flasch97/Mech-2220-Project-Gravity-Car/Gravity Car/FEA/PerformanceLog.txt

Number of Contacts: 0
Number of contact data: 0
