flasch97/Mech-2220-Project-Gravity-Car/Gravity Car/Drawing PDF files/Parts 1-50.pdf

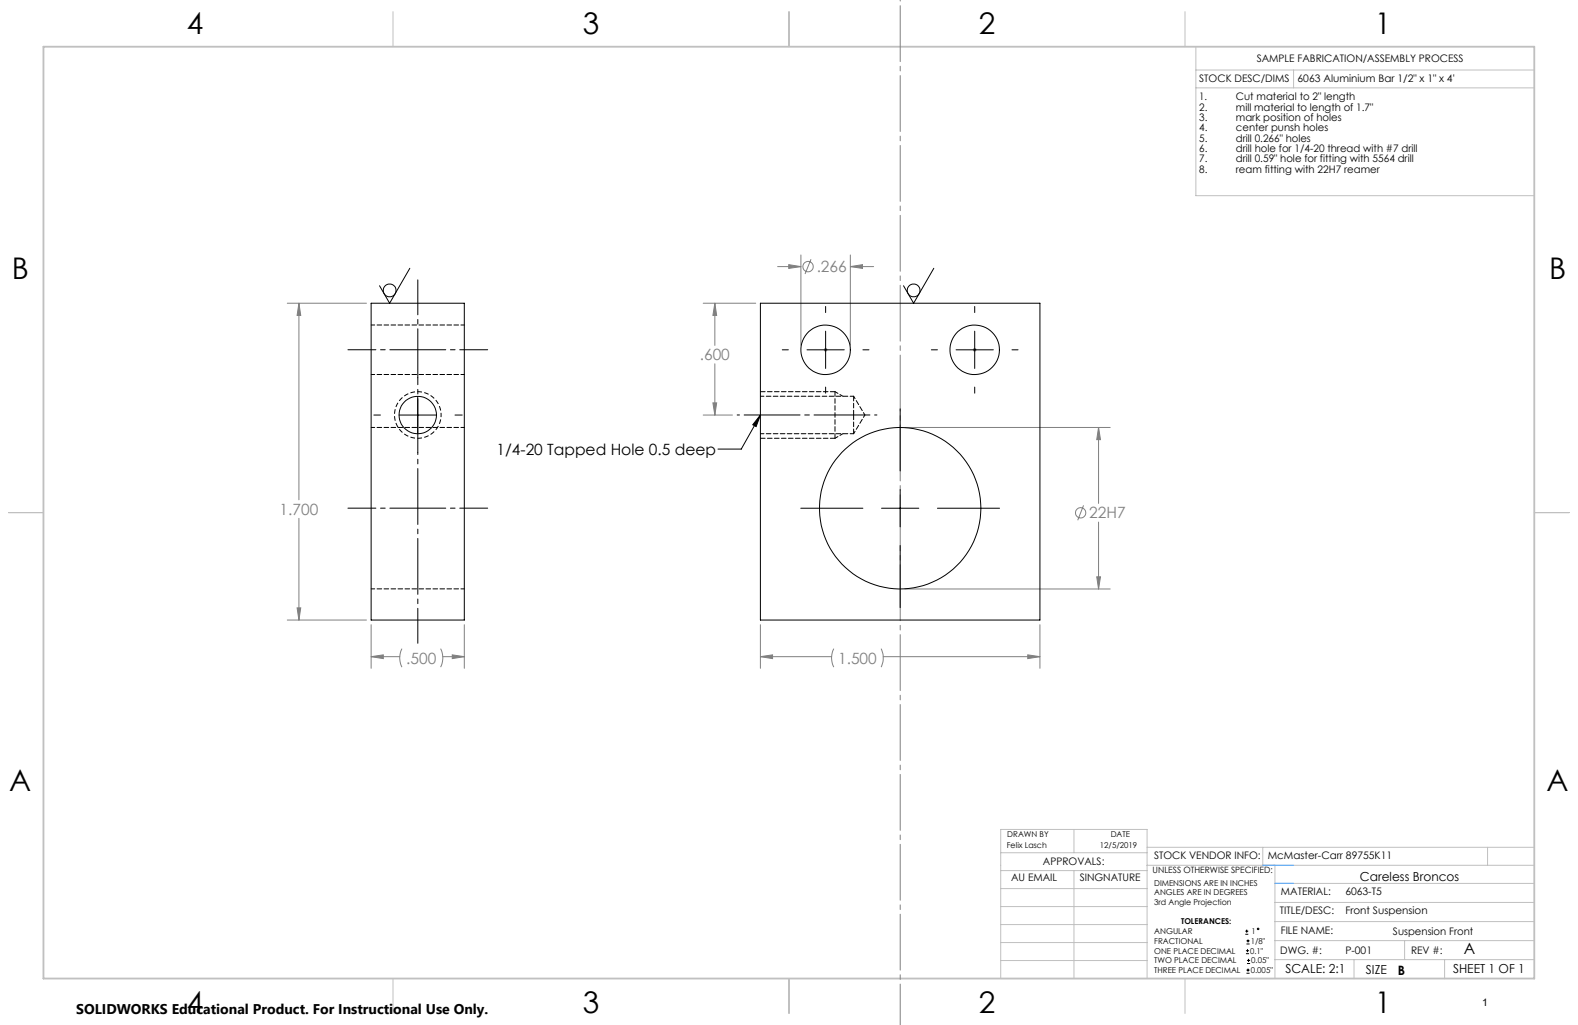
[picture p1: page 1]
Front Suspension; Felix Lasch; FILE NAME:; DRAWN BY; DATE; Suspension Front; AU EMAIL; SINGNATURE

SAMPLE FABRICATION/ASSEMBLY PROCESS

STOCK DESC/DIMS | 6063 Aluminium Bar 1/2" x 1" x 4'

1. Cut material to 2" length
2. mill material to length of 1.7"
3. mark position of holes
4. center punsh holes
5. drill 0.266" holes
6. drill hole for 1/4-20 thread with #7 drill
7. drill 0.59" hole for fitting with 5564 drill
8. ream fitting with 22H7 reamer

1/4-20 Tapped Hole 0.5 deep

STOCK VENDOR INFO: | McMaster-Carr 89755K11
UNLESS OTHERWISE SPECIFIED: ANGLES ARE IN DEGREES 3rd Angle Projection TOLERANCES: ANGULAR 1 FRACTIONAL 1/8" ONE PLACE DECIMAL 0.1" TWO PLACE DECIMAL 0.05" THREE PLACE DECIMAL 0.005" | | Careless Broncos

DIMENSIONS ARE IN INCHES

DWG. #: P-001 | REV #: A
SCALE: 2:1 | SIZE B | SHEET 1 OF 1

SOLIDWORKS Educational Product. For Instructional Use Only.

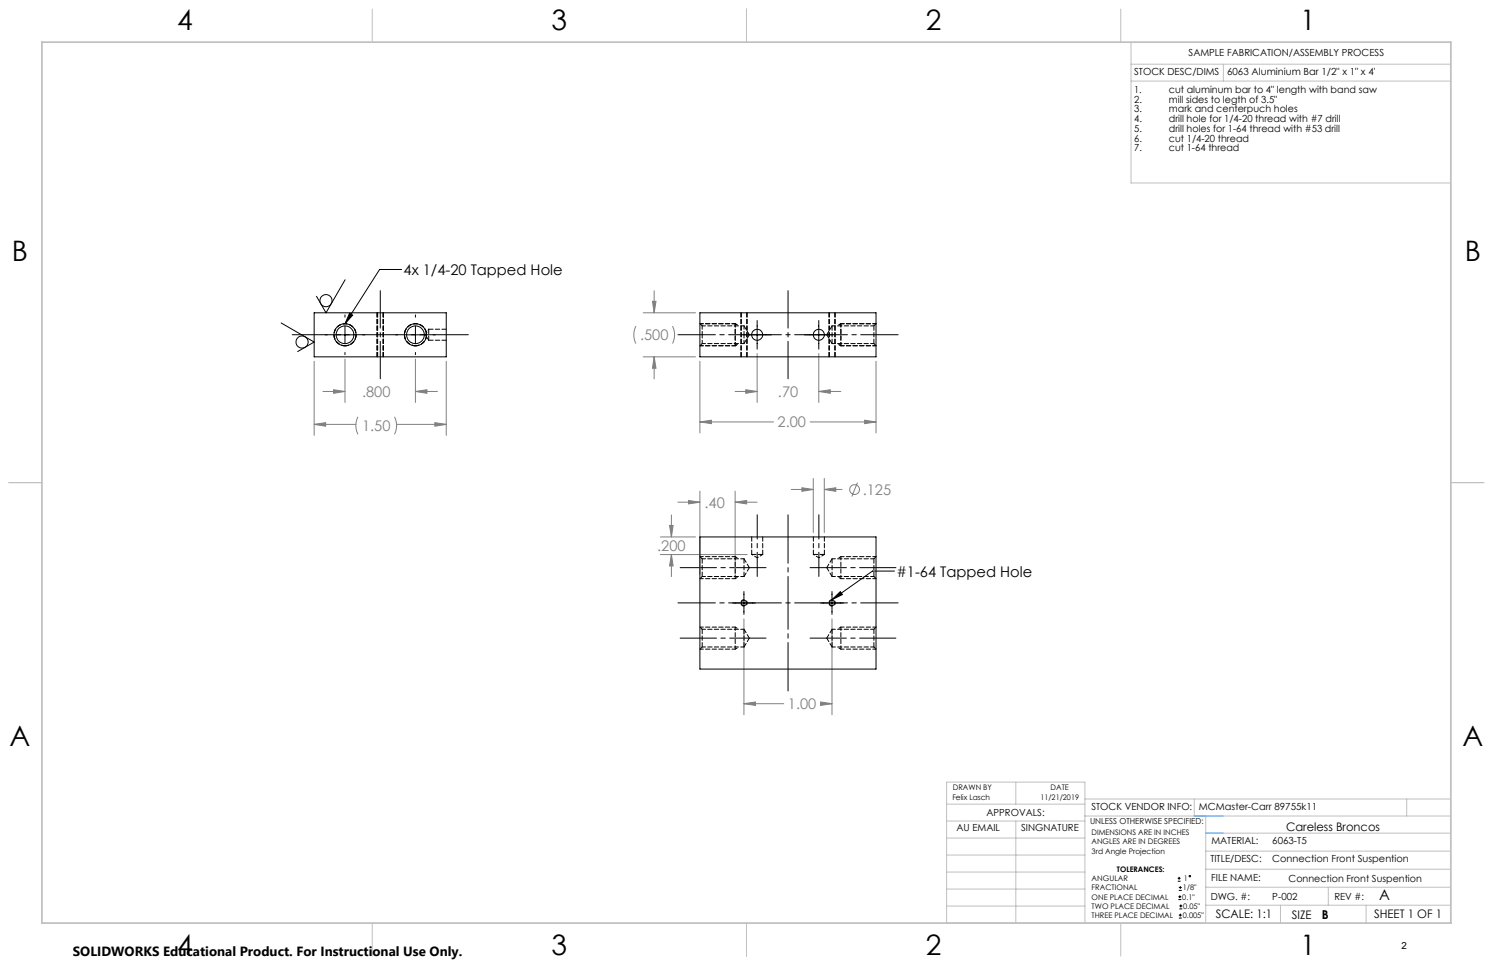
[picture p2: page 2]
4x 1/4-20 Tapped Hole; #1-64 Tapped Hole; 6063 Aluminium Bar 1/2" x 1" x 4'; Felix Lasch; FILE NAME:; DRAWN BY; DATE; AU EMAIL; SINGNATURE

1. cut aluminum bar to 4" length with band saw
2. mill sides to legth of 3.5"
3. mark and centerpuch holes
4. drill hole for 1/4-20 thread with #7 drill
5. drill holes for 1-64 thread with #53 drill
6. cut 1/4-20 thread
7. cut 1-64 thread

STOCK VENDOR INFO: | MCMaster-Carr 89755k11
UNLESS OTHERWISE SPECIFIED: ANGLES ARE IN DEGREES 3rd Angle Projection TOLERANCES: ANGULAR 1 | | Careless Broncos

DIMENSIONS ARE IN INCHES

Connection Front Suspention

REV #: A

SCALE: 1:1 | | SHEET 1 OF 1

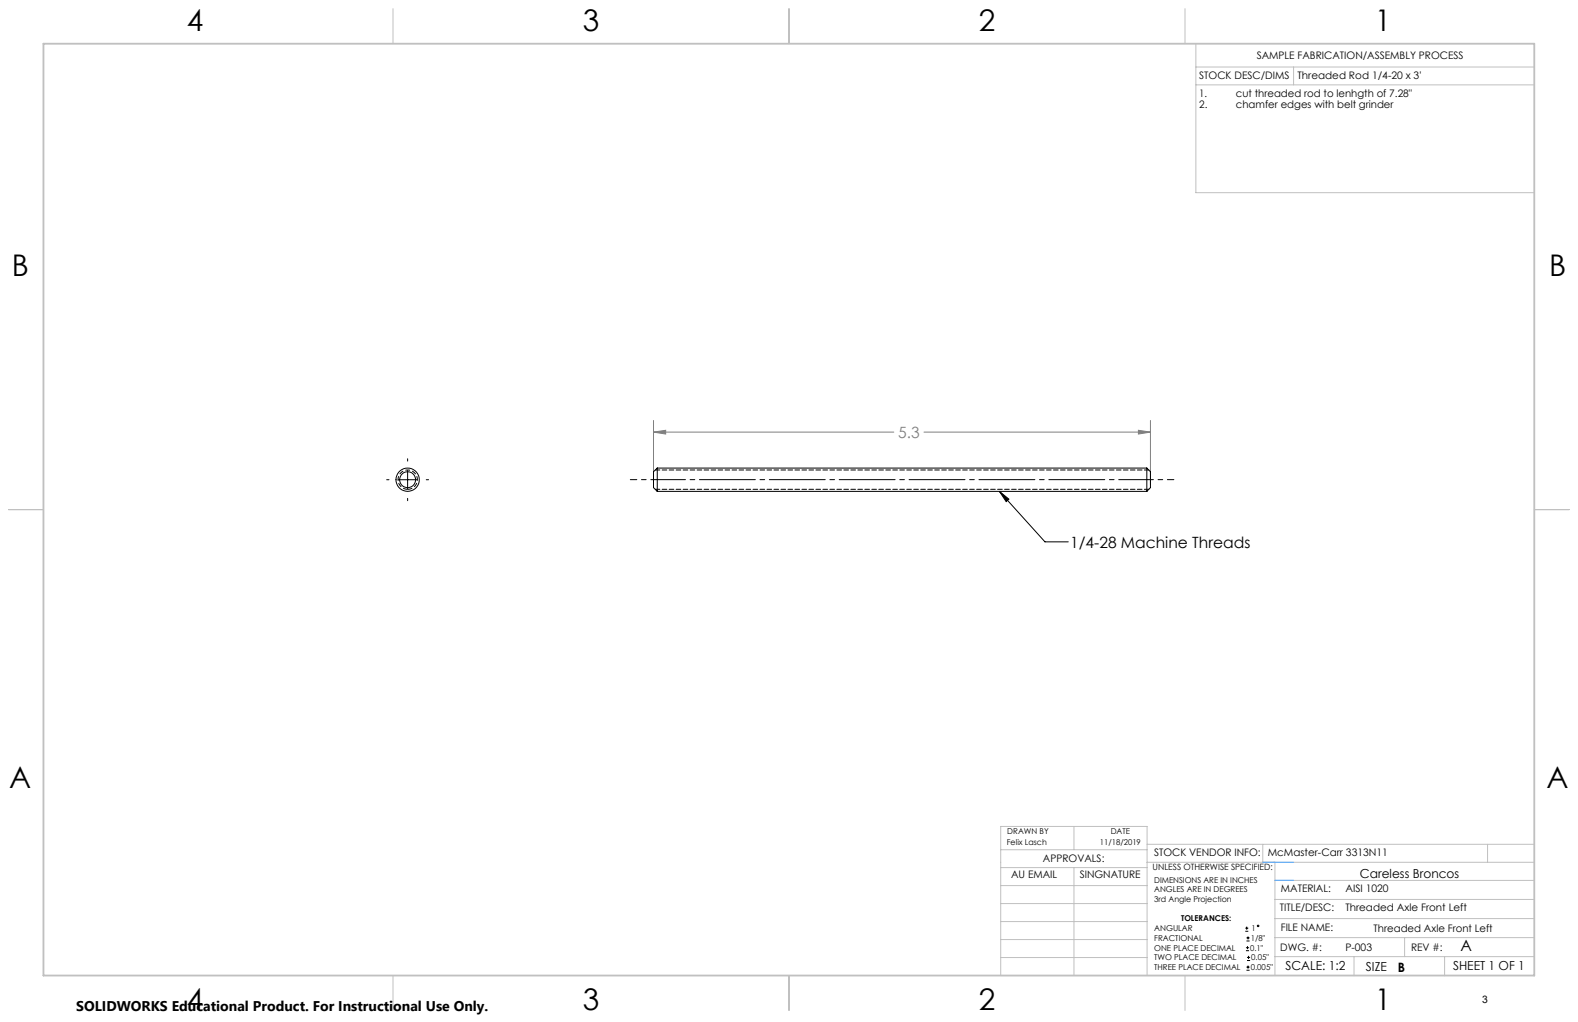
[picture p3: page 3]
1/4-28 Machine Threads; Threaded Rod 1/4-20 x 3'; Felix Lasch; FILE NAME:; DRAWN BY; DATE; AU EMAIL; SINGNATURE

1. cut threaded rod to lenhgth of 7.28"
2. chamfer edges with belt grinder

STOCK VENDOR INFO: | McMaster-Carr 3313N11
UNLESS OTHERWISE SPECIFIED: ANGLES ARE IN DEGREES 3rd Angle Projection TOLERANCES: ANGULAR 1 | | Careless Broncos

DIMENSIONS ARE IN INCHES

AISI 1020
Threaded Axle Front Left

REV #: A

SCALE: 1:2 | | SHEET 1 OF 1

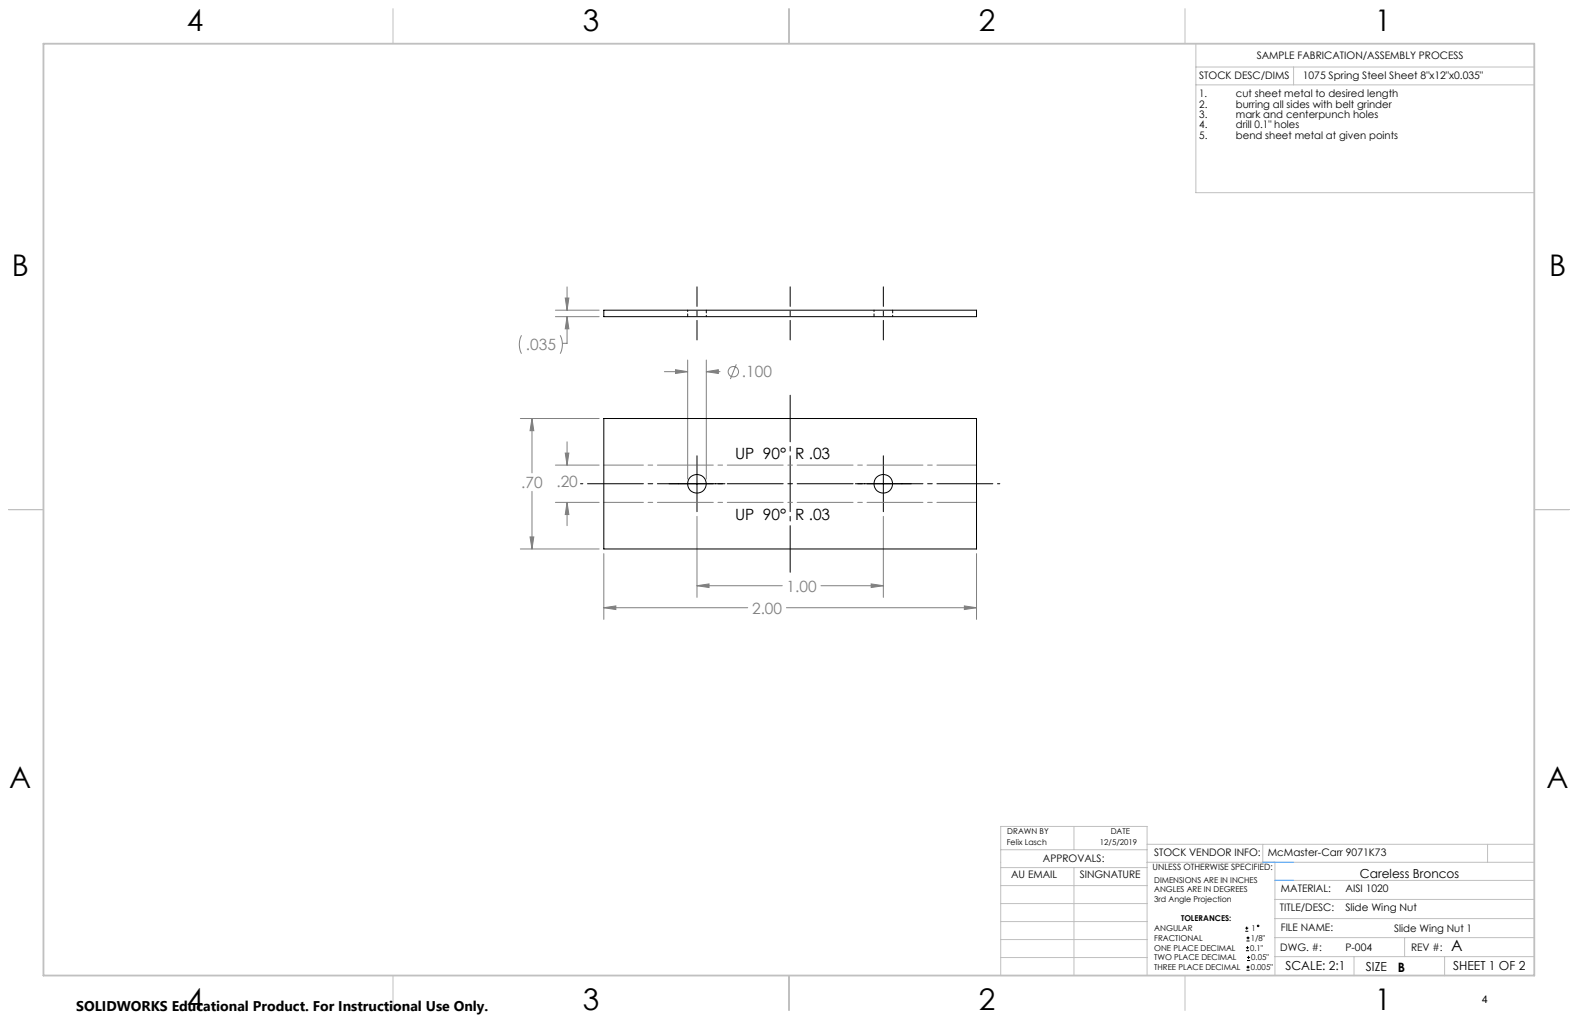
[picture p4: page 4]
Felix Lasch; FILE NAME:; DRAWN BY; DATE; AU EMAIL; SINGNATURE

1075 Spring Steel Sheet 8"x12"x0.035"

1. cut sheet metal to desired length
2. burring all sides with belt grinder
3. mark and centerpunch holes
4. drill 0.1" holes
5. bend sheet metal at given points

STOCK VENDOR INFO: | McMaster-Carr 9071K73
UNLESS OTHERWISE SPECIFIED: ANGLES ARE IN DEGREES 3rd Angle Projection TOLERANCES: ANGULAR 1 | | Careless Broncos

DIMENSIONS ARE IN INCHES

AISI 1020
Slide Wing Nut

Slide Wing Nut 1

REV #: A

SCALE: 2:1 | | SHEET 1 OF 2

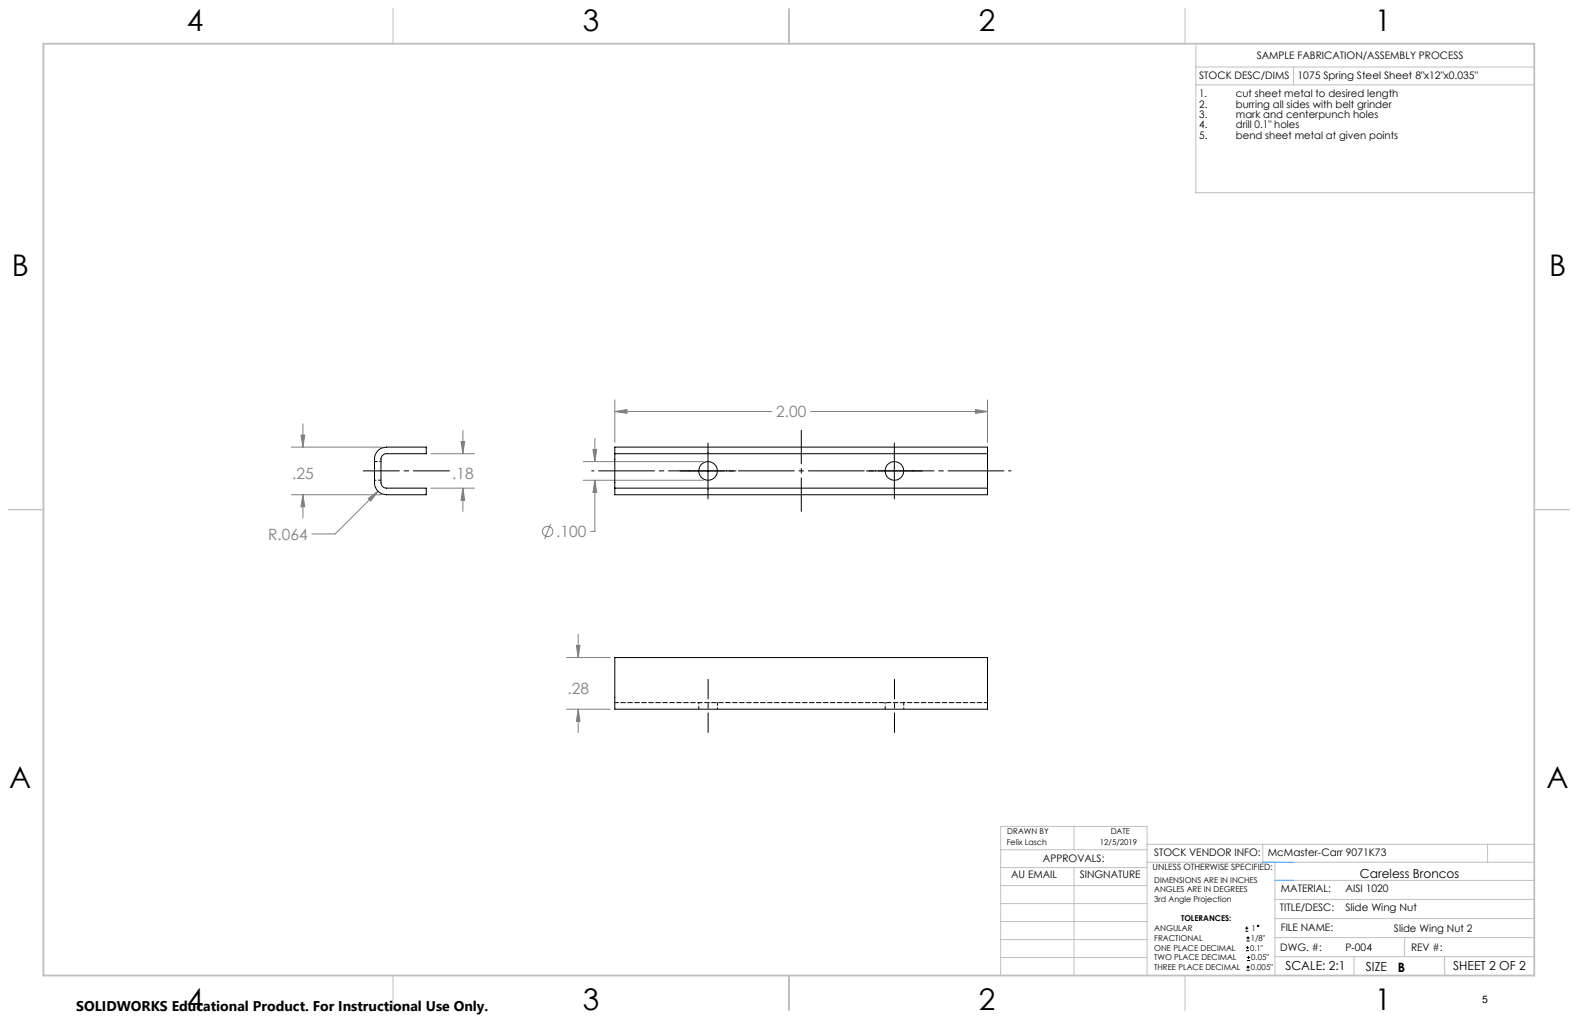
[picture p5: page 5]
Felix Lasch; FILE NAME:; DRAWN BY; DATE; AU EMAIL; SINGNATURE

1075 Spring Steel Sheet 8"x12"x0.035"

1. cut sheet metal to desired length
2. burring all sides with belt grinder
3. mark and centerpunch holes
4. drill 0.1" holes
5. bend sheet metal at given points

STOCK VENDOR INFO: | McMaster-Carr 9071K73
UNLESS OTHERWISE SPECIFIED: ANGLES ARE IN DEGREES 3rd Angle Projection TOLERANCES: ANGULAR 1 | | Careless Broncos

DIMENSIONS ARE IN INCHES

AISI 1020
Slide Wing Nut

Slide Wing Nut 2

REV #:

SCALE: 2:1 | | SHEET 2 OF 2

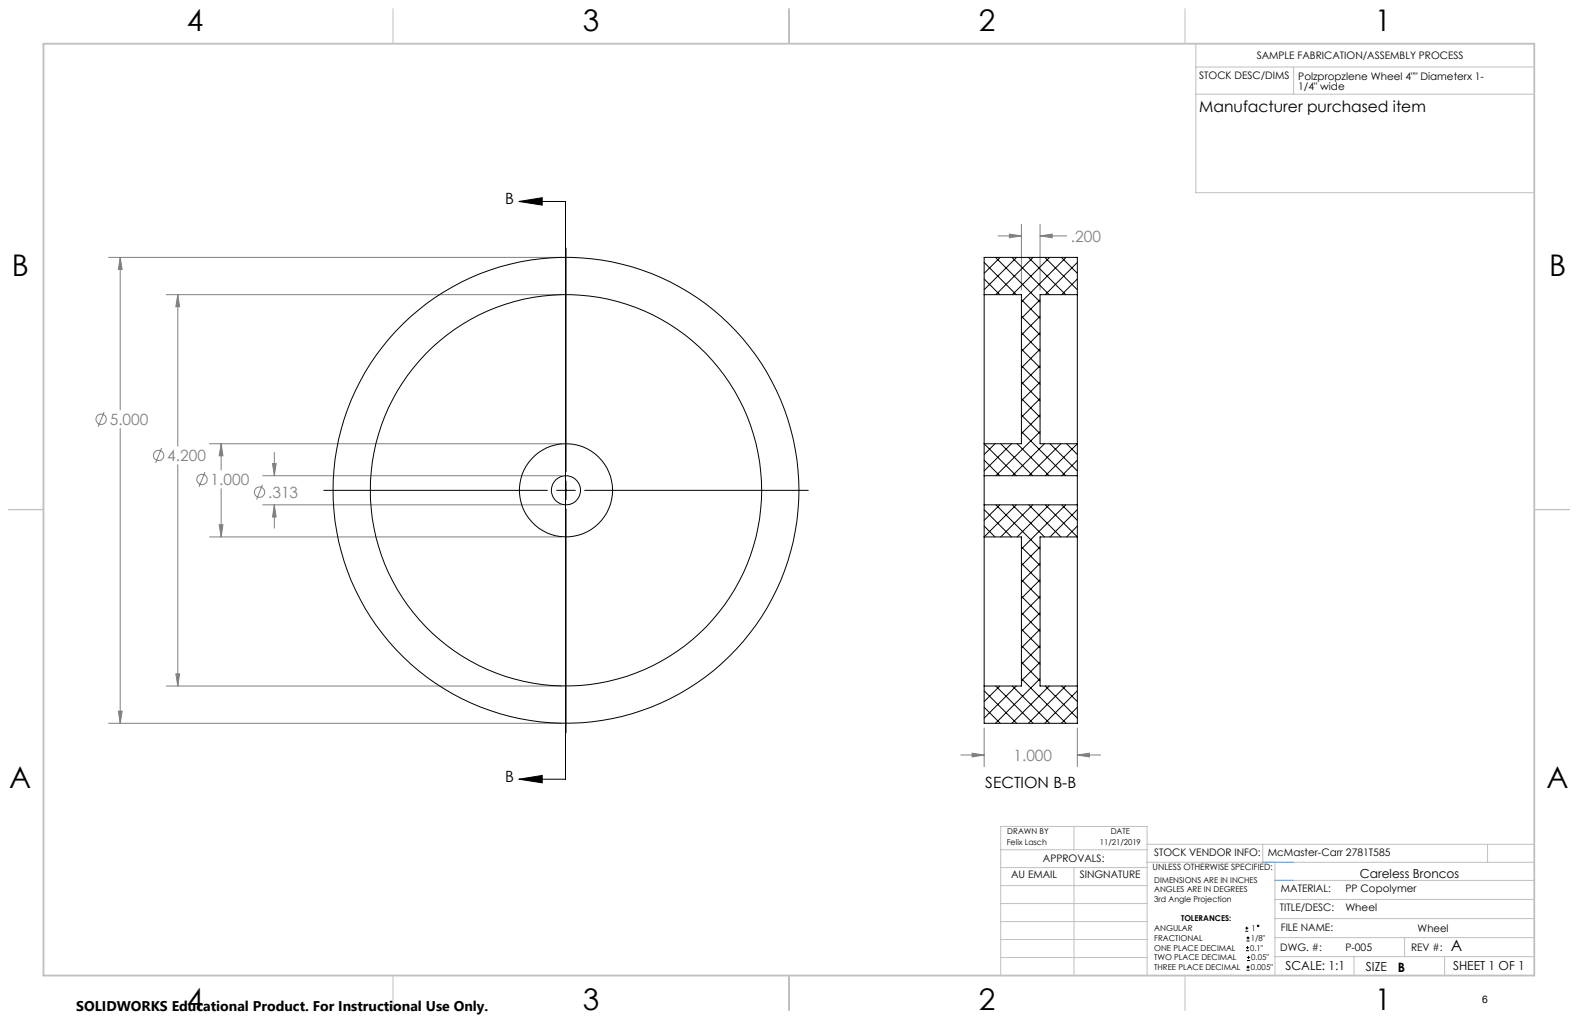
[picture p6: page 6]
SECTION B-B; PP Copolymer; Felix Lasch; FILE NAME:; DRAWN BY; DATE; AU EMAIL; SINGNATURE

Polzpropzlene Wheel 4"" Diameterx 1-
1/4" wide

Manufacturer purchased item

STOCK VENDOR INFO: | McMaster-Carr 2781T585
UNLESS OTHERWISE SPECIFIED: ANGLES ARE IN DEGREES 3rd Angle Projection TOLERANCES: ANGULAR 1 | | Careless Broncos

DIMENSIONS ARE IN INCHES

REV #: A

SCALE: 1:1 | | SHEET 1 OF 1

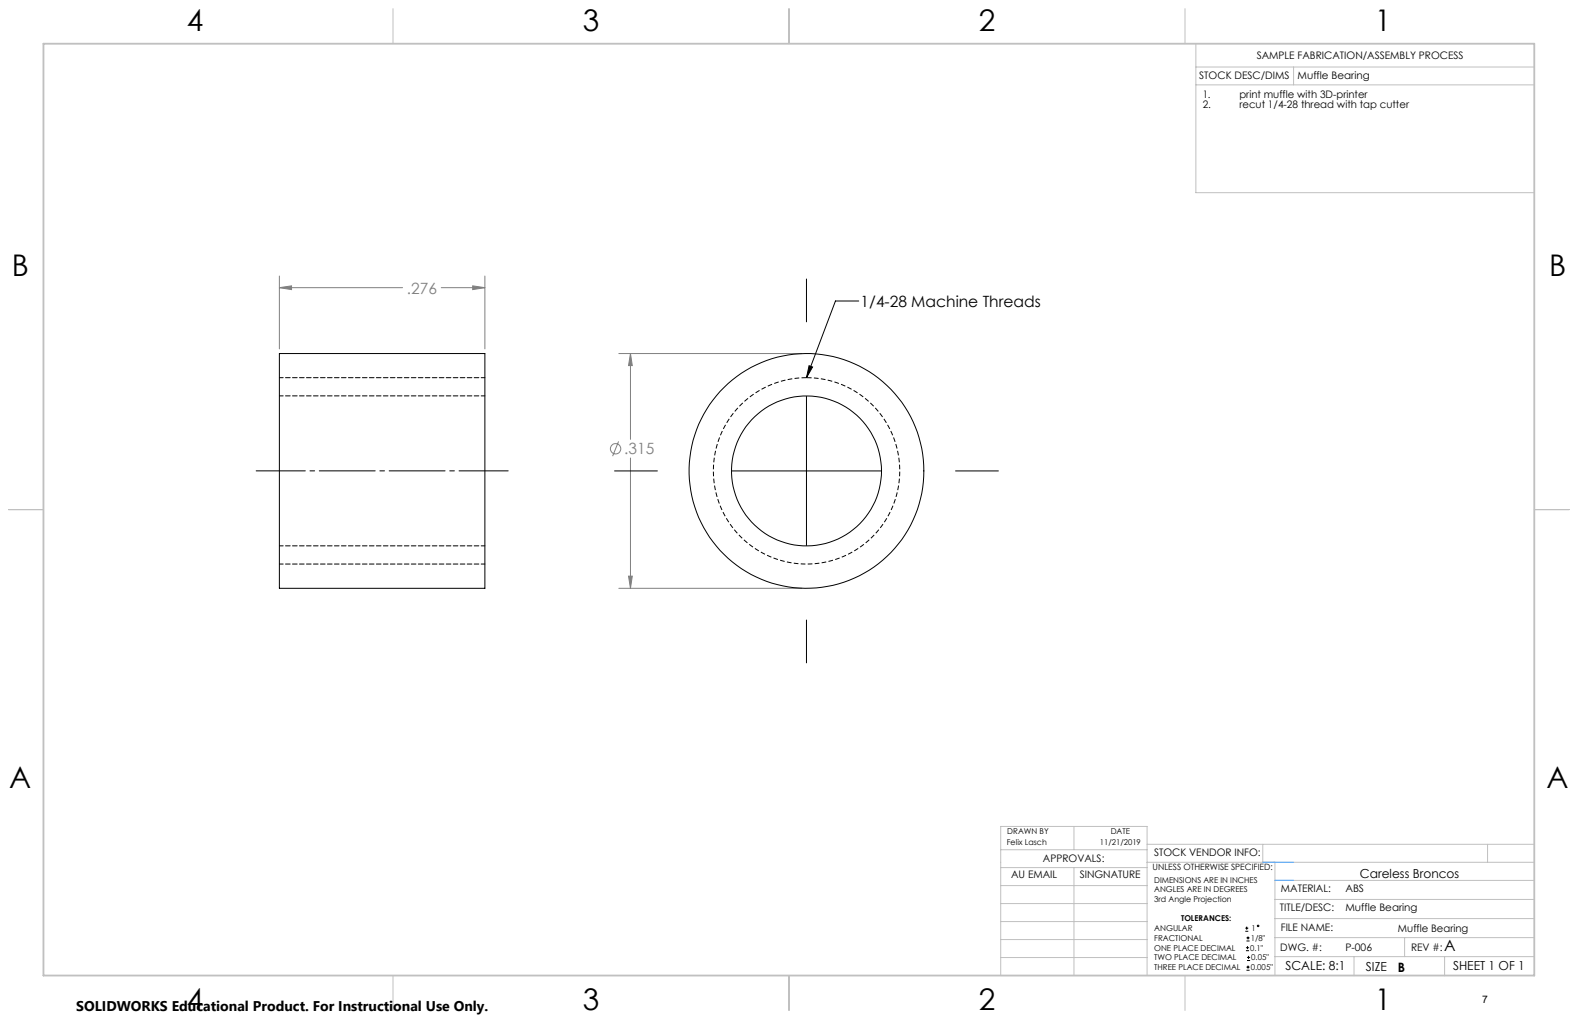
[picture p7: page 7]
1/4-28 Machine Threads; Muffle Bearing; Felix Lasch; FILE NAME:; DRAWN BY; DATE; AU EMAIL; SINGNATURE

1. print muffle with 3D-printer
2. recut 1/4-28 thread with tap cutter

STOCK VENDOR INFO:
UNLESS OTHERWISE SPECIFIED: ANGLES ARE IN DEGREES 3rd Angle Projection TOLERANCES: ANGULAR 1 | Careless Broncos

DIMENSIONS ARE IN INCHES

REV #:A

SCALE: 8:1 | | SHEET 1 OF 1

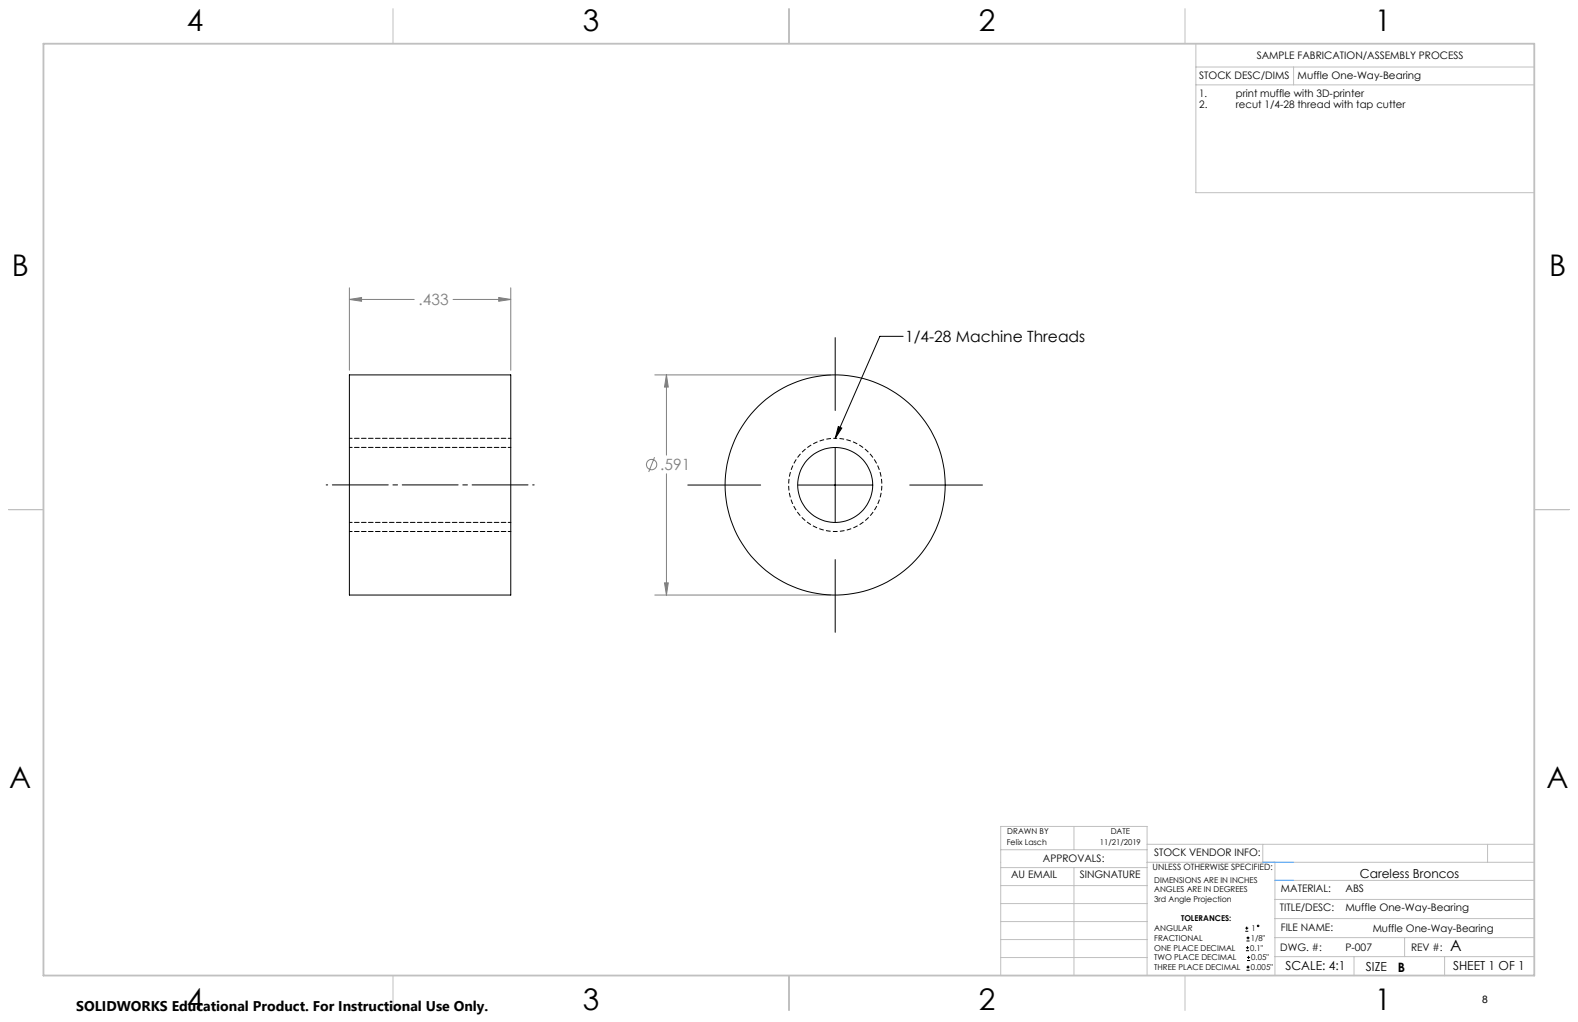
[picture p8: page 8]
1/4-28 Machine Threads; Felix Lasch; FILE NAME:; DRAWN BY; DATE; AU EMAIL; SINGNATURE

Muffle One-Way-Bearing

1. print muffle with 3D-printer
2. recut 1/4-28 thread with tap cutter

STOCK VENDOR INFO:
UNLESS OTHERWISE SPECIFIED: ANGLES ARE IN DEGREES 3rd Angle Projection TOLERANCES: ANGULAR 1 | Careless Broncos

DIMENSIONS ARE IN INCHES

ABS

REV #: A

SCALE: 4:1 | | SHEET 1 OF 1

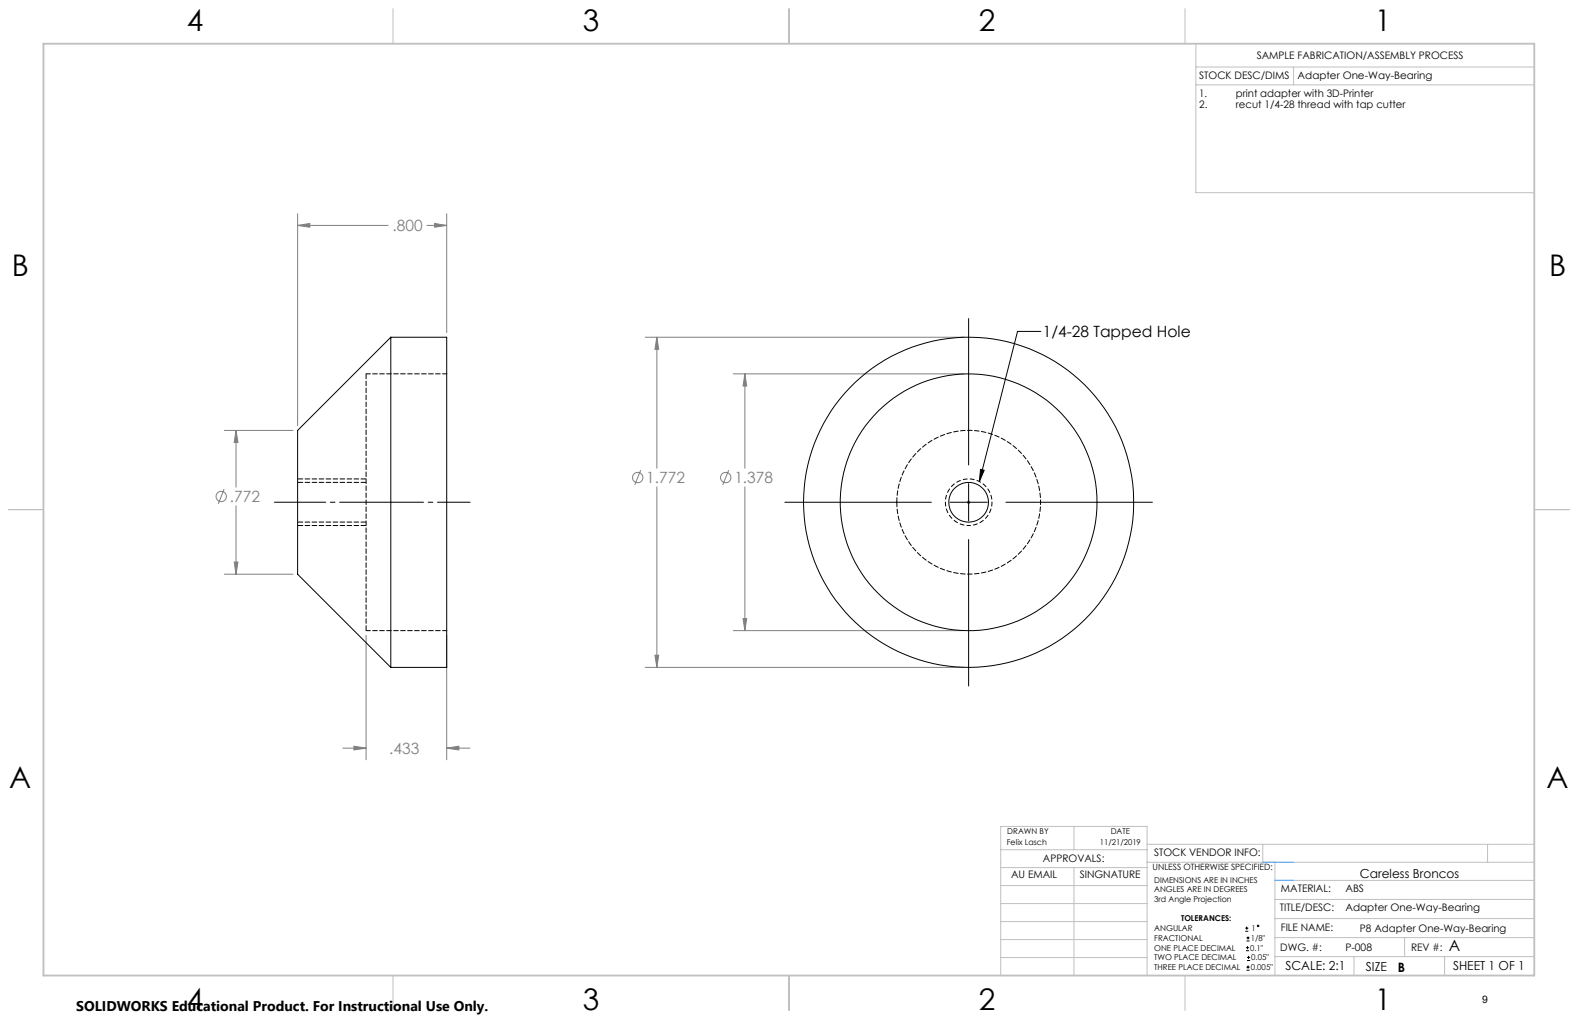
[picture p9: page 9]
1/4-28 Tapped Hole; Felix Lasch; FILE NAME:; DRAWN BY; DATE; AU EMAIL; SINGNATURE

Adapter One-Way-Bearing

1. print adapter with 3D-Printer
2. recut 1/4-28 thread with tap cutter

STOCK VENDOR INFO:
UNLESS OTHERWISE SPECIFIED: ANGLES ARE IN DEGREES 3rd Angle Projection TOLERANCES: ANGULAR 1 | Careless Broncos

DIMENSIONS ARE IN INCHES

ABS
P8 Adapter One-Way-Bearing

REV #: A

SCALE: 2:1 | | SHEET 1 OF 1

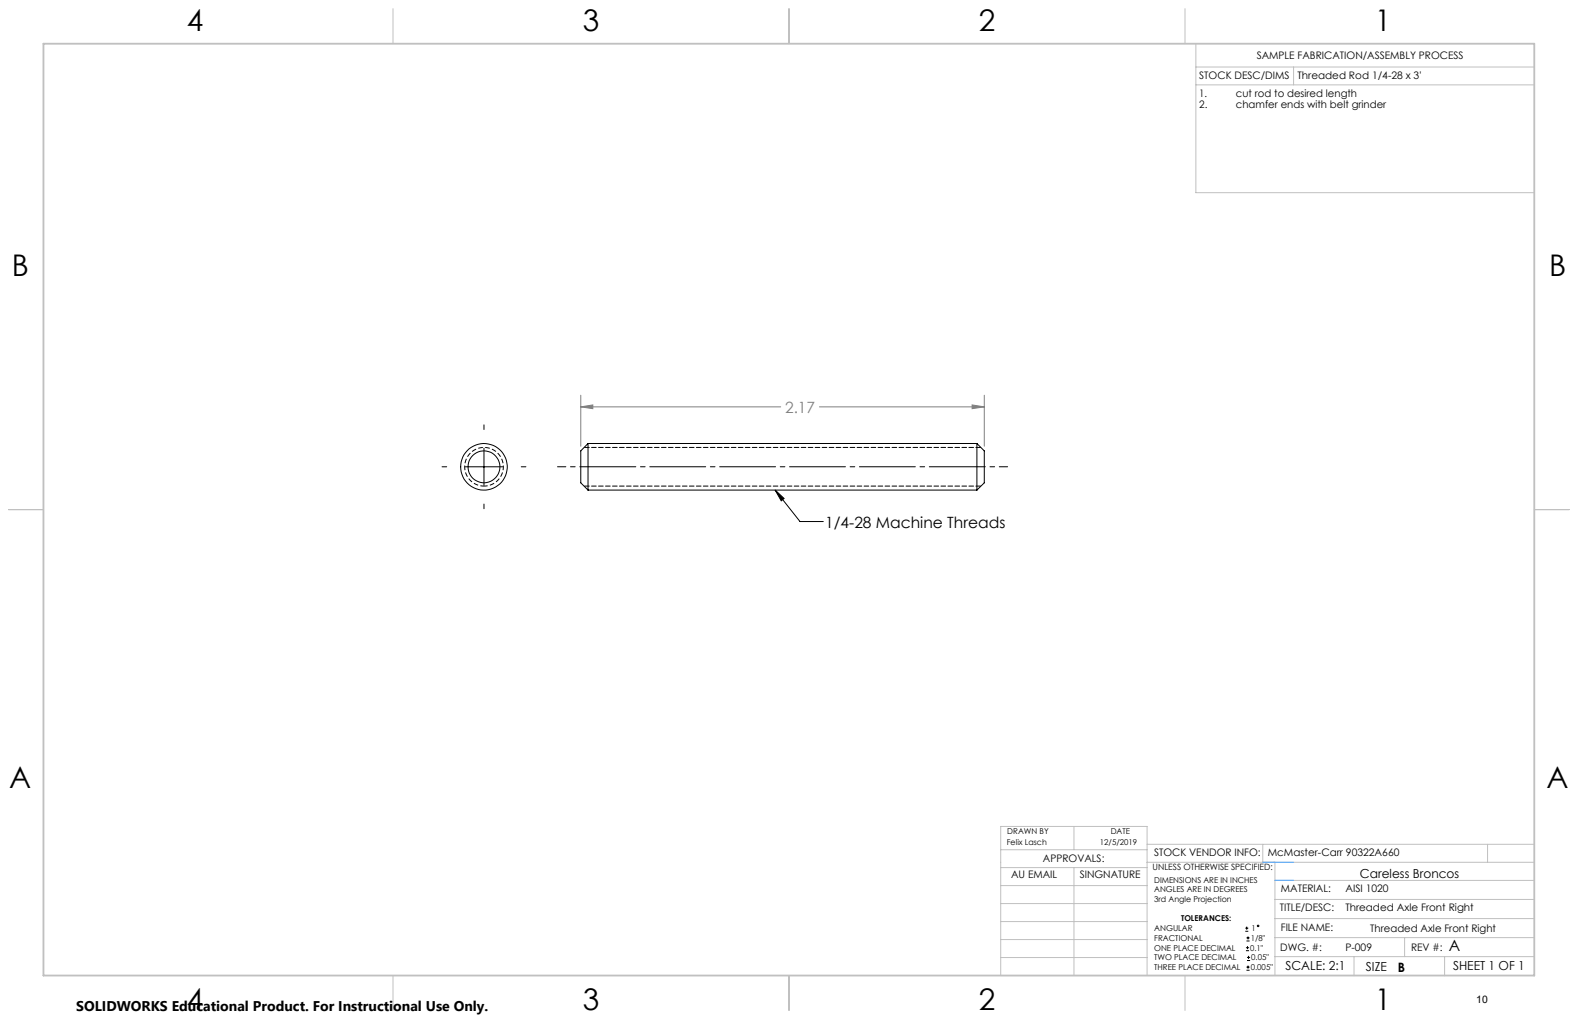
[picture p10: page 10]
1/4-28 Machine Threads; Threaded Rod 1/4-28 x 3'; Felix Lasch; FILE NAME:; DRAWN BY; DATE; AU EMAIL; SINGNATURE

1. cut rod to desired length
2. chamfer ends with belt grinder

STOCK VENDOR INFO: | McMaster-Carr 90322A660
UNLESS OTHERWISE SPECIFIED: ANGLES ARE IN DEGREES 3rd Angle Projection TOLERANCES: ANGULAR 1 | | Careless Broncos

DIMENSIONS ARE IN INCHES

AISI 1020
Threaded Axle Front Right

REV #: A

SCALE: 2:1 | | SHEET 1 OF 1

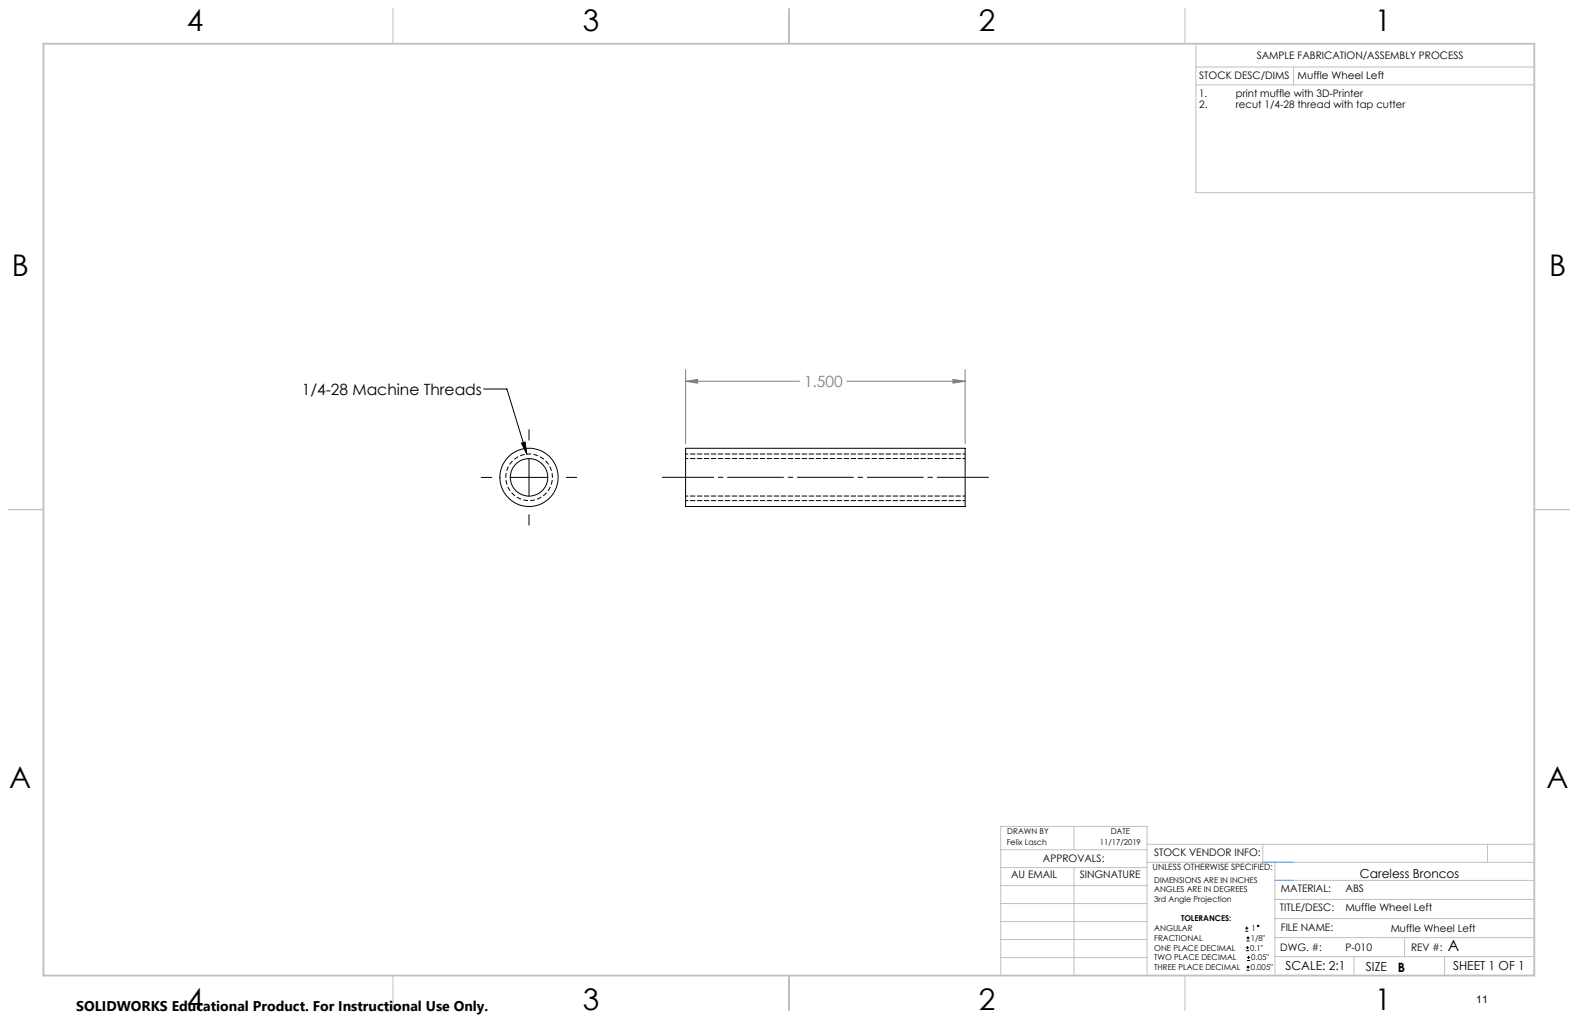
[picture p11: page 11]
1.500 1/4-28 Machine Threads; Felix Lasch; FILE NAME:; DRAWN BY; DATE; AU EMAIL; SINGNATURE

Muffle Wheel Left

1. print muffle with 3D-Printer
2. recut 1/4-28 thread with tap cutter

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

DIMENSIONS ARE IN INCHES

ABS

REV #: A

SCALE: 2:1 | | SHEET 1 OF 1

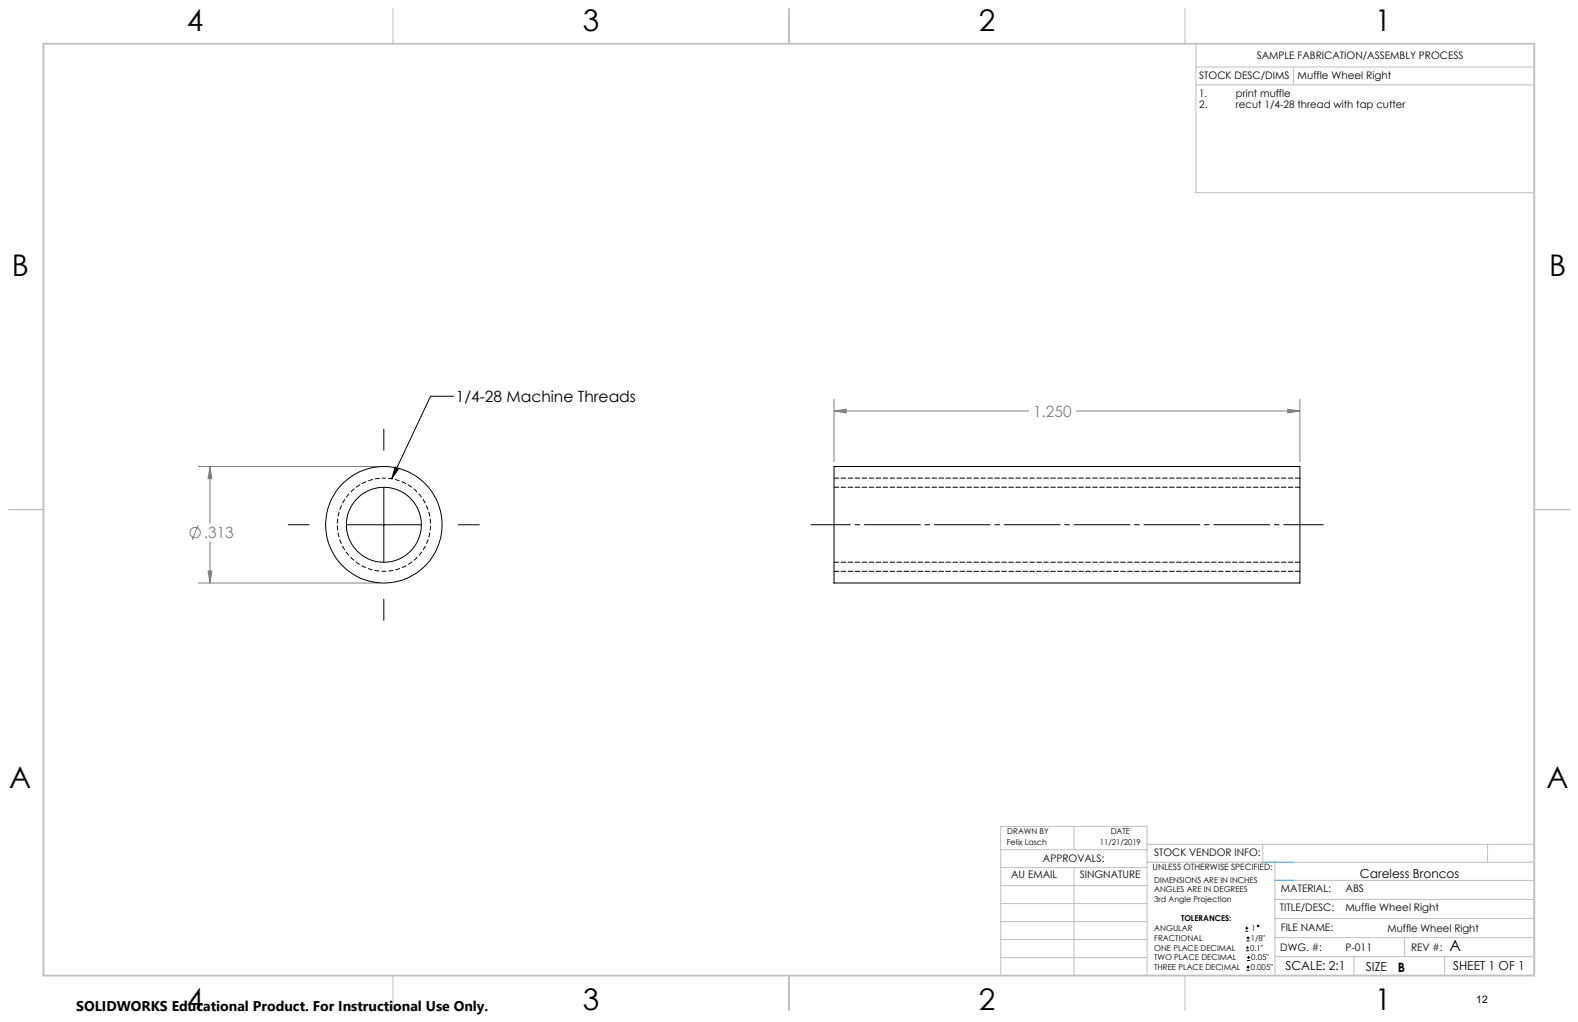
[picture p12: page 12]
1/4-28 Machine Threads; Felix Lasch; FILE NAME:; DRAWN BY; DATE; AU EMAIL; SINGNATURE

Muffle Wheel Right

1. print muffle
2. recut 1/4-28 thread with tap cutter

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

DIMENSIONS ARE IN INCHES

ABS

REV #: A

SCALE: 2:1 | | SHEET 1 OF 1

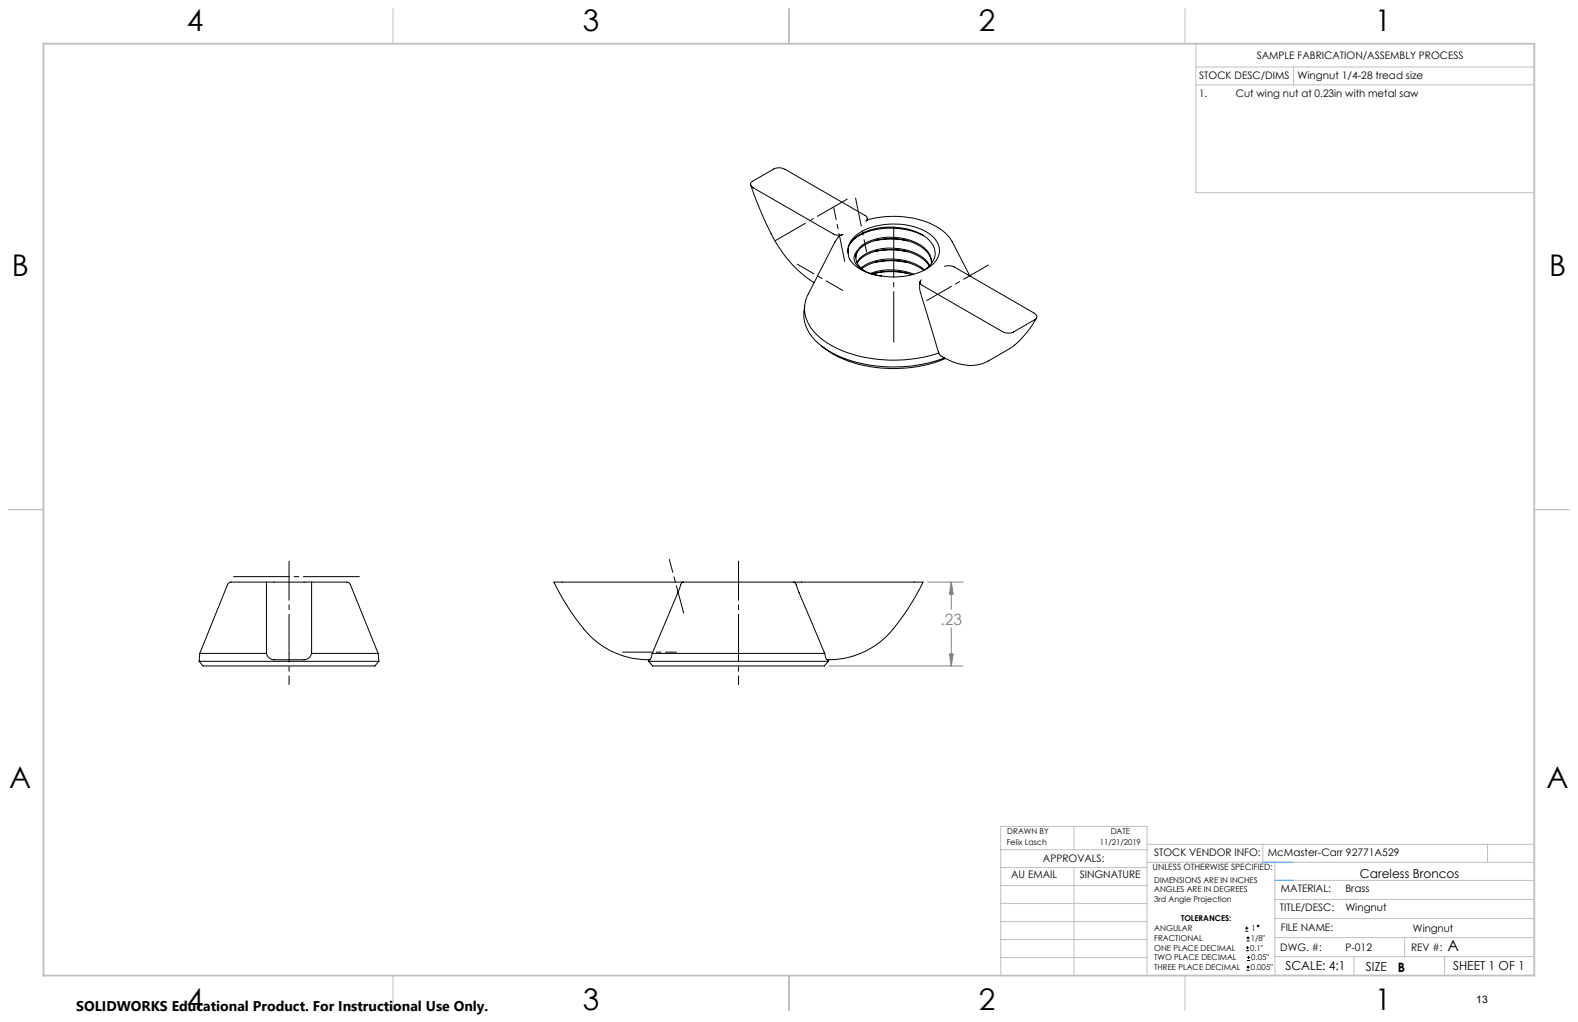
[picture p13: page 13]
Felix Lasch; FILE NAME:; DRAWN BY; DATE; AU EMAIL; SINGNATURE

Wingnut 1/4-28 tread size

1. Cut wing nut at 0.23in with metal saw

STOCK VENDOR INFO: | McMaster-Carr 92771A529
UNLESS OTHERWISE SPECIFIED: ANGLES ARE IN DEGREES 3rd Angle Projection TOLERANCES: ANGULAR 1 | | Careless Broncos

DIMENSIONS ARE IN INCHES

REV #: A

SCALE: 4:1 | | SHEET 1 OF 1

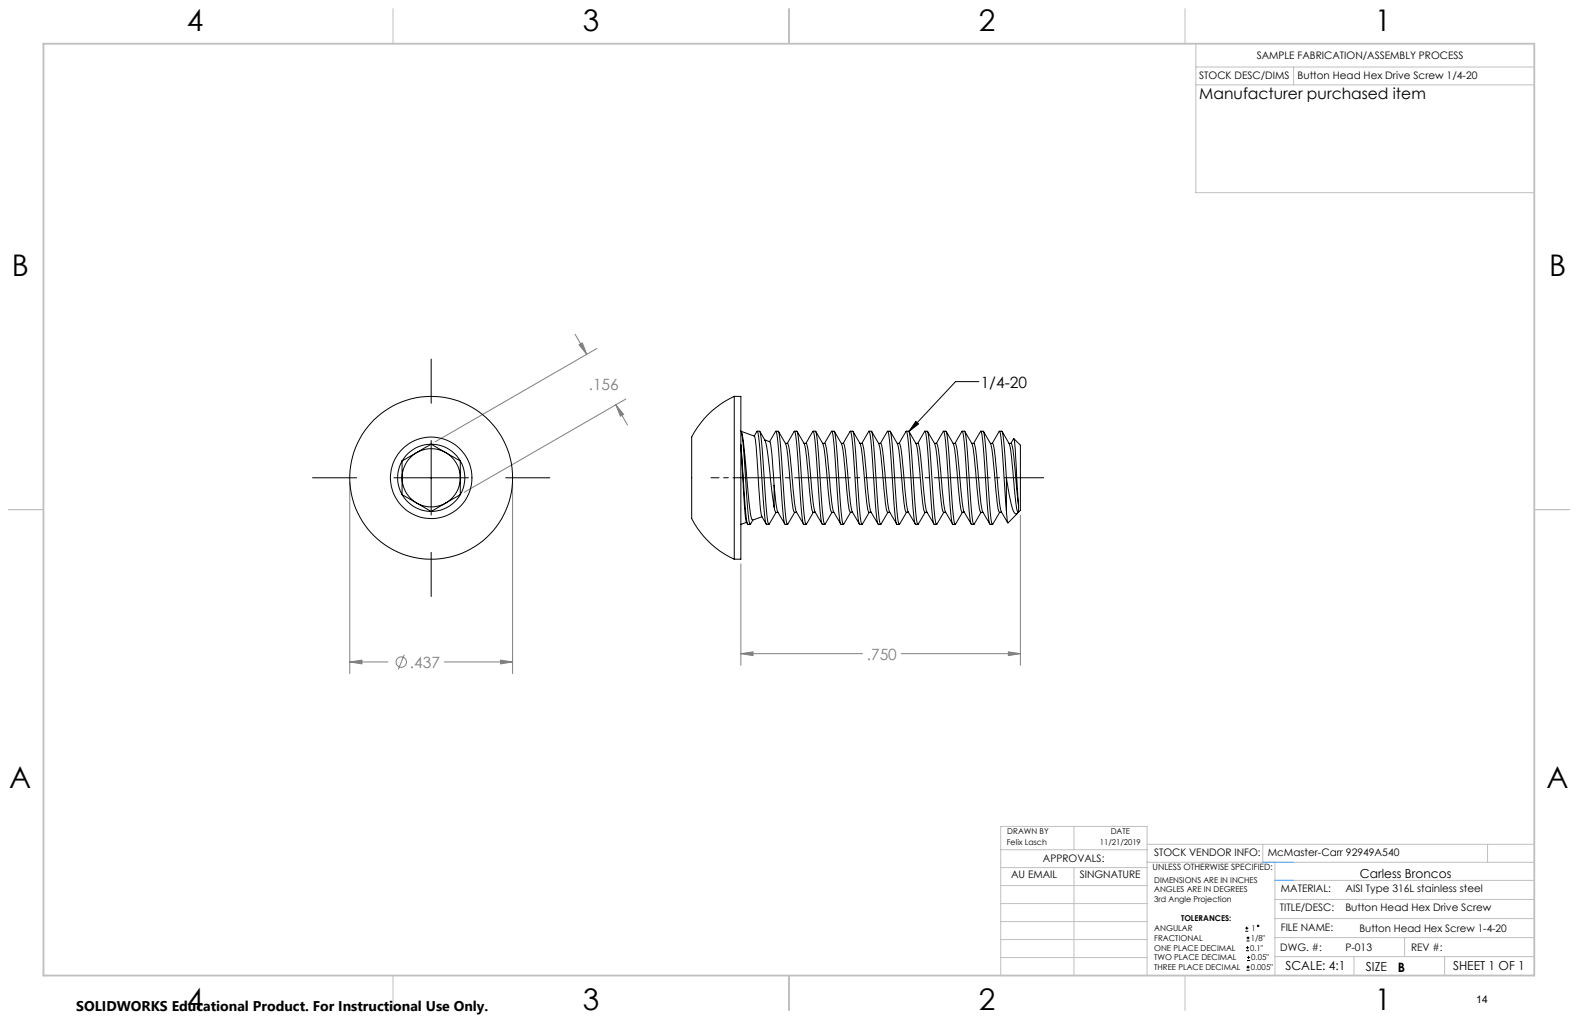
[picture p14: page 14]
Felix Lasch; FILE NAME:; DRAWN BY; DATE; SCALE: 4:1; SHEET 1 OF 1; AU EMAIL; SINGNATURE

Button Head Hex Drive Screw 1/4-20

Manufacturer purchased item

STOCK VENDOR INFO: | McMaster-Carr 92949A540
UNLESS OTHERWISE SPECIFIED: ANGLES ARE IN DEGREES 3rd Angle Projection TOLERANCES: ANGULAR 1 | | Carless Broncos

DIMENSIONS ARE IN INCHES

AISI Type 316L stainless steel
Button Head Hex Drive Screw
Button Head Hex Screw 1-4-20

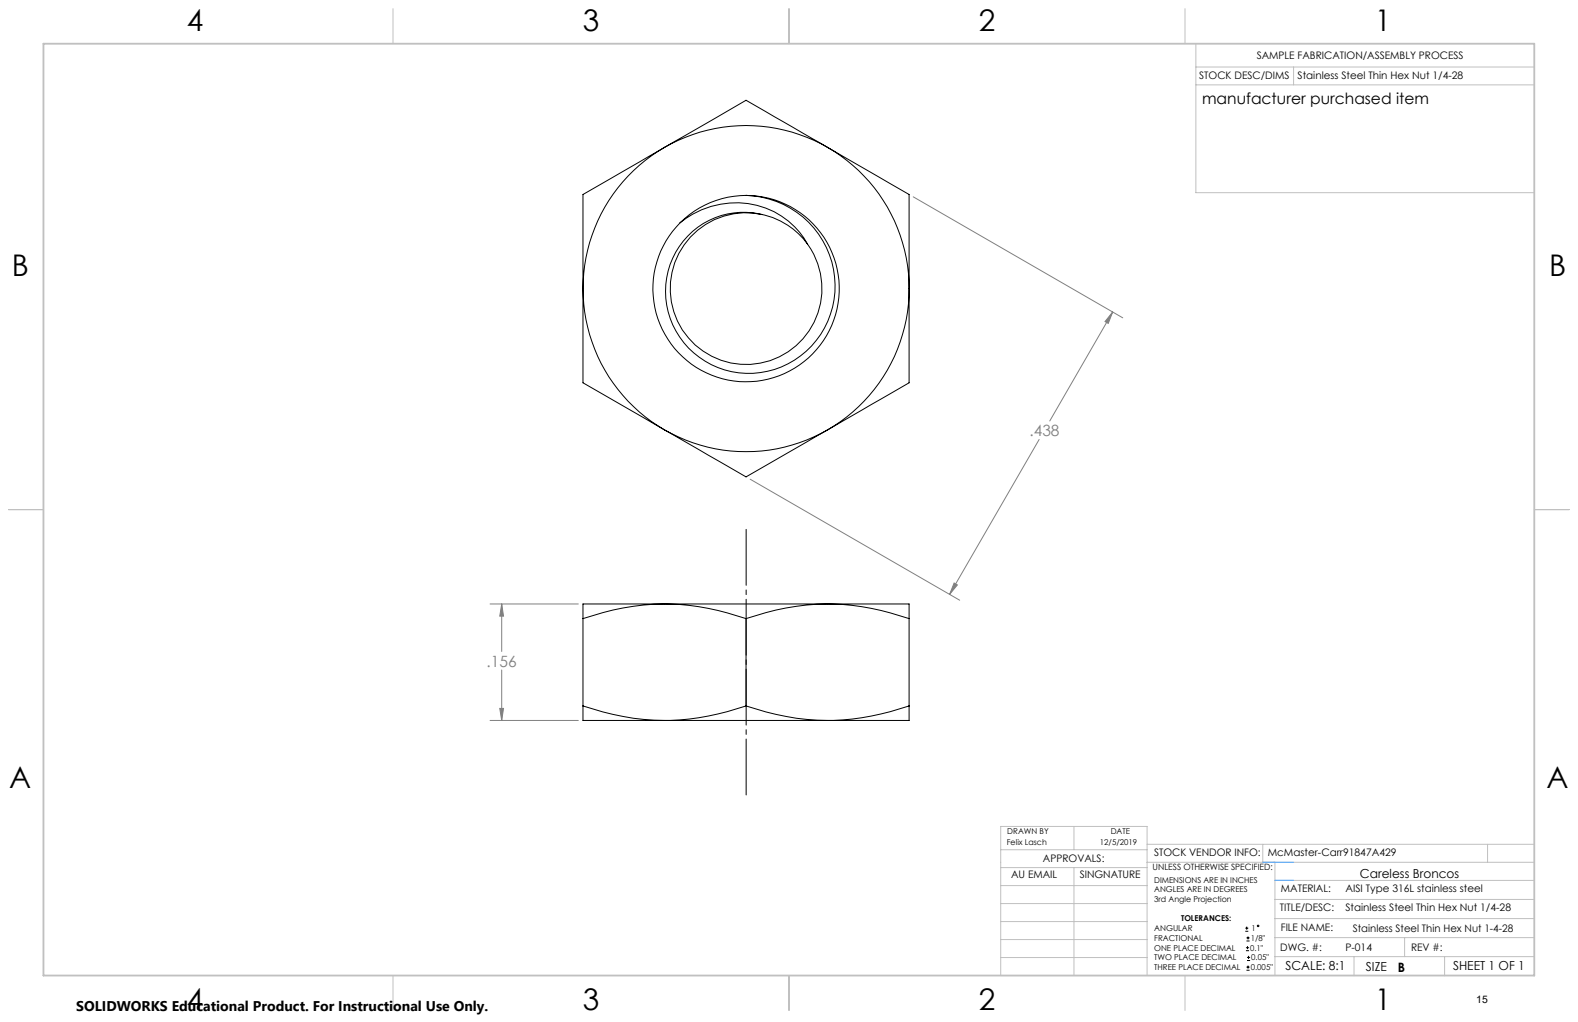
[picture p15: page 15]
Felix Lasch; FILE NAME:; DRAWN BY; DATE; SCALE: 8:1; SHEET 1 OF 1; AU EMAIL; SINGNATURE

Stainless Steel Thin Hex Nut 1/4-28

manufacturer purchased item

STOCK VENDOR INFO: | McMaster-Carr91847A429
UNLESS OTHERWISE SPECIFIED: ANGLES ARE IN DEGREES 3rd Angle Projection TOLERANCES: ANGULAR 1 | | Careless Broncos

DIMENSIONS ARE IN INCHES

AISI Type 316L stainless steel
Stainless Steel Thin Hex Nut 1-4-28

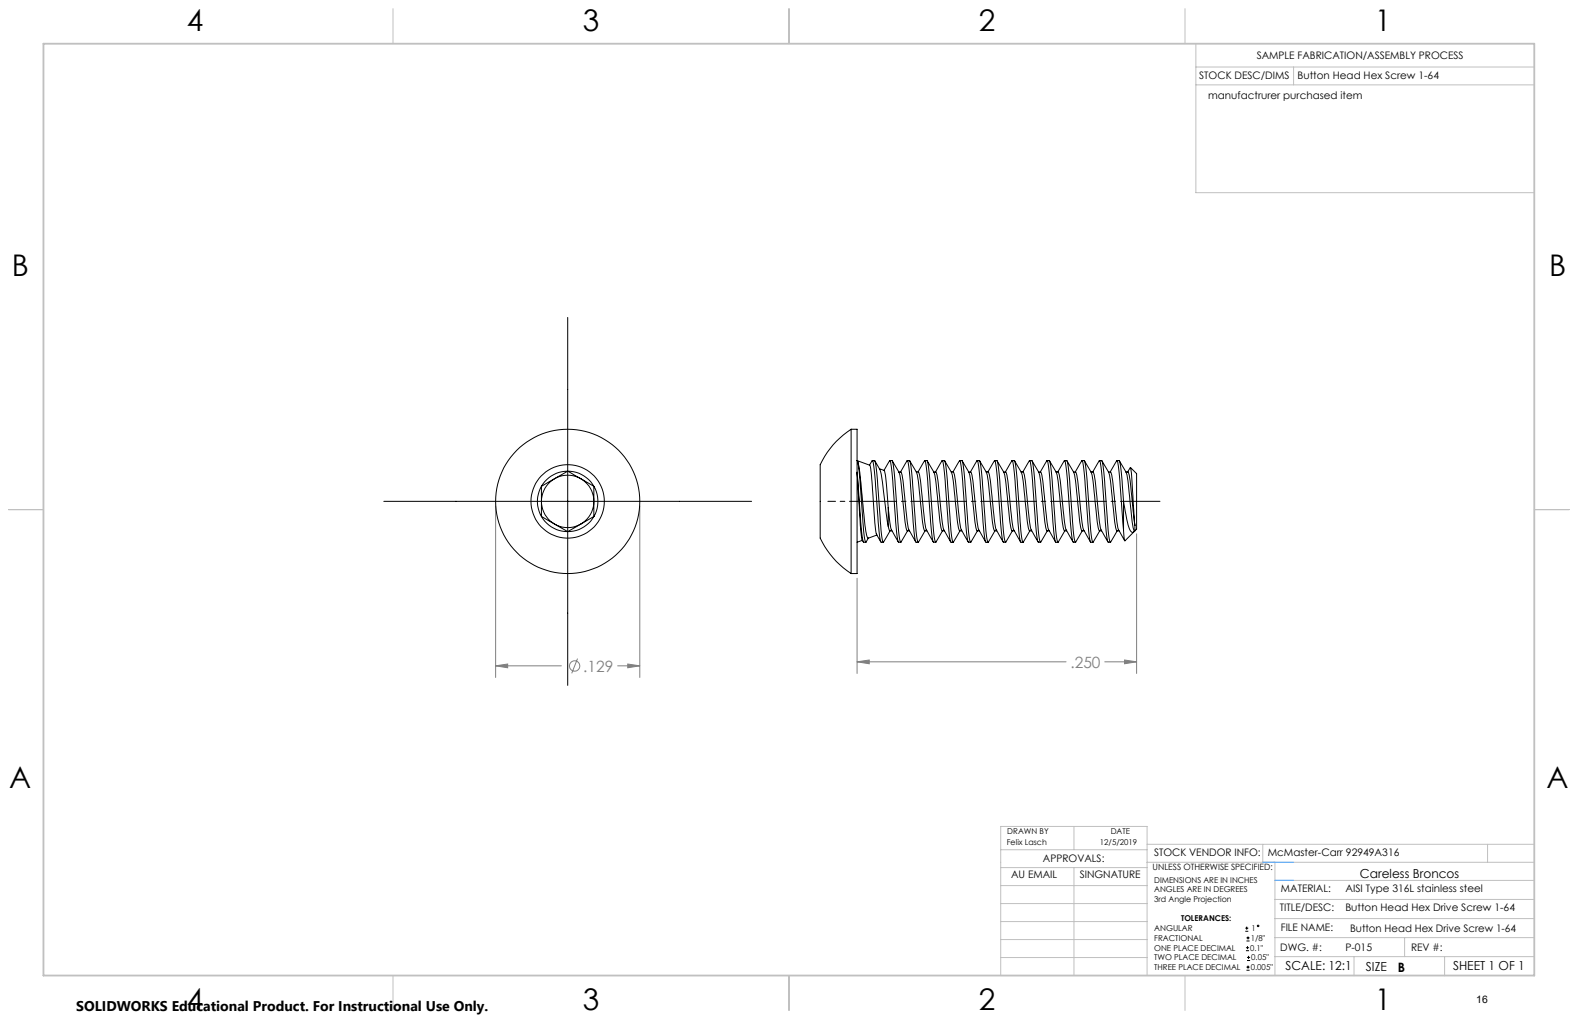
[picture p16: page 16]
Felix Lasch; FILE NAME:; DRAWN BY; DATE; SCALE: 12:1; SHEET 1 OF 1; AU EMAIL; SINGNATURE

Button Head Hex Screw 1-64

manufactrurer purchased item

STOCK VENDOR INFO: | McMaster-Carr 92949A316
UNLESS OTHERWISE SPECIFIED: ANGLES ARE IN DEGREES 3rd Angle Projection TOLERANCES: ANGULAR 1 | | Careless Broncos

DIMENSIONS ARE IN INCHES

AISI Type 316L stainless steel
Button Head Hex Drive Screw 1-64

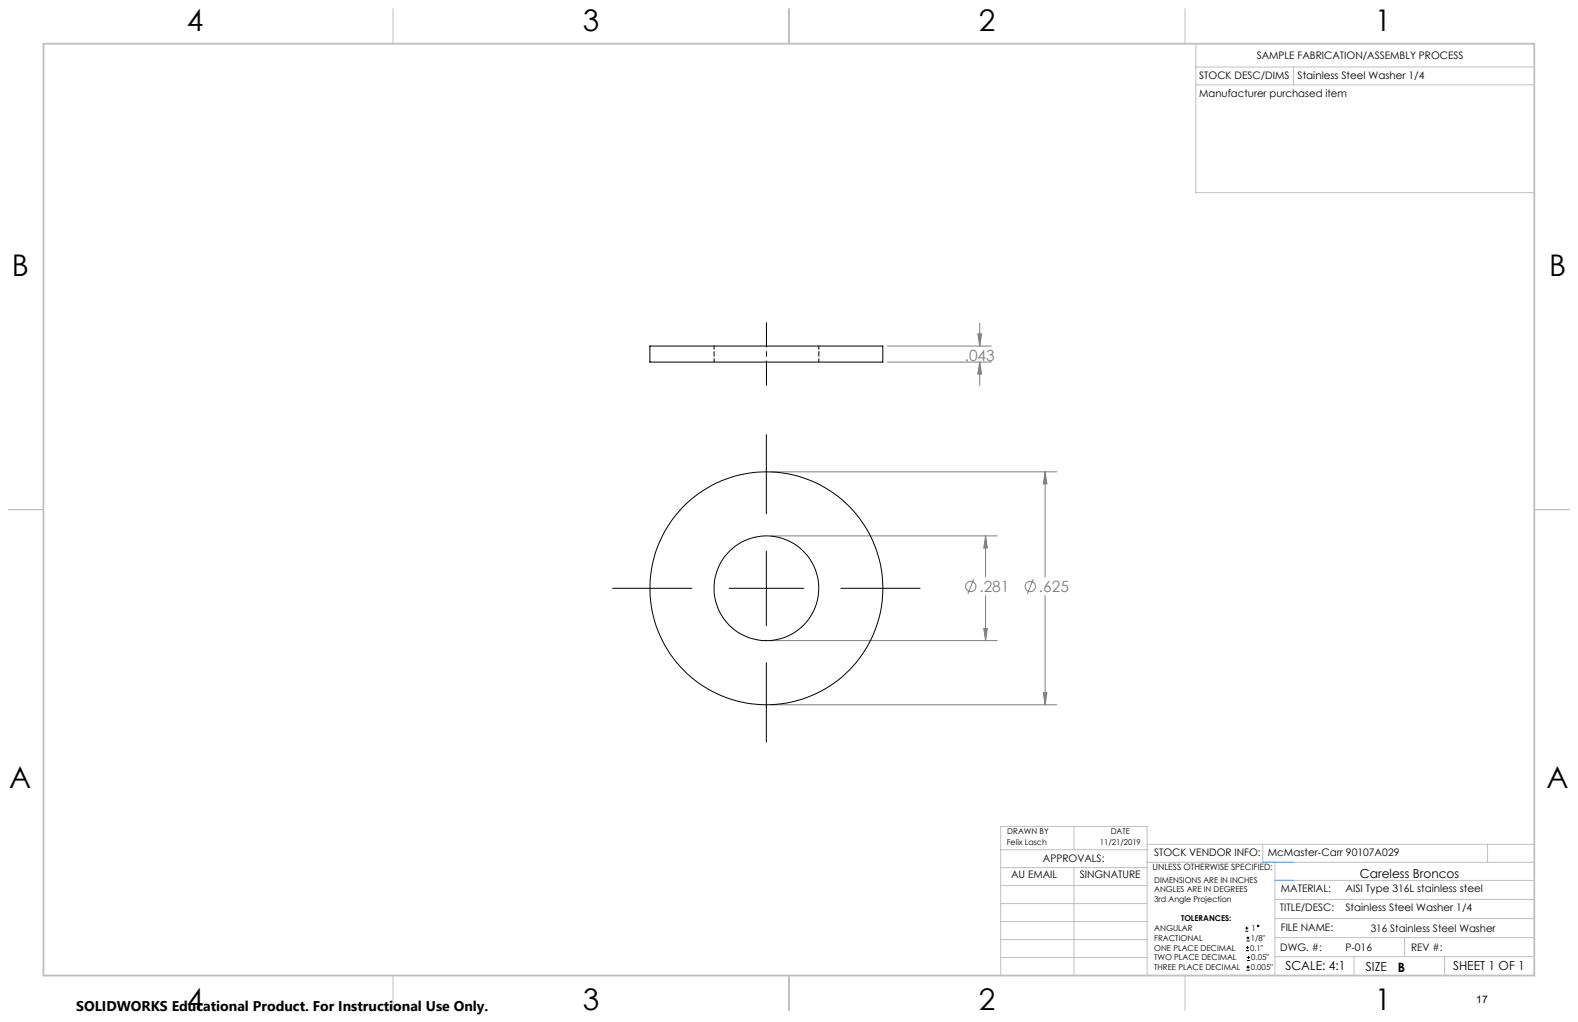
[picture p17: page 17]
Felix Lasch; FILE NAME:; DRAWN BY; DATE; SCALE: 4:1; SHEET 1 OF 1; AU EMAIL; SINGNATURE

Stainless Steel Washer 1/4

Manufacturer purchased item

STOCK VENDOR INFO: | McMaster-Carr 90107A029
UNLESS OTHERWISE SPECIFIED: ANGLES ARE IN DEGREES 3rd Angle Projection TOLERANCES: ANGULAR 1 | | Careless Broncos

DIMENSIONS ARE IN INCHES

AISI Type 316L stainless steel
316 Stainless Steel Washer

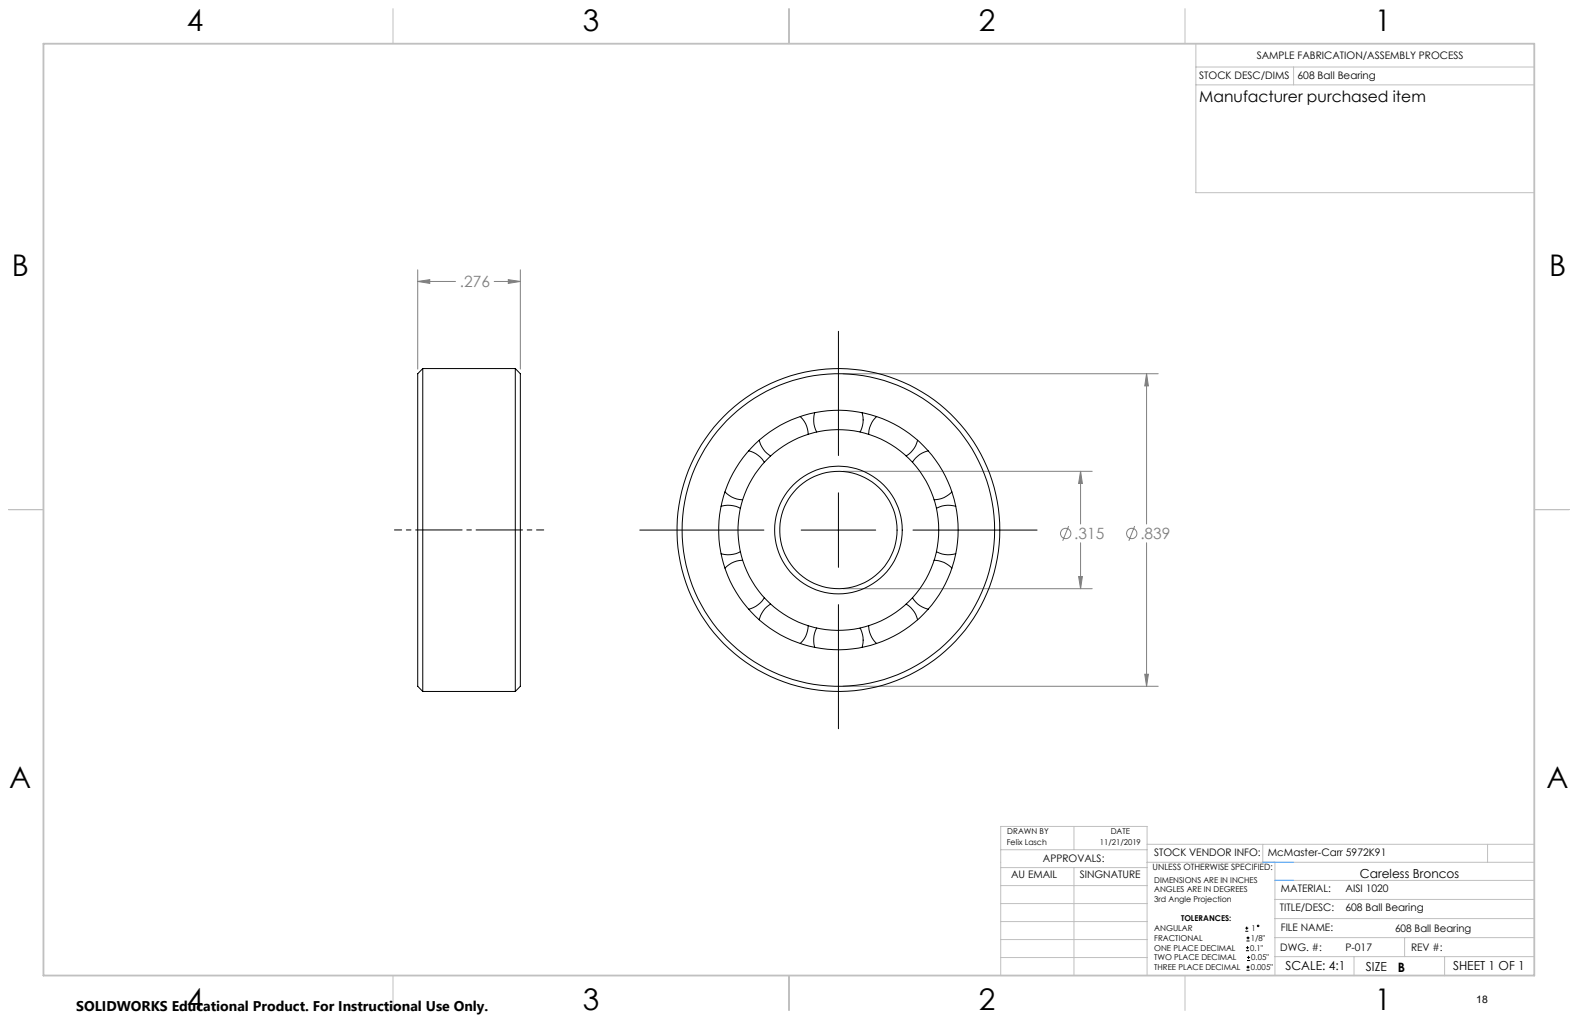
[picture p18: page 18]
608 Ball Bearing; AISI 1020; Felix Lasch; FILE NAME:; DRAWN BY; DATE; SCALE: 4:1; SHEET 1 OF 1; AU EMAIL; SINGNATURE

Manufacturer purchased item

STOCK VENDOR INFO: | McMaster-Carr 5972K91
UNLESS OTHERWISE SPECIFIED: ANGLES ARE IN DEGREES 3rd Angle Projection TOLERANCES: ANGULAR 1 | | Careless Broncos

DIMENSIONS ARE IN INCHES

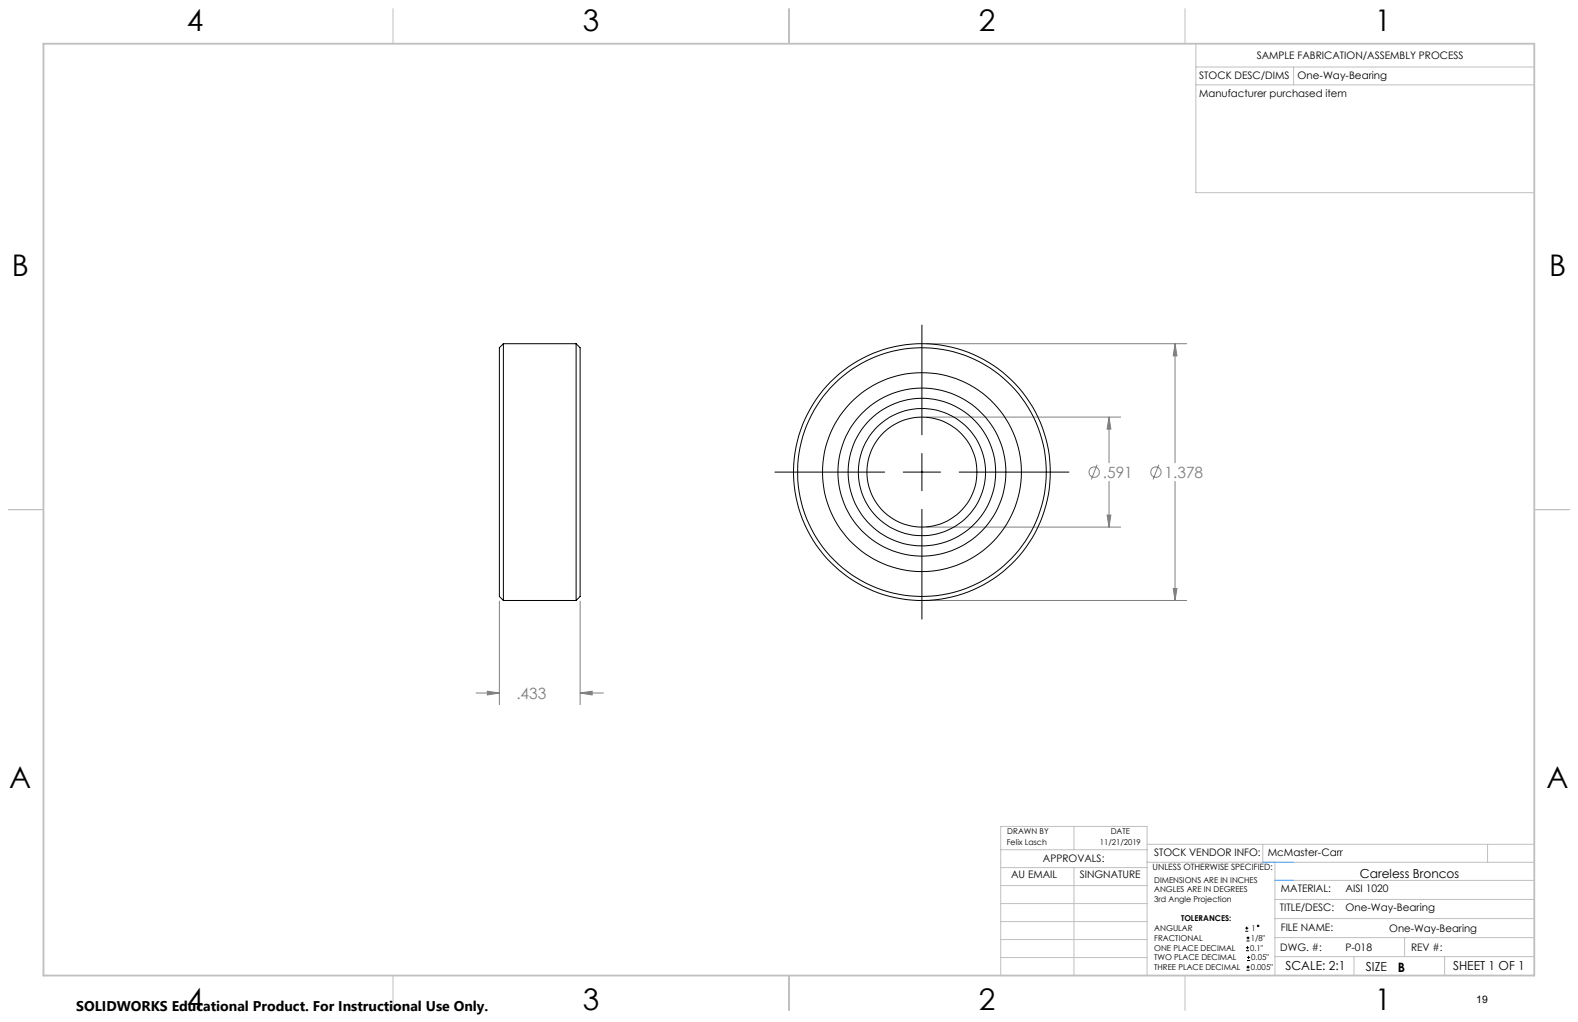
[picture p19: page 19]
Felix Lasch; FILE NAME:; DRAWN BY; DATE; SCALE: 2:1; SHEET 1 OF 1; AU EMAIL; SINGNATURE

One-Way-Bearing

Manufacturer purchased item

STOCK VENDOR INFO: | McMaster-Carr
UNLESS OTHERWISE SPECIFIED: ANGLES ARE IN DEGREES 3rd Angle Projection TOLERANCES: ANGULAR 1 | | Careless Broncos

DIMENSIONS ARE IN INCHES

AISI 1020

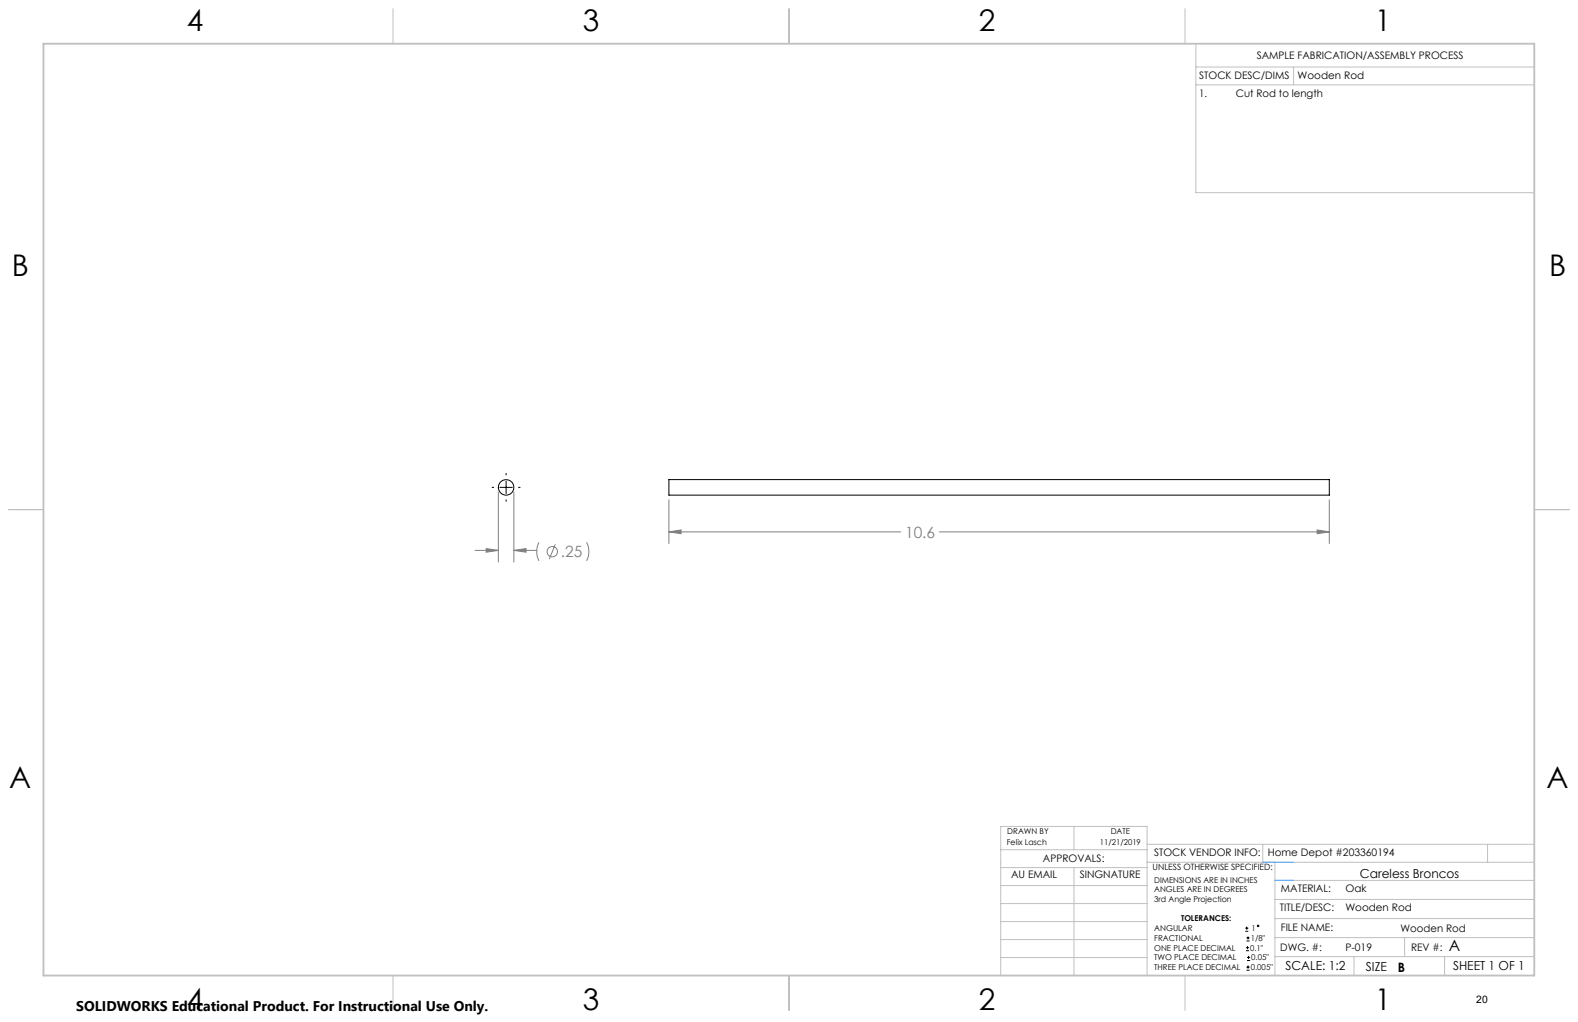
[picture p20: page 20]
Wooden Rod; Felix Lasch; FILE NAME:; DRAWN BY; DATE; AU EMAIL; SINGNATURE

1. Cut Rod to length

STOCK VENDOR INFO: | Home Depot #203360194
UNLESS OTHERWISE SPECIFIED: ANGLES ARE IN DEGREES 3rd Angle Projection TOLERANCES: ANGULAR 1 | | Careless Broncos

DIMENSIONS ARE IN INCHES

REV #: A

SCALE: 1:2 | | SHEET 1 OF 1

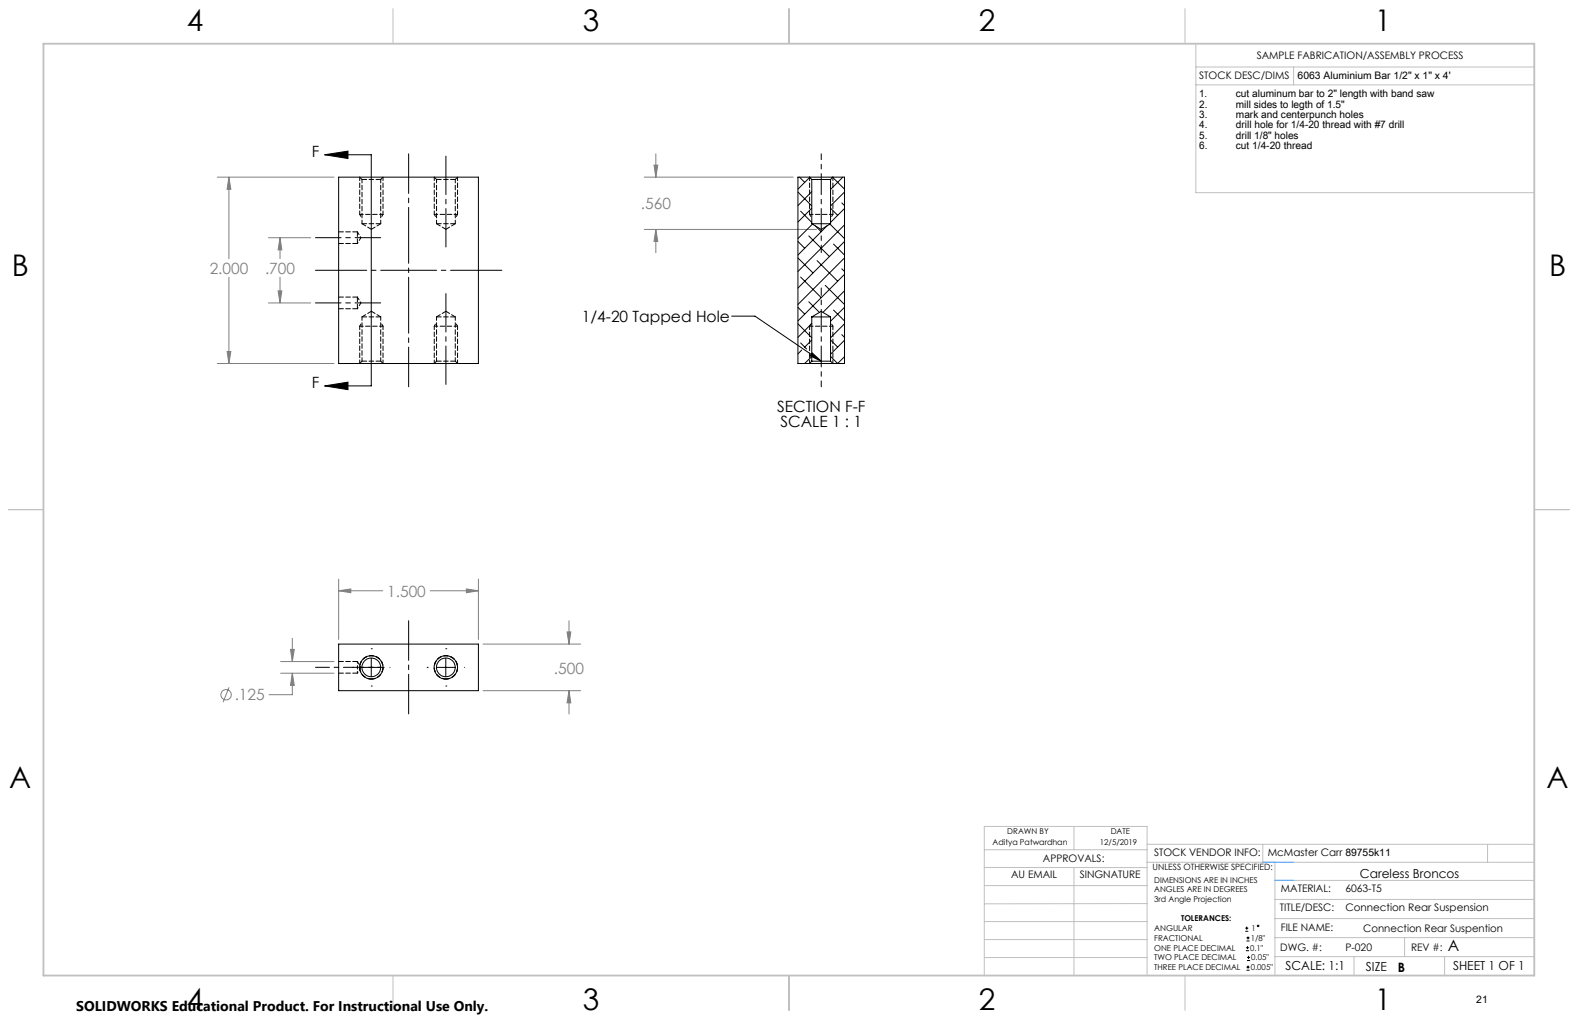
[picture p21: page 21]
1/4-20 Tapped Hole; SECTION F-F SCALE 1 : 1; 6063 Aluminium Bar 1/2" x 1" x 4'; Aditya Patwardhan; FILE NAME:; DRAWN BY; DATE; AU EMAIL; SINGNATURE

1. cut aluminum bar to 2" length with band saw
2. mill sides to legth of 1.5"
3. mark and centerpunch holes
4. drill hole for 1/4-20 thread with #7 drill
5. drill 1/8" holes
6. cut 1/4-20 thread

STOCK VENDOR INFO: | McMaster Carr 89755k11
UNLESS OTHERWISE SPECIFIED: ANGLES ARE IN DEGREES 3rd Angle Projection TOLERANCES: ANGULAR 1 | | Careless Broncos

DIMENSIONS ARE IN INCHES

Connection Rear Suspension
Connection Rear Suspention

REV #: A

SCALE: 1:1 | | SHEET 1 OF 1

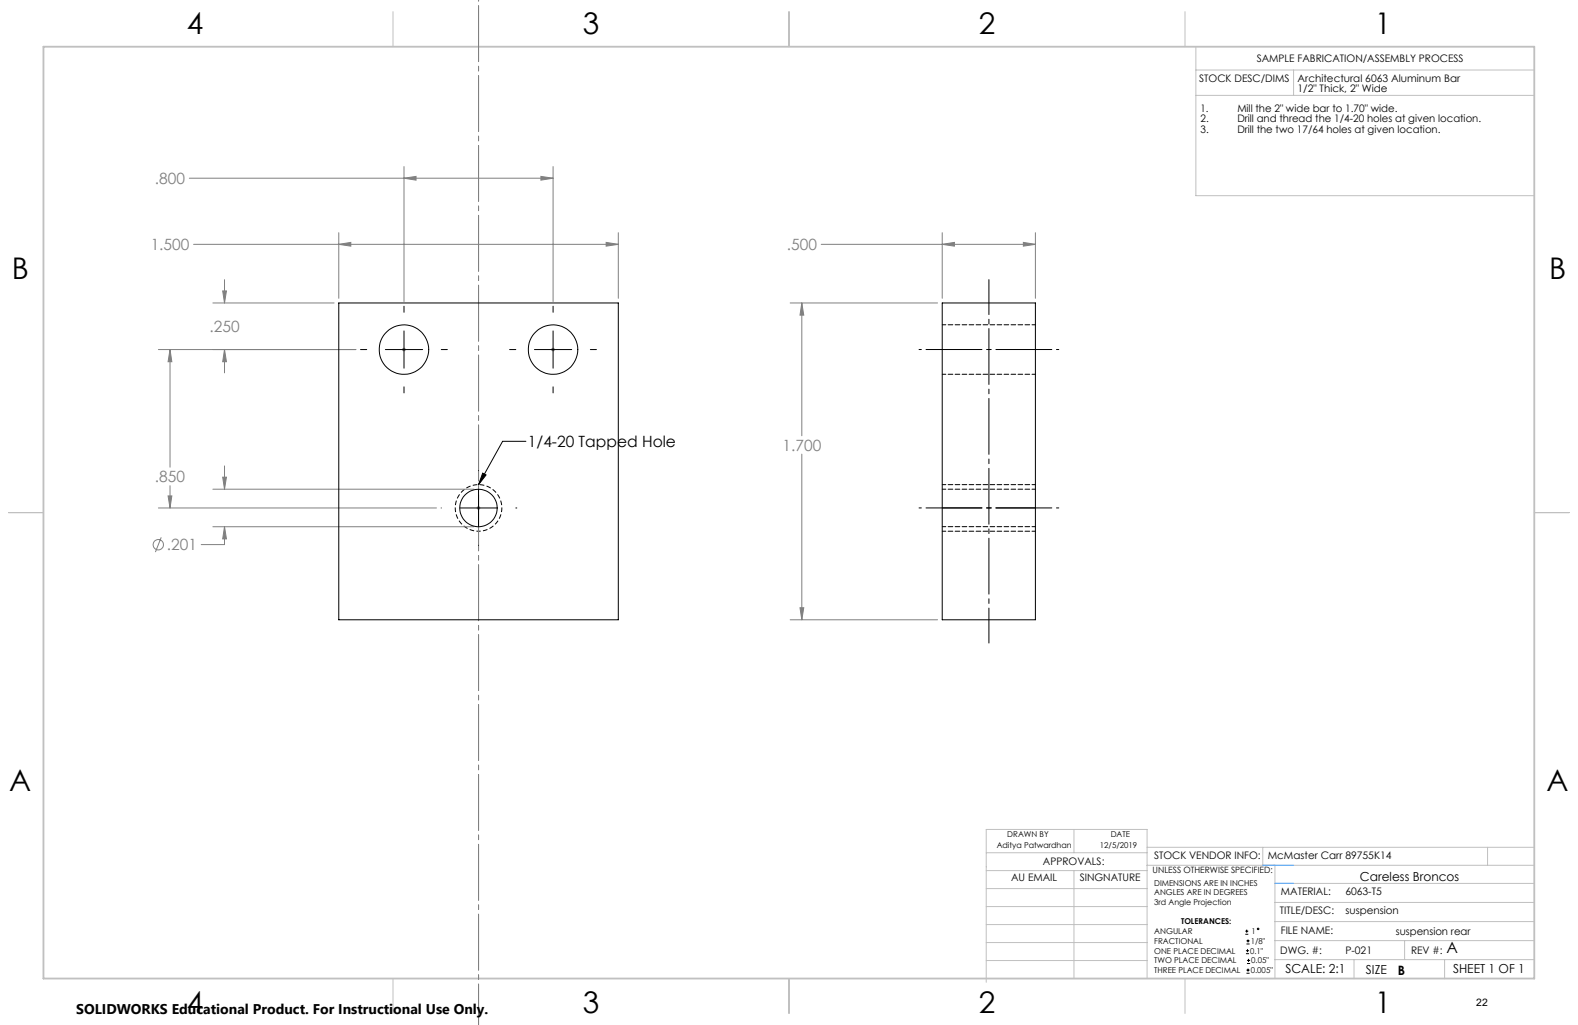
[picture p22: page 22]
1/4-20 Tapped Hole; Aditya Patwardhan; FILE NAME:; DRAWN BY; DATE; suspension rear; AU EMAIL; SINGNATURE

Architectural 6063 Aluminum Bar
1/2" Thick, 2" Wide

1. Mill the 2" wide bar to 1.70" wide.
2. Drill and thread the 1/4-20 holes at given location.
3. Drill the two 17/64 holes at given location.

STOCK VENDOR INFO: | McMaster Carr 89755K14
UNLESS OTHERWISE SPECIFIED: ANGLES ARE IN DEGREES 3rd Angle Projection TOLERANCES: ANGULAR 1 | | Careless Broncos

DIMENSIONS ARE IN INCHES

SCALE: 2:1 | | SHEET 1 OF 1

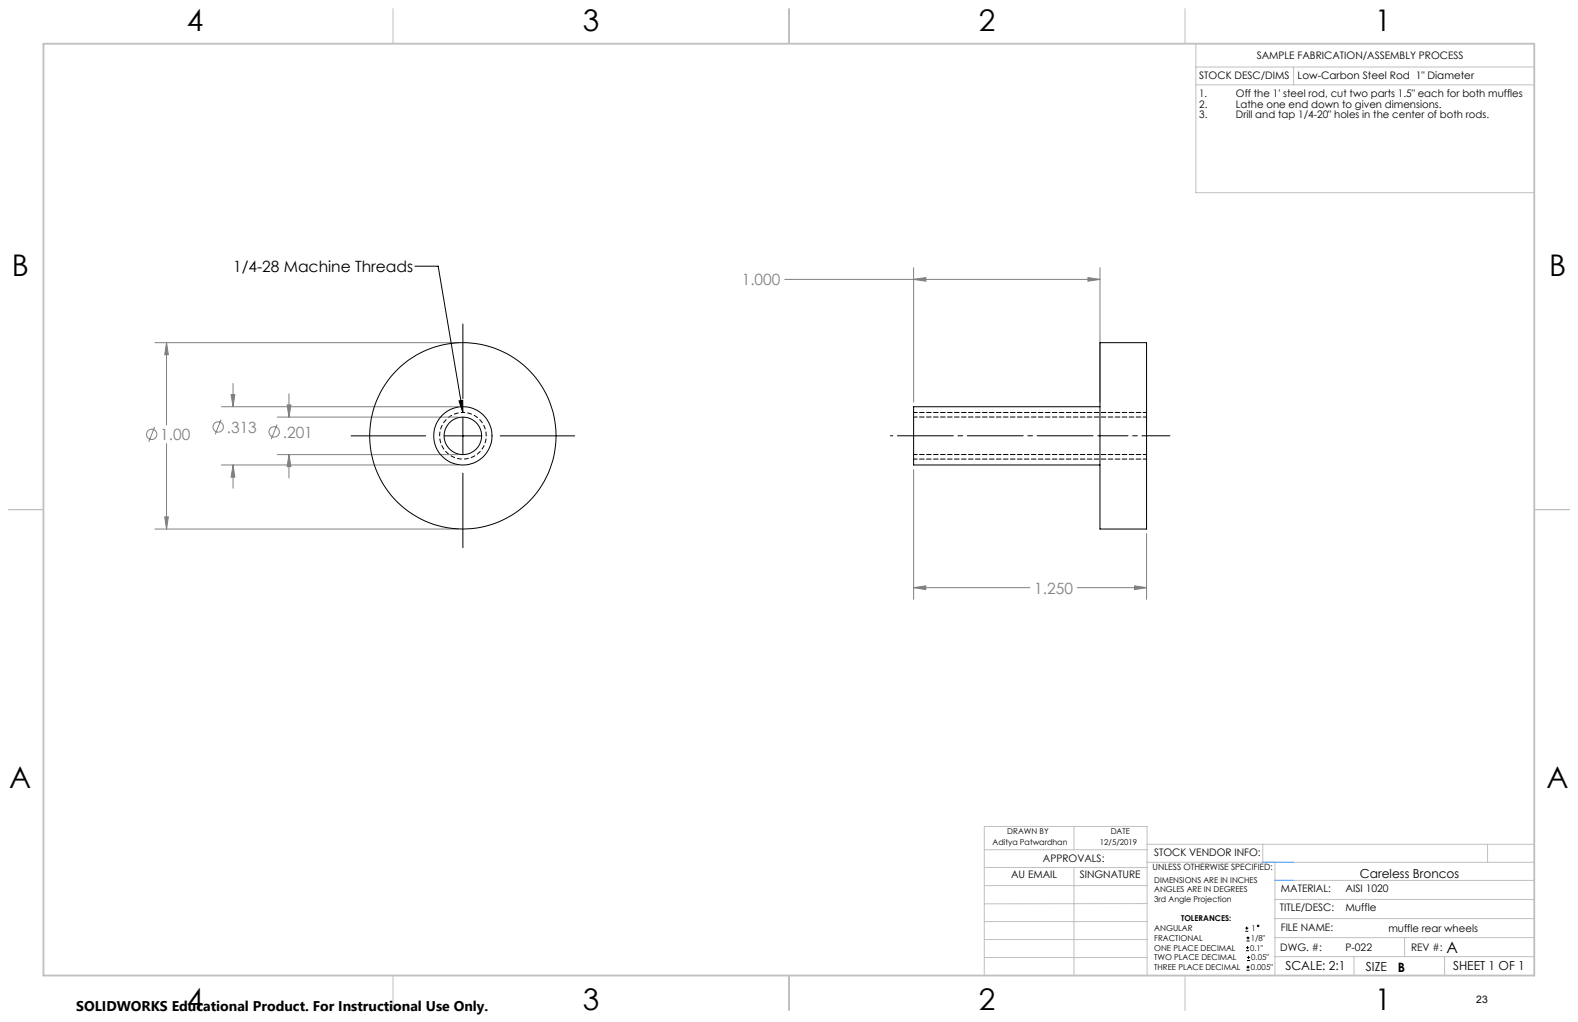
[picture p23: page 23]
1/4-28 Machine Threads; AISI 1020; Aditya Patwardhan; FILE NAME:; DRAWN BY; DATE; AU EMAIL; SINGNATURE

Low-Carbon Steel Rod 1" Diameter

1. Off the 1' steel rod, cut two parts 1.5" each for both muffles
2. Lathe one end down to given dimensions.
3. Drill and tap 1/4-20" holes in the center of both rods.

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

DIMENSIONS ARE IN INCHES

muffle rear wheels

SCALE: 2:1 | | SHEET 1 OF 1

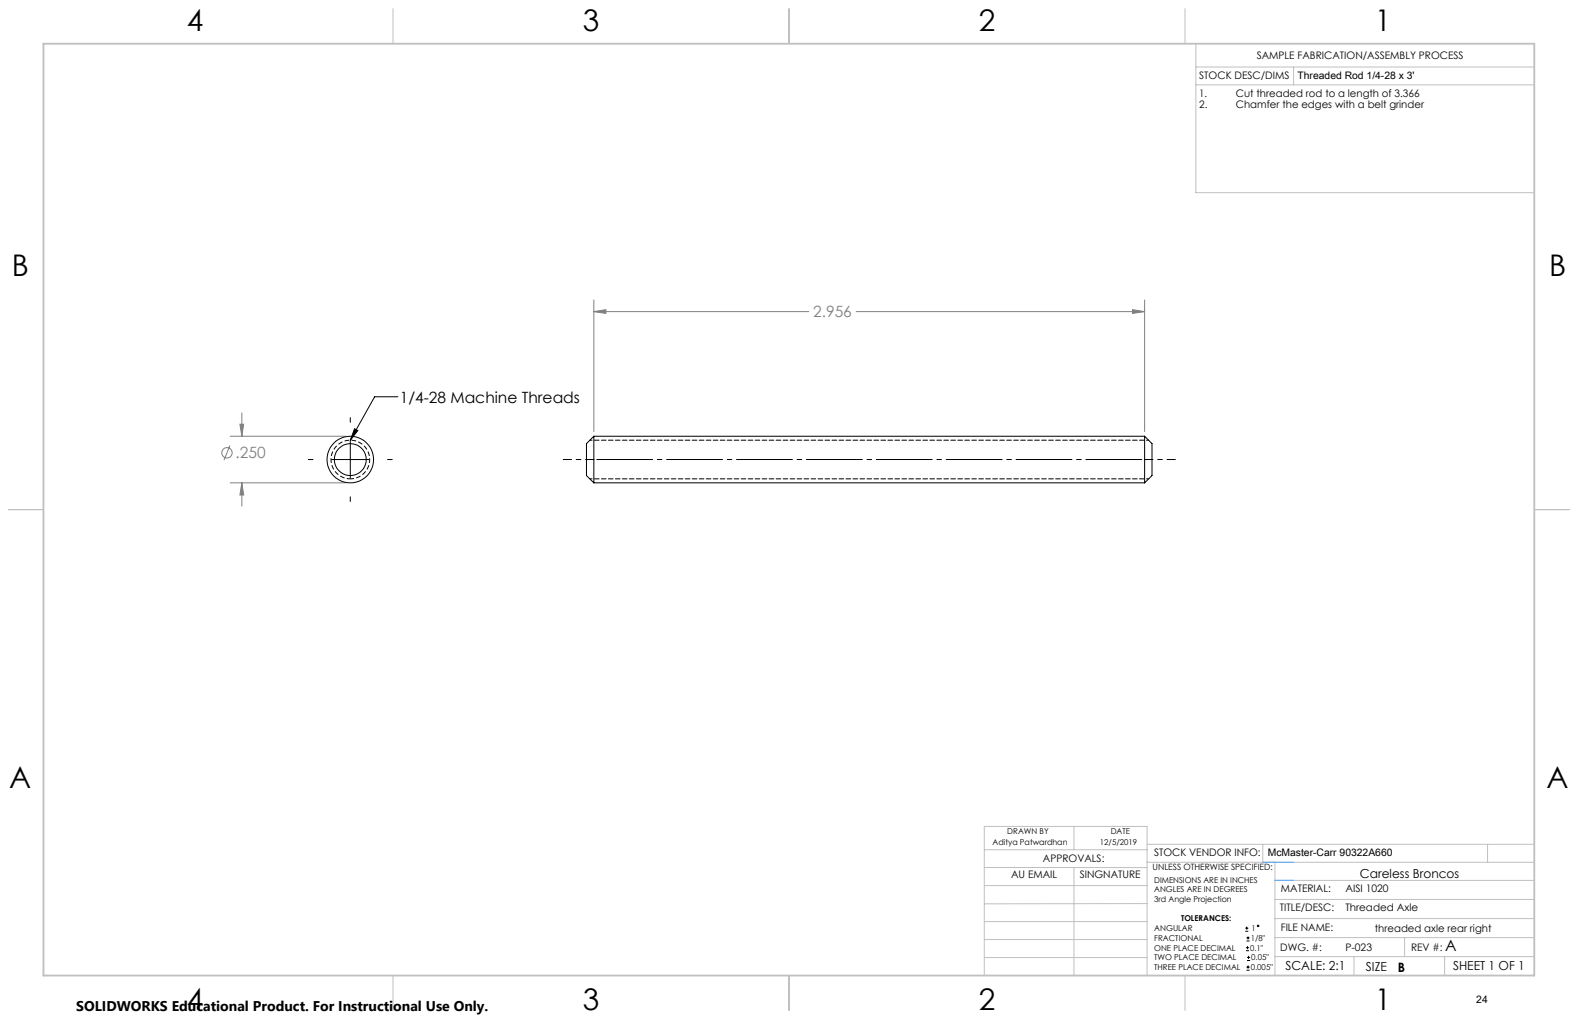
[picture p24: page 24]
1/4-28 Machine Threads; Threaded Rod 1/4-28 x 3'; Aditya Patwardhan; FILE NAME:; DRAWN BY; DATE; AU EMAIL; SINGNATURE

1. Cut threaded rod to a length of 3.366
2. Chamfer the edges with a belt grinder

STOCK VENDOR INFO: | McMaster-Carr 90322A660
UNLESS OTHERWISE SPECIFIED: ANGLES ARE IN DEGREES 3rd Angle Projection TOLERANCES: ANGULAR 1 | | Careless Broncos

DIMENSIONS ARE IN INCHES

AISI 1020
Threaded Axle
threaded axle rear right

REV #: A

SCALE: 2:1 | | SHEET 1 OF 1

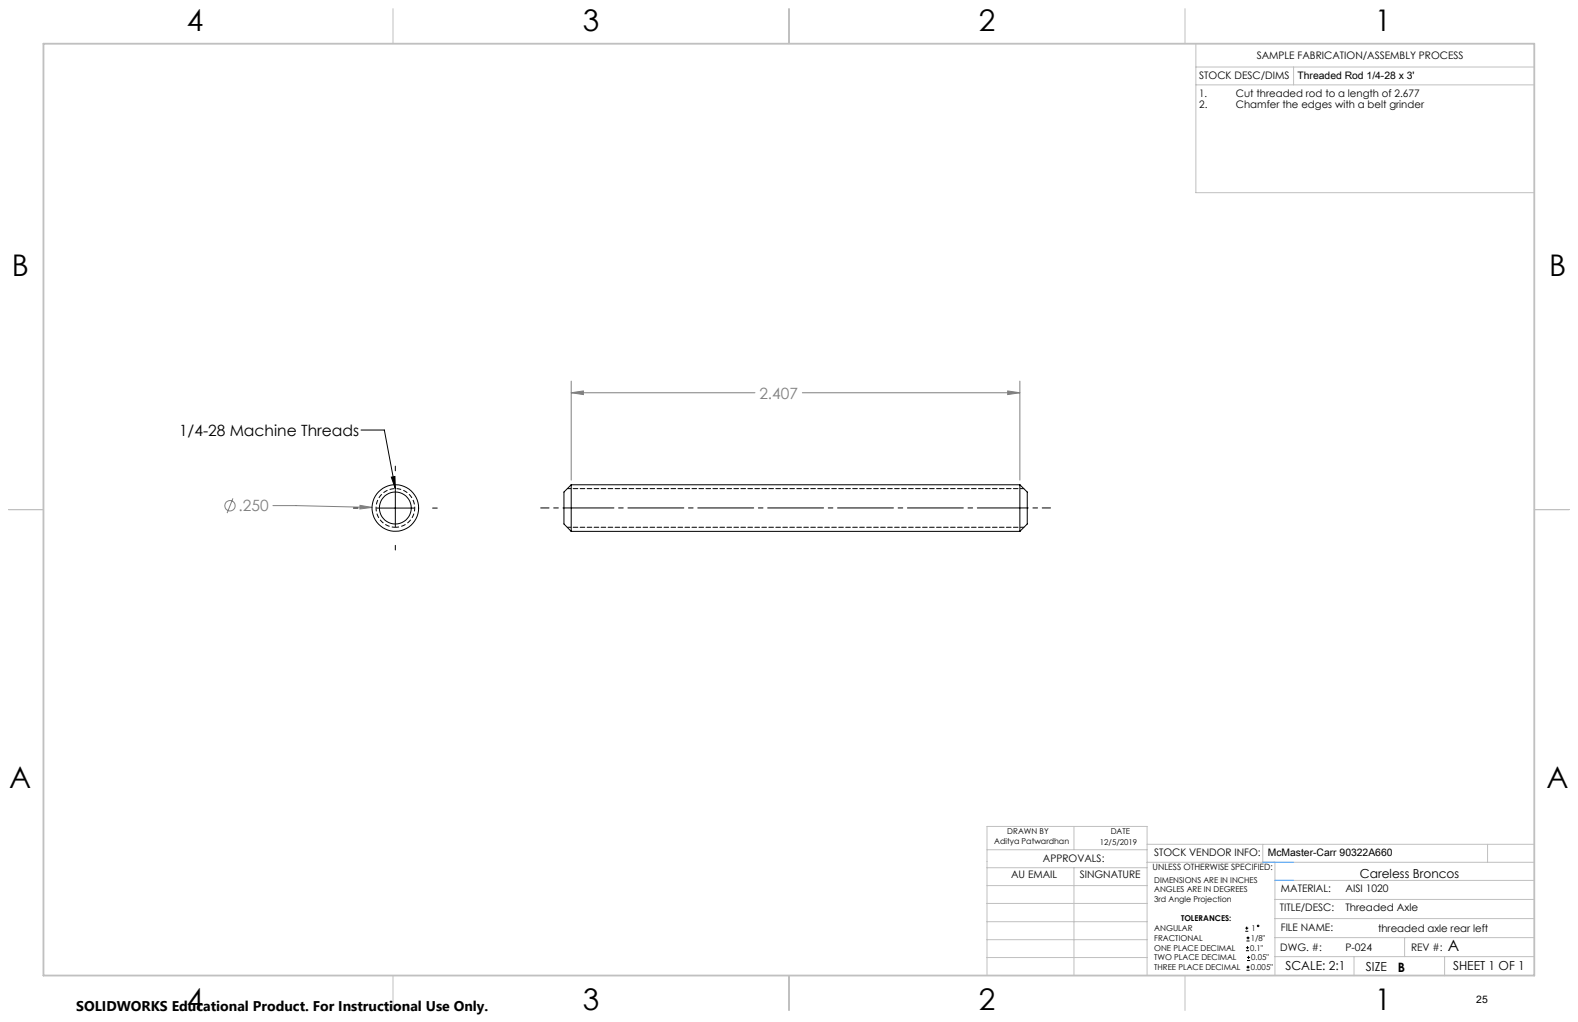
[picture p25: page 25]
1/4-28 Machine Threads; Threaded Rod 1/4-28 x 3'; FILE NAME:; DRAWN BY; DATE; AU EMAIL; SINGNATURE; Aditya Patwardhan

1. Cut threaded rod to a length of 2.677
2. Chamfer the edges with a belt grinder

STOCK VENDOR INFO: | McMaster-Carr 90322A660
UNLESS OTHERWISE SPECIFIED: ANGLES ARE IN DEGREES 3rd Angle Projection TOLERANCES: ANGULAR 1 | | Careless Broncos

DIMENSIONS ARE IN INCHES

AISI 1020
Threaded Axle
threaded axle rear left

SCALE: 2:1 | | SHEET 1 OF 1

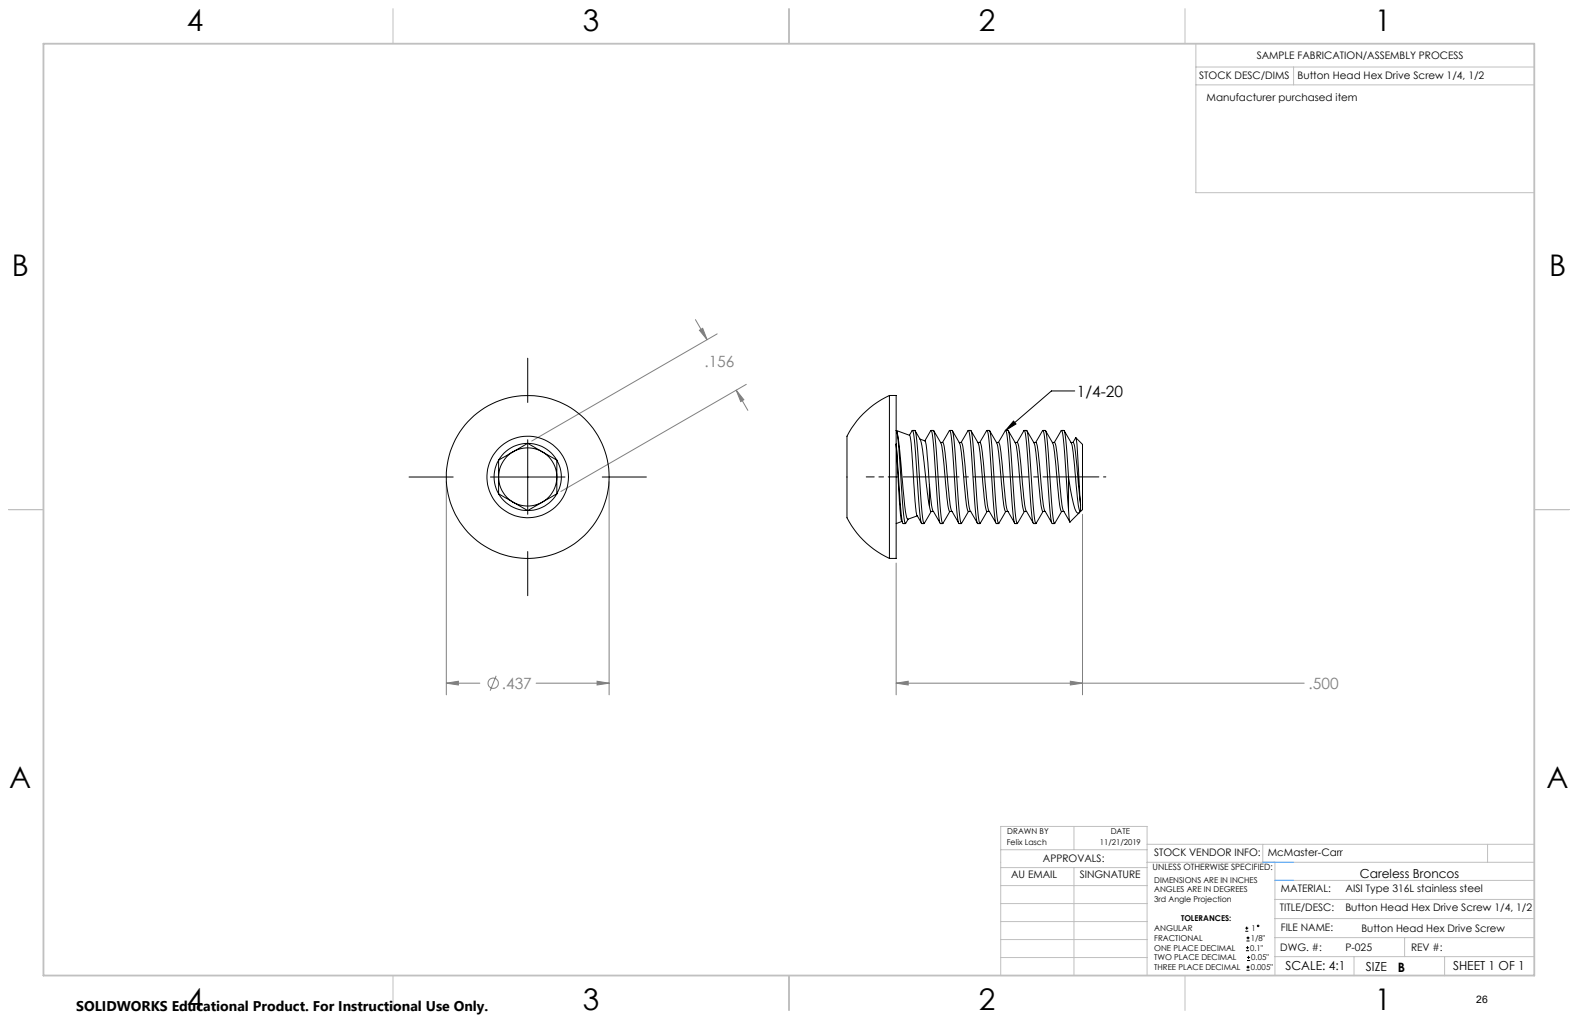
[picture p26: page 26]
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

Button Head Hex Drive Screw 1/4, 1/2

Manufacturer purchased item

STOCK VENDOR INFO: | McMaster-Carr
UNLESS OTHERWISE SPECIFIED: ANGLES ARE IN DEGREES 3rd Angle Projection TOLERANCES: ANGULAR 1 | | Careless Broncos

DIMENSIONS ARE IN INCHES

AISI Type 316L stainless steel
Button Head Hex Drive Screw

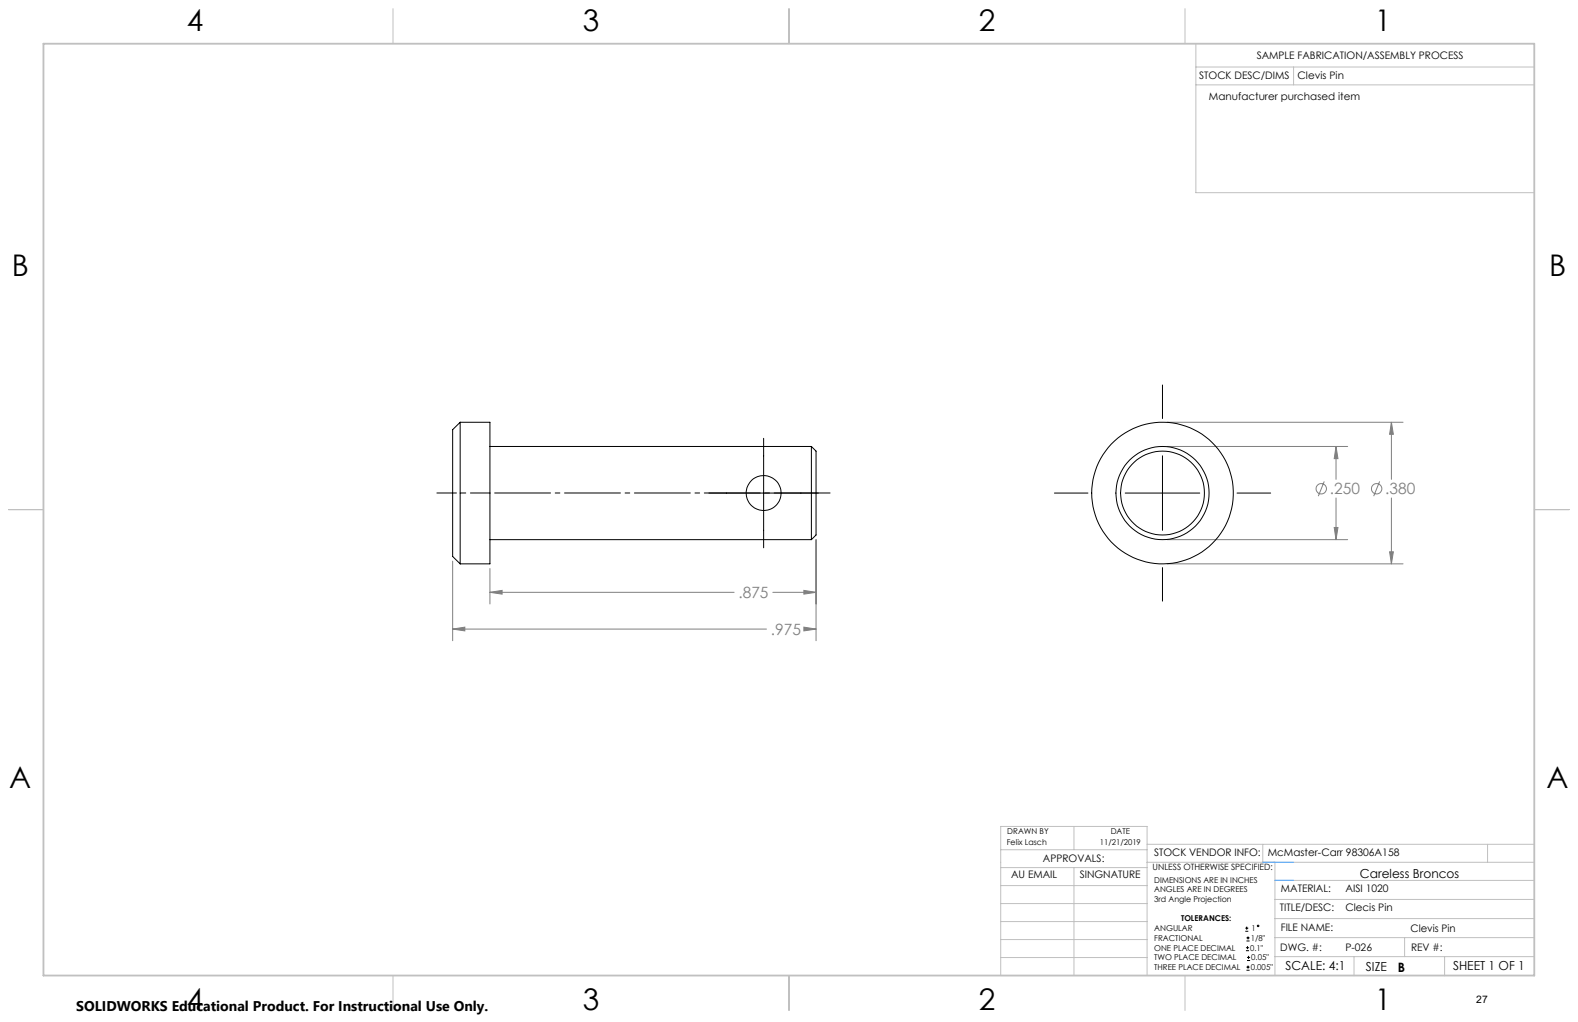
[picture p27: page 27]
Clevis Pin; Clecis Pin; AISI 1020; Felix Lasch; FILE NAME:; DRAWN BY; DATE; SCALE: 4:1; SHEET 1 OF 1; AU EMAIL; SINGNATURE

Manufacturer purchased item

STOCK VENDOR INFO: | McMaster-Carr 98306A158
UNLESS OTHERWISE SPECIFIED: ANGLES ARE IN DEGREES 3rd Angle Projection TOLERANCES: ANGULAR 1 | | Careless Broncos

DIMENSIONS ARE IN INCHES

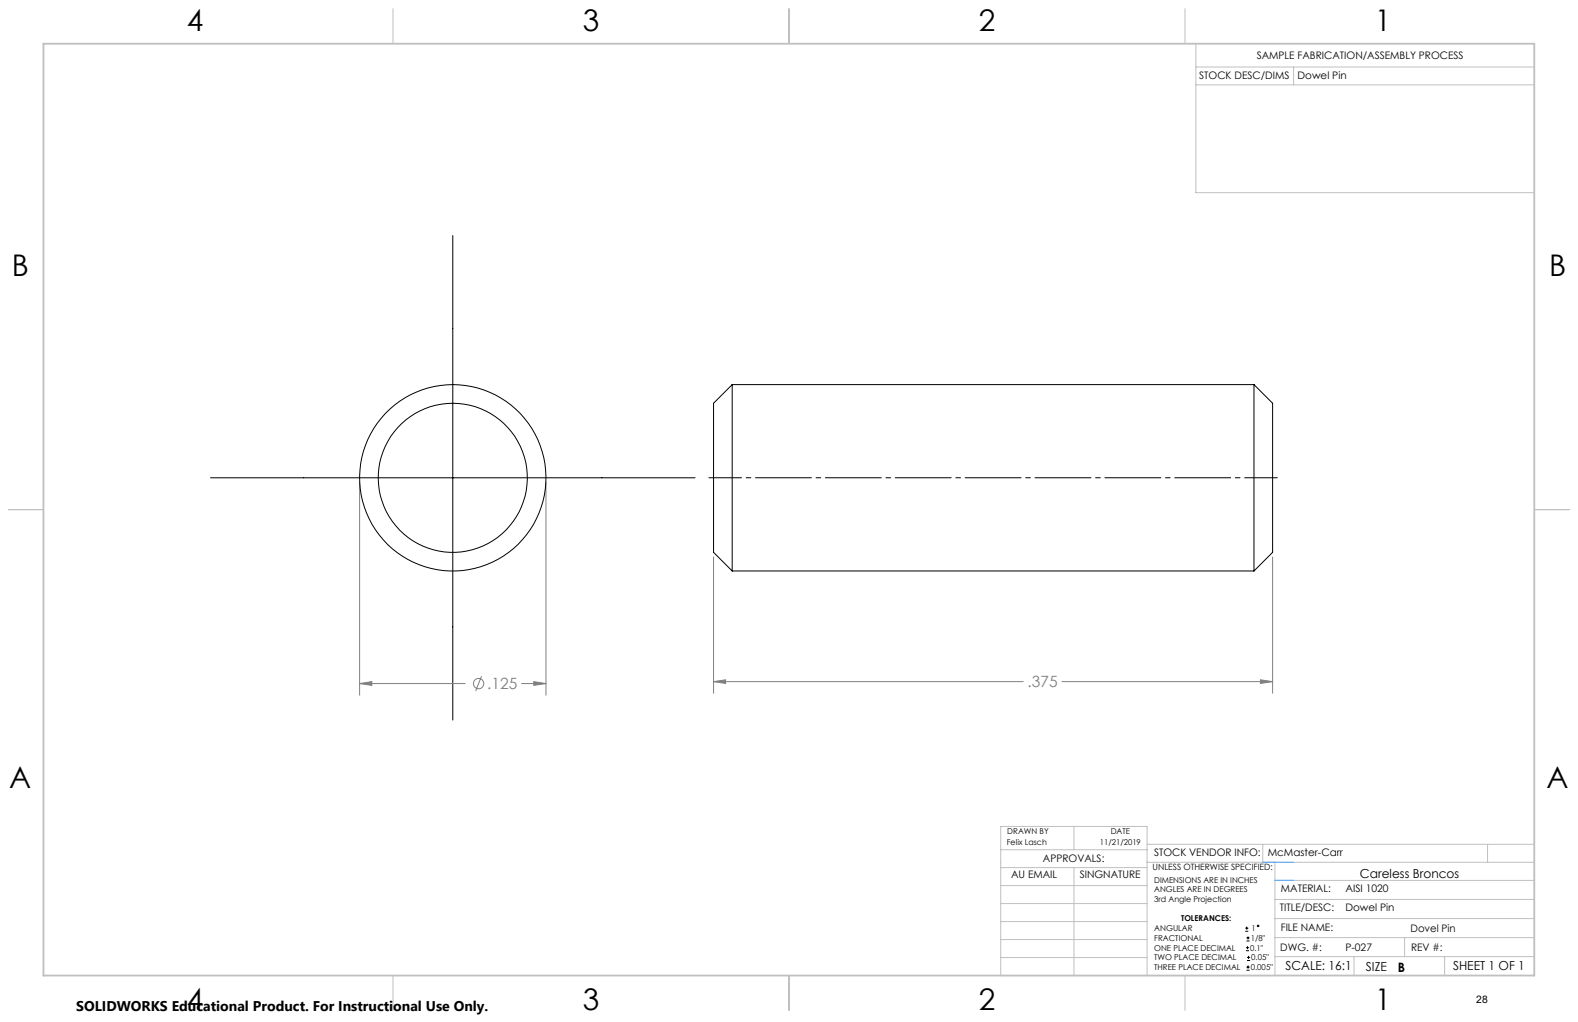
[picture p28: page 28]
Dowel Pin; AISI 1020; Felix Lasch; FILE NAME:; DRAWN BY; DATE; SCALE: 16:1; SHEET 1 OF 1; Dovel Pin; AU EMAIL; SINGNATURE

STOCK VENDOR INFO: | McMaster-Carr
UNLESS OTHERWISE SPECIFIED: ANGLES ARE IN DEGREES 3rd Angle Projection TOLERANCES: ANGULAR 1 | | Careless Broncos

DIMENSIONS ARE IN INCHES

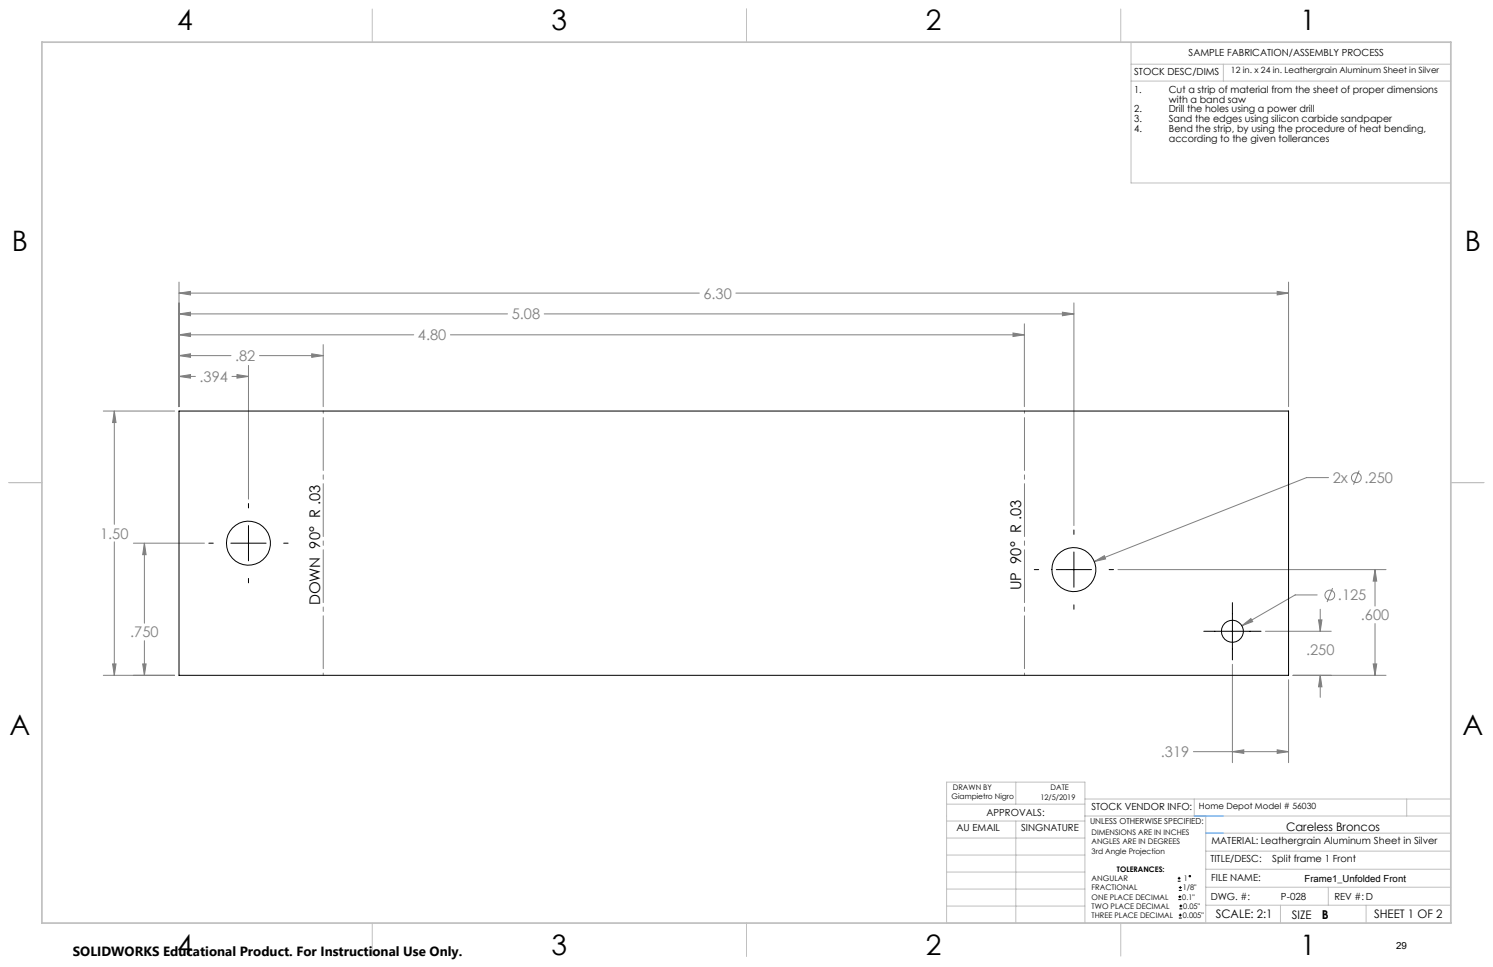
[picture p29: page 29]
DOWN 90° R .03; Giampietro Nigro; FILE NAME:; DRAWN BY; DATE; AU EMAIL; SINGNATURE

12 in. x 24 in. Leathergrain Aluminum Sheet in Silver

1. Cut a strip of material from the sheet of proper dimensions
with a band saw
2. Drill the holes using a power drill
3. Sand the edges using silicon carbide sandpaper
4. Bend the strip, by using the procedure of heat bending,
according to the given tollerances

STOCK VENDOR INFO: | Home Depot Model # 56030
UNLESS OTHERWISE SPECIFIED: ANGLES ARE IN DEGREES 3rd Angle Projection TOLERANCES: ANGULAR 1 | | Careless Broncos

DIMENSIONS ARE IN INCHES

Leathergrain Aluminum Sheet in Silver
Split frame 1 Front
Frame1_Unfolded Front

SCALE: 2:1 | | SHEET 1 OF 2

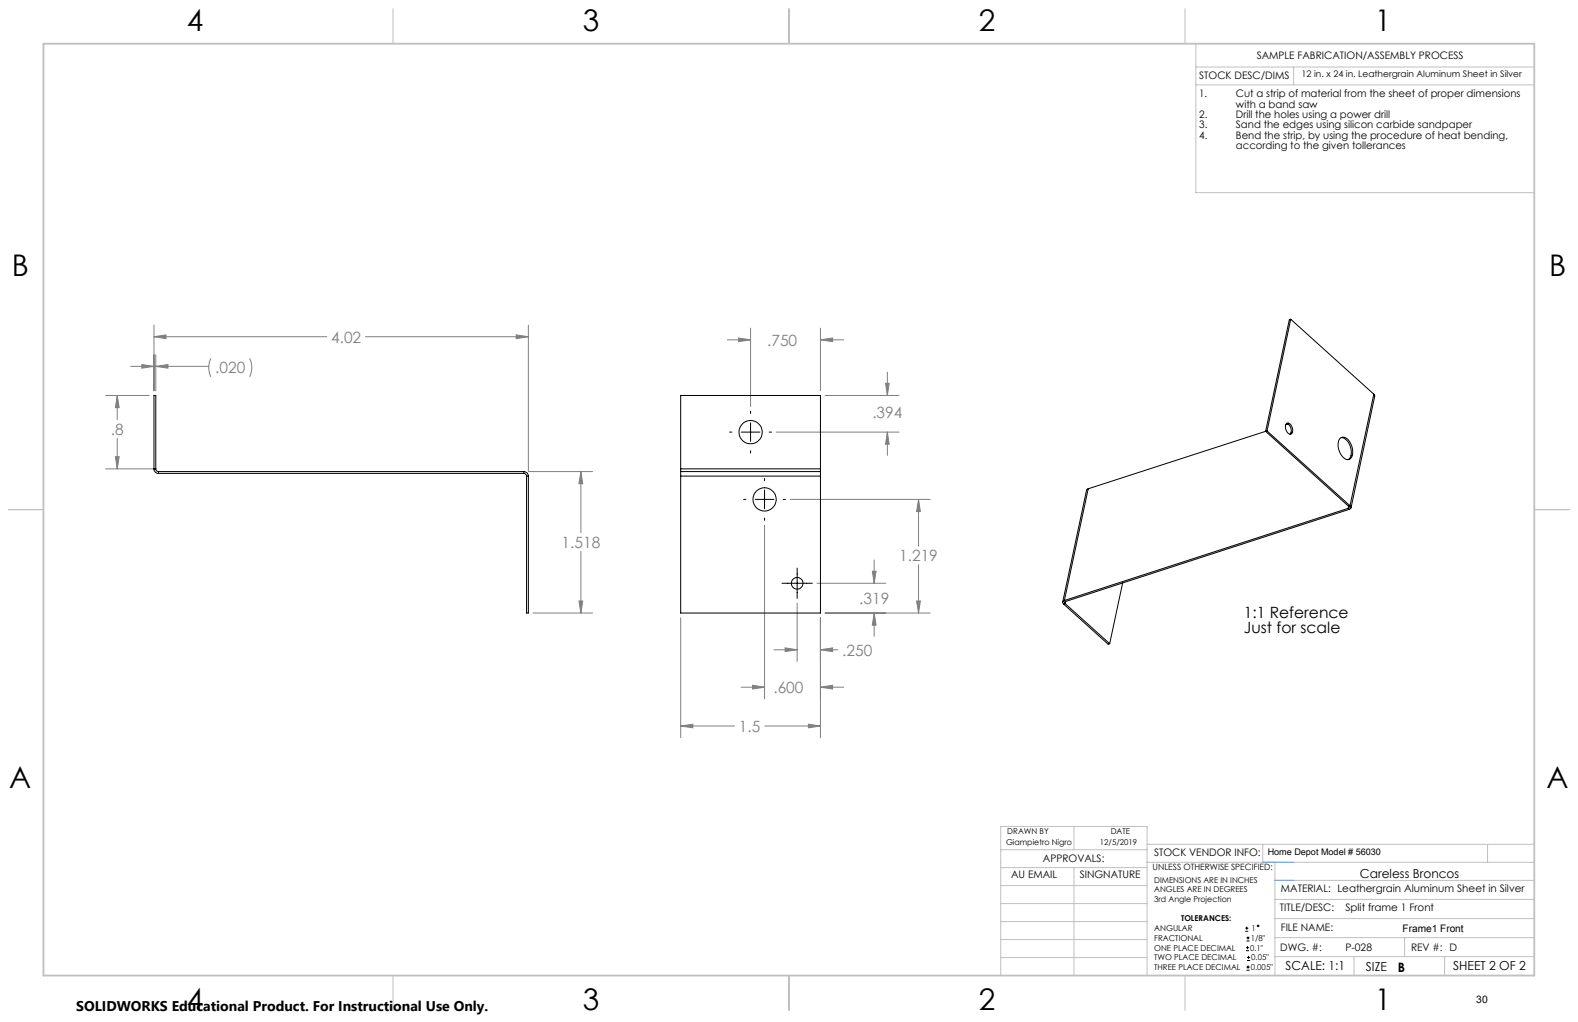
[picture p30: page 30]
Giampietro Nigro; FILE NAME:; DRAWN BY; DATE; Frame1 Front; AU EMAIL; SINGNATURE

12 in. x 24 in. Leathergrain Aluminum Sheet in Silver

1. Cut a strip of material from the sheet of proper dimensions
with a band saw
2. Drill the holes using a power drill
3. Sand the edges using silicon carbide sandpaper
4. Bend the strip, by using the procedure of heat bending,
according to the given tollerances

1:1 Reference
Just for scale

STOCK VENDOR INFO: | Home Depot Model # 56030
UNLESS OTHERWISE SPECIFIED: ANGLES ARE IN DEGREES 3rd Angle Projection TOLERANCES: ANGULAR 1 | | Careless Broncos

DIMENSIONS ARE IN INCHES

Leathergrain Aluminum Sheet in Silver
Split frame 1 Front

SCALE: 1:1 | | SHEET 2 OF 2

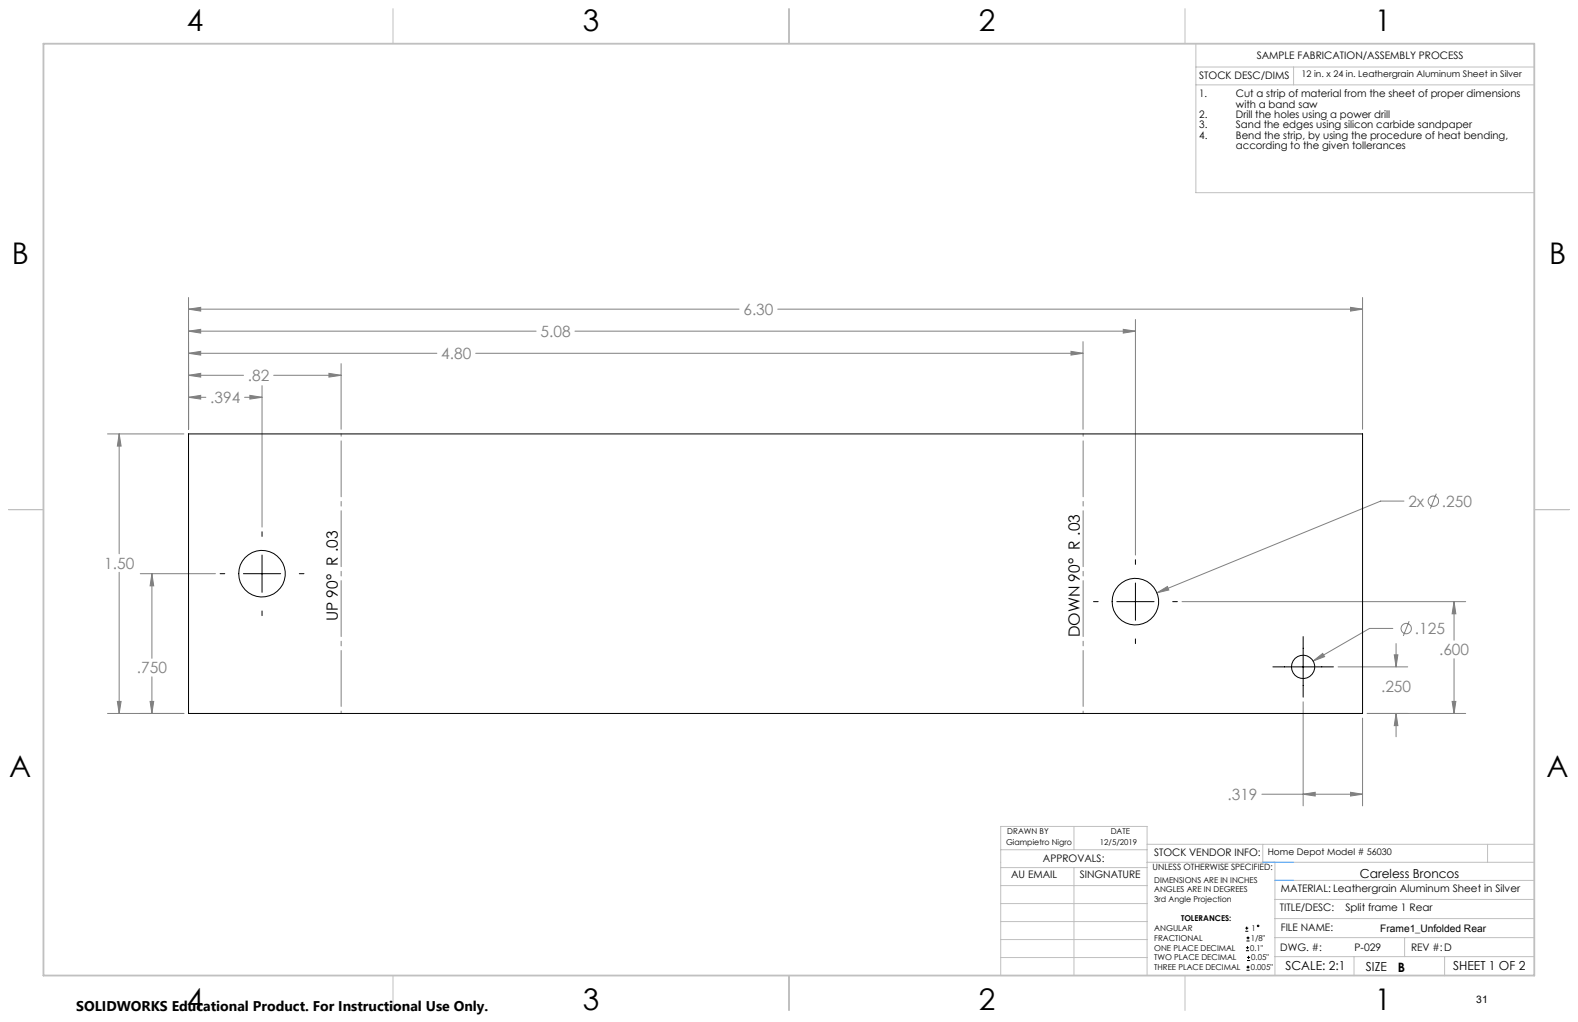
[picture p31: page 31]
DOWN 90° R .03; Giampietro Nigro; FILE NAME:; DRAWN BY; DATE; AU EMAIL; SINGNATURE

12 in. x 24 in. Leathergrain Aluminum Sheet in Silver

1. Cut a strip of material from the sheet of proper dimensions
with a band saw
2. Drill the holes using a power drill
3. Sand the edges using silicon carbide sandpaper
4. Bend the strip, by using the procedure of heat bending,
according to the given tollerances

STOCK VENDOR INFO: | Home Depot Model # 56030
UNLESS OTHERWISE SPECIFIED: ANGLES ARE IN DEGREES 3rd Angle Projection TOLERANCES: ANGULAR 1 | | Careless Broncos

DIMENSIONS ARE IN INCHES

Leathergrain Aluminum Sheet in Silver
Split frame 1 Rear
Frame1_Unfolded Rear

SCALE: 2:1 | | SHEET 1 OF 2

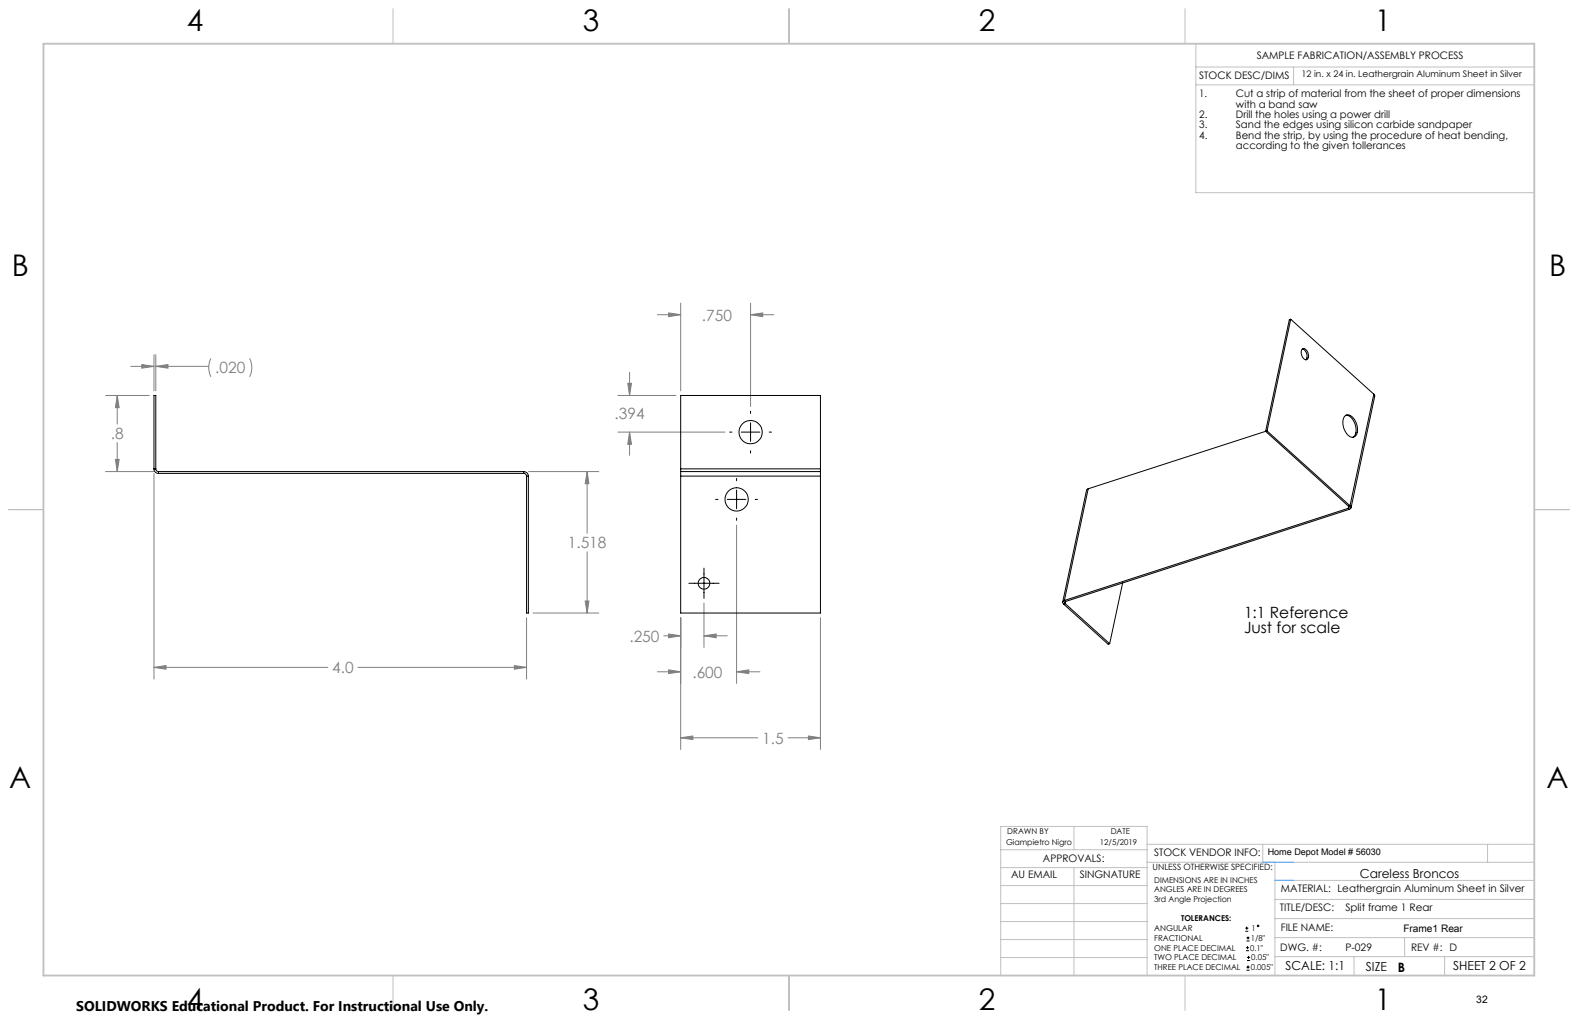
[picture p32: page 32]
Giampietro Nigro; FILE NAME:; DRAWN BY; DATE; Frame1 Rear; AU EMAIL; SINGNATURE

12 in. x 24 in. Leathergrain Aluminum Sheet in Silver

1. Cut a strip of material from the sheet of proper dimensions
with a band saw
2. Drill the holes using a power drill
3. Sand the edges using silicon carbide sandpaper
4. Bend the strip, by using the procedure of heat bending,
according to the given tollerances

1:1 Reference
Just for scale

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

DIMENSIONS ARE IN INCHES

Leathergrain Aluminum Sheet in Silver
Split frame 1 Rear

SCALE: 1:1 | | SHEET 2 OF 2

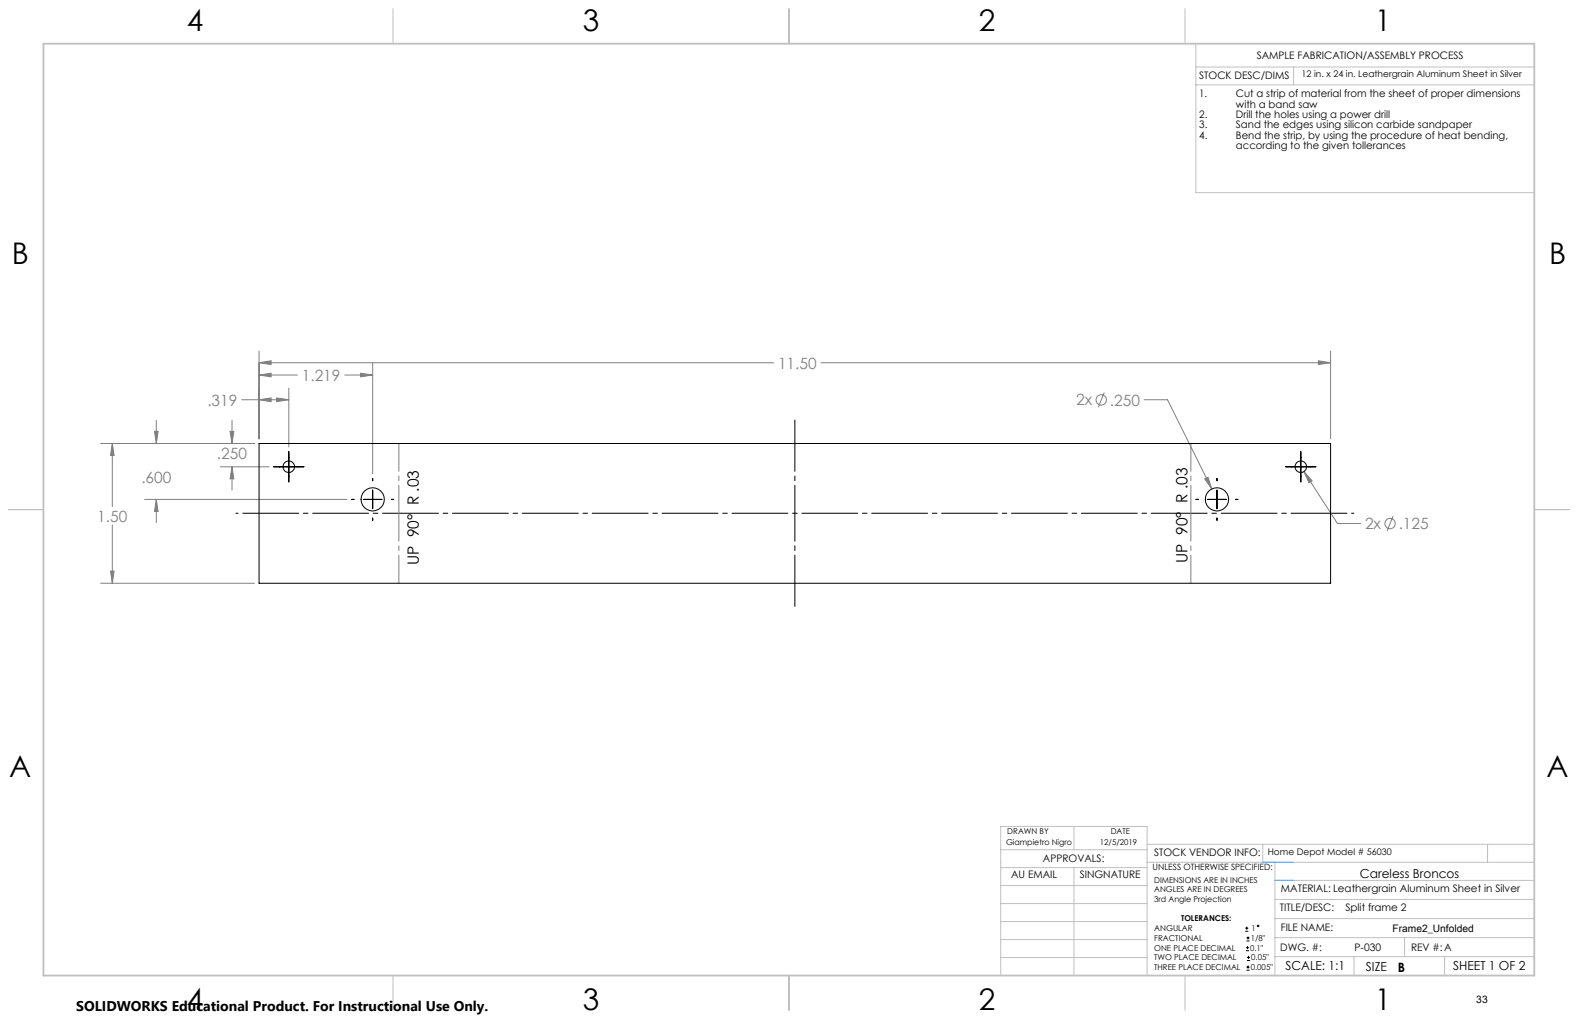
[picture p33: page 33]
Giampietro Nigro; FILE NAME:; DRAWN BY; DATE; AU EMAIL; SINGNATURE

12 in. x 24 in. Leathergrain Aluminum Sheet in Silver

1. Cut a strip of material from the sheet of proper dimensions
with a band saw
2. Drill the holes using a power drill
3. Sand the edges using silicon carbide sandpaper
4. Bend the strip, by using the procedure of heat bending,
according to the given tollerances

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

DIMENSIONS ARE IN INCHES

Leathergrain Aluminum Sheet in Silver
Split frame 2

SCALE: 1:1 | | SHEET 1 OF 2

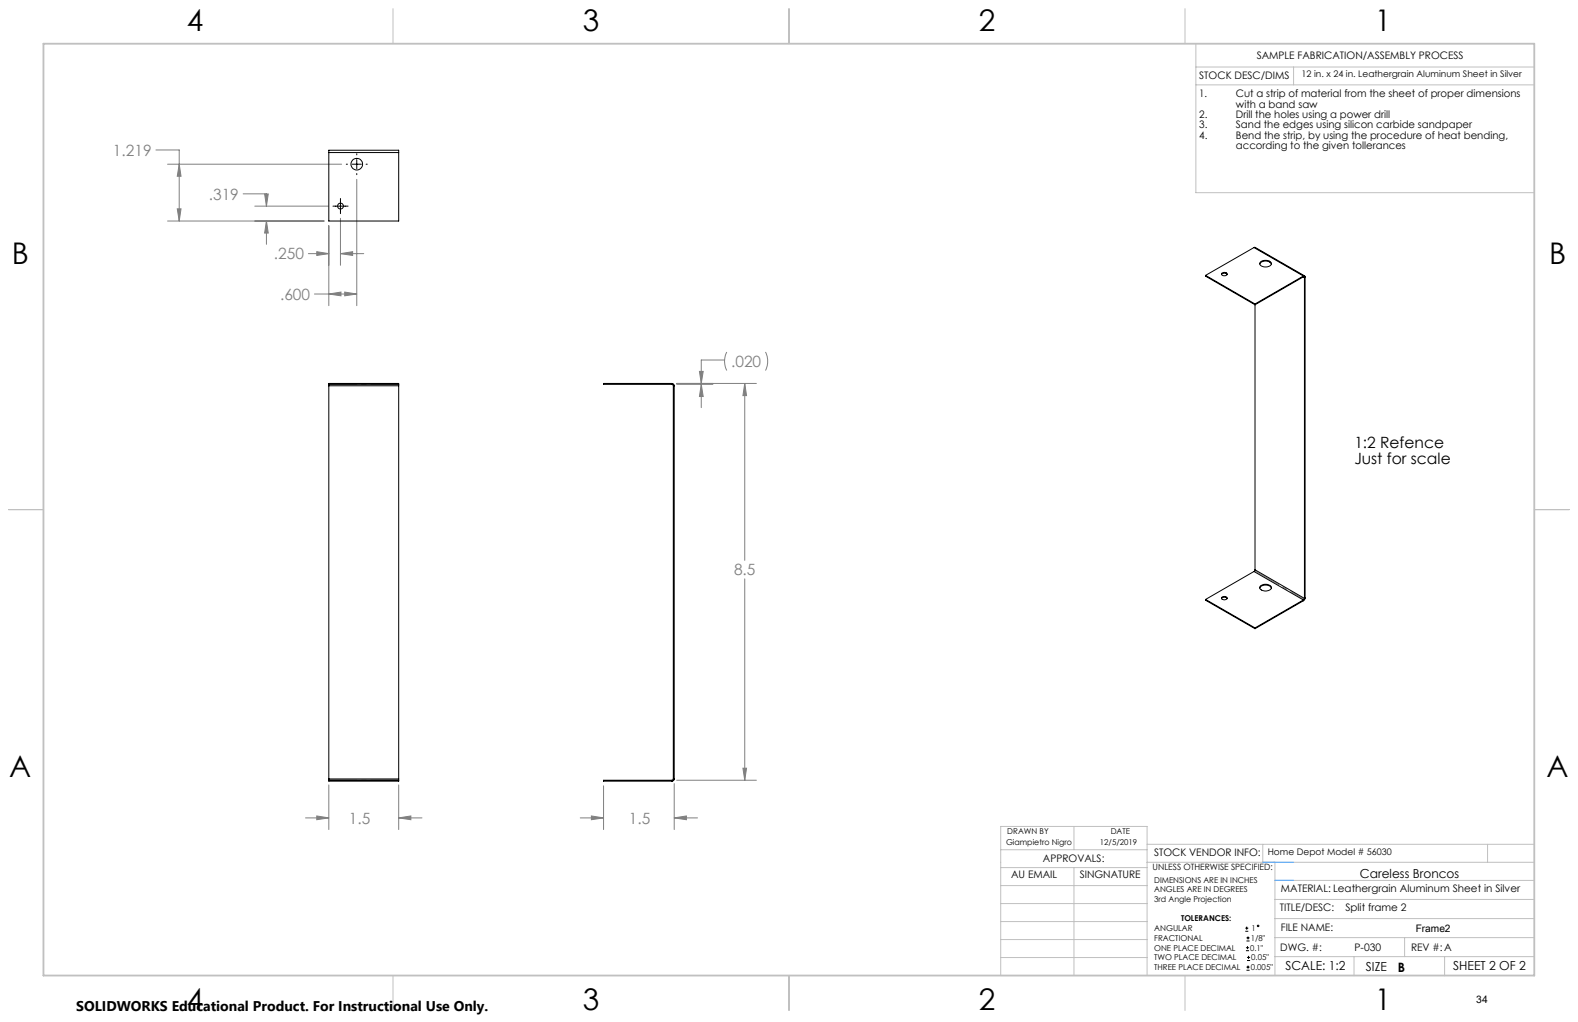
[picture p34: page 34]
Giampietro Nigro; FILE NAME:; DRAWN BY; DATE; AU EMAIL; SINGNATURE

12 in. x 24 in. Leathergrain Aluminum Sheet in Silver

1. Cut a strip of material from the sheet of proper dimensions
with a band saw
2. Drill the holes using a power drill
3. Sand the edges using silicon carbide sandpaper
4. Bend the strip, by using the procedure of heat bending,
according to the given tollerances

1:2 Refence
Just for scale

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

DIMENSIONS ARE IN INCHES

Leathergrain Aluminum Sheet in Silver
Split frame 2

SCALE: 1:2 | | SHEET 2 OF 2

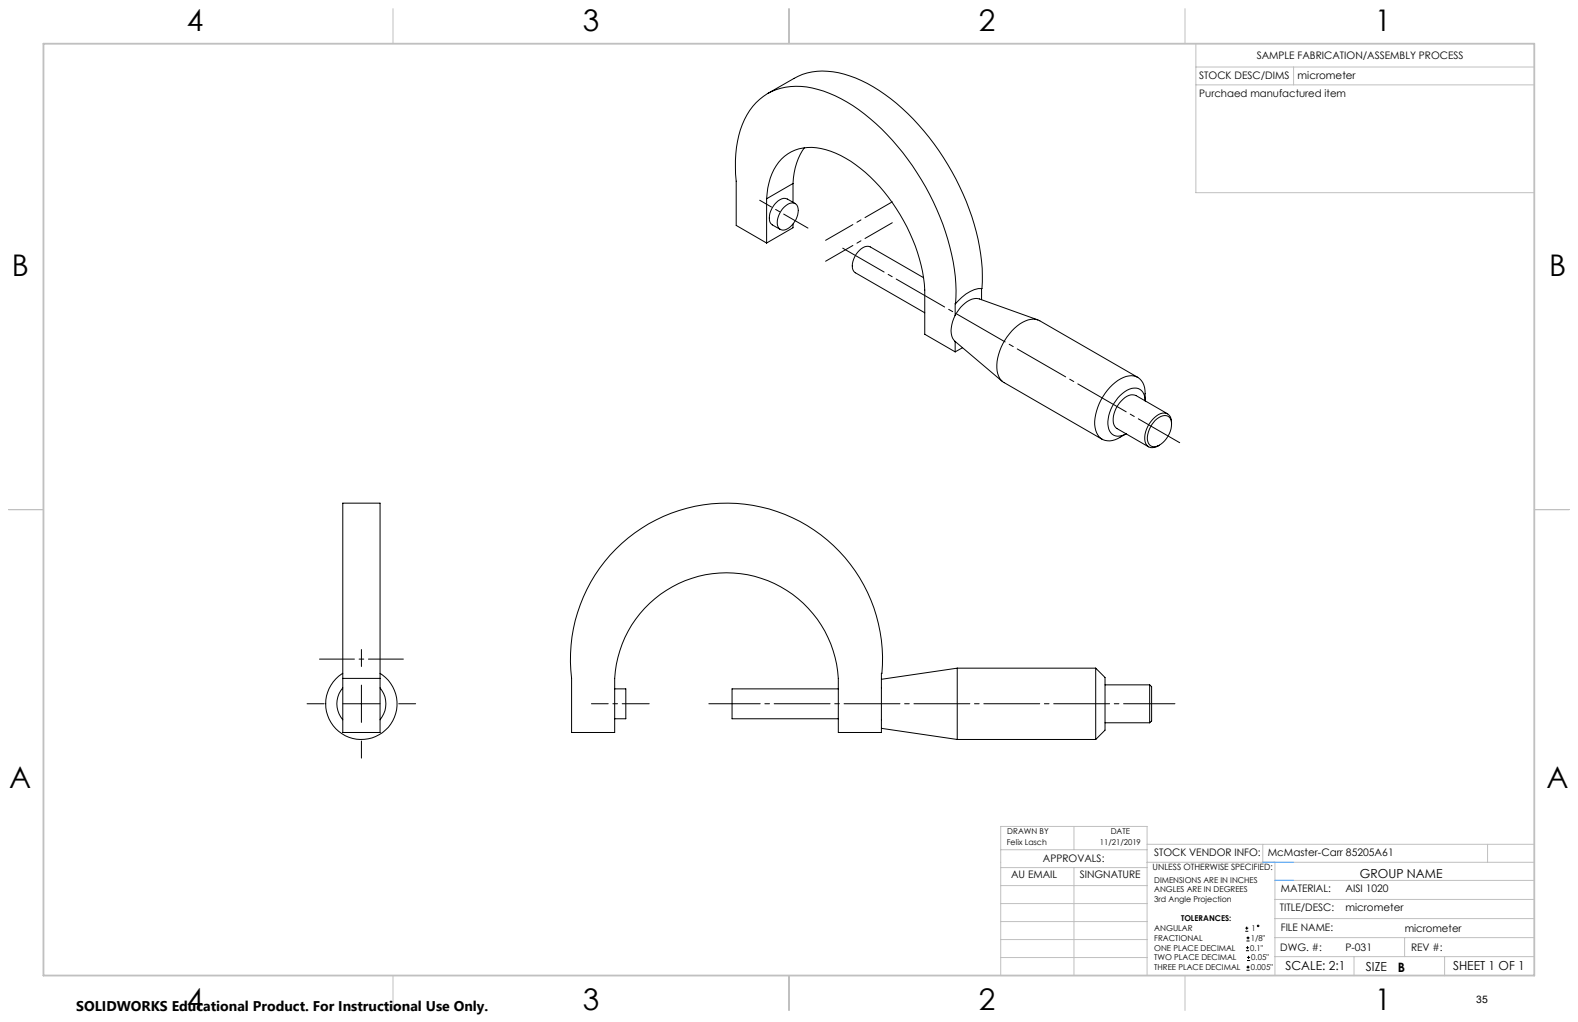
[picture p35: page 35]
AISI 1020; Felix Lasch; FILE NAME:; DRAWN BY; DATE; SCALE: 2:1; SHEET 1 OF 1; AU EMAIL; SINGNATURE

Purchaed manufactured item

STOCK VENDOR INFO: | McMaster-Carr 85205A61
UNLESS OTHERWISE SPECIFIED: ANGLES ARE IN DEGREES 3rd Angle Projection TOLERANCES: ANGULAR 1 | | GROUP NAME

DIMENSIONS ARE IN INCHES

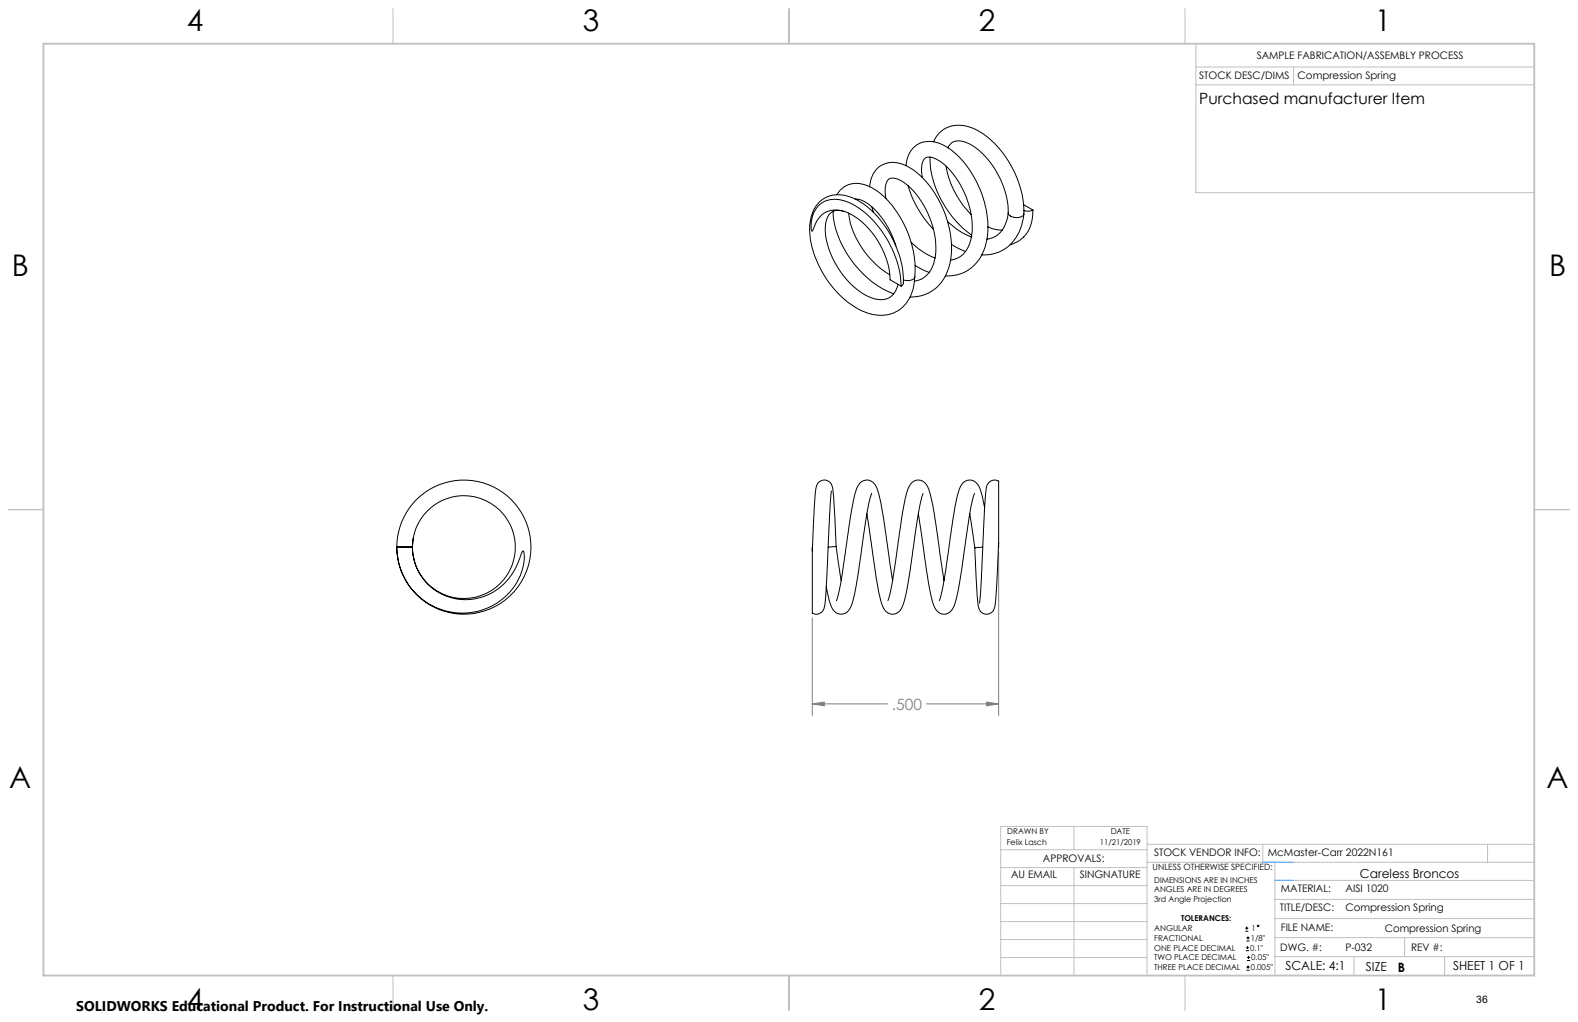
[picture p36: page 36]
Compression Spring; AISI 1020; Felix Lasch; FILE NAME:; DRAWN BY; DATE; SCALE: 4:1; SHEET 1 OF 1; AU EMAIL; SINGNATURE

Purchased manufacturer Item

STOCK VENDOR INFO: | McMaster-Carr 2022N161
UNLESS OTHERWISE SPECIFIED: ANGLES ARE IN DEGREES 3rd Angle Projection TOLERANCES: ANGULAR 1 | | Careless Broncos

DIMENSIONS ARE IN INCHES

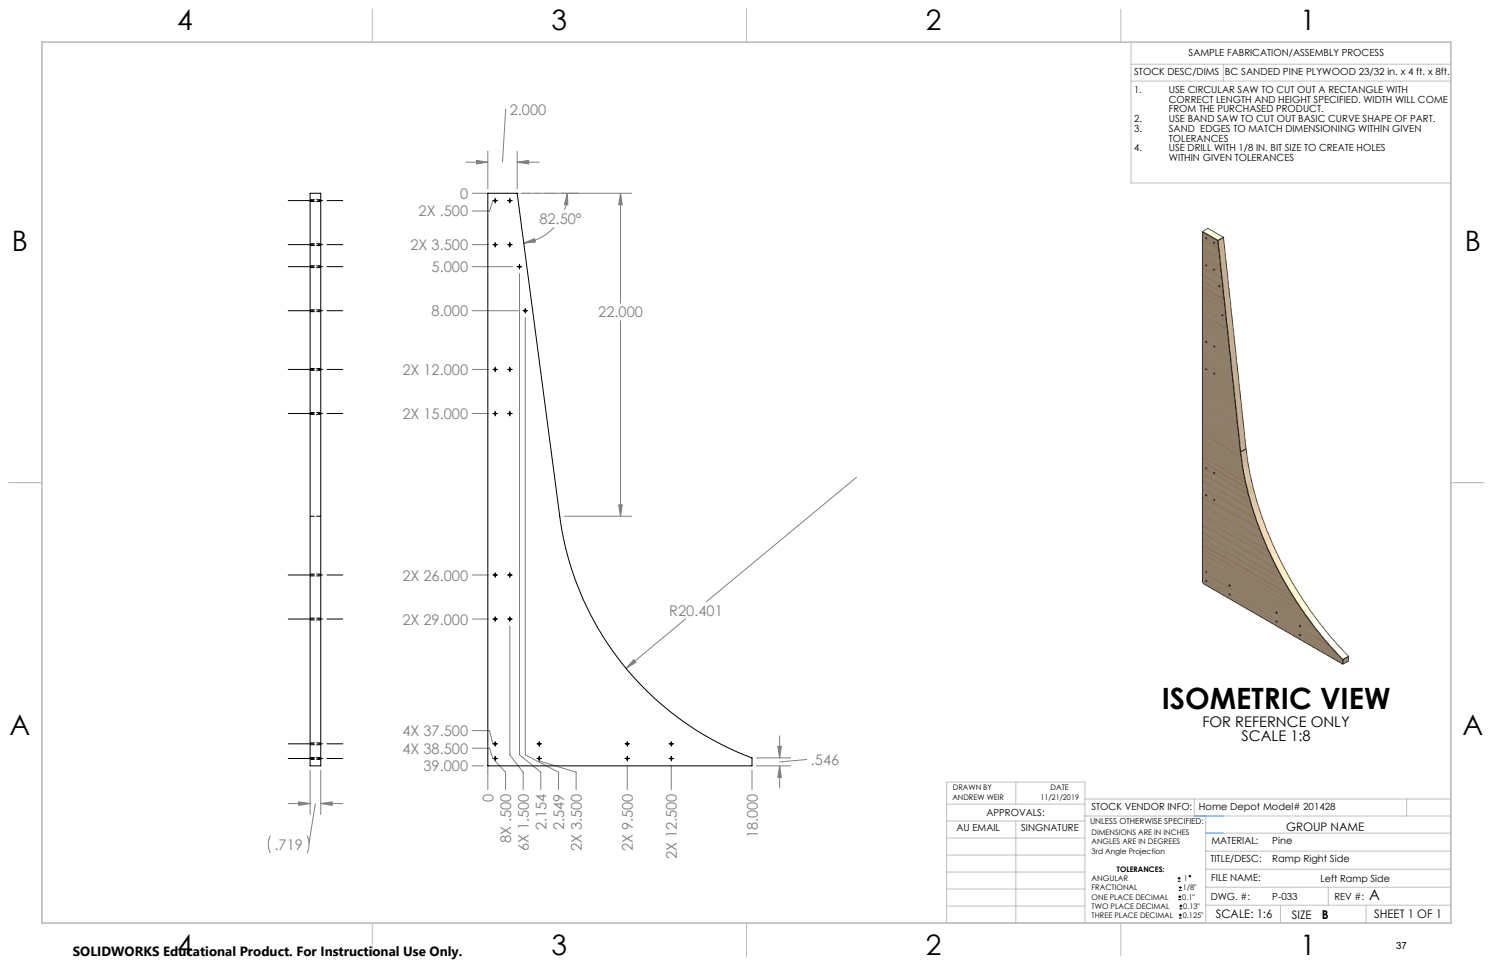
[picture p37: page 37]
ANDREW WEIR; FILE NAME:; DRAWN BY; DATE; AU EMAIL; SINGNATURE

BC SANDED PINE PLYWOOD 23/32 in. x 4 ft. x 8ft.

1. USE CIRCULAR SAW TO CUT OUT A RECTANGLE WITH
CORRECT LENGTH AND HEIGHT SPECIFIED. WIDTH WILL COME
FROM THE PURCHASED PRODUCT.
2. USE BAND SAW TO CUT OUT BASIC CURVE SHAPE OF PART.
3. SAND EDGES TO MATCH DIMENSIONING WITHIN GIVEN
TOLERANCES
4. USE DRILL WITH 1/8 IN. BIT SIZE TO CREATE HOLES
WITHIN GIVEN TOLERANCES

ISOMETRIC VIEW
FOR REFERNCE ONLY
SCALE 1:8

STOCK VENDOR INFO: | Home Depot Model# 201428
UNLESS OTHERWISE SPECIFIED: ANGLES ARE IN DEGREES 3rd Angle Projection TOLERANCES: ANGULAR 1 | | GROUP NAME

DIMENSIONS ARE IN INCHES

Pine
Ramp Right Side

Left Ramp Side

REV #: A

SCALE: 1:6 | | SHEET 1 OF 1

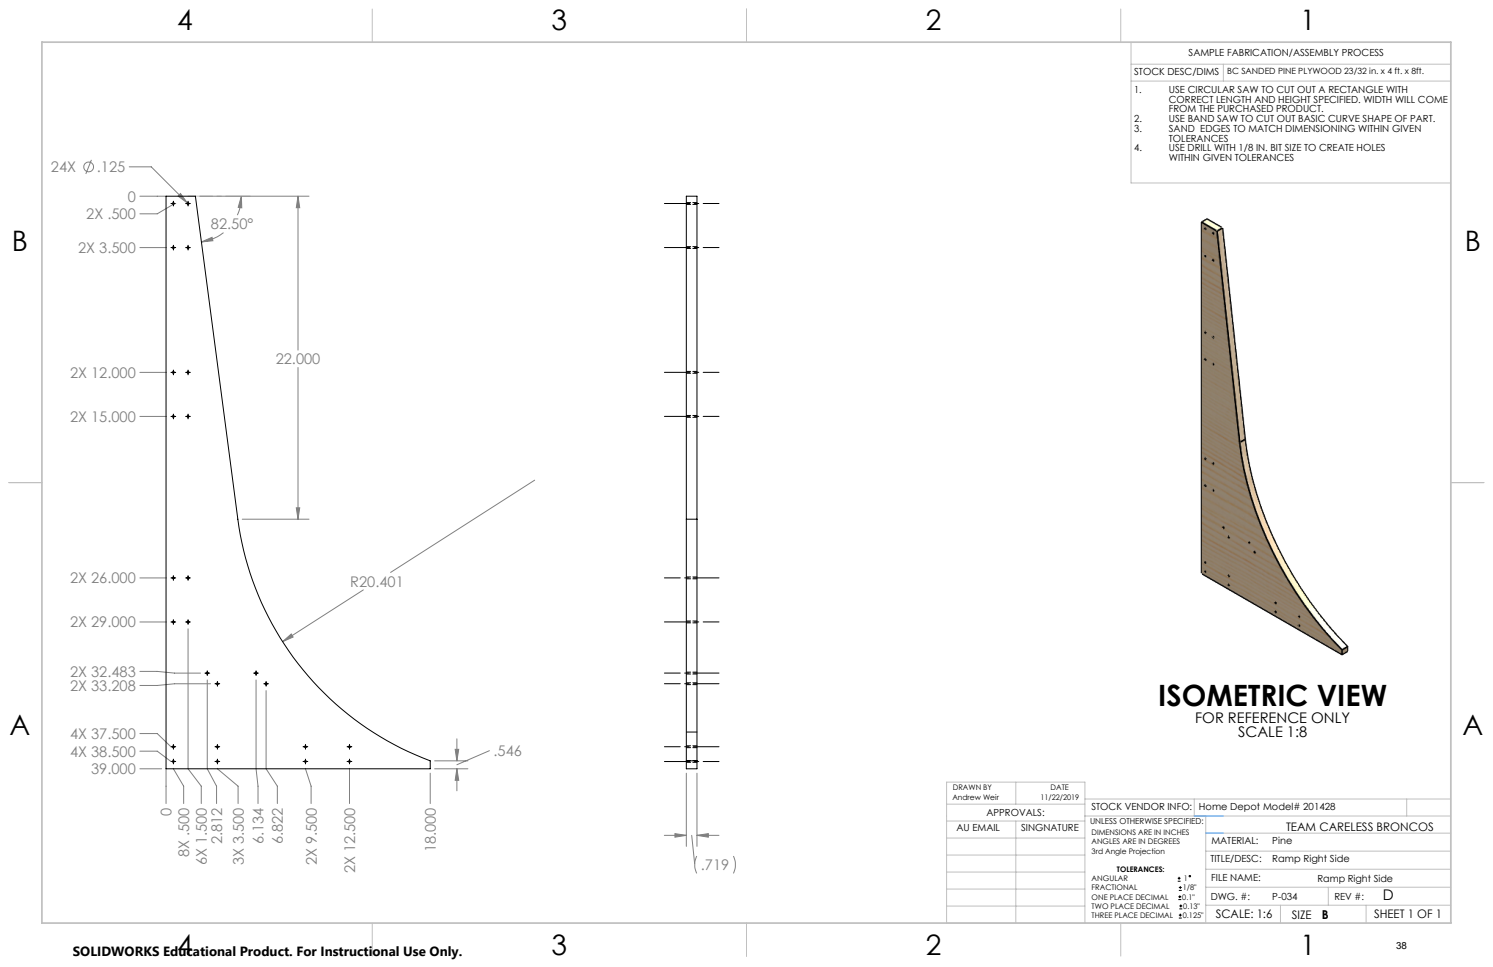
[picture p38: page 38]
Andrew Weir; FILE NAME:; DRAWN BY; DATE; AU EMAIL; SINGNATURE

BC SANDED PINE PLYWOOD 23/32 in. x 4 ft. x 8ft.

1. USE CIRCULAR SAW TO CUT OUT A RECTANGLE WITH
CORRECT LENGTH AND HEIGHT SPECIFIED. WIDTH WILL COME
FROM THE PURCHASED PRODUCT.
2. USE BAND SAW TO CUT OUT BASIC CURVE SHAPE OF PART.
3. SAND EDGES TO MATCH DIMENSIONING WITHIN GIVEN
TOLERANCES
4. USE DRILL WITH 1/8 IN. BIT SIZE TO CREATE HOLES
WITHIN GIVEN TOLERANCES

ISOMETRIC VIEW
FOR REFERENCE ONLY
SCALE 1:8

STOCK VENDOR INFO: | Home Depot Model# 201428
UNLESS OTHERWISE SPECIFIED: ANGLES ARE IN DEGREES 3rd Angle Projection TOLERANCES: ANGULAR 1 | | TEAM CARELESS BRONCOS

DIMENSIONS ARE IN INCHES

Pine
Ramp Right Side

SCALE: 1:6 | | SHEET 1 OF 1

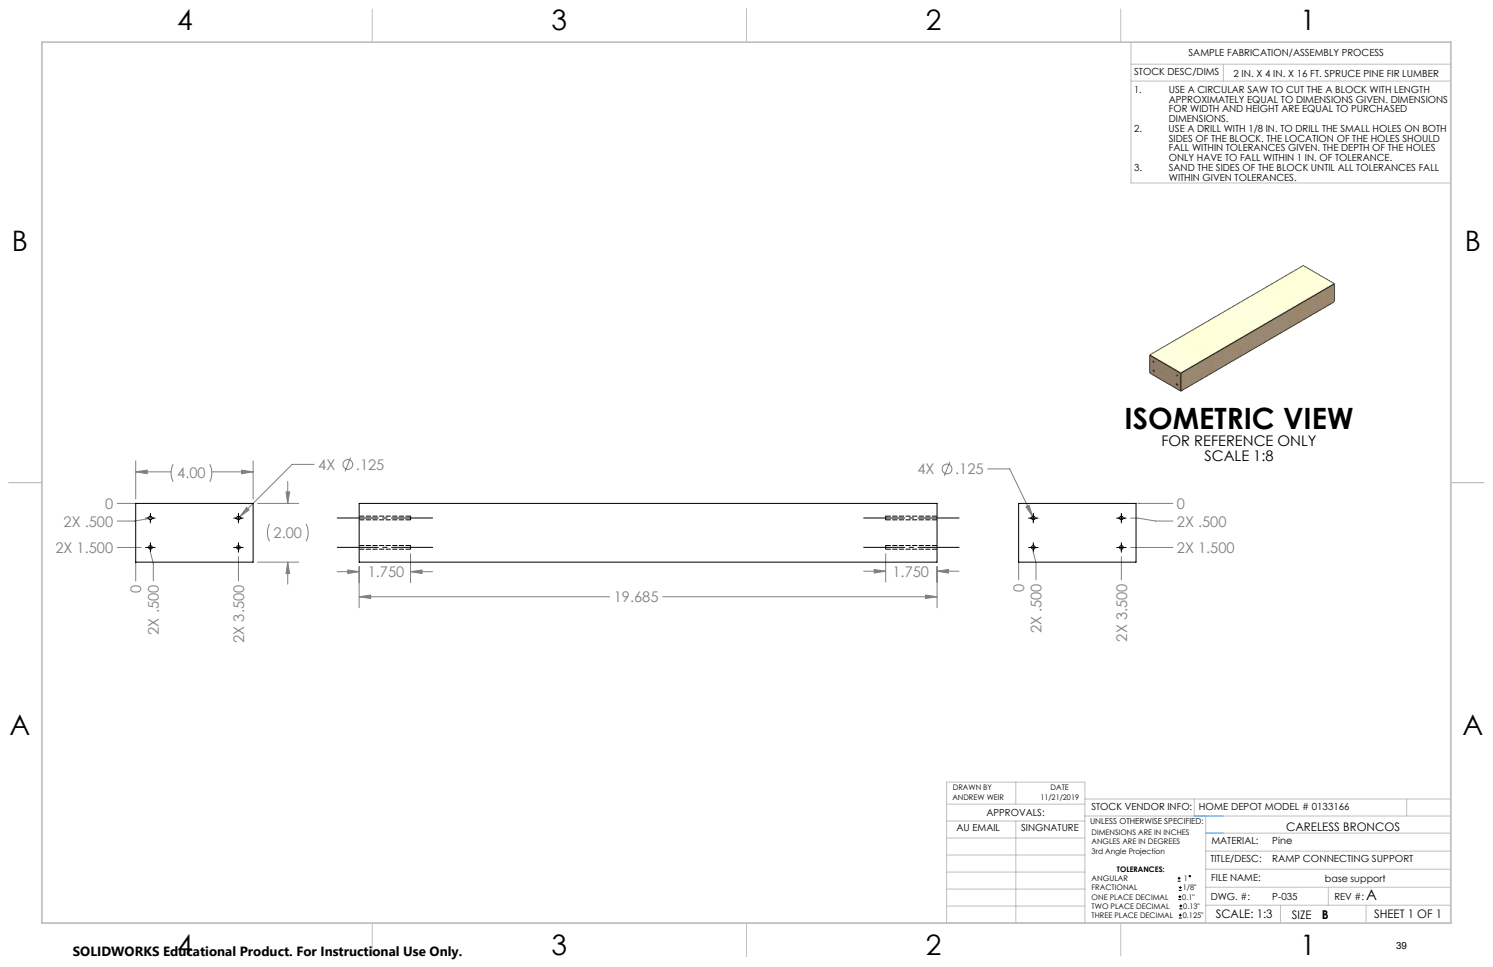
[picture p39: page 39]
ANDREW WEIR; FILE NAME:; DRAWN BY; DATE; base support; AU EMAIL; SINGNATURE

2 IN. X 4 IN. X 16 FT. SPRUCE PINE FIR LUMBER

1. USE A CIRCULAR SAW TO CUT THE A BLOCK WITH LENGTH
APPROXIMATELY EQUAL TO DIMENSIONS GIVEN. DIMENSIONS
FOR WIDTH AND HEIGHT ARE EQUAL TO PURCHASED
DIMENSIONS.
2. USE A DRILL WITH 1/8 IN. TO DRILL THE SMALL HOLES ON BOTH
SIDES OF THE BLOCK. THE LOCATION OF THE HOLES SHOULD
FALL WITHIN TOLERANCES GIVEN. THE DEPTH OF THE HOLES
ONLY HAVE TO FALL WITHIN 1 IN. OF TOLERANCE.
3. SAND THE SIDES OF THE BLOCK UNTIL ALL TOLERANCES FALL
WITHIN GIVEN TOLERANCES.

ISOMETRIC VIEW
FOR REFERENCE ONLY
SCALE 1:8

STOCK VENDOR INFO: | HOME DEPOT MODEL # 0133166
UNLESS OTHERWISE SPECIFIED: ANGLES ARE IN DEGREES 3rd Angle Projection TOLERANCES: ANGULAR 1 | | CARELESS BRONCOS

DIMENSIONS ARE IN INCHES

Pine
RAMP CONNECTING SUPPORT

SCALE: 1:3 | | SHEET 1 OF 1

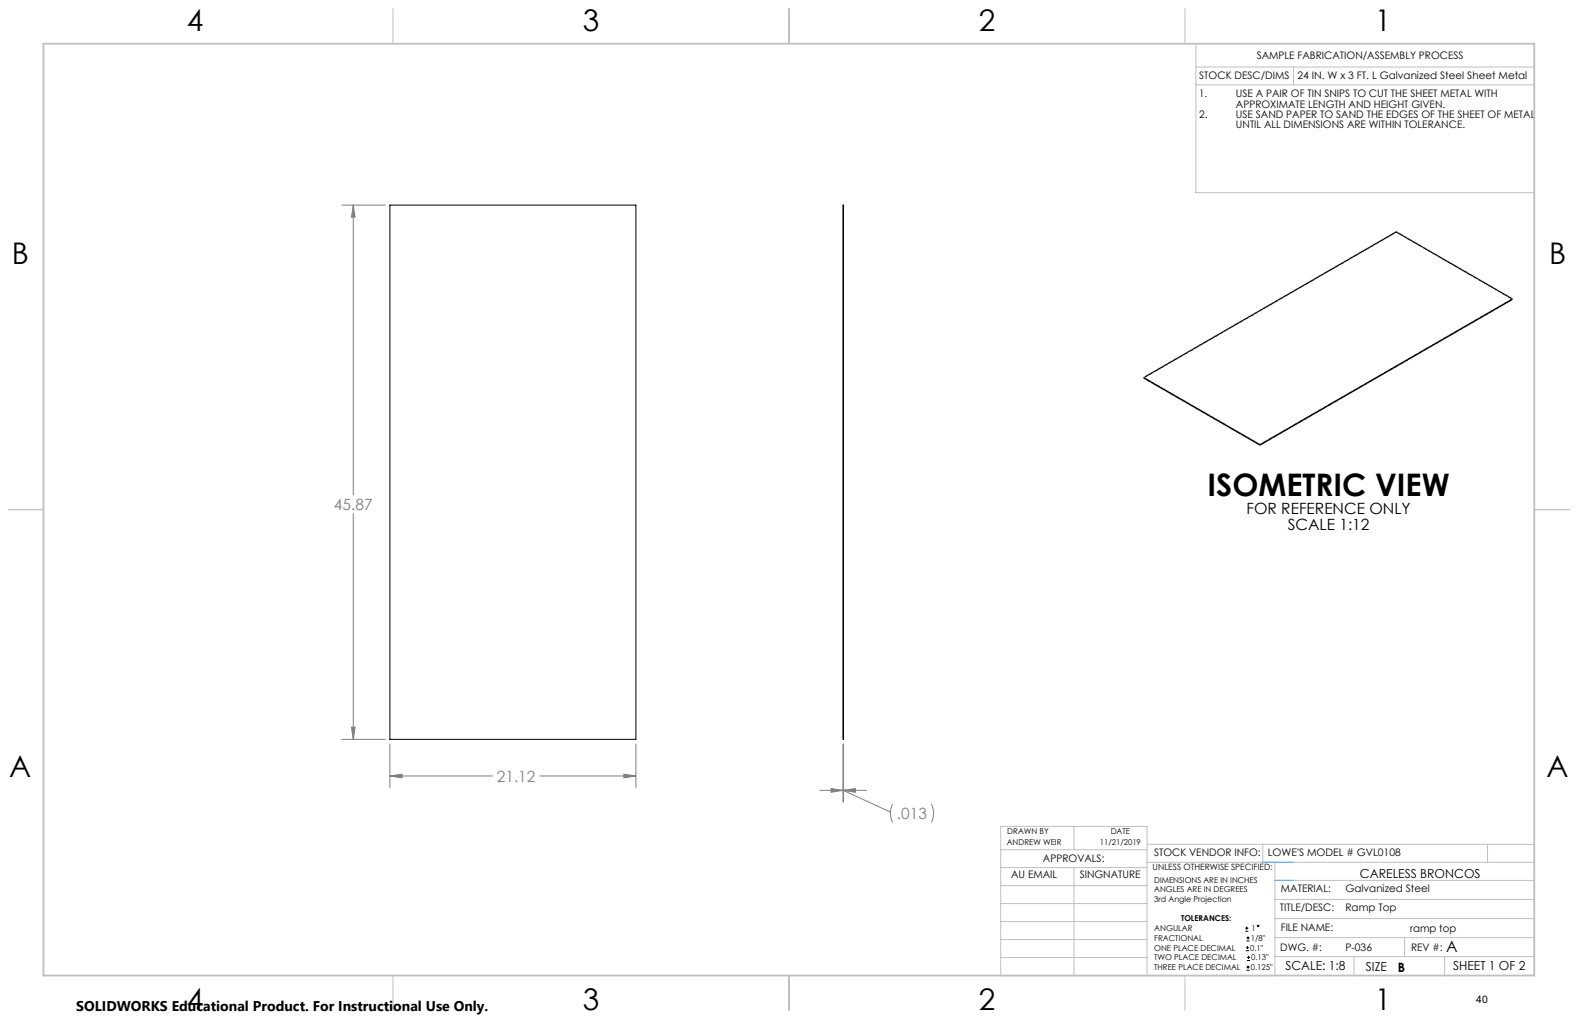
[picture p40: page 40]
Ramp Top; Galvanized Steel; ANDREW WEIR; FILE NAME:; DRAWN BY; DATE; ramp top; AU EMAIL; SINGNATURE

24 IN. W x 3 FT. L Galvanized Steel Sheet Metal

1. USE A PAIR OF TIN SNIPS TO CUT THE SHEET METAL WITH
APPROXIMATE LENGTH AND HEIGHT GIVEN.
2. USE SAND PAPER TO SAND THE EDGES OF THE SHEET OF METAL
UNTIL ALL DIMENSIONS ARE WITHIN TOLERANCE.

ISOMETRIC VIEW
FOR REFERENCE ONLY
SCALE 1:12

STOCK VENDOR INFO: | LOWE'S MODEL # GVL0108
UNLESS OTHERWISE SPECIFIED: ANGLES ARE IN DEGREES 3rd Angle Projection TOLERANCES: ANGULAR 1 | | CARELESS BRONCOS

DIMENSIONS ARE IN INCHES

SCALE: 1:8 | | SHEET 1 OF 2

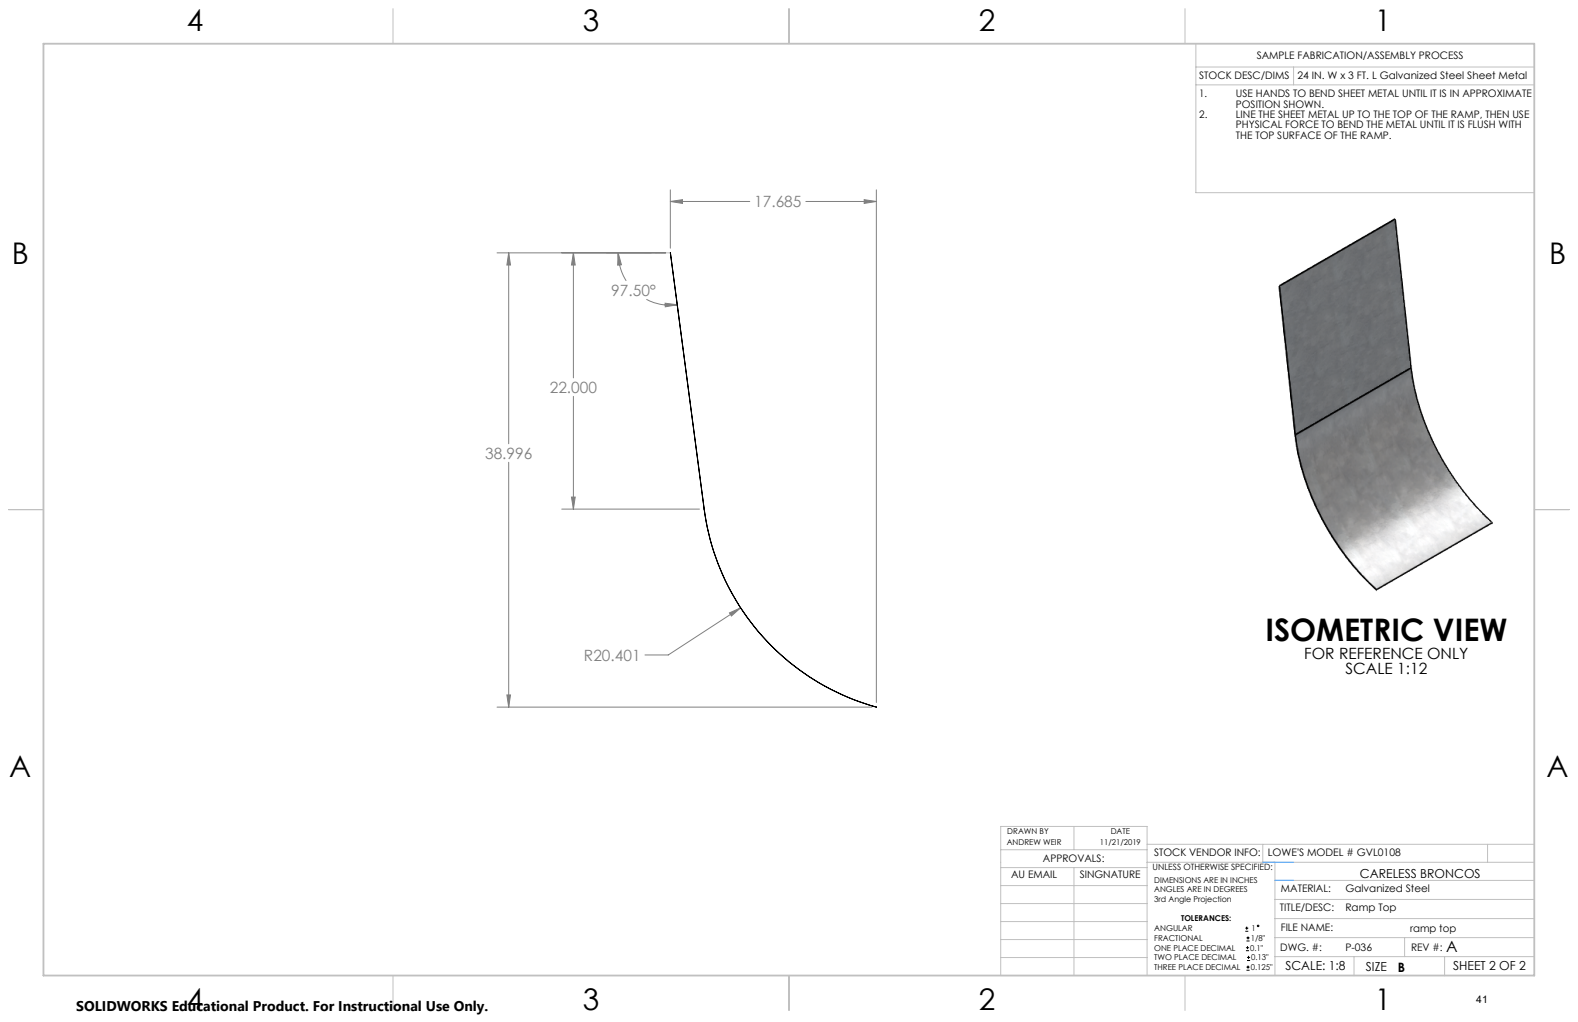
[picture p41: page 41]
Ramp Top; Galvanized Steel; ANDREW WEIR; FILE NAME:; DRAWN BY; DATE; ramp top; AU EMAIL; SINGNATURE

24 IN. W x 3 FT. L Galvanized Steel Sheet Metal

1. USE HANDS TO BEND SHEET METAL UNTIL IT IS IN APPROXIMATE
POSITION SHOWN.
2. LINE THE SHEET METAL UP TO THE TOP OF THE RAMP, THEN USE
PHYSICAL FORCE TO BEND THE METAL UNTIL IT IS FLUSH WITH
THE TOP SURFACE OF THE RAMP.

ISOMETRIC VIEW
FOR REFERENCE ONLY
SCALE 1:12

STOCK VENDOR INFO: | LOWE'S MODEL # GVL0108
UNLESS OTHERWISE SPECIFIED: ANGLES ARE IN DEGREES 3rd Angle Projection TOLERANCES: ANGULAR 1 | | CARELESS BRONCOS

DIMENSIONS ARE IN INCHES

SCALE: 1:8 | | SHEET 2 OF 2

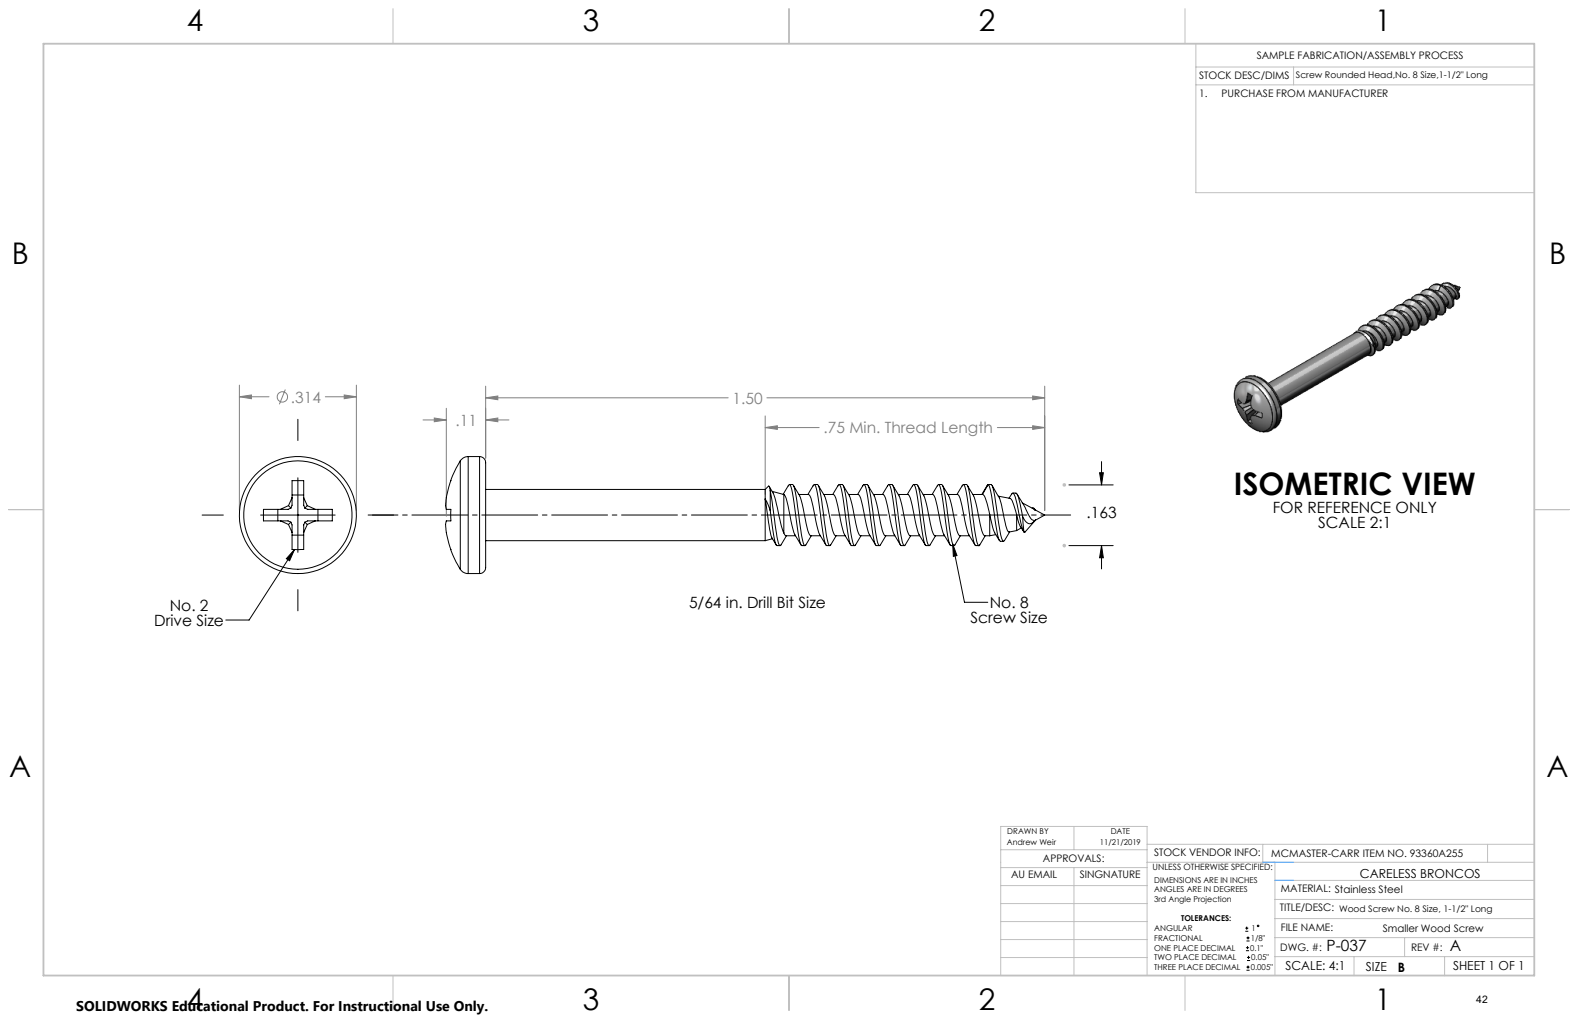
[picture p42: page 42]
No. 8 Screw Size; No. 2 Drive Size; Andrew Weir; FILE NAME:; DRAWN BY; DATE; AU EMAIL; SINGNATURE

Screw Rounded Head,No. 8 Size,1-1/2" Long

1. PURCHASE FROM MANUFACTURER

.75 Min. Thread Length

ISOMETRIC VIEW
FOR REFERENCE ONLY
SCALE 2:1

5/64 in. Drill Bit Size

STOCK VENDOR INFO: | MCMASTER-CARR ITEM NO. 93360A255
UNLESS OTHERWISE SPECIFIED: ANGLES ARE IN DEGREES 3rd Angle Projection TOLERANCES: ANGULAR 1 | | CARELESS BRONCOS

DIMENSIONS ARE IN INCHES

Stainless Steel
Wood Screw No. 8 Size, 1-1/2" Long

Smaller Wood Screw

P-037 | REV #: A
SCALE: 4:1 | | SHEET 1 OF 1

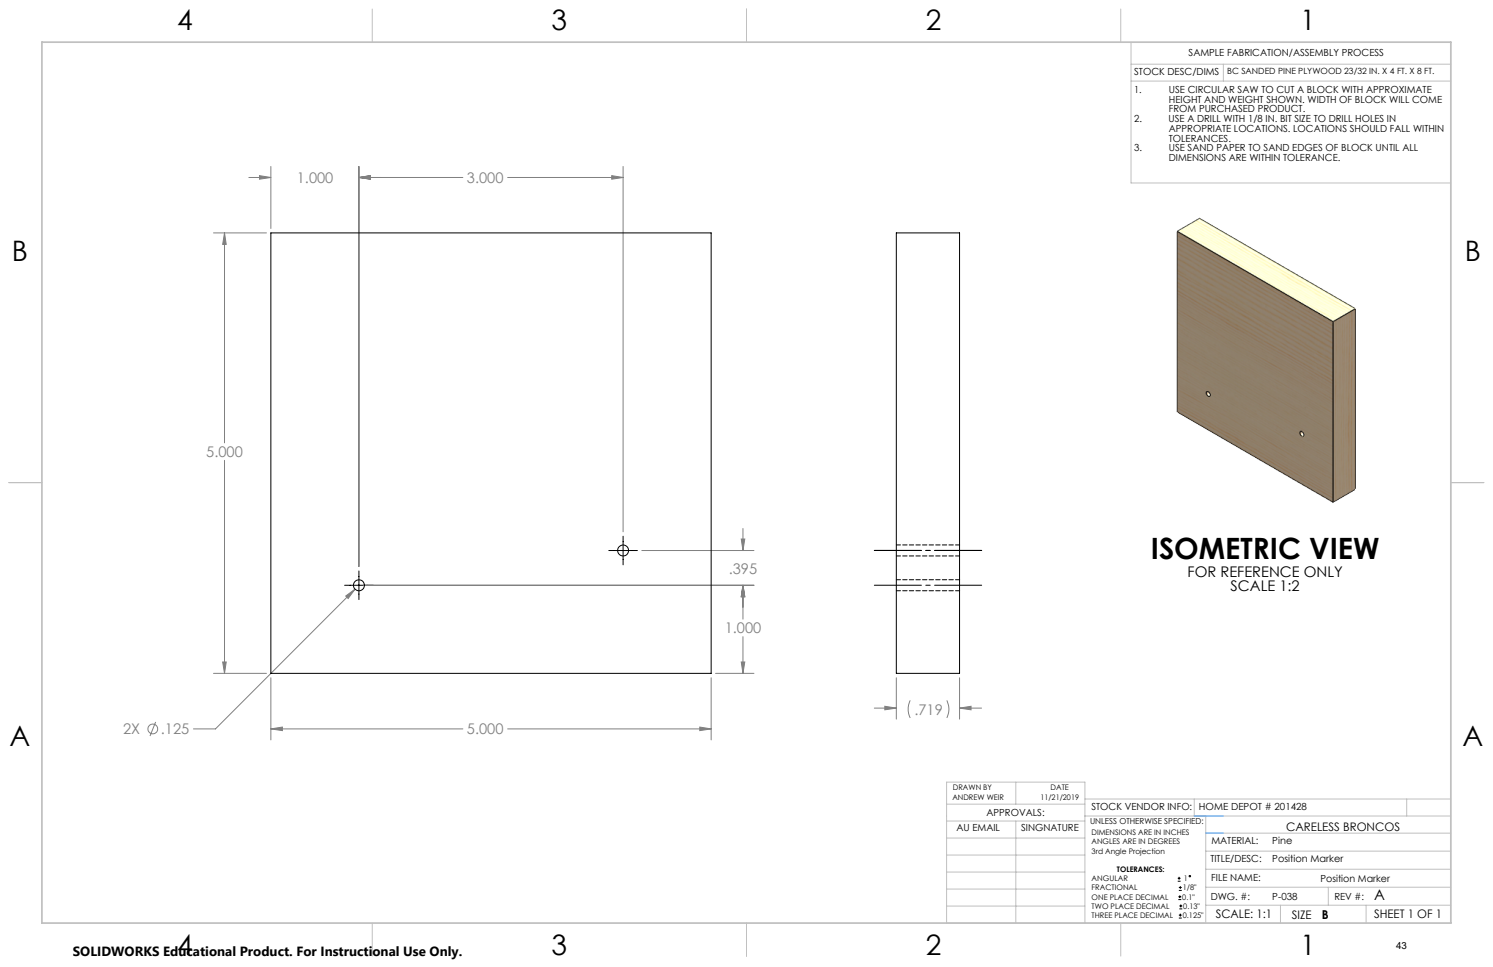
[picture p43: page 43]
Position Marker; ANDREW WEIR; FILE NAME:; DRAWN BY; DATE; AU EMAIL; SINGNATURE

BC SANDED PINE PLYWOOD 23/32 IN. X 4 FT. X 8 FT.

1. USE CIRCULAR SAW TO CUT A BLOCK WITH APPROXIMATE
HEIGHT AND WEIGHT SHOWN. WIDTH OF BLOCK WILL COME
FROM PURCHASED PRODUCT.
2. USE A DRILL WITH 1/8 IN. BIT SIZE TO DRILL HOLES IN
APPROPRIATE LOCATIONS. LOCATIONS SHOULD FALL WITHIN
TOLERANCES.
3. USE SAND PAPER TO SAND EDGES OF BLOCK UNTIL ALL
DIMENSIONS ARE WITHIN TOLERANCE.

ISOMETRIC VIEW
FOR REFERENCE ONLY
SCALE 1:2

STOCK VENDOR INFO: | HOME DEPOT # 201428
UNLESS OTHERWISE SPECIFIED: ANGLES ARE IN DEGREES 3rd Angle Projection TOLERANCES: ANGULAR 1 | | CARELESS BRONCOS

DIMENSIONS ARE IN INCHES

REV #: A

SCALE: 1:1 | | SHEET 1 OF 1

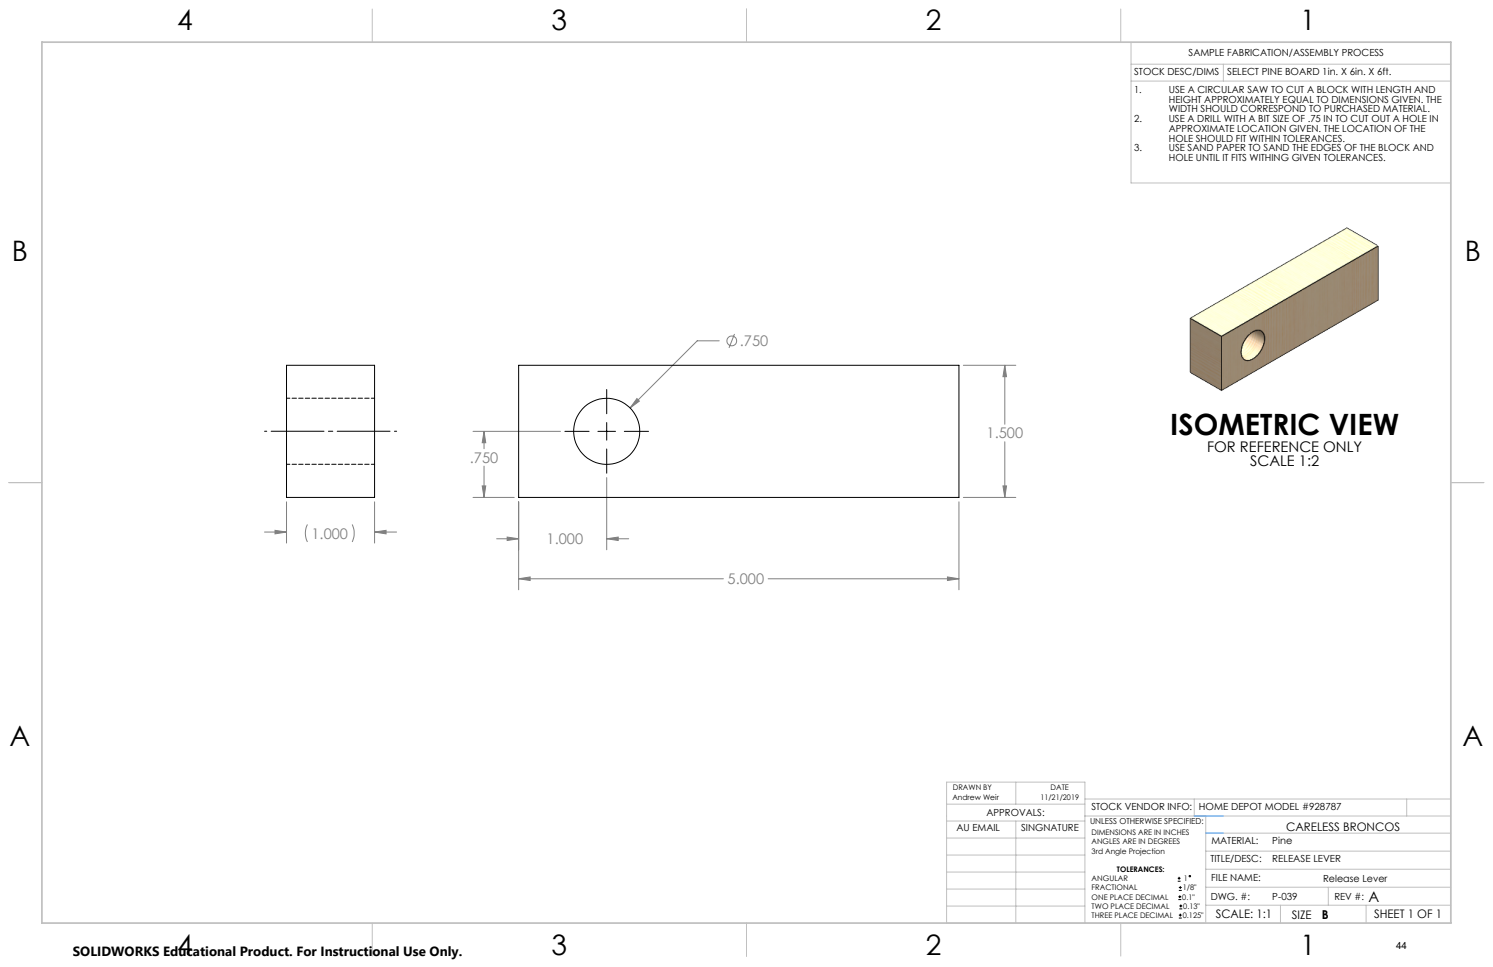
[picture p44: page 44]
RELEASE LEVER; Andrew Weir; FILE NAME:; DRAWN BY; DATE; Release Lever; AU EMAIL; SINGNATURE

SELECT PINE BOARD 1in. X 6in. X 6ft.

1. USE A CIRCULAR SAW TO CUT A BLOCK WITH LENGTH AND
HEIGHT APPROXIMATELY EQUAL TO DIMENSIONS GIVEN. THE
WIDTH SHOULD CORRESPOND TO PURCHASED MATERIAL.
2. USE A DRILL WITH A BIT SIZE OF .75 IN TO CUT OUT A HOLE IN
APPROXIMATE LOCATION GIVEN. THE LOCATION OF THE
HOLE SHOULD FIT WITHIN TOLERANCES.
3. USE SAND PAPER TO SAND THE EDGES OF THE BLOCK AND
HOLE UNTIL IT FITS WITHING GIVEN TOLERANCES.

ISOMETRIC VIEW
FOR REFERENCE ONLY
SCALE 1:2

STOCK VENDOR INFO: | HOME DEPOT MODEL #928787
UNLESS OTHERWISE SPECIFIED: ANGLES ARE IN DEGREES 3rd Angle Projection TOLERANCES: ANGULAR 1 | | CARELESS BRONCOS

DIMENSIONS ARE IN INCHES

SCALE: 1:1 | | SHEET 1 OF 1

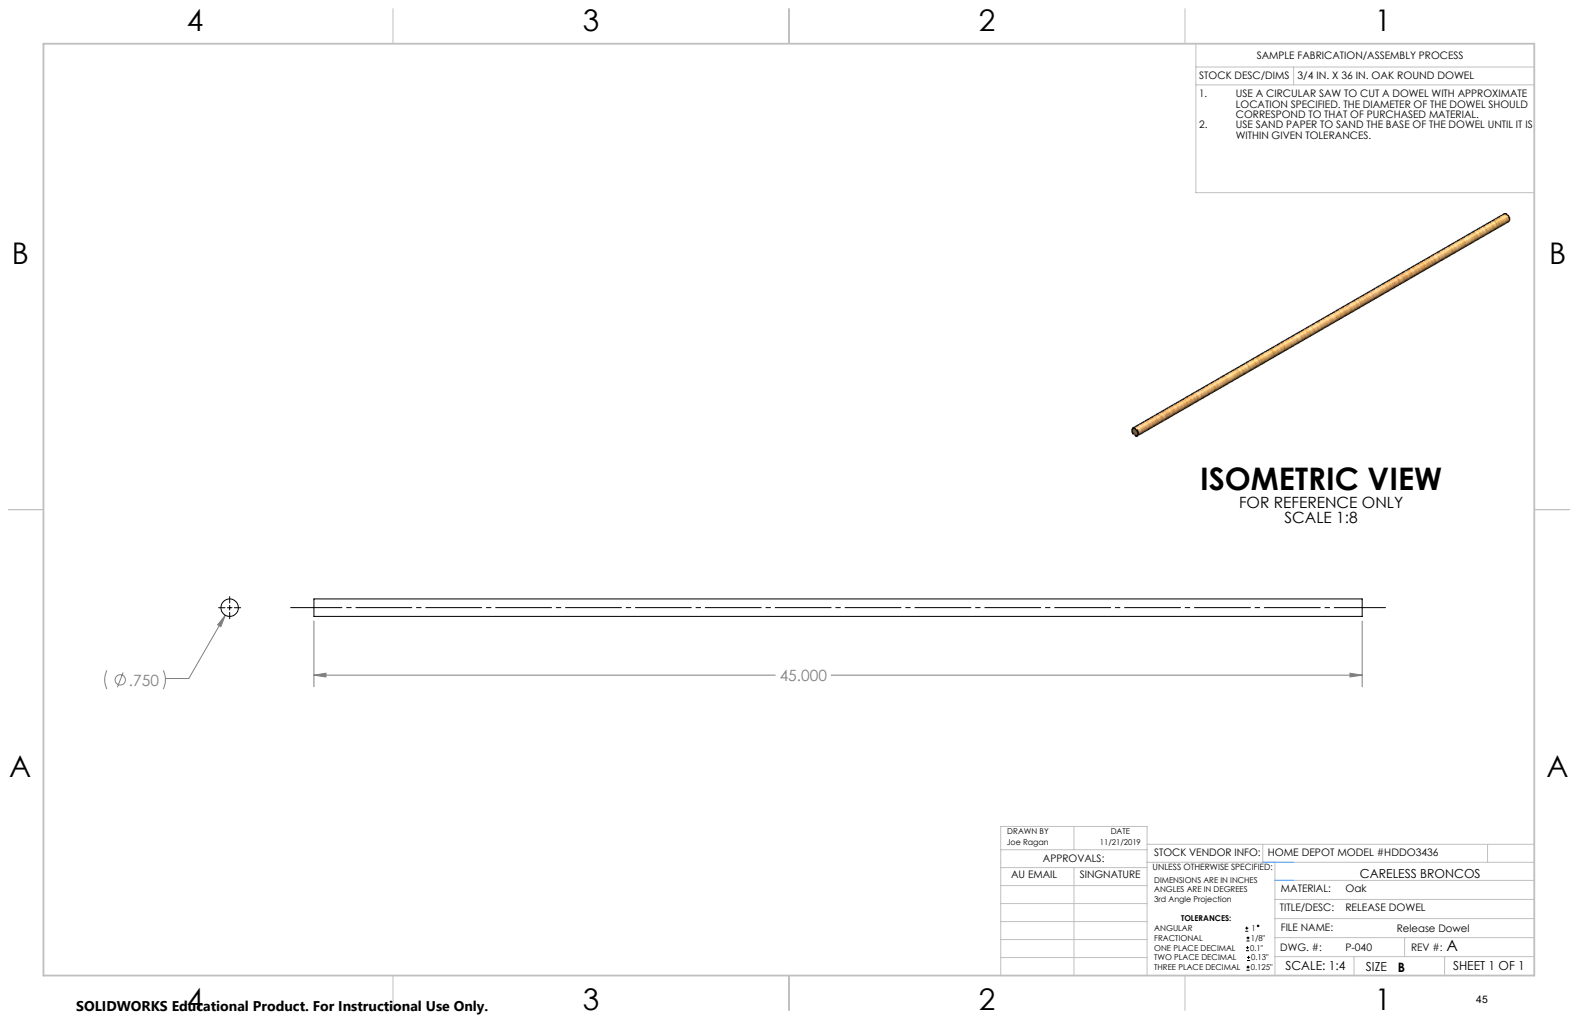
[picture p45: page 45]
RELEASE DOWEL; Joe Ragan; FILE NAME:; DRAWN BY; DATE; Release Dowel; AU EMAIL; SINGNATURE

3/4 IN. X 36 IN. OAK ROUND DOWEL

1. USE A CIRCULAR SAW TO CUT A DOWEL WITH APPROXIMATE
LOCATION SPECIFIED. THE DIAMETER OF THE DOWEL SHOULD
CORRESPOND TO THAT OF PURCHASED MATERIAL.
2. USE SAND PAPER TO SAND THE BASE OF THE DOWEL UNTIL IT IS
WITHIN GIVEN TOLERANCES.

ISOMETRIC VIEW
FOR REFERENCE ONLY
SCALE 1:8

STOCK VENDOR INFO: | HOME DEPOT MODEL #HDDO3436
UNLESS OTHERWISE SPECIFIED: ANGLES ARE IN DEGREES 3rd Angle Projection TOLERANCES: ANGULAR 1 | | CARELESS BRONCOS

DIMENSIONS ARE IN INCHES

SCALE: 1:4 | | SHEET 1 OF 1

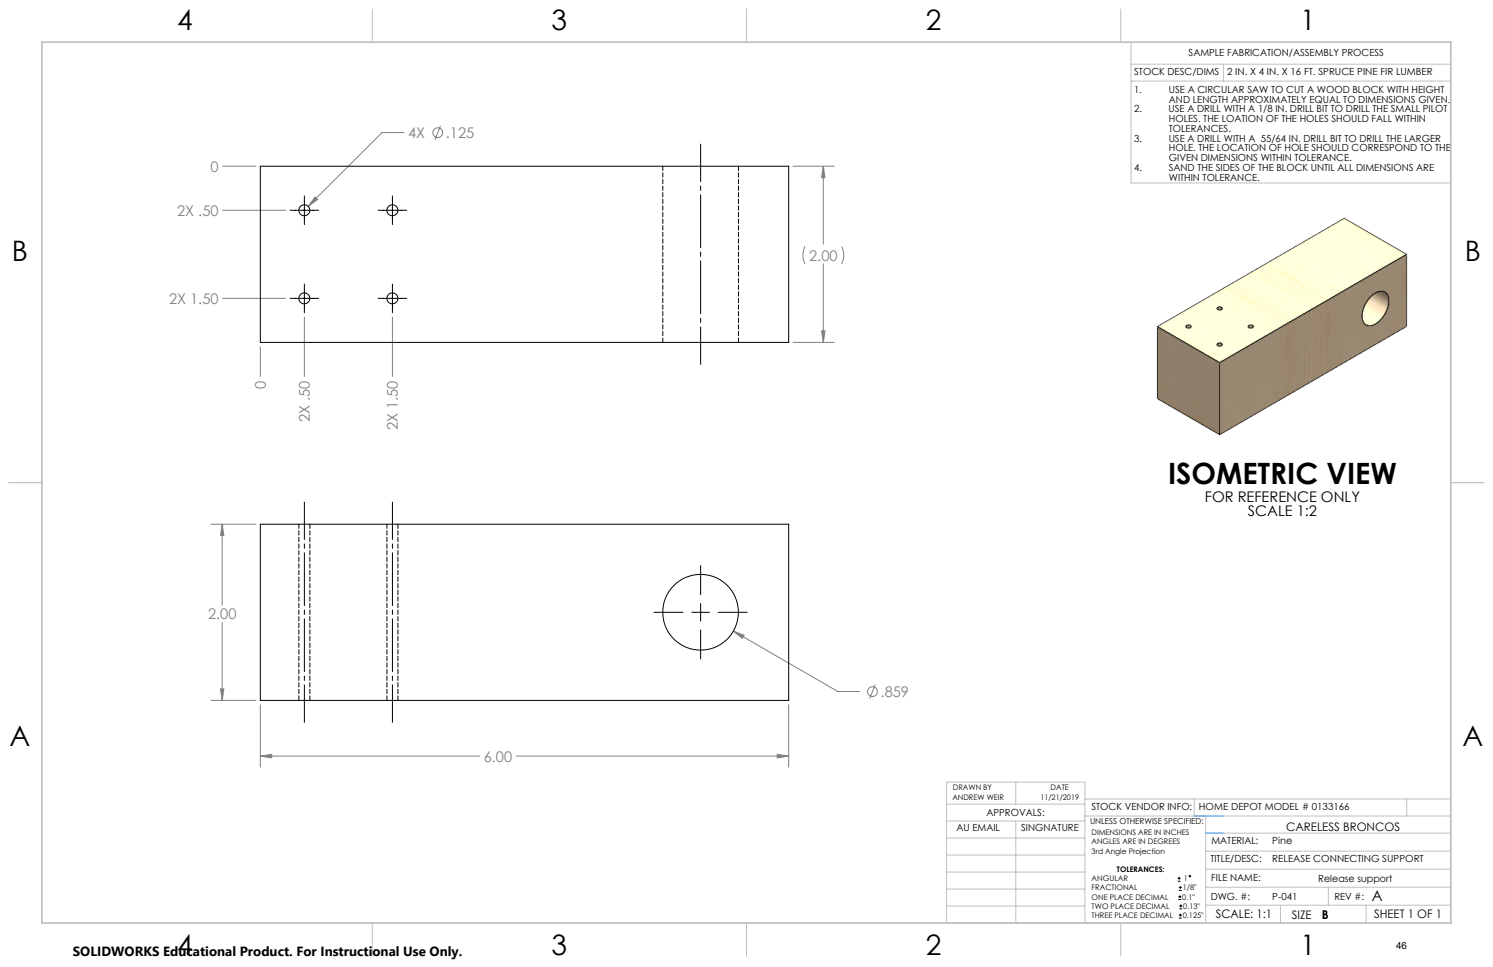
[picture p46: page 46]
ANDREW WEIR; FILE NAME:; DRAWN BY; DATE; Release support; AU EMAIL; SINGNATURE

2 IN. X 4 IN. X 16 FT. SPRUCE PINE FIR LUMBER

1. USE A CIRCULAR SAW TO CUT A WOOD BLOCK WITH HEIGHT
AND LENGTH APPROXIMATELY EQUAL TO DIMENSIONS GIVEN.
2. USE A DRILL WITH A 1/8 IN. DRILL BIT TO DRILL THE SMALL PILOT
HOLES. THE LOATION OF THE HOLES SHOULD FALL WITHIN
TOLERANCES.
3. USE A DRILL WITH A 55/64 IN. DRILL BIT TO DRILL THE LARGER
HOLE. THE LOCATION OF HOLE SHOULD CORRESPOND TO THE
GIVEN DIMENSIONS WITHIN TOLERANCE.
4. SAND THE SIDES OF THE BLOCK UNTIL ALL DIMENSIONS ARE
WITHIN TOLERANCE.

ISOMETRIC VIEW
FOR REFERENCE ONLY
SCALE 1:2

STOCK VENDOR INFO: | HOME DEPOT MODEL # 0133166
UNLESS OTHERWISE SPECIFIED: ANGLES ARE IN DEGREES 3rd Angle Projection TOLERANCES: ANGULAR 1 | | CARELESS BRONCOS

DIMENSIONS ARE IN INCHES

Pine
RELEASE CONNECTING SUPPORT

SCALE: 1:1 | | SHEET 1 OF 1

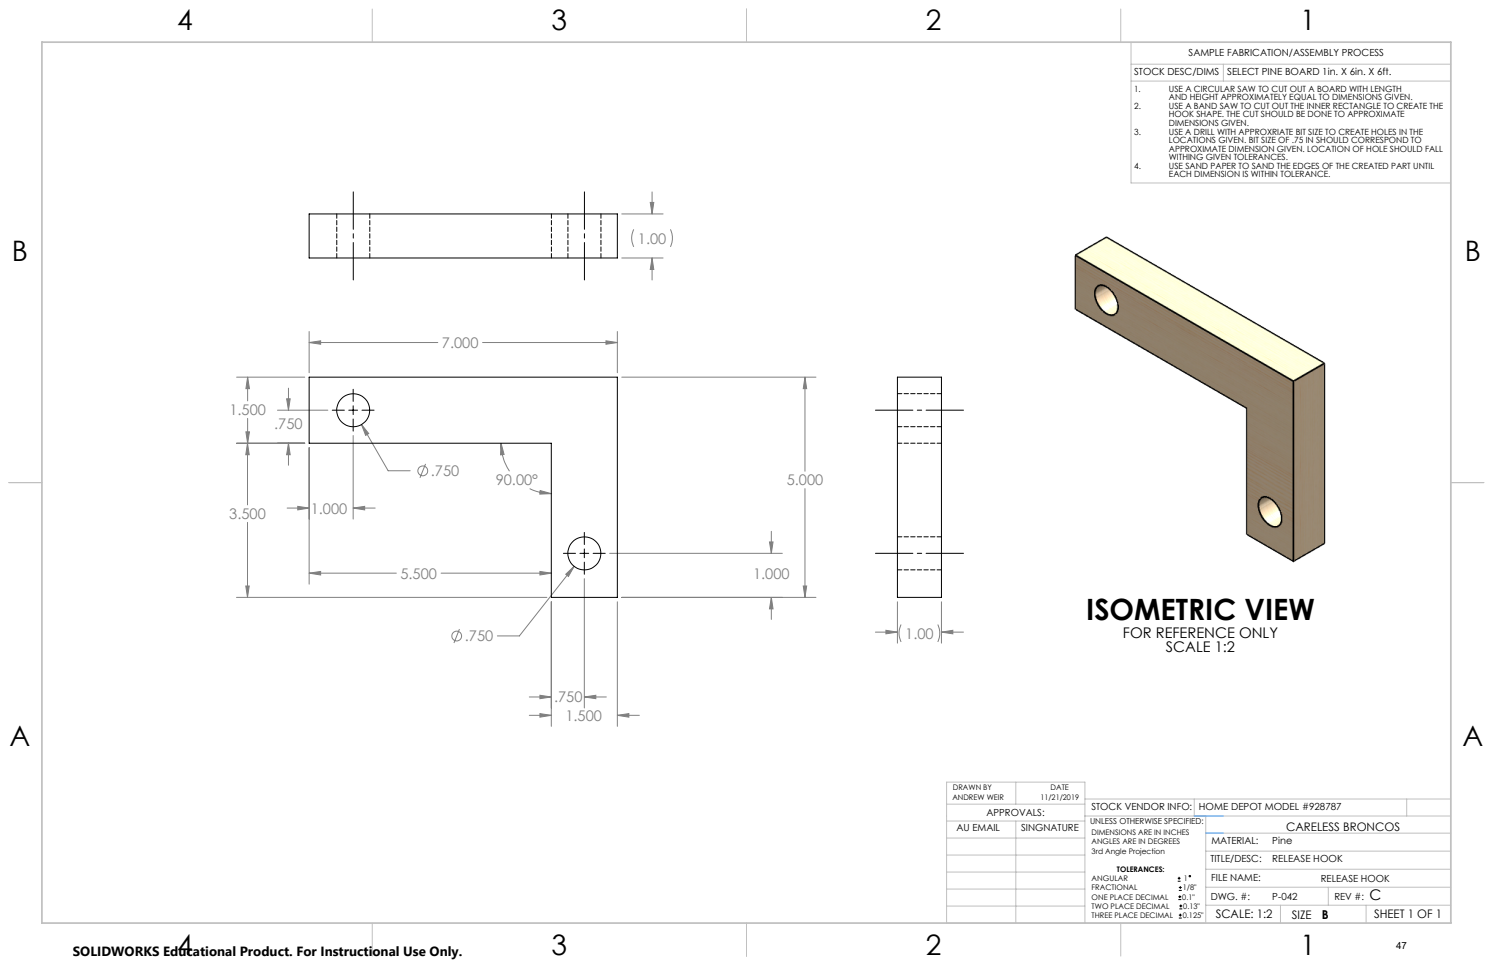
[picture p47: page 47]
RELEASE HOOK; ANDREW WEIR; FILE NAME:; DRAWN BY; DATE; AU EMAIL; SINGNATURE

SELECT PINE BOARD 1in. X 6in. X 6ft.

1. USE A CIRCULAR SAW TO CUT OUT A BOARD WITH LENGTH
AND HEIGHT APPROXIMATELY EQUAL TO DIMENSIONS GIVEN.
2. USE A BAND SAW TO CUT OUT THE INNER RECTANGLE TO CREATE THE
HOOK SHAPE. THE CUT SHOULD BE DONE TO APPROXIMATE
DIMENSIONS GIVEN.
3. USE A DRILL WITH APPROXRIATE BIT SIZE TO CREATE HOLES IN THE
LOCATIONS GIVEN. BIT SIZE OF .75 IN SHOULD CORRESPOND TO
APPROXIMATE DIMENSION GIVEN. LOCATION OF HOLE SHOULD FALL
WITHING GIVEN TOLERANCES.
4. USE SAND PAPER TO SAND THE EDGES OF THE CREATED PART UNTIL
EACH DIMENSION IS WITHIN TOLERANCE.

ISOMETRIC VIEW
FOR REFERENCE ONLY
SCALE 1:2

STOCK VENDOR INFO: | HOME DEPOT MODEL #928787
UNLESS OTHERWISE SPECIFIED: ANGLES ARE IN DEGREES 3rd Angle Projection TOLERANCES: ANGULAR 1 | | CARELESS BRONCOS

DIMENSIONS ARE IN INCHES

SCALE: 1:2 | | SHEET 1 OF 1

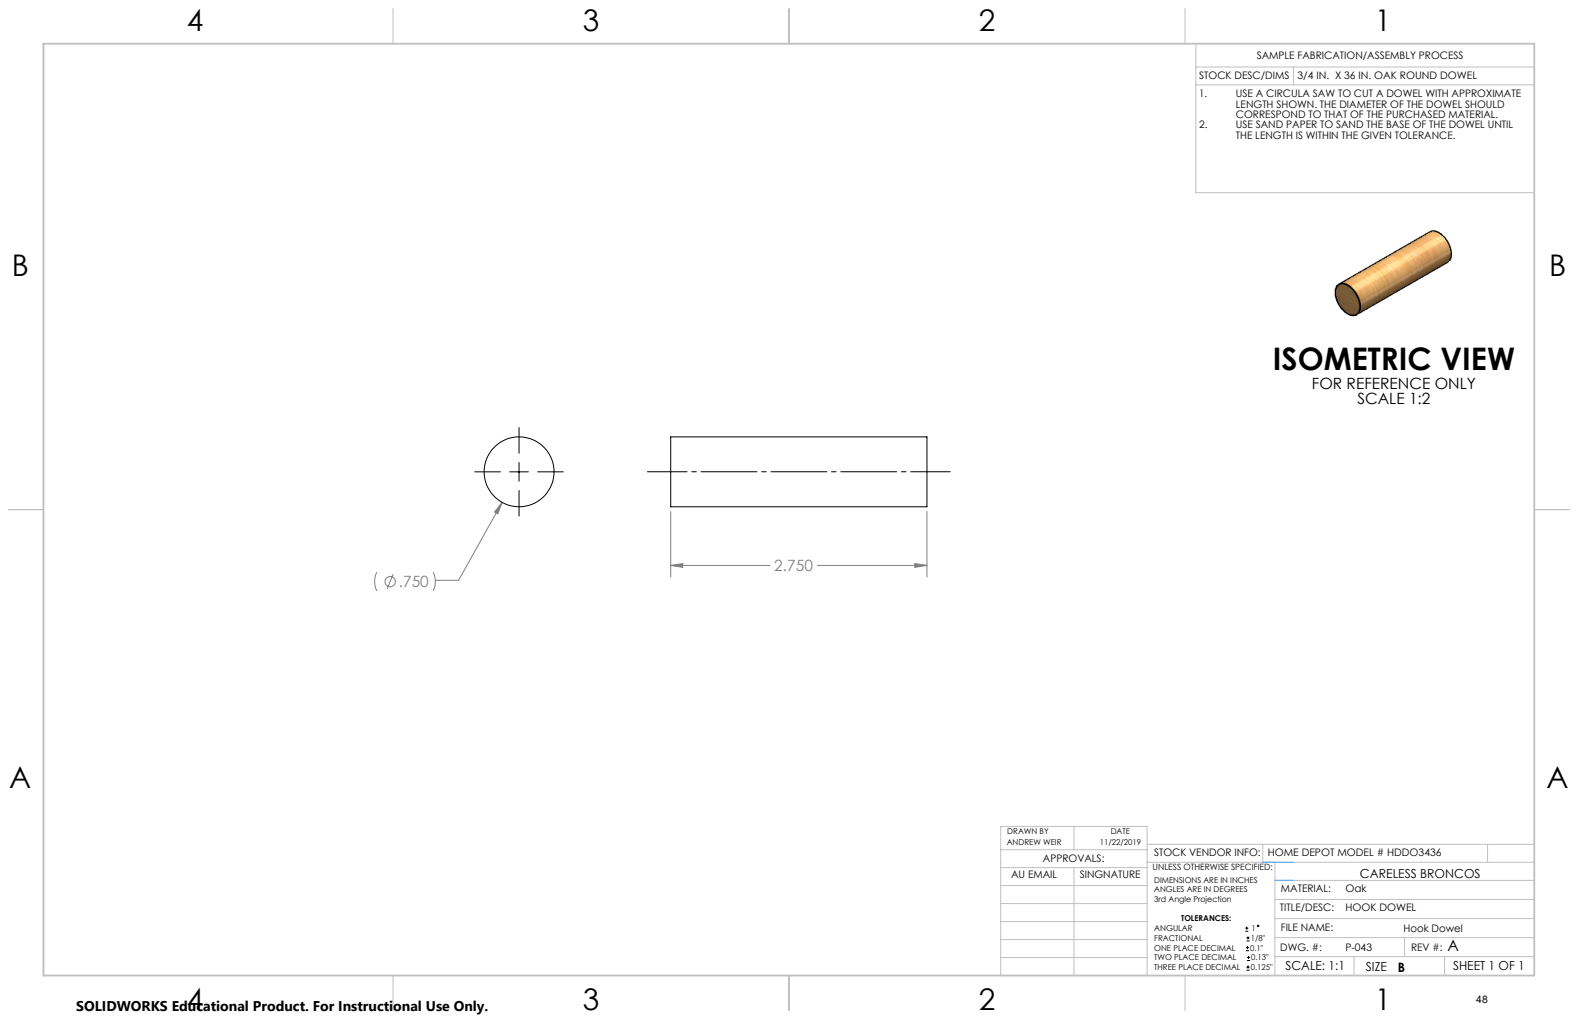
[picture p48: page 48]
HOOK DOWEL; ANDREW WEIR; FILE NAME:; DRAWN BY; DATE; Hook Dowel; AU EMAIL; SINGNATURE

3/4 IN. X 36 IN. OAK ROUND DOWEL

1. USE A CIRCULA SAW TO CUT A DOWEL WITH APPROXIMATE
LENGTH SHOWN. THE DIAMETER OF THE DOWEL SHOULD
CORRESPOND TO THAT OF THE PURCHASED MATERIAL.
2. USE SAND PAPER TO SAND THE BASE OF THE DOWEL UNTIL
THE LENGTH IS WITHIN THE GIVEN TOLERANCE.

ISOMETRIC VIEW
FOR REFERENCE ONLY
SCALE 1:2

STOCK VENDOR INFO: | HOME DEPOT MODEL # HDDO3436
UNLESS OTHERWISE SPECIFIED: ANGLES ARE IN DEGREES 3rd Angle Projection TOLERANCES: ANGULAR 1 | | CARELESS BRONCOS

DIMENSIONS ARE IN INCHES

SCALE: 1:1 | | SHEET 1 OF 1

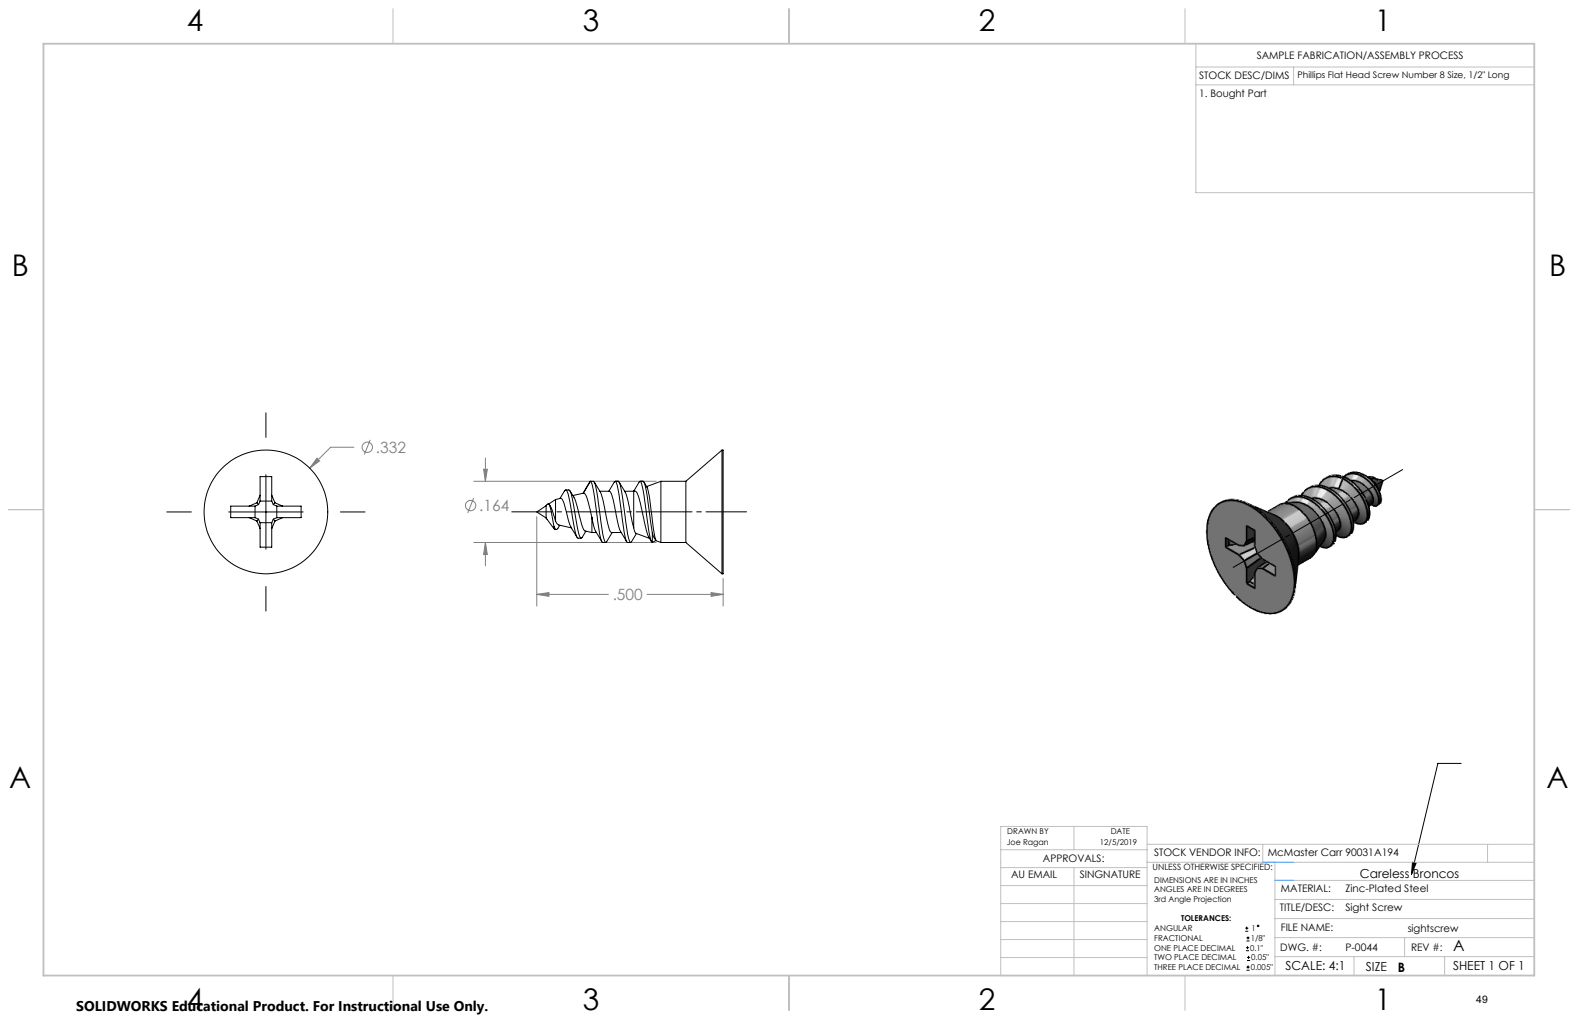
[picture p49: page 49]
Joe Ragan; FILE NAME:; DRAWN BY; DATE; AU EMAIL; SINGNATURE; 1. Bought Part

Phillips Flat Head Screw Number 8 Size, 1/2" Long

STOCK VENDOR INFO: | McMaster Carr 90031A194
UNLESS OTHERWISE SPECIFIED: ANGLES ARE IN DEGREES 3rd Angle Projection TOLERANCES: ANGULAR 1 | | Careless Broncos

DIMENSIONS ARE IN INCHES

Zinc-Plated Steel
Sight Screw

REV #: A

SCALE: 4:1 | | SHEET 1 OF 1

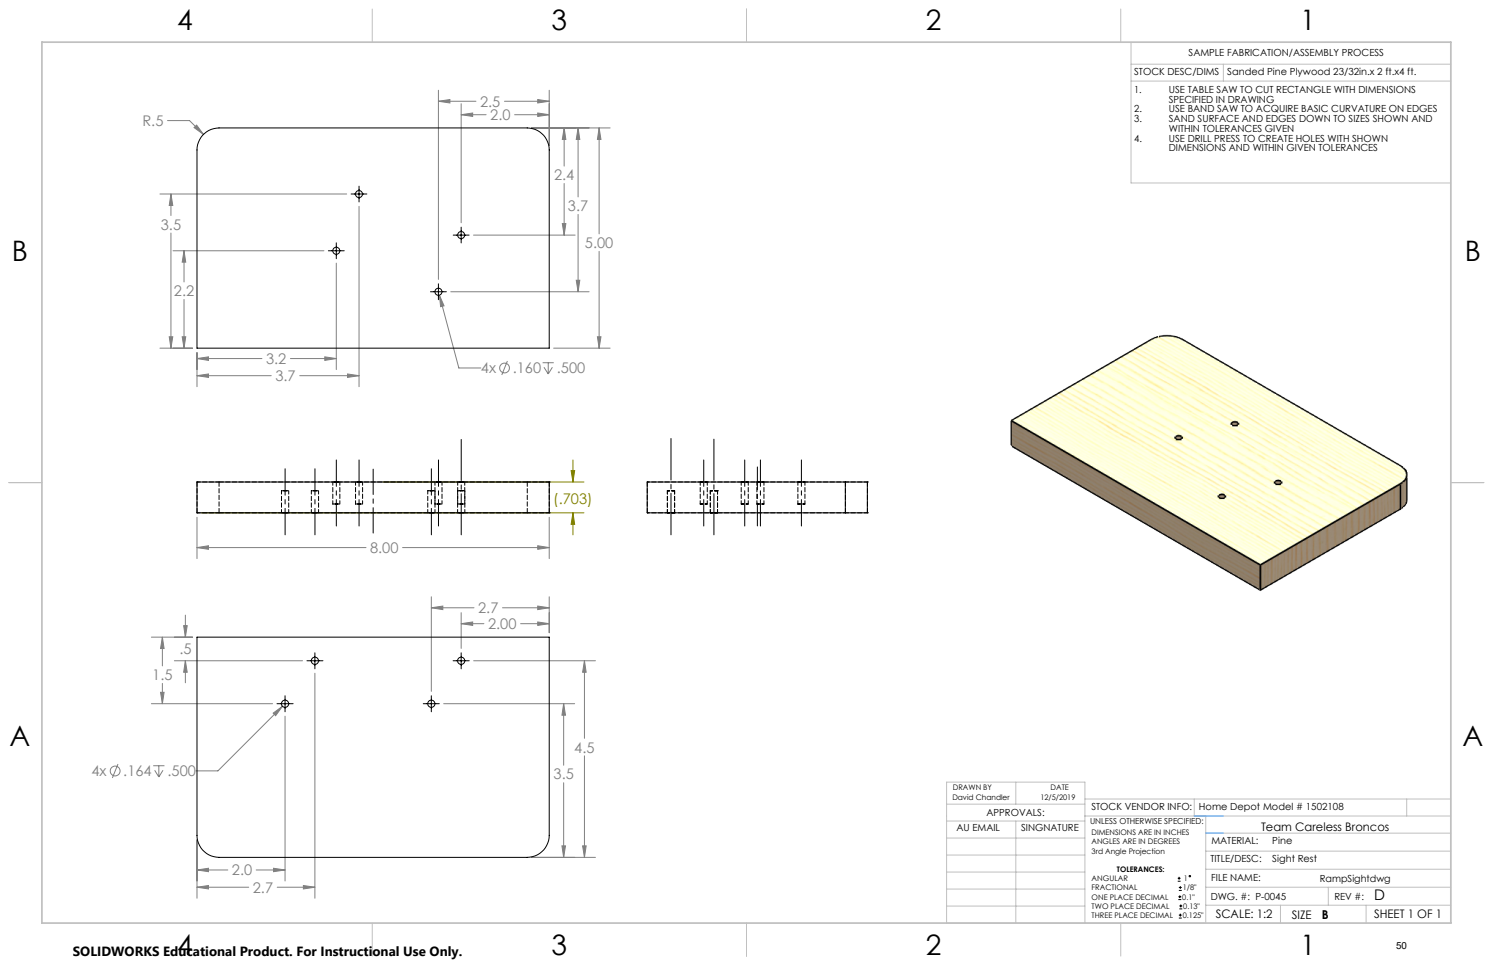
[picture p50: page 50]
Sight Rest; David Chandler; FILE NAME:; DRAWN BY; DATE; AU EMAIL; SINGNATURE

Sanded Pine Plywood 23/32in.x 2 ft.x4 ft.

1. USE TABLE SAW TO CUT RECTANGLE WITH DIMENSIONS
SPECIFIED IN DRAWING
2. USE BAND SAW TO ACQUIRE BASIC CURVATURE ON EDGES
3. SAND SURFACE AND EDGES DOWN TO SIZES SHOWN AND
WITHIN TOLERANCES GIVEN
4. USE DRILL PRESS TO CREATE HOLES WITH SHOWN
DIMENSIONS AND WITHIN GIVEN TOLERANCES

STOCK VENDOR INFO: | Home Depot Model # 1502108
UNLESS OTHERWISE SPECIFIED: ANGLES ARE IN DEGREES 3rd Angle Projection TOLERANCES: ANGULAR 1 | | Team Careless Broncos

DIMENSIONS ARE IN INCHES

REV #: D

SCALE: 1:2 | | SHEET 1 OF 1

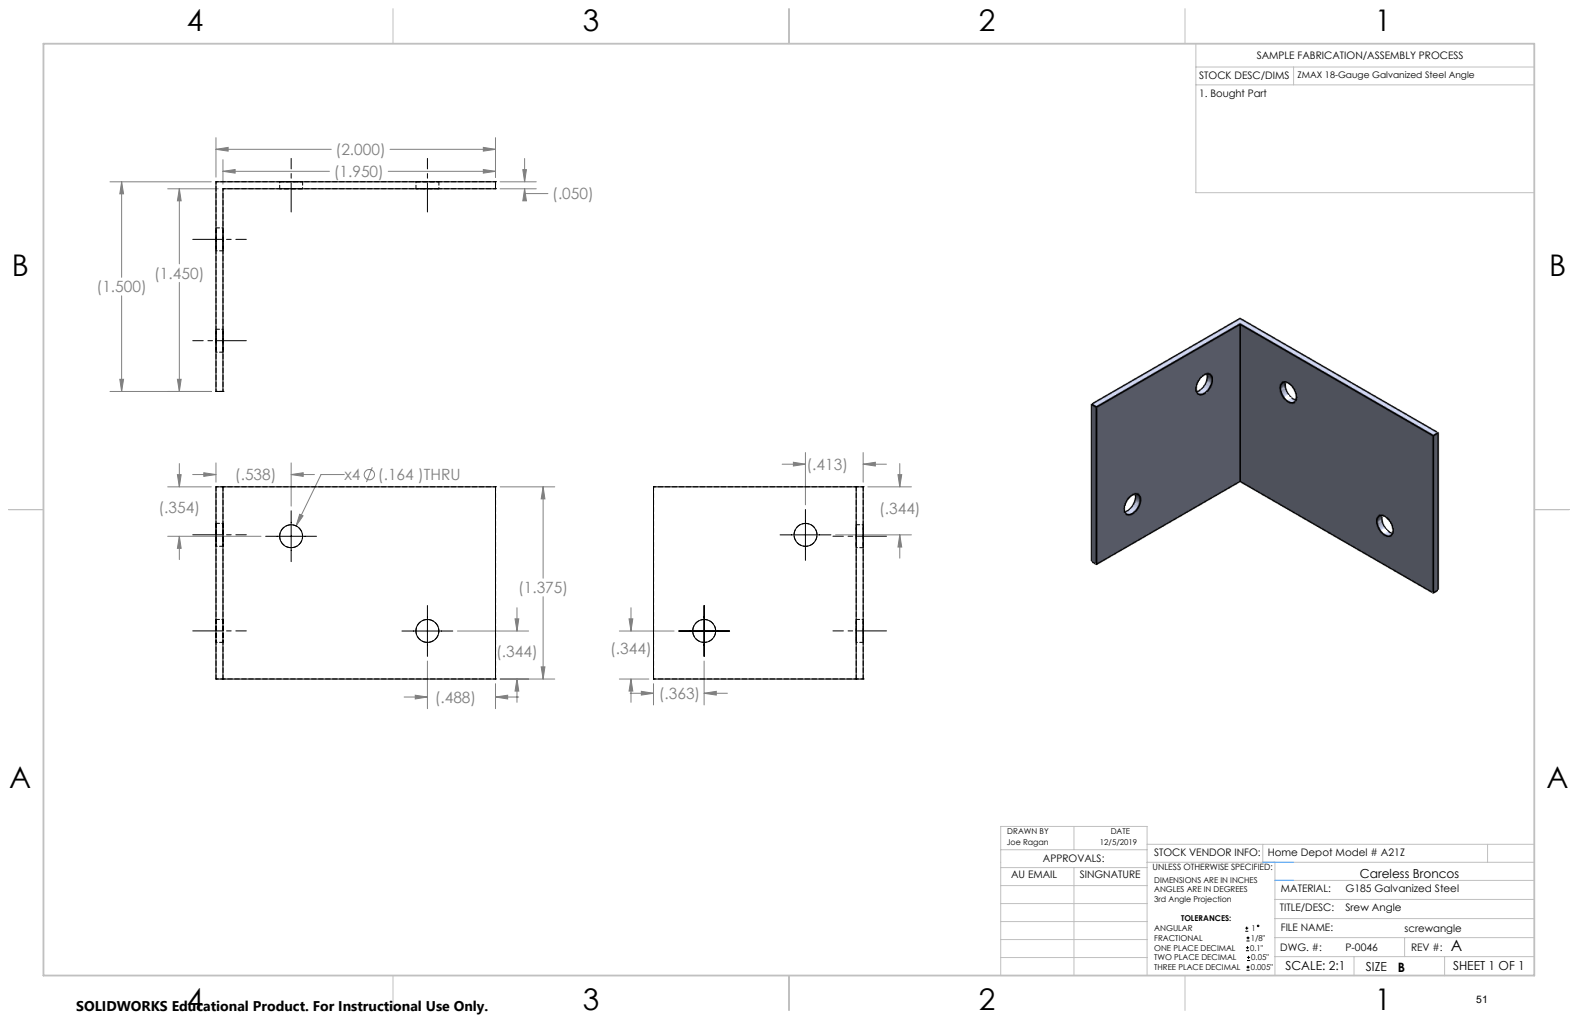
[picture p51: page 51]
x4 (.164 )THRU; Srew Angle; G185 Galvanized Steel; Joe Ragan; FILE NAME:; DRAWN BY; DATE; AU EMAIL; SINGNATURE; 1. Bought Part

ZMAX 18-Gauge Galvanized Steel Angle

STOCK VENDOR INFO: | Home Depot Model # A21Z
UNLESS OTHERWISE SPECIFIED: ANGLES ARE IN DEGREES 3rd Angle Projection TOLERANCES: ANGULAR 1 | | Careless Broncos

DIMENSIONS ARE IN INCHES

REV #: A

SCALE: 2:1 | | SHEET 1 OF 1

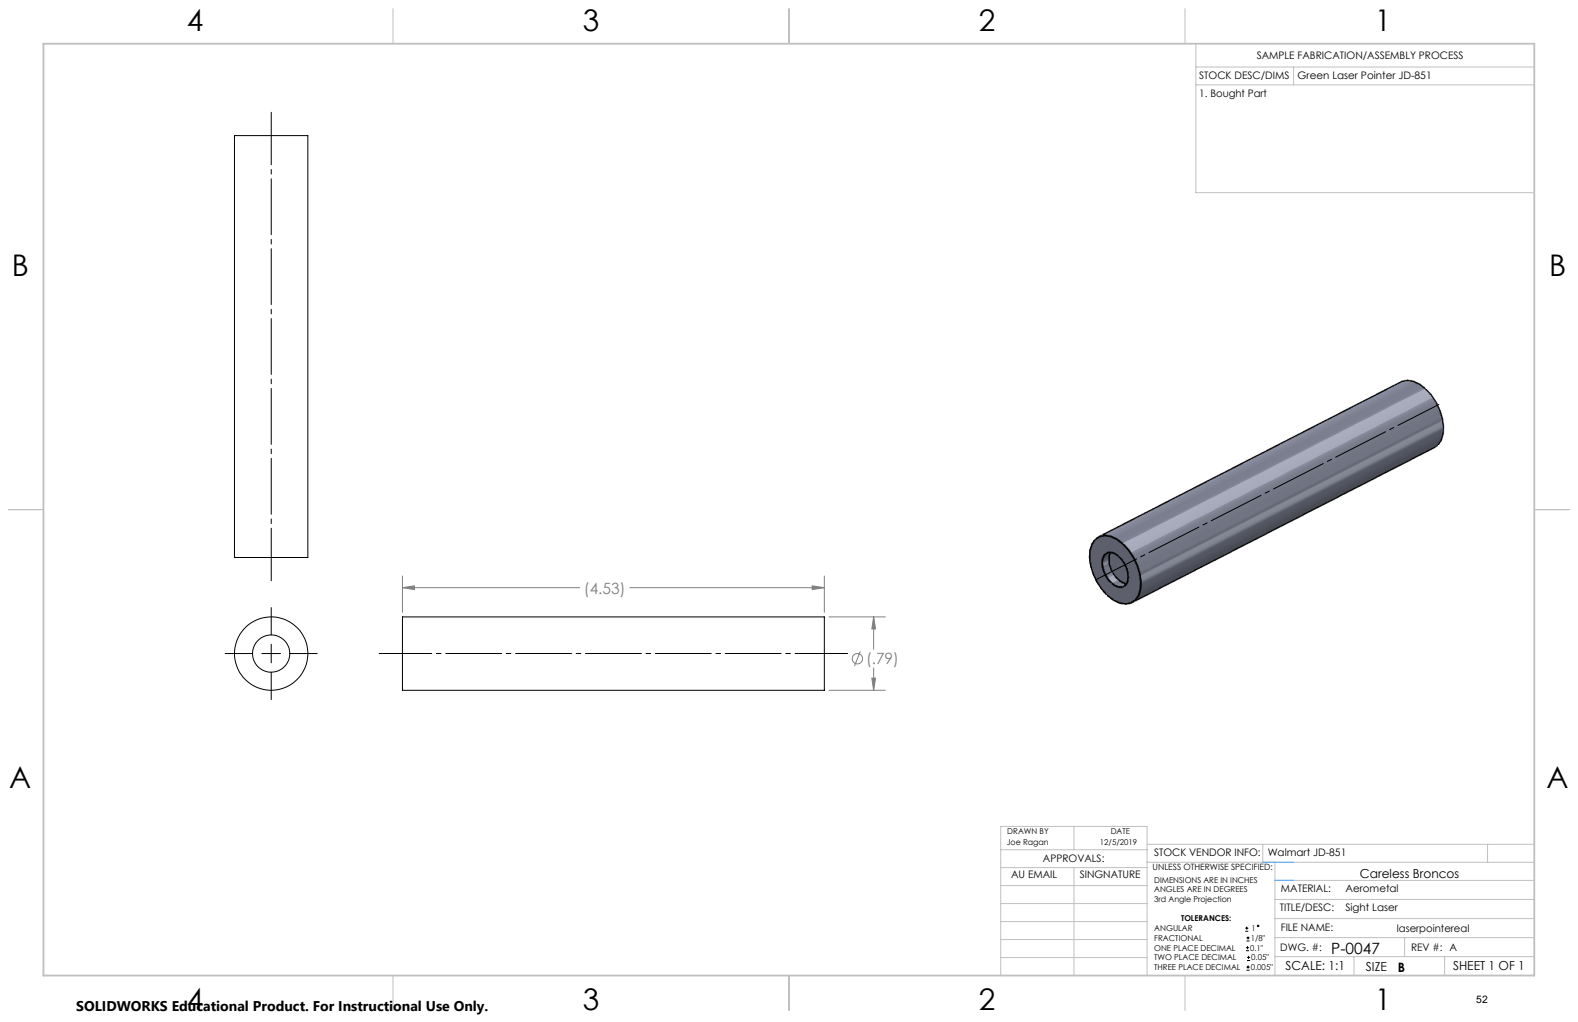
[picture p52: page 52]
Sight Laser; Joe Ragan; FILE NAME:; DRAWN BY; DATE; AU EMAIL; SINGNATURE; 1. Bought Part

Green Laser Pointer JD-851

STOCK VENDOR INFO: | Walmart JD-851
UNLESS OTHERWISE SPECIFIED: ANGLES ARE IN DEGREES 3rd Angle Projection TOLERANCES: ANGULAR 1 | | Careless Broncos

DIMENSIONS ARE IN INCHES

P-0047 | REV #: A
SCALE: 1:1 | | SHEET 1 OF 1

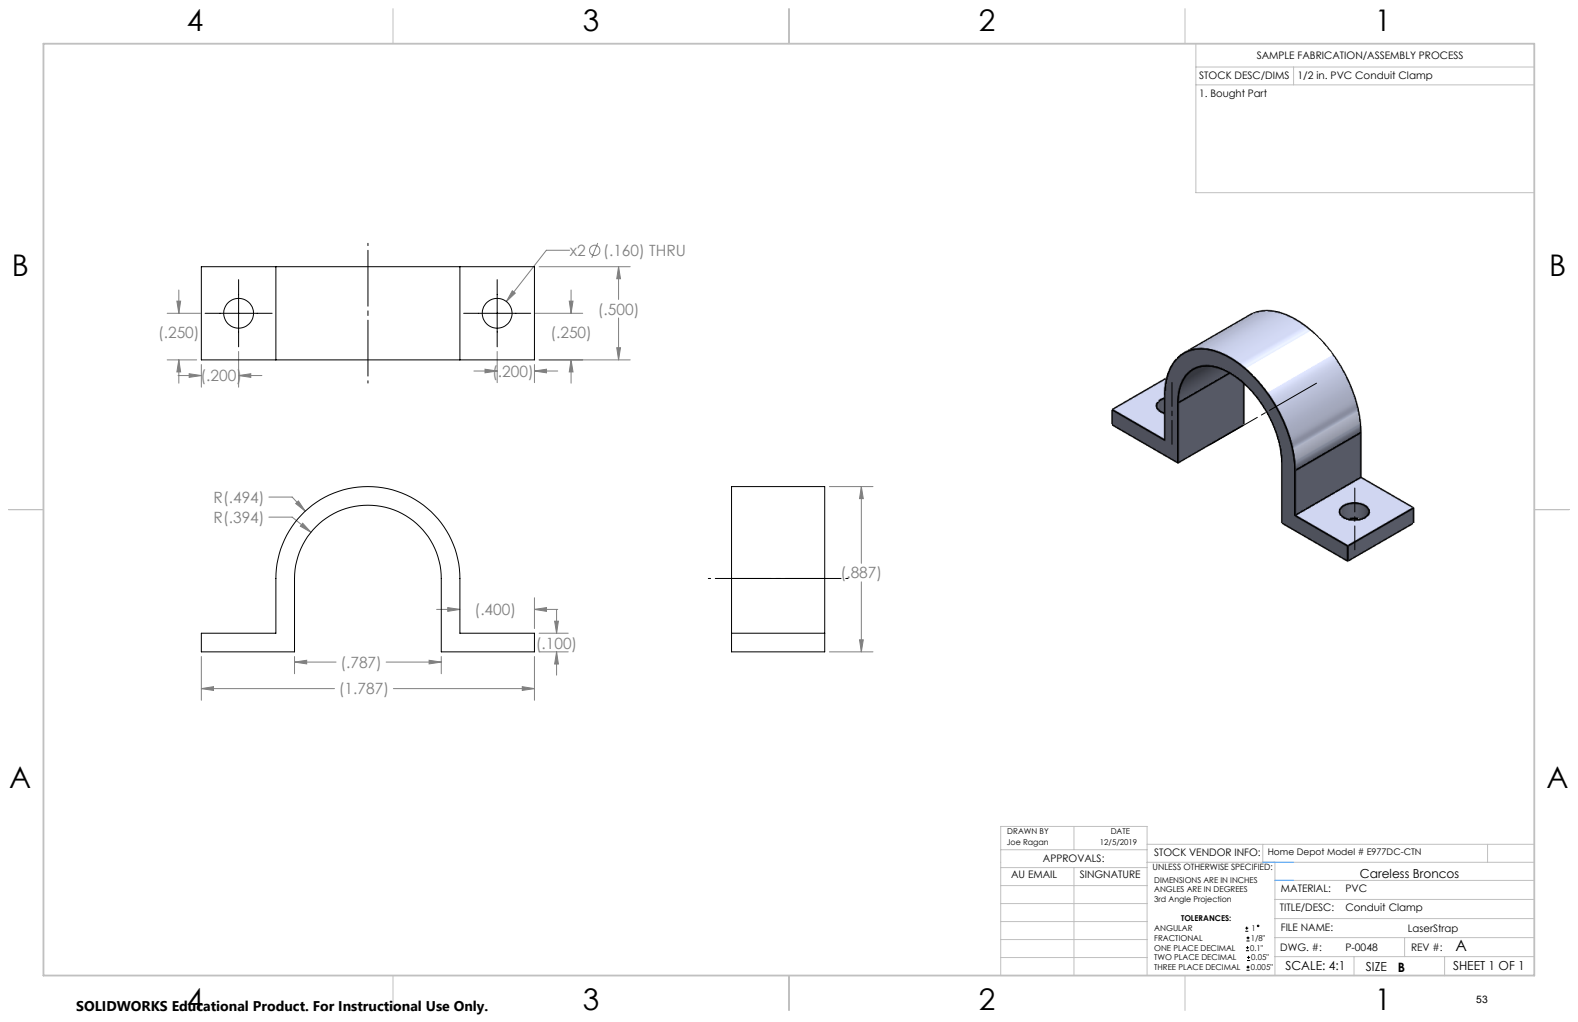
[picture p53: page 53]
x2 (.160) THRU; Conduit Clamp; Joe Ragan; FILE NAME:; DRAWN BY; DATE; AU EMAIL; SINGNATURE; 1. Bought Part

1/2 in. PVC Conduit Clamp

STOCK VENDOR INFO: | Home Depot Model # E977DC-CTN
UNLESS OTHERWISE SPECIFIED: ANGLES ARE IN DEGREES 3rd Angle Projection TOLERANCES: ANGULAR 1 | | Careless Broncos

DIMENSIONS ARE IN INCHES

REV #: A

SCALE: 4:1 | | SHEET 1 OF 1

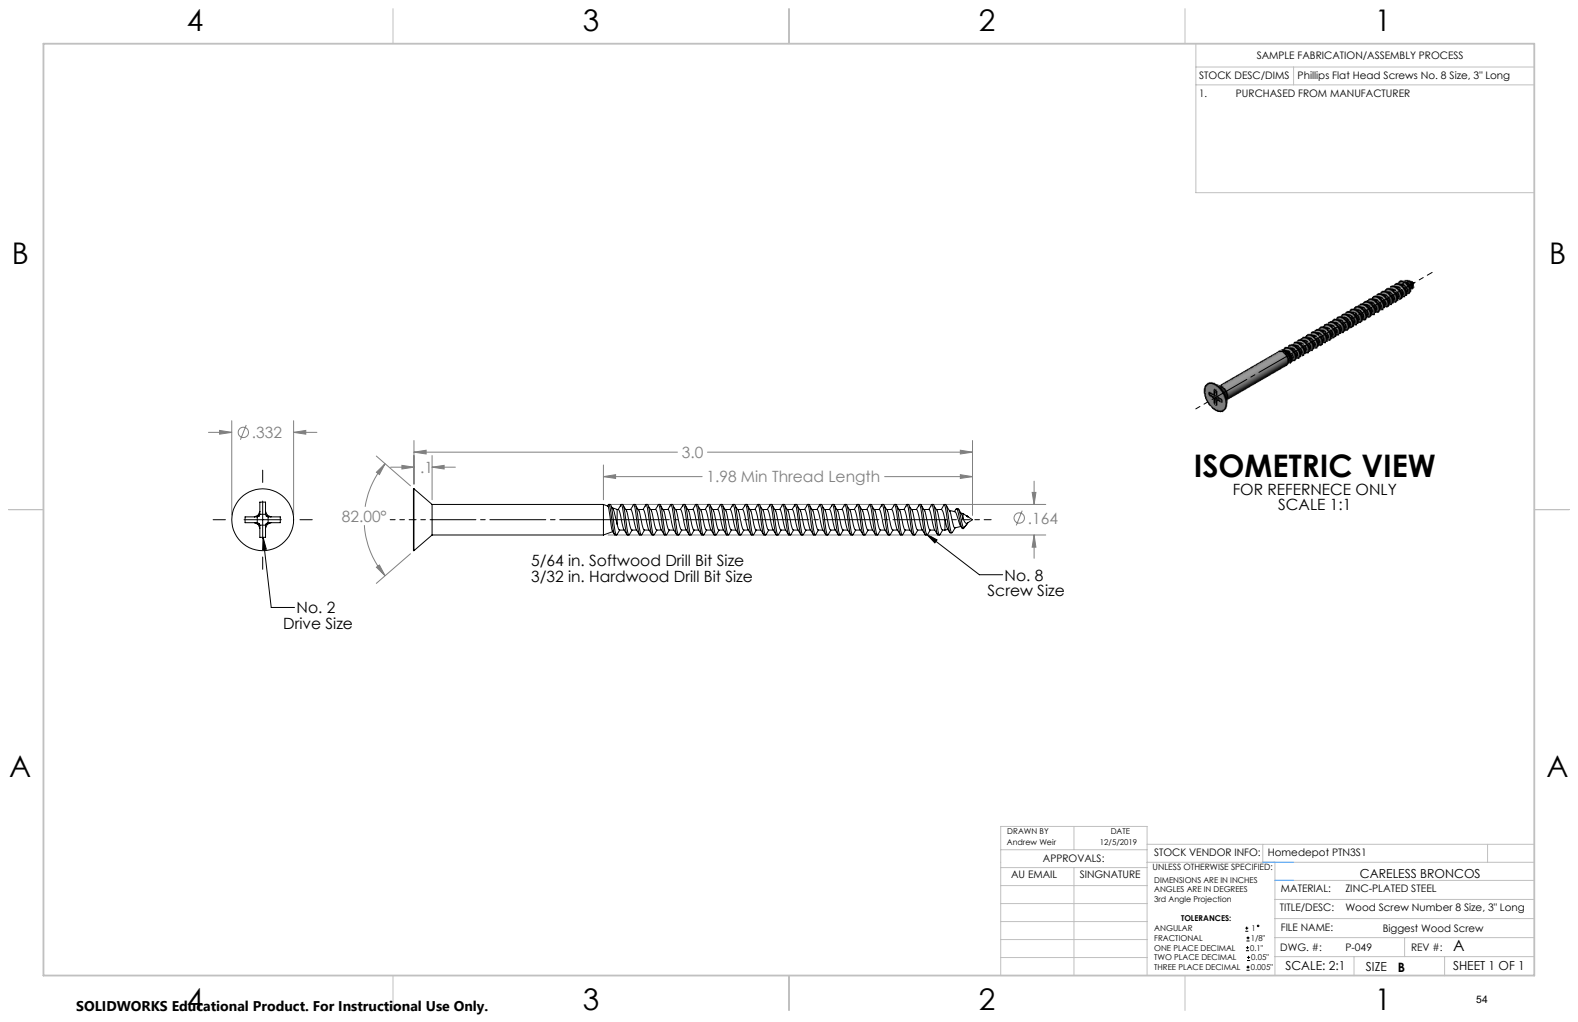
[picture p54: page 54]
1.98 Min Thread Length; No. 8 Screw Size; No. 2 Drive Size; Andrew Weir; FILE NAME:; DRAWN BY; DATE; AU EMAIL; SINGNATURE

Phillips Flat Head Screws No. 8 Size, 3" Long

1. PURCHASED FROM MANUFACTURER

ISOMETRIC VIEW
FOR REFERNECE ONLY
SCALE 1:1

5/64 in. Softwood Drill Bit Size
3/32 in. Hardwood Drill Bit Size

STOCK VENDOR INFO: | Homedepot PTN3S1
UNLESS OTHERWISE SPECIFIED: ANGLES ARE IN DEGREES 3rd Angle Projection TOLERANCES: ANGULAR 1 | | CARELESS BRONCOS

DIMENSIONS ARE IN INCHES

ZINC-PLATED STEEL
Wood Screw Number 8 Size, 3" Long
Biggest Wood Screw

SCALE: 2:1 | | SHEET 1 OF 1

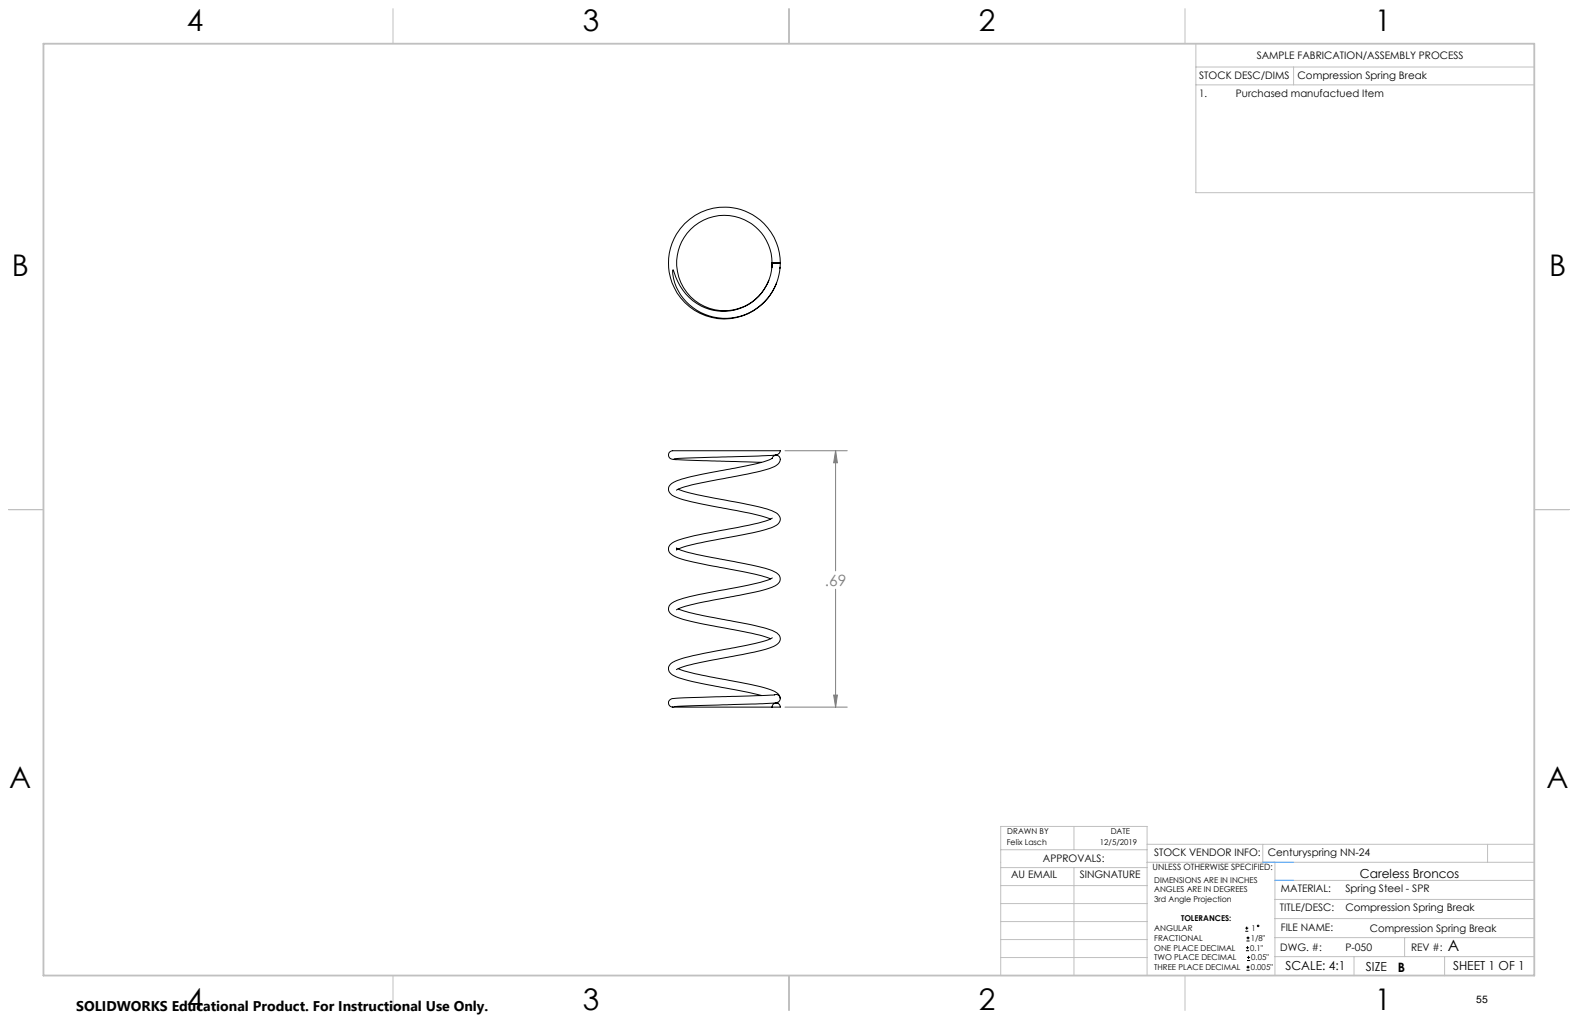
[picture p55: page 55]
Felix Lasch; FILE NAME:; DRAWN BY; DATE; AU EMAIL; SINGNATURE

Compression Spring Break

1. Purchased manufactued Item

STOCK VENDOR INFO: | Centuryspring NN-24
UNLESS OTHERWISE SPECIFIED: ANGLES ARE IN DEGREES 3rd Angle Projection TOLERANCES: ANGULAR 1 | | Careless Broncos

DIMENSIONS ARE IN INCHES

Spring Steel - SPR

REV #: A

SCALE: 4:1 | | SHEET 1 OF 1
