flasch97/Mech-2220-Project-Gravity-Car/Purchase Order.xlsx

List Number | Description | Serial Number | Quantity | Unit Cost | Cost | Vendor
1 | 1/2"x1" Aluminum Flat bar, 6061 Plate, 12" length | 89755K11 (https://www.mcmaster.com/89755K11) | 1 | $8.90 | $8.90 | McMaster Carr($24.39), bought on ebay
2 | Low-Carbon Steel Rod, 1" Diameter | 8920K231 | 1 | $12.81 | $12.81 | McMaster Carr
3 | High-Strength Steel Threaded Rod, 1/4"-28 Thread Size, 1" Long | 90322A660 | 4 | $3.76 | $15.04 | McMaster Carr
4 | Easy-to-Form 1075 Spring Steel Sheet, 8" x 12" x 0.0350" | 9071K73 | 1 | $18.50 | $18.50 | McMaster Carr
5 | Polypropylene Wheel with Roller Bearing, 4" Diameter x 1-1/2" Wide, for 1/2" Axle | 2781T585 (https://www.mcmaster.com/2781T585) | 4 | $9.03 | $36.12 | McMaster Carr
6 | Brass Wing Nut, 1/4"-28 Thread Size | 92771A529 | 1 | $6.06 | $6.06 | McMaster Carr
7 | 18-8 Stainless Steel Button Head Hex Drive Screw, 1/4"-20 Thread Size, 3/4" Long | 92949A540 |  | $7.39 | $0.00 | McMaster Carr
8 | 18-8 Stainless Steel Thin Hex Nut, 1/4"-28 Thread Size 100 pack | 91847A429 | 1 | $4.84 | $4.84 | McMaster Carr
9 | 18-8 Stainless Steel Button Head Hex Drive Screw, 1-64 Thread Size, 1/4" Long 100 pack | 92949A316 | 1 | $7.34 | $7.34 | McMaster Carr
10 | 316 Stainless Steel Washer for 1/4" Screw Size, 0.281" ID, 0.625" OD, 100 pack | 90107A029 | 1 | $8.25 | $8.25 | McMaster Carr
11 | Ball Bearing, Open, Trade Number 608, for 8 mm Shaft Diameter | 5972K91 | 1 | $4.70 | $4.70 | McMaster Carr
12 | 1/4 in. x 48 in. Hardwood Round Dowel | 203360194 | 1 | $0.86 | $0.86 | Home Depot
13 | Low-Carbon Steel Rod, 1" Diameter, 1' Length | 8920K231 | 1 | $12.81 | $12.81 | McMaster Carr
14 | 1004-1045 Carbon Steel Clevis Pin, 1/4" Diameter, 11/16" Usable Length, 25 pack | 98306A158 | 1 | $5.82 | $5.82 | McMaster Carr
15 | 12 in. x 24 in. Leathergrain Aluminum Sheet in Silver | 56030 | 1 | $11.53 | $11.53 | HomeDepot
16 | New 0-1mm 0.001" Metric Outside Micrometer Carbide Tipped USA |  | 1 | $12.99 | $12.99 | Ebay | Ebay (https://www.ebay.com/itm/New-0-1mm-0-001-Metric-Outside-Micrometer-Carbide-Tipped-USA/264536838465)
17 | Mil. Spec. Compression Springs, 0.5" Long, 0.36" OD, 0.276" ID, MS 24585-1257 | 2022N161 | 1 | $17.32 | $17.32 | McMaster Carr
18 | 15/32 in. x 4 ft. x 8 ft. 3-Ply RTD Sheathing | 132411 | 1 | $16.55 | $16.55 | Home Depot
19 | 2 in. X 4 in. X 16 ft. Spruce-Pine-Fir Lumber | 133166 | 1 | $9.08 | $9.08 | Home Depot
20 | 24 in. W X 3 ft. L Galvanized Steel Sheet Metal | GVL0108 | 1 | $11.48 | $11.48 | Lowe's
21 | Screw Rounded Head, No 8, Size 1-1/2'' Long | 93360A255 | 1 | $9.90 | $9.90 | McMaster Carr
22 | Gorilla Glue 9oz Heavy Duty Construction Adhesive | 8010003 | 1 | $7.97 | $7.97 | Home Depot
23 | Grip-Rite #8 x 3 in. Philips Bugle-Head Coarse Thread Sharp Point Polymer Coated Exterior Screw (1 lb. - Pack) (https://www.homedepot.com/p/Grip-Rite-8-x-3-in-Philips-Bugle-Head-Coarse-Thread-Sharp-Point-Polymer-Coated-Exterior-Screw-1-lb-Pack-PTN3S1/100115639) | PTN351 | 1 | $3.98 | $3.98 | McMaster Carr
24 | Select Pine Board 1 in. X 6 in. X 6 ft. | 928787 | 1 | $12.00 | $12.00 | Home Depot
25 | 3/4 in. X 36 in. Oak Round Dowel | HDDO3436 | 1 | $4.98 | $4.98 | Home Depot
26 | Gorilla 4 fl. oz Wood Glue | 62020 | 1 | $2.97 | $2.97 | Home Depot
27 | Phillips Flat Head Screws for Wood, Zinc-Plated Steel, Number 8 Size, 1/2" Long, 100 pack | 90031A194 | 1 | $4.82 | $4.82 | McMaster Carr
28 | Simpson Strong-Tie ZMAX 18-Gauge Galvanized Steel Angle | A21Z | 2 | $0.65 | $1.30 | Home Depot
29 | 1/2 Pipe, PVC, Pipe or Conduit Strap, 2 mounting holes | 54090345 | 2 | 0.37 | $0.74 | MSC | https://www.mscdirect.com/product/details/54090345
30 | JD-851 5mW High Power 532nm Green Light Adjustable Starry Sky Star Cap Pointer Pen Flashlight | jd-851 | 1 | $6.72 | $6.72 | Walmart | https://www.walmart.com/ip/JD-851-5mW-High-Power-532nm-Green-Light-Adjustable-Starry-Sky-Star-Cap-Pointer-Pen-Flashlight/780331241
31 | Compression Springs | NN-24 | 1 | $5.73 | $5.73 | Century spring | https://www.centuryspring.com/catalog/?page=product&cid=compression-regular&id=NN-24CS&cdskeys=NN-24
 |  |  |  | Total = | $282.11
