flasch97/Mech-2220-Project-Gravity-Car/Gravity Car/Ramp/Ramp.SLDASM

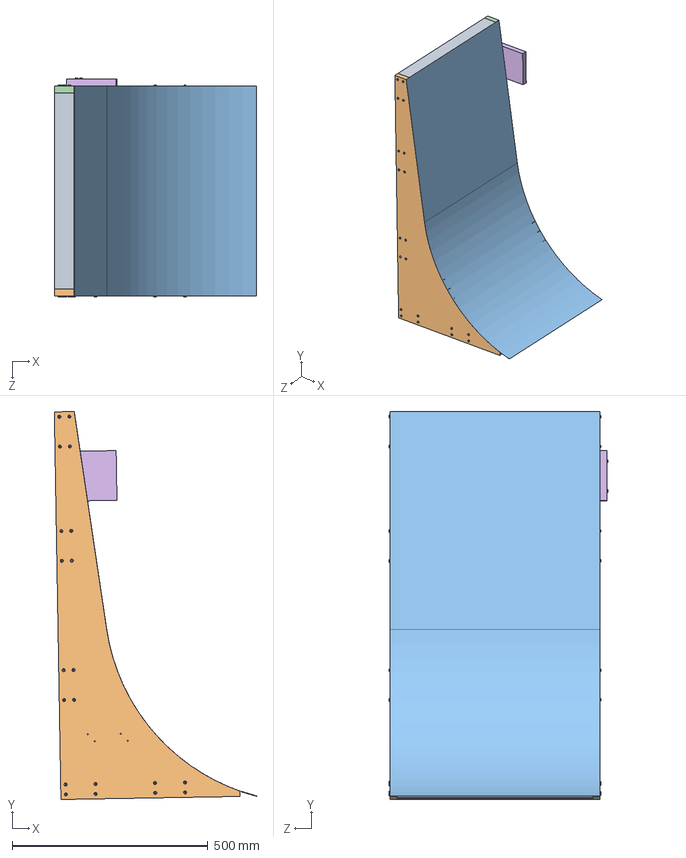
[picture p56: CAD file, 2019-12-06]
Gravity Car/Ramp/Ramp.SLDASM
517.1 x 991.4 x 560.2 mm
base support x 5
Ramp Right Side
ramp top
Left Ramp Side
Smaller Wood Screw x 42
Position Marker
