flasch97/Mech-2220-Project-Gravity-Car/Gravity Car/Rear Axle/rear axle assembly.SLDASM

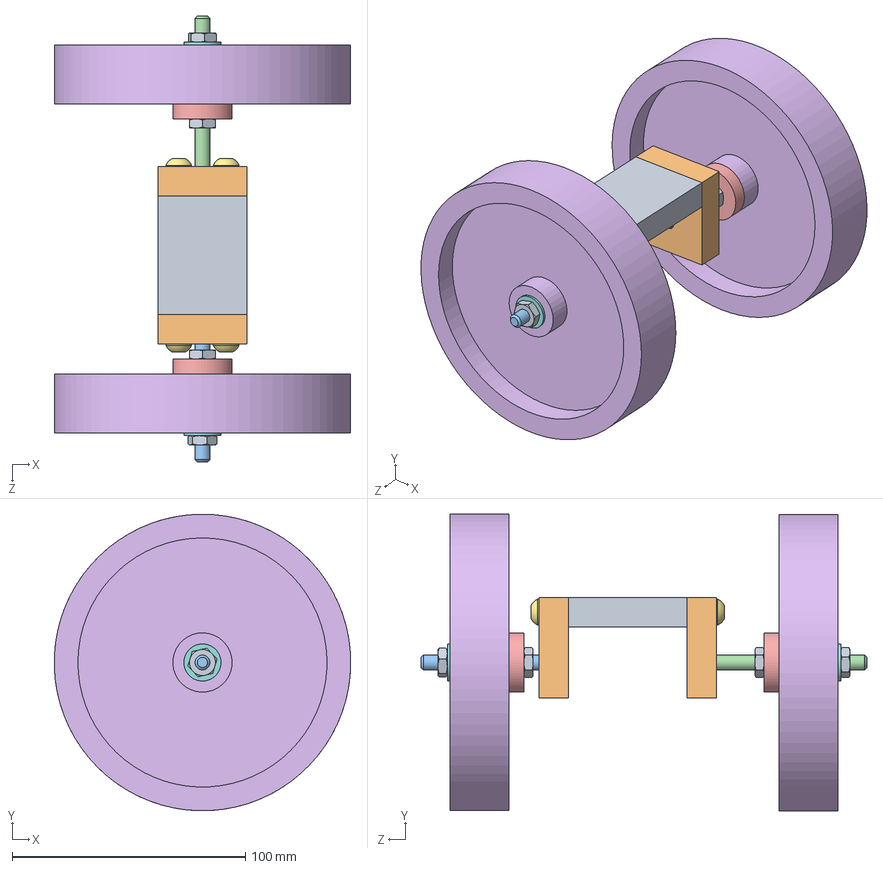
[picture p57: CAD file, 2019-12-06]
Gravity Car/Rear Axle/rear axle assembly.SLDASM
127.0 x 127.0 x 191.0 mm
Connection Rear Suspention
suspension rear x 2
threaded axle rear left
threaded axle rear right
muffle rear wheels x 2
Wheel x 2
Button Head Hex Drive Screw 1-4-28 x 4
316 Stainless Steel Washer x 2
Stainless Steel Thin Hex Nut 1-4-28 x 4
