flasch97/Mech-2220-Project-Gravity-Car/Gravity Car/Motion Analysis/motion analysis.SLDASM

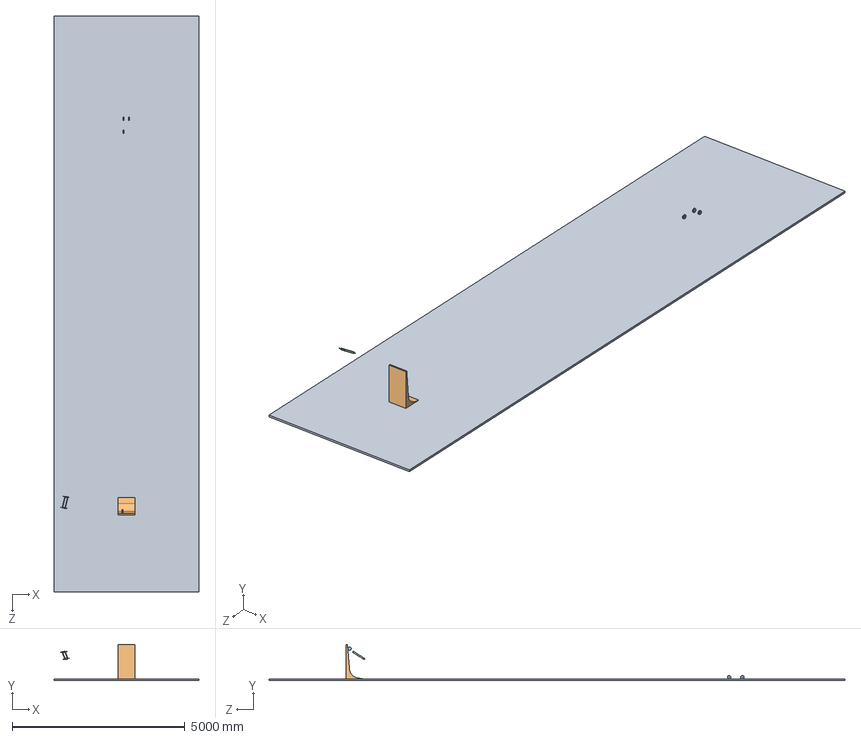
[picture p58: CAD file, 2019-12-06]
Gravity Car/Motion Analysis/motion analysis.SLDASM
4194.1 x 1050.0 x 16654.9 mm
floor arc
Ramp
Front Wheel x 4
frame
