flasch97/Mech-2220-Project-Gravity-Car/Gravity Car/Ramp System/Ramp System.SLDASM

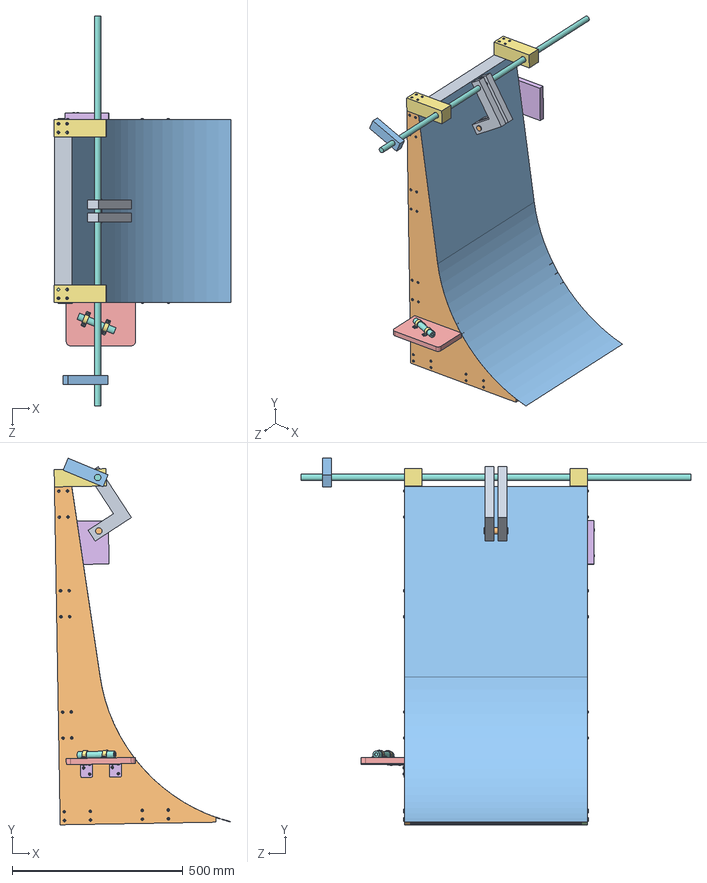
[picture p59: CAD file, 2019-12-06]
Gravity Car/Ramp System/Ramp System.SLDASM
518.0 x 1074.7 x 1143.0 mm
base support x 5
Ramp Right Side
ramp top
Left Ramp Side
Smaller Wood Screw x 46
Position Marker
Release support x 2
Release Dowel
RELEASE HOOK x 2
Hook Dowel
Release Lever
Biggest Wood Screw x 8
RampSight
screwangle x 2
LaserStrap x 2
laserpointereal
sightscrew x 8
