flasch97/Mech-2220-Project-Gravity-Car/Gravity Car/RampSight/Assemsight.SLDASM

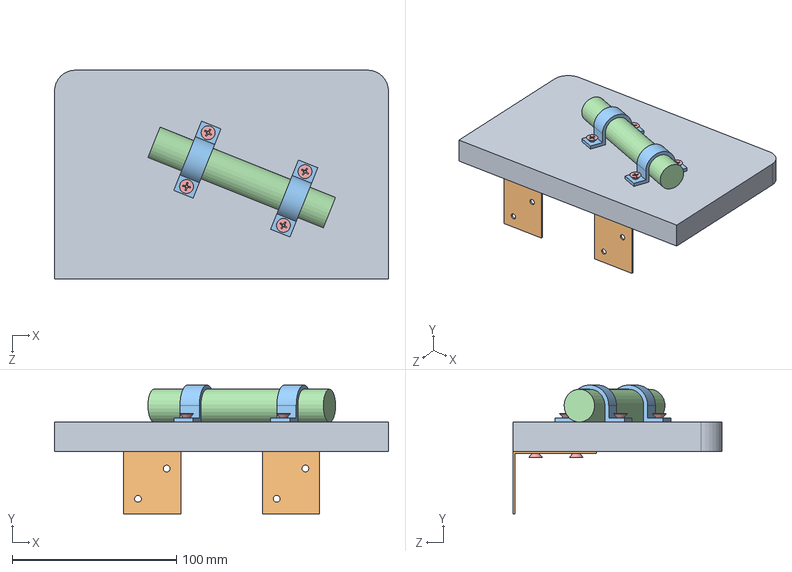
[picture p60: CAD file, 2019-12-06]
Gravity Car/RampSight/Assemsight.SLDASM
203.2 x 78.4 x 127.0 mm
RampSight
screwangle x 2
LaserStrap x 2
laserpointereal
sightscrew x 8
