flasch97/Mech-2220-Project-Gravity-Car/Gravity Car/Release Mechanism/Release Mechanism.SLDASM

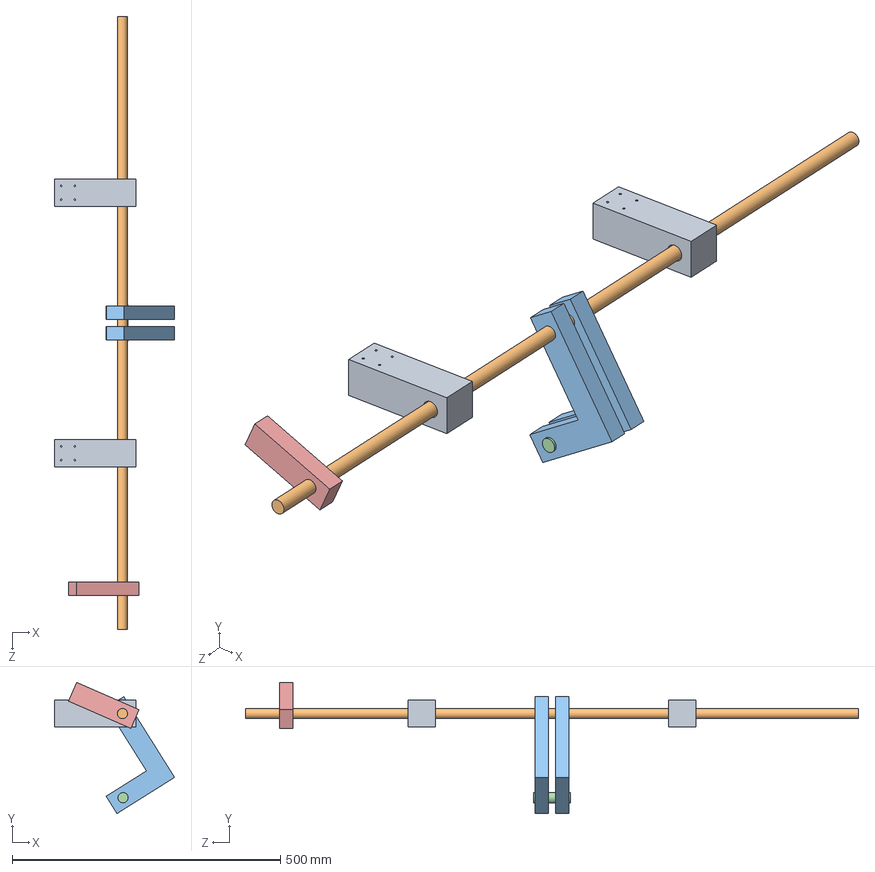
[picture p61: CAD file, 2019-12-06]
Gravity Car/Release Mechanism/Release Mechanism.SLDASM
224.2 x 244.6 x 1143.0 mm
Release support x 2
Release Dowel
RELEASE HOOK x 2
Hook Dowel
Release Lever
