flasch97/Mech-2220-Project-Gravity-Car/Gravity Car/Front Axle/Front Axle Assembly.SLDASM

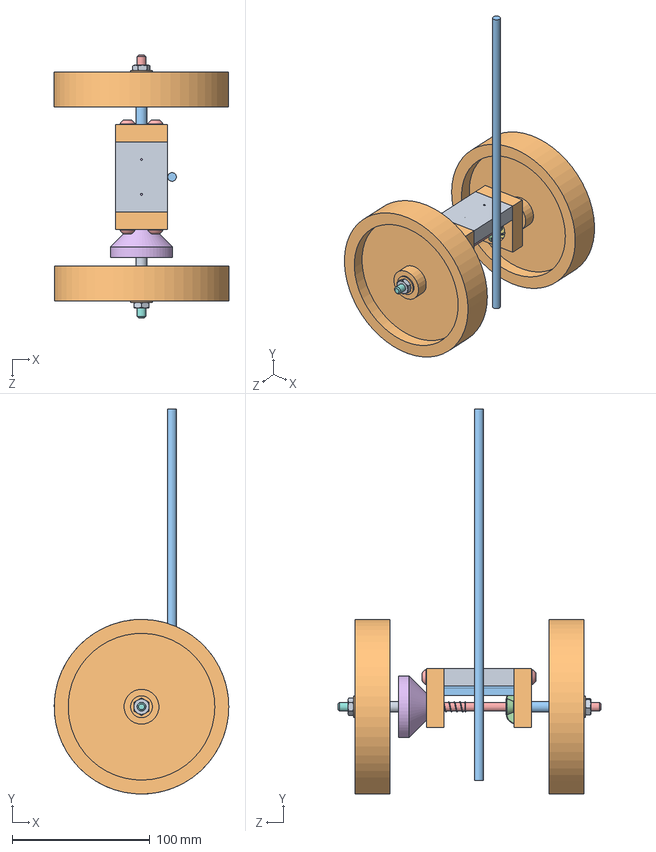
[picture p62: CAD file, 2019-12-06]
Gravity Car/Front Axle/Front Axle Assembly.SLDASM
127.0 x 280.0 x 191.0 mm
Connection Front Suspention
suspension front x 2
Slide Wing Nut
muffle bearing x 2
Threaded Axle Front Left
Adapter One-Way-Bearing
Muffle One-Way-Bearing
Threaded Axle Front Right
muffle wheel right
Wheel x 2
muffle wheel left
Wingnut
Button Head Hex Drive Screw 1-4-28 x 4
Button Head Hex Drive Screw 1-64 x 2
608 Ball Bearing x 2
One-Way-Bearing
Stainless Steel Thin Hex Nut 1-4-28 x 3
316 Stainless Steel Washer x 2
Wooden Rod
Compression Spring Break
