flasch97/Mech-2220-Project-Gravity-Car/Gravity Car/FEA/FEA.SLDPRT

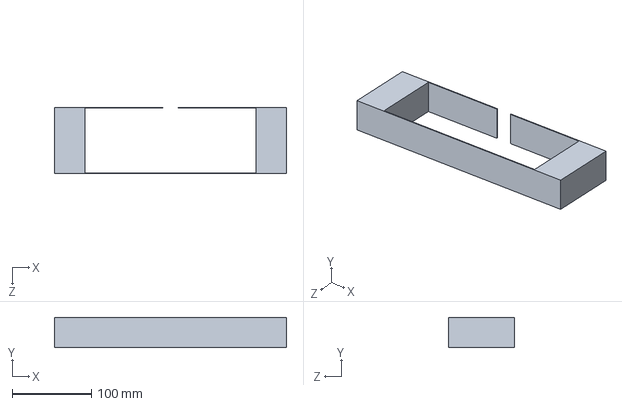
[picture p63: CAD file, 2019-12-06]
Gravity Car/FEA/FEA.SLDPRT
292.1 x 38.1 x 83.3 mm
