flasch97/Mech-2220-Project-Gravity-Car/Gravity Car/Front Axle/Hardware Parts/BALL BEARING.SLDPRT

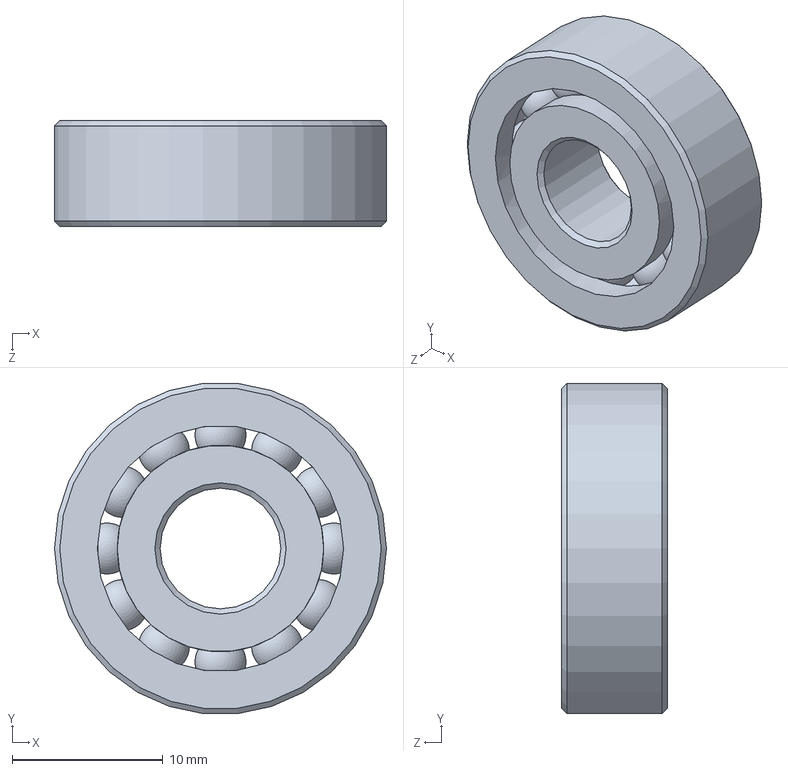
[picture p64: CAD file, 2019-12-06]
Gravity Car/Front Axle/Hardware Parts/BALL BEARING.SLDPRT
22.0 x 21.9 x 7.00 mm
