flasch97/Mech-2220-Project-Gravity-Car/Gravity Car/Front Axle/Wooden Rod.SLDPRT

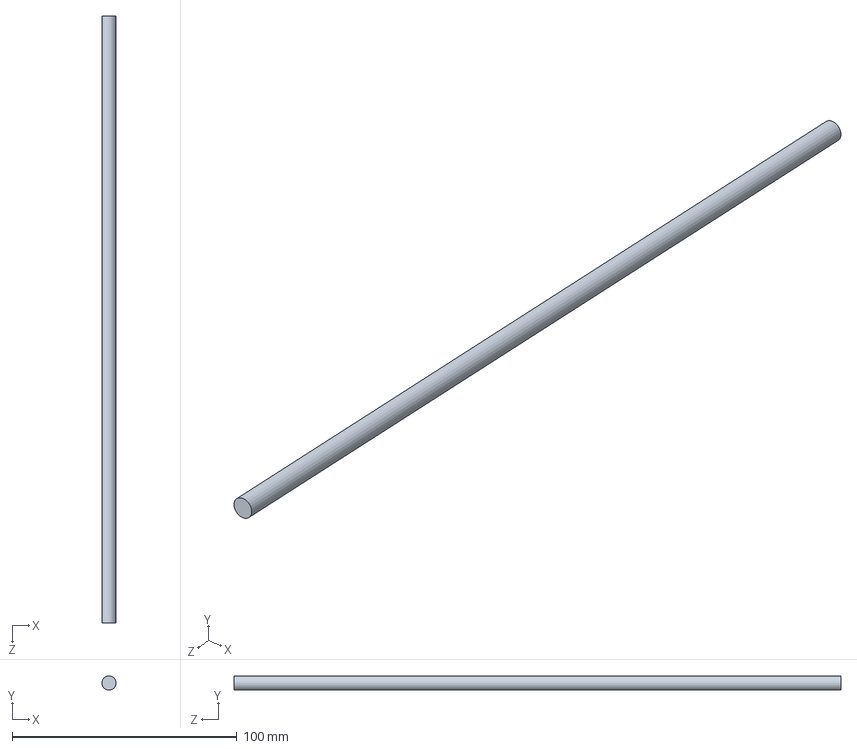
[picture p65: CAD file, 2019-12-06]
Gravity Car/Front Axle/Wooden Rod.SLDPRT
6.35 x 6.35 x 270.0 mm
