flasch97/Mech-2220-Project-Gravity-Car/Gravity Car/Motion Analysis/Ramp.SLDPRT

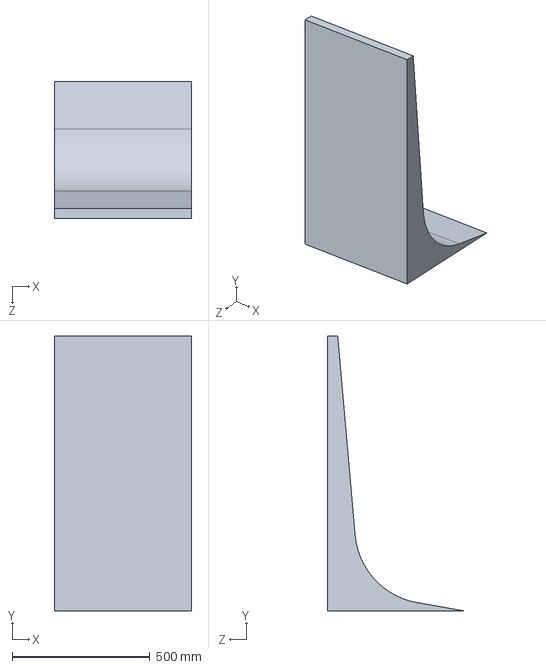
[picture p66: CAD file, 2019-12-06]
Gravity Car/Motion Analysis/Ramp.SLDPRT
500.0 x 1000.0 x 500.0 mm
