flasch97/Mech-2220-Project-Gravity-Car/Gravity Car/Release Mechanism/Release support.SLDPRT

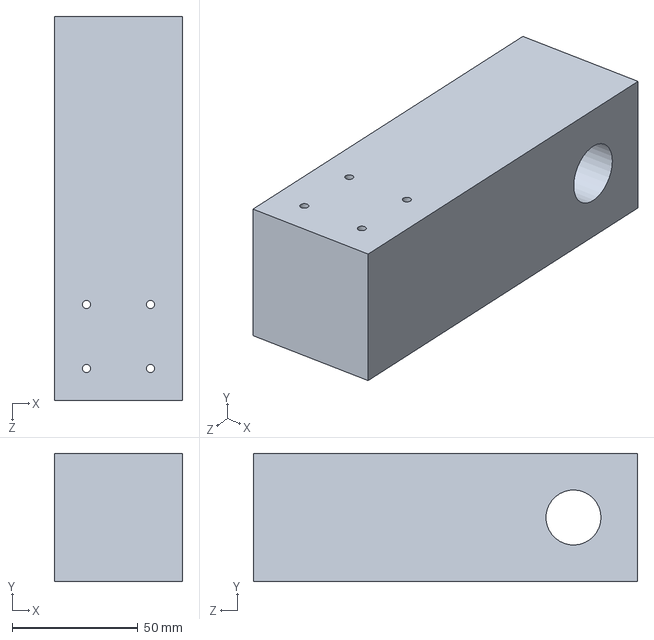
[picture p67: CAD file, 2019-12-06]
Gravity Car/Release Mechanism/Release support.SLDPRT
50.8 x 50.8 x 152.4 mm
