flasch97/Mech-2220-Project-Gravity-Car/Gravity Car/Front Axle/Hardware Parts/WAY LOCKING BALL BEARING CLUTCH.SLDPRT

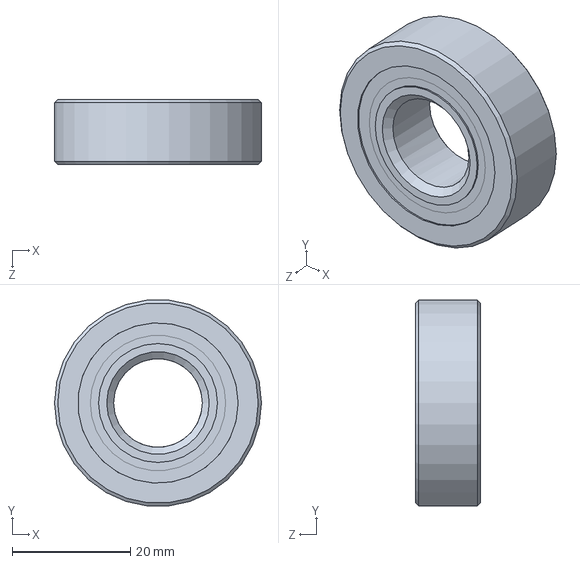
[picture p68: CAD file, 2019-12-06]
Gravity Car/Front Axle/Hardware Parts/WAY LOCKING BALL BEARING CLUTCH.SLDPRT
35.0 x 34.8 x 11.0 mm
