flasch97/Mech-2220-Project-Gravity-Car/Gravity Car/Front Axle/muffle bearing.SLDPRT

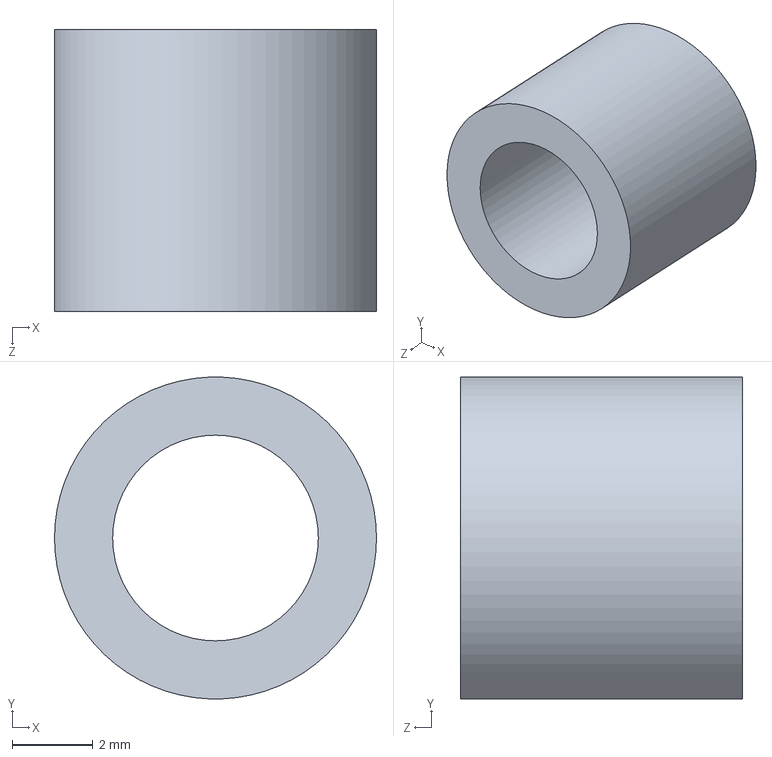
[picture p69: CAD file, 2019-12-06]
Gravity Car/Front Axle/muffle bearing.SLDPRT
8.00 x 7.99 x 7.00 mm
