flasch97/Mech-2220-Project-Gravity-Car/Gravity Car/Ramp/Left Ramp Side.SLDPRT

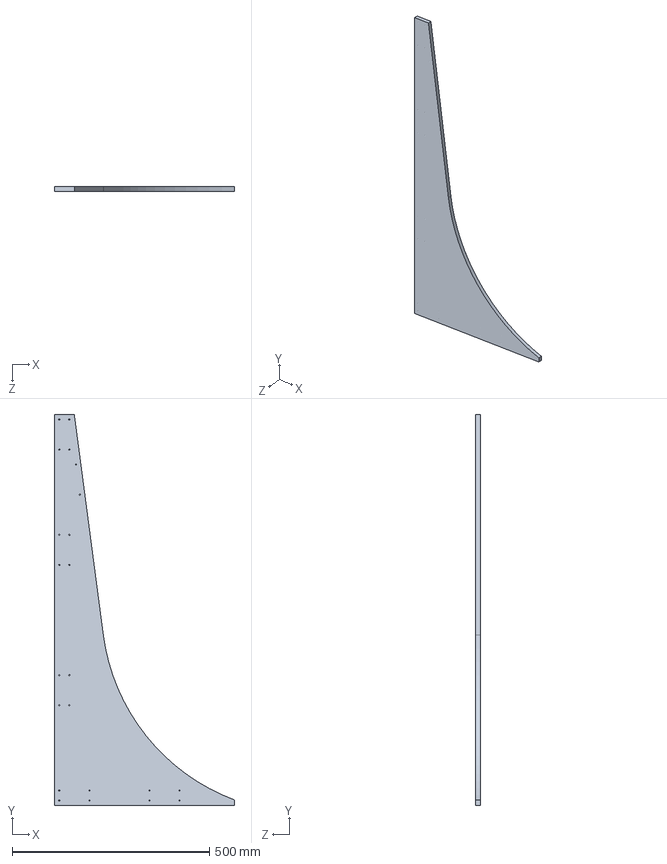
[picture p70: CAD file, 2019-12-06]
Gravity Car/Ramp/Left Ramp Side.SLDPRT
457.2 x 990.6 x 11.9 mm
