flasch97/Mech-2220-Project-Gravity-Car/Gravity Car/Rear Axle/threaded axle rear left.SLDPRT

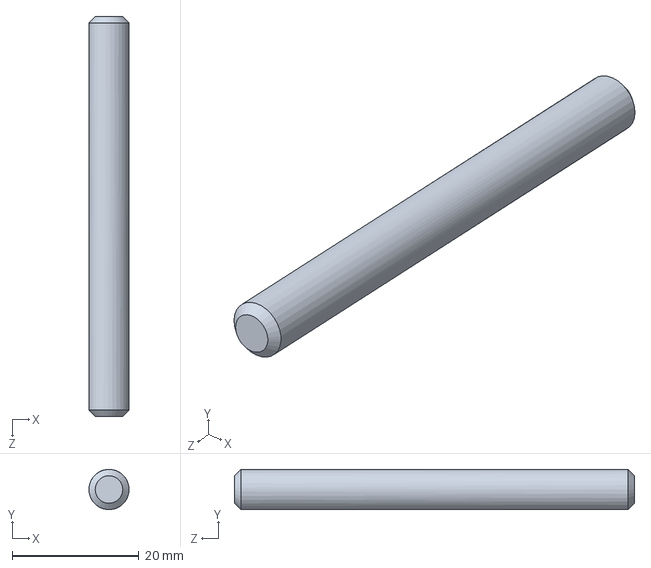
[picture p71: CAD file, 2019-12-06]
Gravity Car/Rear Axle/threaded axle rear left.SLDPRT
6.35 x 6.34 x 63.1 mm
