flasch97/Mech-2220-Project-Gravity-Car/Gravity Car/Release Mechanism/RELEASE HOOK.SLDPRT

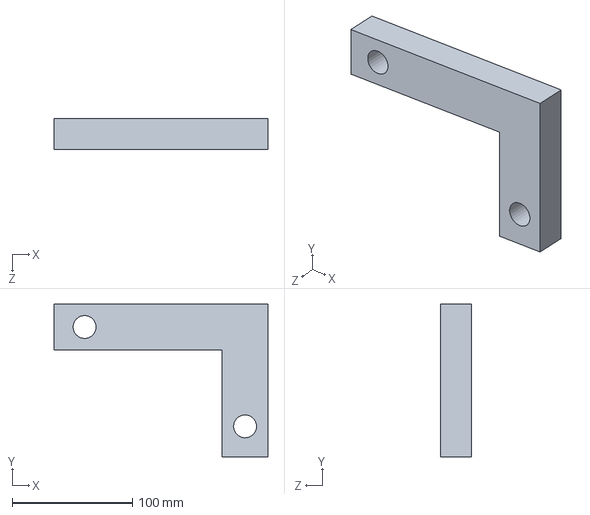
[picture p72: CAD file, 2019-12-06]
Gravity Car/Release Mechanism/RELEASE HOOK.SLDPRT
177.8 x 127.0 x 25.4 mm
