flasch97/Mech-2220-Project-Gravity-Car/Gravity Car/Split frame/Compression Spring.SLDPRT

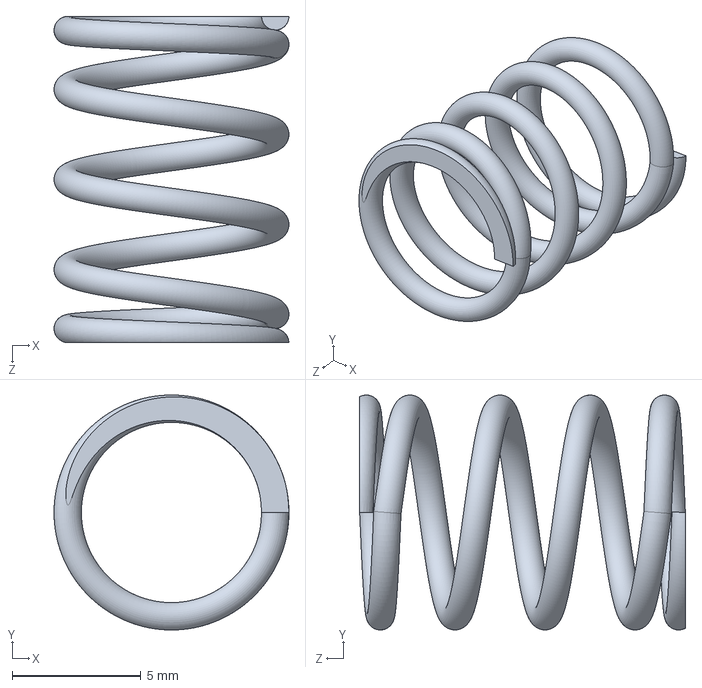
[picture p73: CAD file, 2019-12-06]
Gravity Car/Split frame/Compression Spring.SLDPRT
9.14 x 9.14 x 12.7 mm
