flasch97/Mech-2220-Project-Gravity-Car/Gravity Car/Motion Analysis/Front Wheel.SLDPRT

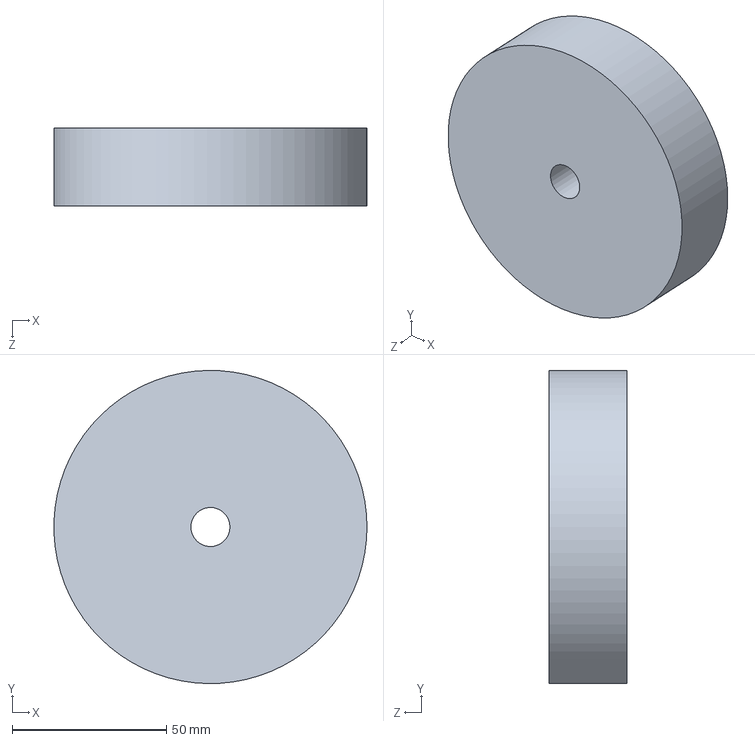
[picture p74: CAD file, 2019-12-06]
Gravity Car/Motion Analysis/Front Wheel.SLDPRT
101.6 x 101.6 x 25.4 mm
