flasch97/Mech-2220-Project-Gravity-Car/Gravity Car/Ramp/base support.SLDPRT

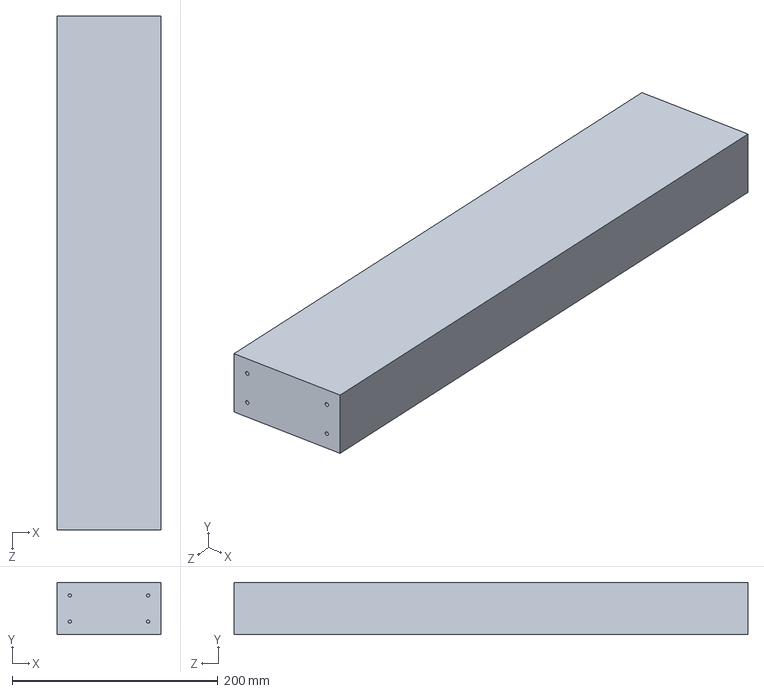
[picture p75: CAD file, 2019-12-06]
Gravity Car/Ramp/base support.SLDPRT
101.6 x 50.8 x 500.0 mm
