flasch97/Mech-2220-Project-Gravity-Car/Gravity Car/RampSight/laserpointereal.SLDPRT

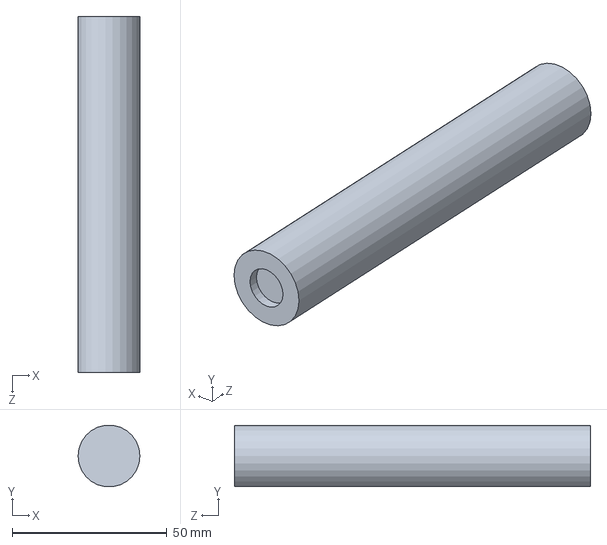
[picture p76: CAD file, 2019-12-06]
Gravity Car/RampSight/laserpointereal.SLDPRT
20.0 x 19.9 x 115.0 mm
