flasch97/Mech-2220-Project-Gravity-Car/Gravity Car/Rear Axle/Wheel.SLDPRT

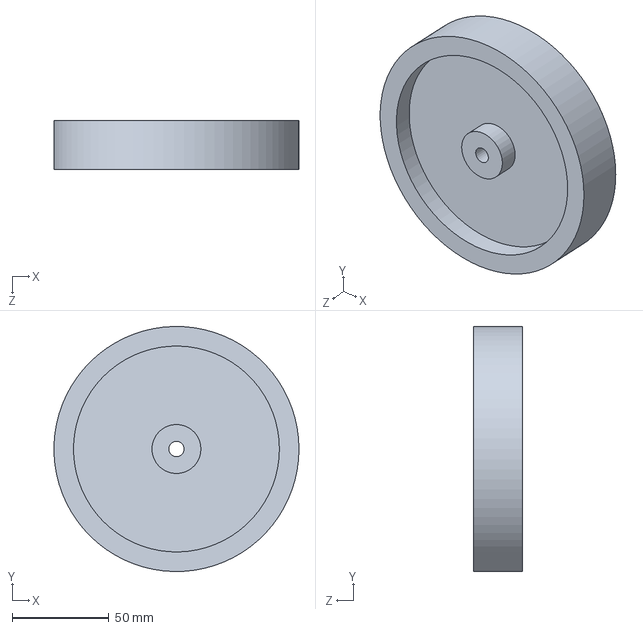
[picture p77: CAD file, 2019-12-06]
Gravity Car/Rear Axle/Wheel.SLDPRT
126.9 x 127.0 x 25.4 mm
