flasch97/Mech-2220-Project-Gravity-Car/Gravity Car/Release Mechanism/Hook Dowel.SLDPRT

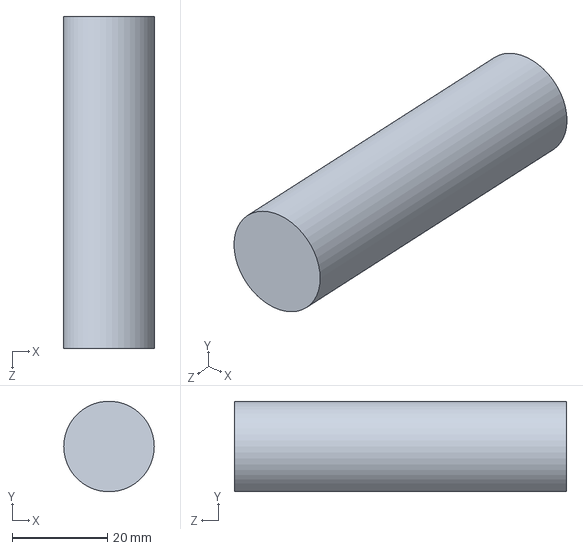
[picture p78: CAD file, 2019-12-06]
Gravity Car/Release Mechanism/Hook Dowel.SLDPRT
19.1 x 19.0 x 69.8 mm
