flasch97/Mech-2220-Project-Gravity-Car/Gravity Car/Split frame/micrometer.SLDPRT

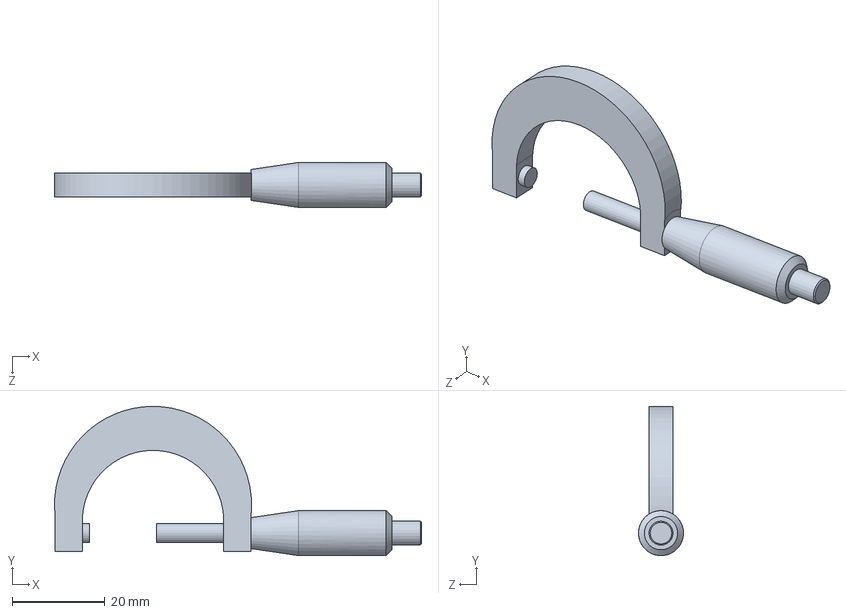
[picture p79: CAD file, 2019-12-06]
Gravity Car/Split frame/micrometer.SLDPRT
79.2 x 32.2 x 9.73 mm
