flasch97/Mech-2220-Project-Gravity-Car/Gravity Car/Front Axle/Threaded Axle Front Right.SLDPRT

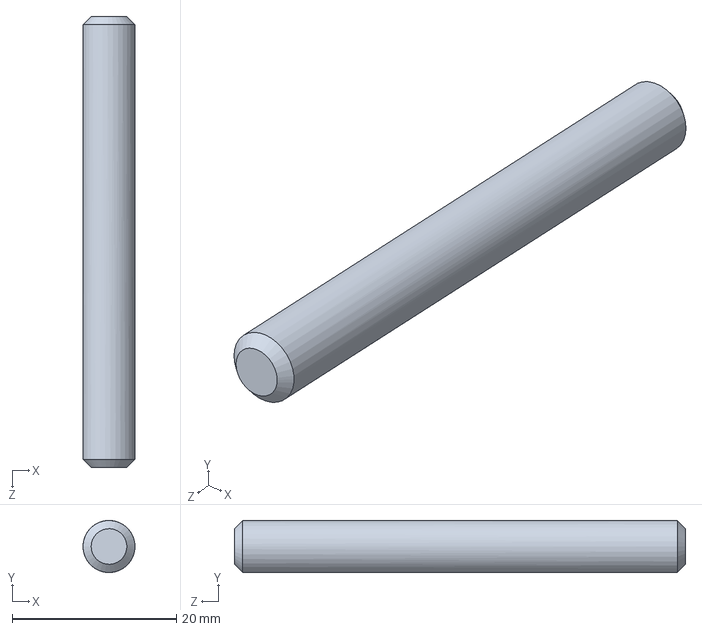
[picture p80: CAD file, 2019-12-06]
Gravity Car/Front Axle/Threaded Axle Front Right.SLDPRT
6.35 x 6.34 x 55.0 mm
