flasch97/Mech-2220-Project-Gravity-Car/Gravity Car/Ramp/Ramp Right Side.SLDPRT

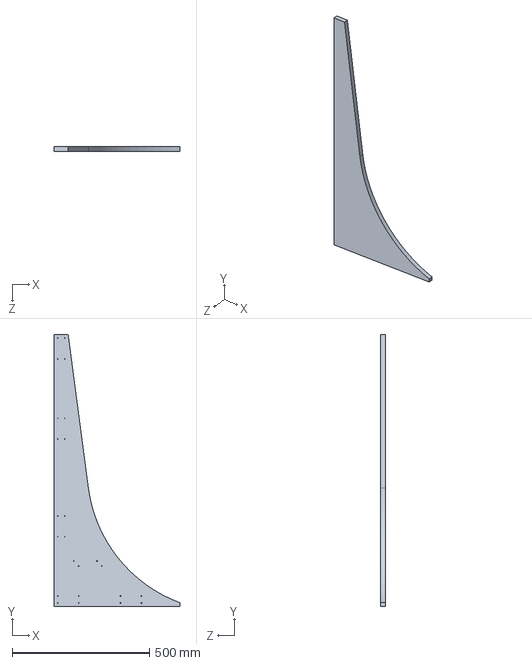
[picture p81: CAD file, 2019-12-06]
Gravity Car/Ramp/Ramp Right Side.SLDPRT
457.2 x 990.6 x 18.3 mm
