flasch97/Mech-2220-Project-Gravity-Car/Gravity Car/Rear Axle/Connection Rear Suspention.SLDPRT

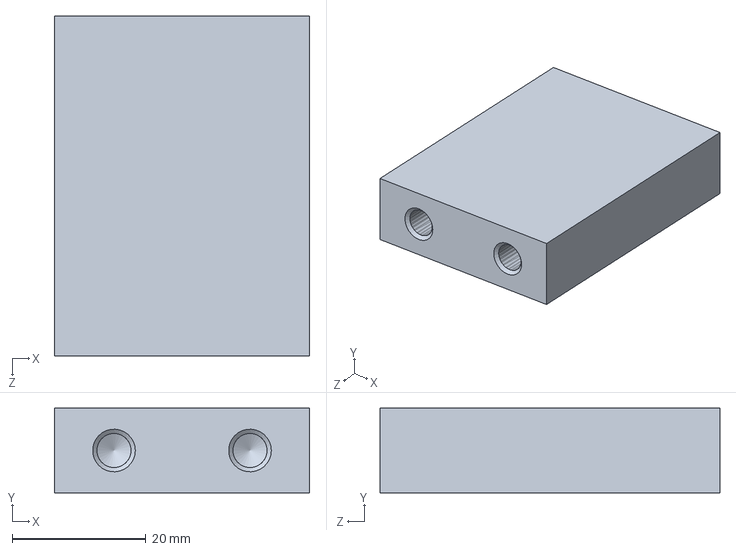
[picture p82: CAD file, 2019-12-06]
Gravity Car/Rear Axle/Connection Rear Suspention.SLDPRT
38.1 x 12.7 x 50.8 mm
