flasch97/Mech-2220-Project-Gravity-Car/Gravity Car/Release Mechanism/Release Dowel.SLDPRT

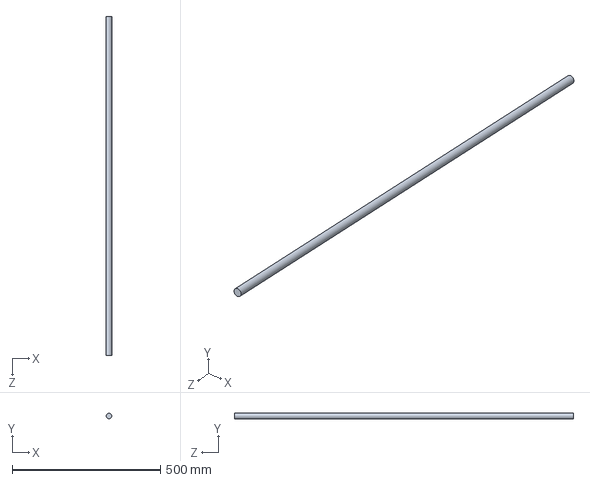
[picture p83: CAD file, 2019-12-06]
Gravity Car/Release Mechanism/Release Dowel.SLDPRT
19.1 x 19.1 x 1143.0 mm
