flasch97/Mech-2220-Project-Gravity-Car/Gravity Car/Split frame/Clevis Pin.SLDPRT

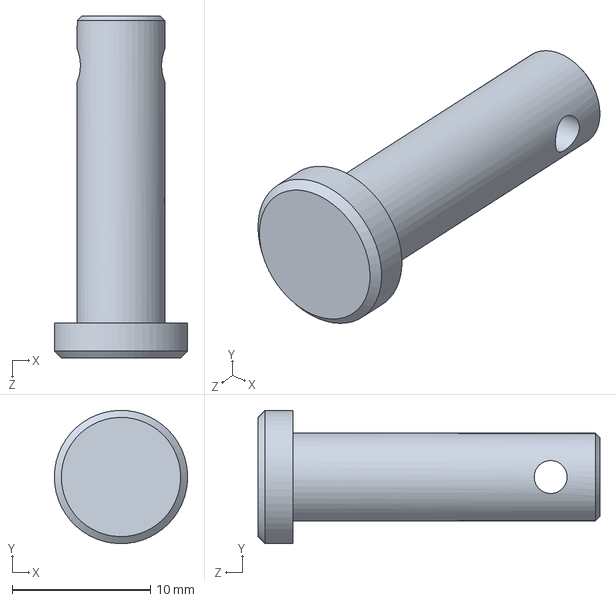
[picture p84: CAD file, 2019-12-06]
Gravity Car/Split frame/Clevis Pin.SLDPRT
9.65 x 9.65 x 24.8 mm
