flasch97/Mech-2220-Project-Gravity-Car/Gravity Car/Front Axle/suspension front.SLDPRT

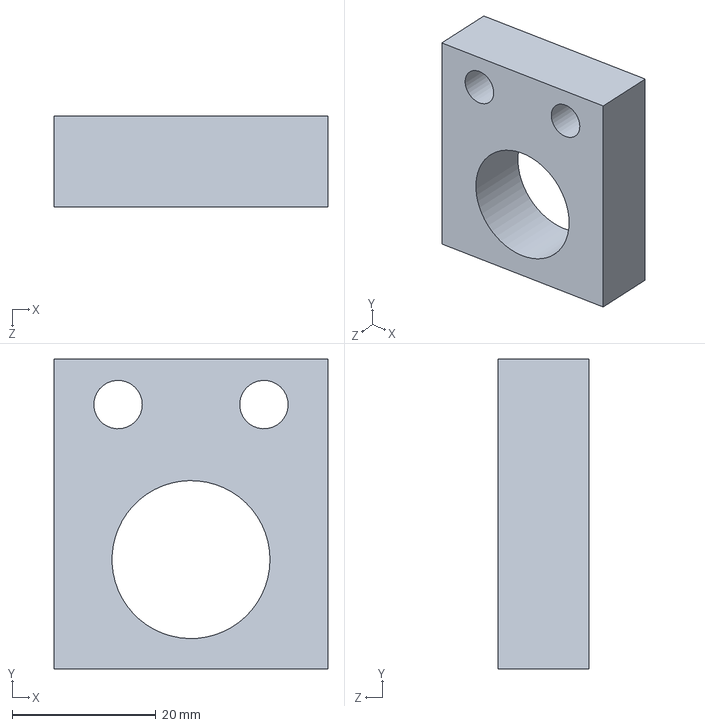
[picture p85: CAD file, 2019-12-06]
Gravity Car/Front Axle/suspension front.SLDPRT
38.1 x 43.2 x 12.7 mm
