flasch97/Mech-2220-Project-Gravity-Car/Gravity Car/Motion Analysis/frame.SLDPRT

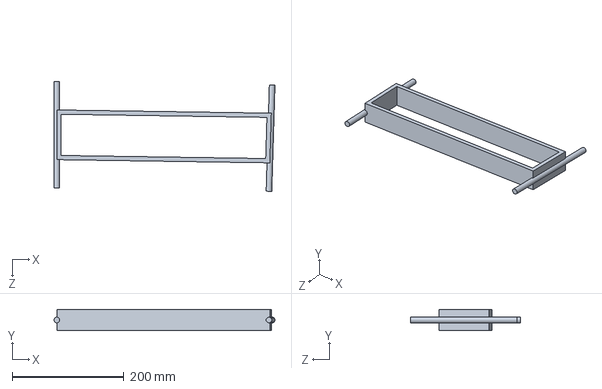
[picture p86: CAD file, 2019-12-06]
Gravity Car/Motion Analysis/frame.SLDPRT
395.3 x 38.1 x 196.3 mm
