flasch97/Mech-2220-Project-Gravity-Car/Gravity Car/RampSight/LaserStrap.SLDPRT

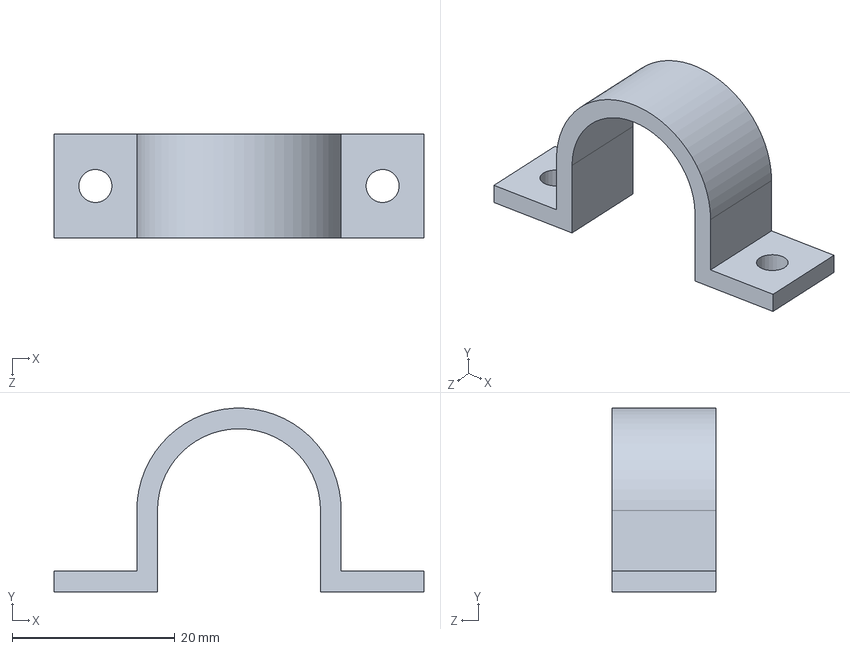
[picture p87: CAD file, 2019-12-06]
Gravity Car/RampSight/LaserStrap.SLDPRT
45.4 x 22.5 x 12.7 mm
