flasch97/Mech-2220-Project-Gravity-Car/Gravity Car/Rear Axle/suspension rear.SLDPRT

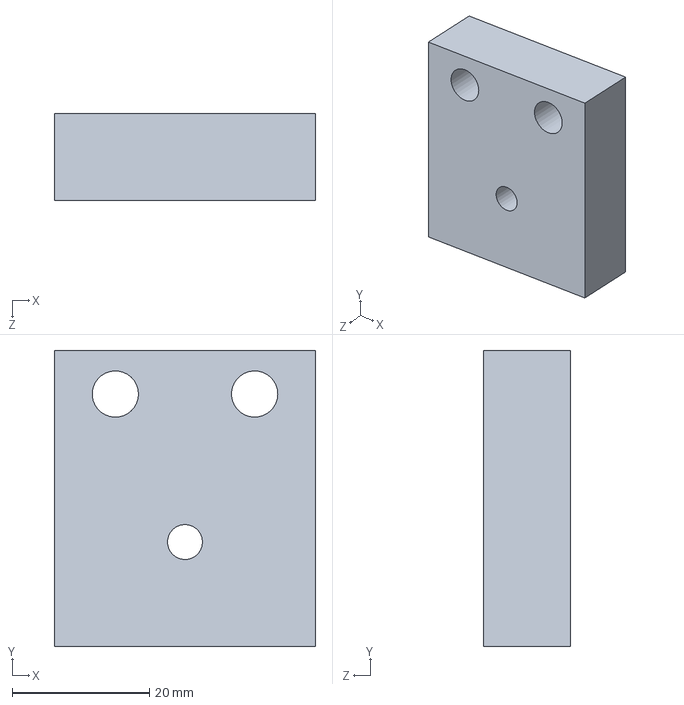
[picture p88: CAD file, 2019-12-06]
Gravity Car/Rear Axle/suspension rear.SLDPRT
38.1 x 43.2 x 12.7 mm
