flasch97/Mech-2220-Project-Gravity-Car/Gravity Car/Split frame/Frame 1 Rear.SLDPRT

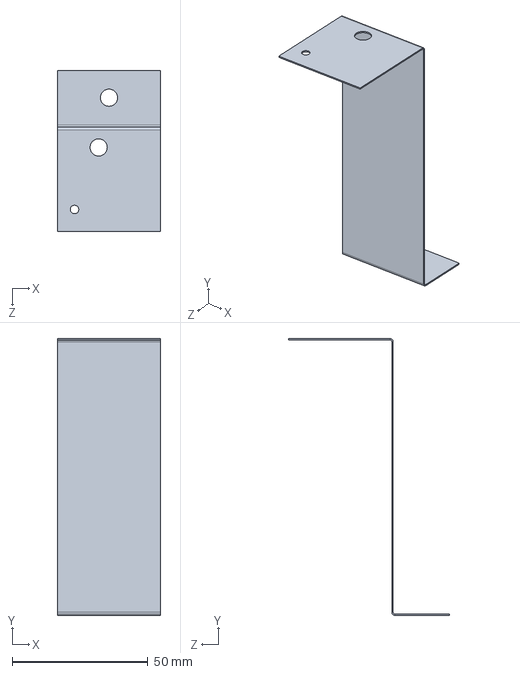
[picture p89: CAD file, 2019-12-06]
Gravity Car/Split frame/Frame 1 Rear.SLDPRT
38.1 x 102.1 x 59.3 mm
