flasch97/Mech-2220-Project-Gravity-Car/Gravity Car/Motion Analysis/floor arc.SLDPRT

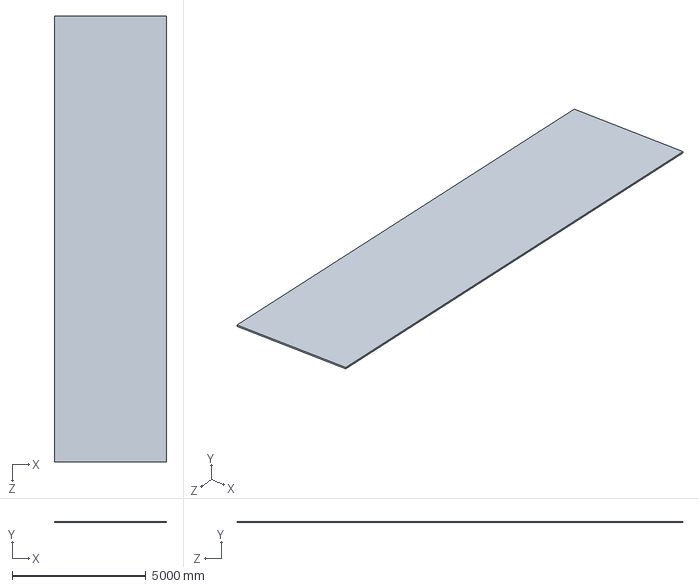
[picture p90: CAD file, 2019-12-06]
Gravity Car/Motion Analysis/floor arc.SLDPRT
4194.1 x 50.0 x 16654.9 mm
