flasch97/Mech-2220-Project-Gravity-Car/Gravity Car/Ramp/ramp top.SLDPRT

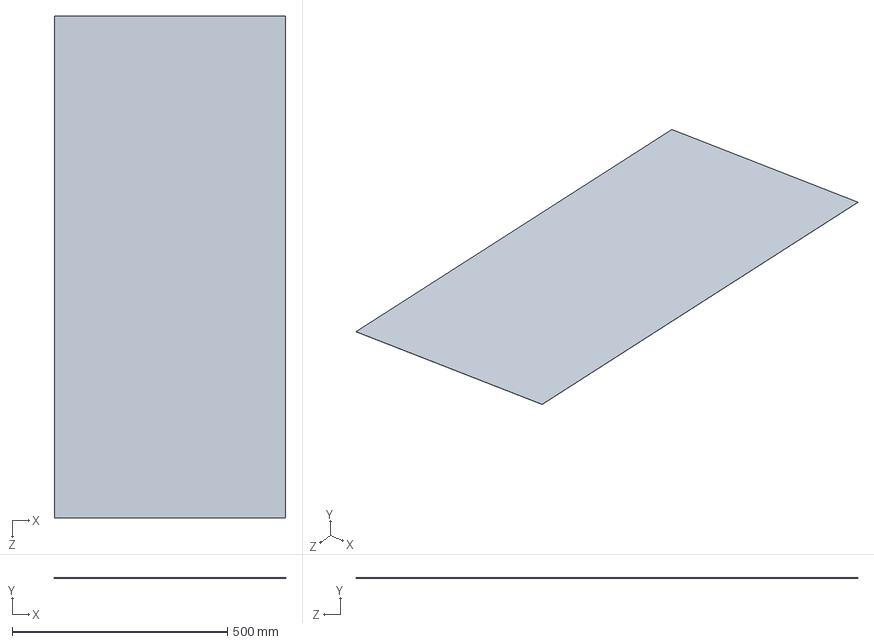
[picture p91: CAD file, 2019-12-06]
Gravity Car/Ramp/ramp top.SLDPRT
536.4 x 0.317 x 1165.1 mm
