flasch97/Mech-2220-Project-Gravity-Car/Gravity Car/RampSight/RampSight.SLDPRT

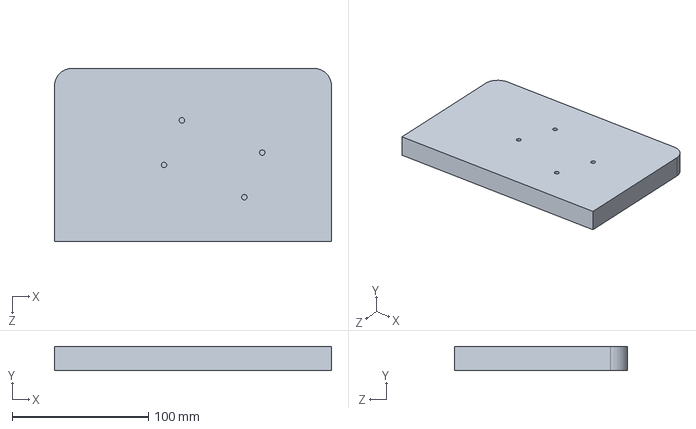
[picture p92: CAD file, 2019-12-06]
Gravity Car/RampSight/RampSight.SLDPRT
203.2 x 17.8 x 127.0 mm
