flasch97/Mech-2220-Project-Gravity-Car/Gravity Car/Rear Axle/threaded axle rear right.SLDPRT

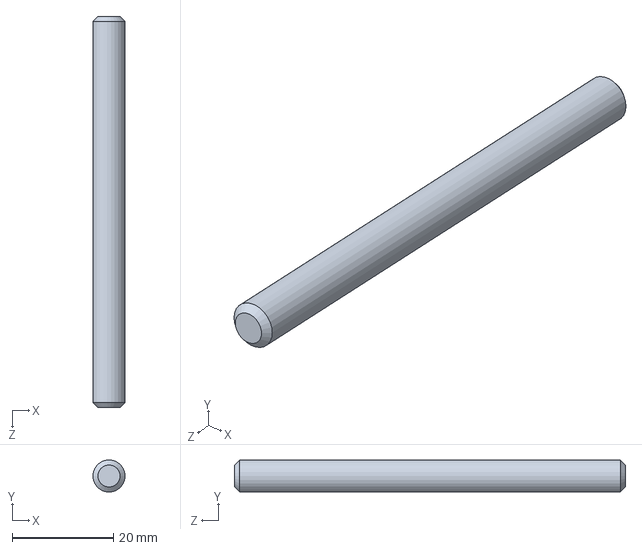
[picture p93: CAD file, 2019-12-06]
Gravity Car/Rear Axle/threaded axle rear right.SLDPRT
6.35 x 6.30 x 77.1 mm
