flasch97/Mech-2220-Project-Gravity-Car/Gravity Car/Release Mechanism/Release Lever.SLDPRT

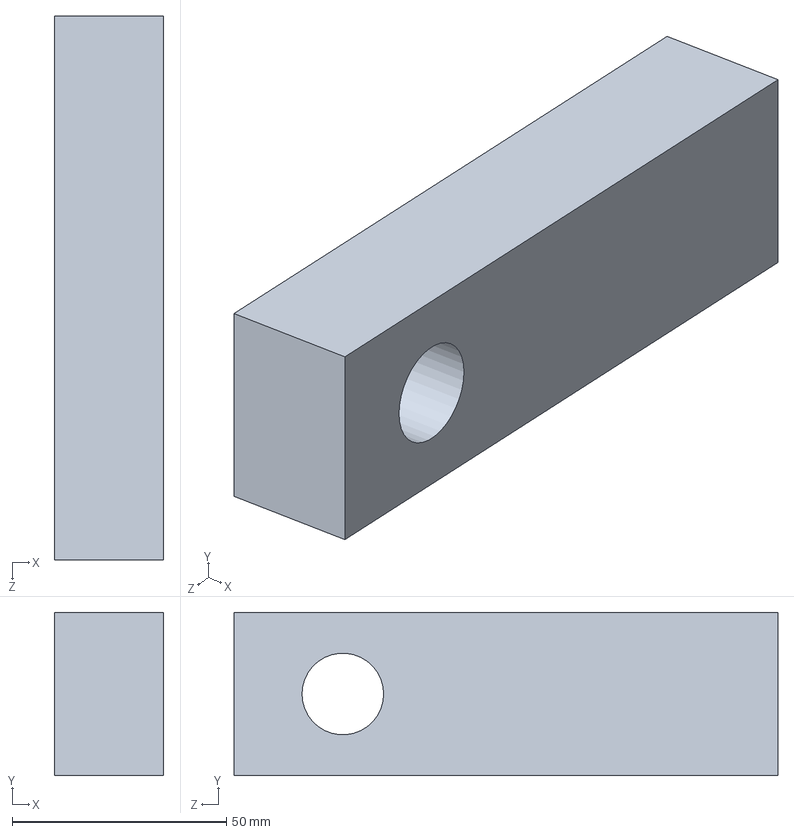
[picture p94: CAD file, 2019-12-06]
Gravity Car/Release Mechanism/Release Lever.SLDPRT
25.4 x 38.1 x 127.0 mm
