flasch97/Mech-2220-Project-Gravity-Car/Gravity Car/Front Axle/muffle wheel left.SLDPRT

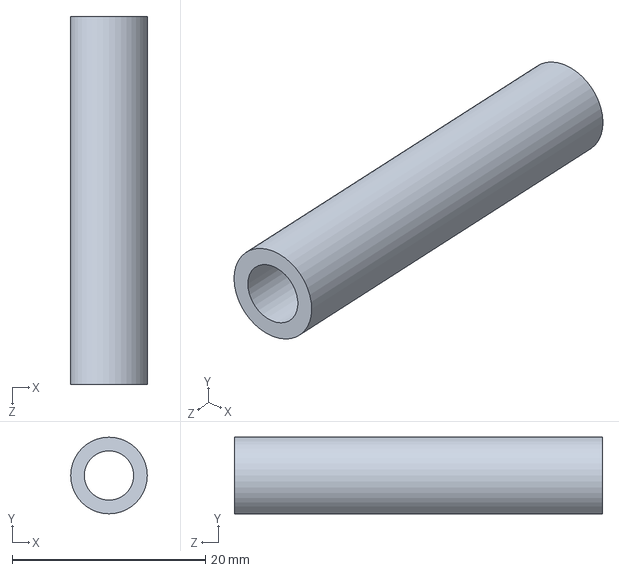
[picture p95: CAD file, 2019-12-06]
Gravity Car/Front Axle/muffle wheel left.SLDPRT
7.94 x 7.94 x 38.1 mm
