flasch97/Mech-2220-Project-Gravity-Car/Gravity Car/Rear Axle/muffle rear wheels.SLDPRT

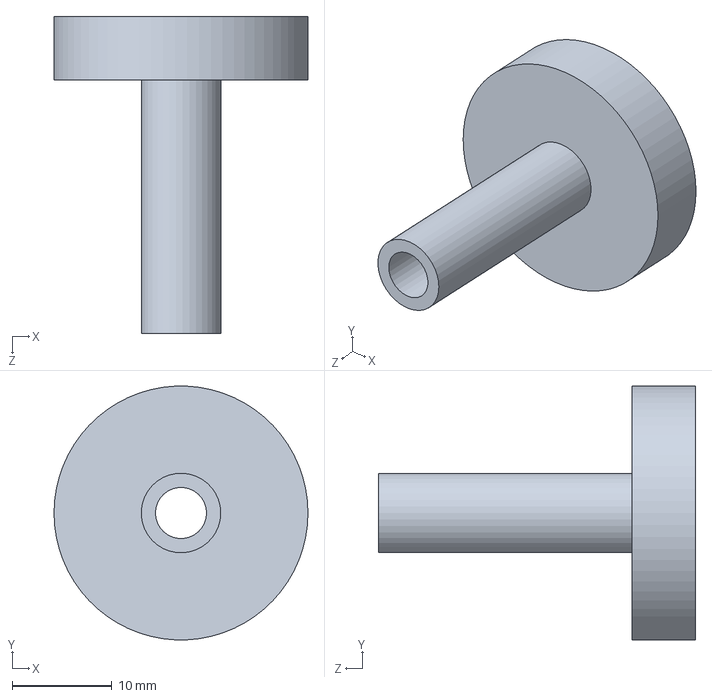
[picture p96: CAD file, 2019-12-06]
Gravity Car/Rear Axle/muffle rear wheels.SLDPRT
25.4 x 25.4 x 31.8 mm
