flasch97/Mech-2220-Project-Gravity-Car/Gravity Car/Split frame/Dovel Pin.SLDPRT

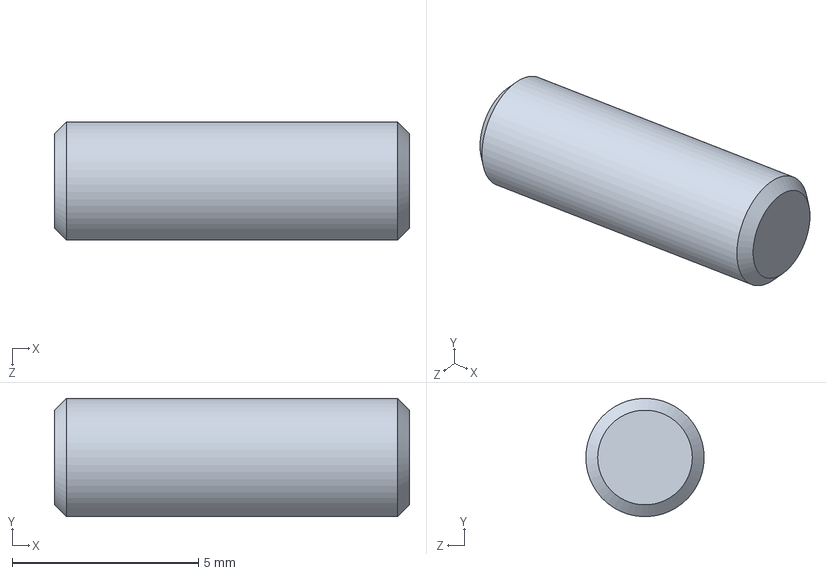
[picture p97: CAD file, 2019-12-06]
Gravity Car/Split frame/Dovel Pin.SLDPRT
9.52 x 3.17 x 3.17 mm
