flasch97/Mech-2220-Project-Gravity-Car/Gravity Car/Ramp/Position Marker.SLDPRT

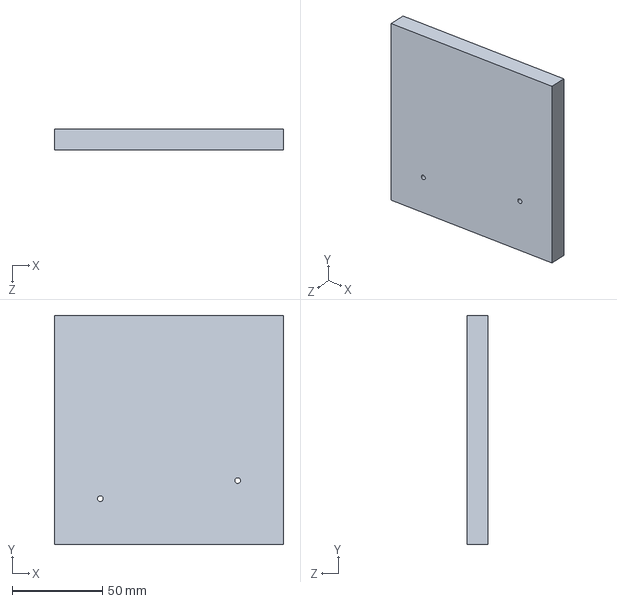
[picture p98: CAD file, 2019-12-06]
Gravity Car/Ramp/Position Marker.SLDPRT
127.0 x 127.0 x 11.9 mm
