flasch97/Mech-2220-Project-Gravity-Car/Gravity Car/Split frame/Frame 2.SLDPRT

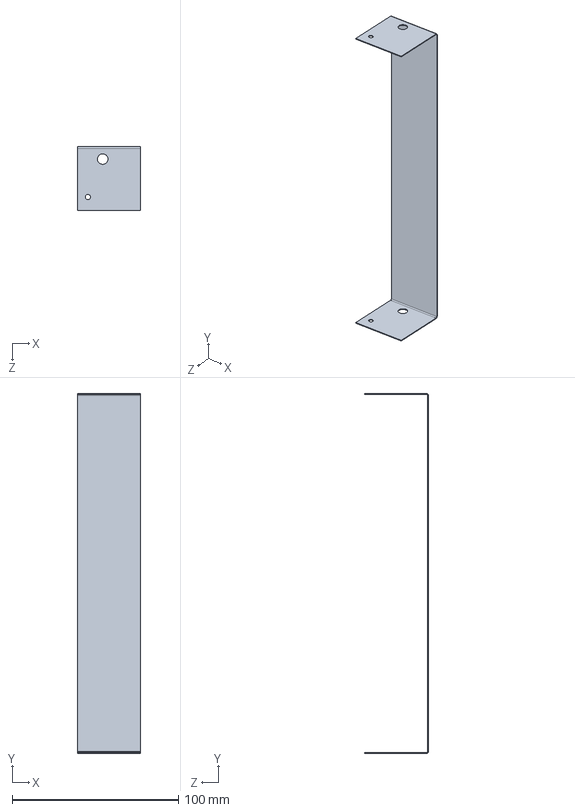
[picture p99: CAD file, 2019-12-06]
Gravity Car/Split frame/Frame 2.SLDPRT
38.1 x 216.8 x 38.6 mm
