flasch97/Mech-2220-Project-Gravity-Car/Gravity Car/Front Axle/Wingnut.SLDPRT

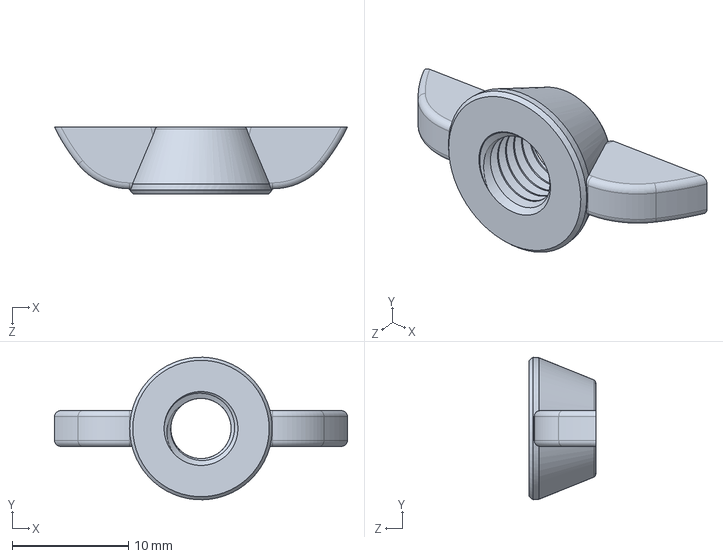
[picture p100: CAD file, 2019-12-06]
Gravity Car/Front Axle/Wingnut.SLDPRT
25.2 x 12.2 x 5.71 mm
