flasch97/Mech-2220-Project-Gravity-Car/Gravity Car/Front Axle/Compression Spring Break.SLDPRT

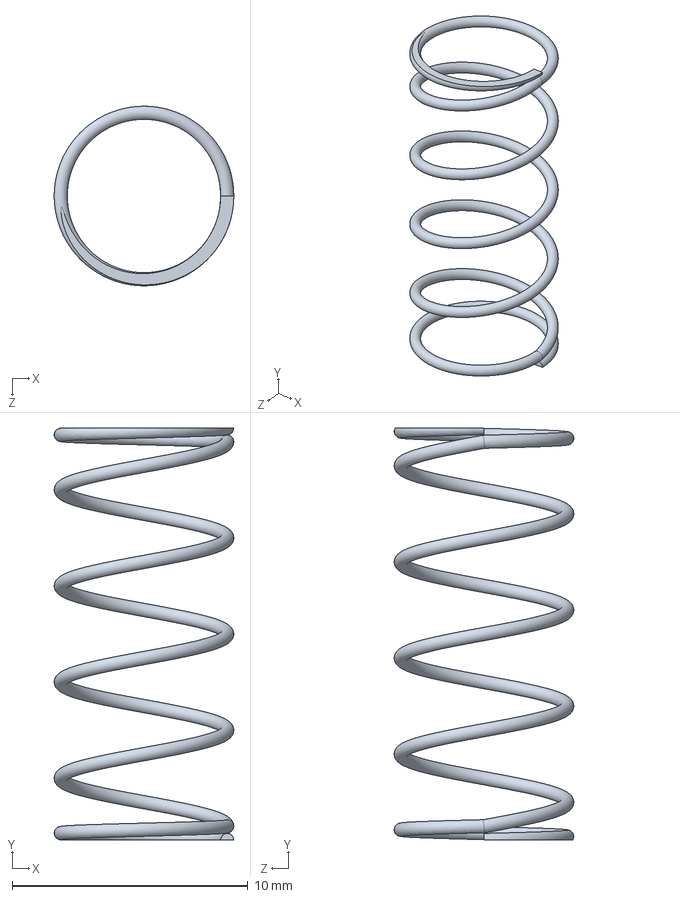
[picture p101: CAD file, 2019-12-06]
Gravity Car/Front Axle/Compression Spring Break.SLDPRT
7.62 x 17.5 x 7.62 mm
