flasch97/Mech-2220-Project-Gravity-Car/Gravity Car/Front Axle/Connection Front Suspention.SLDPRT

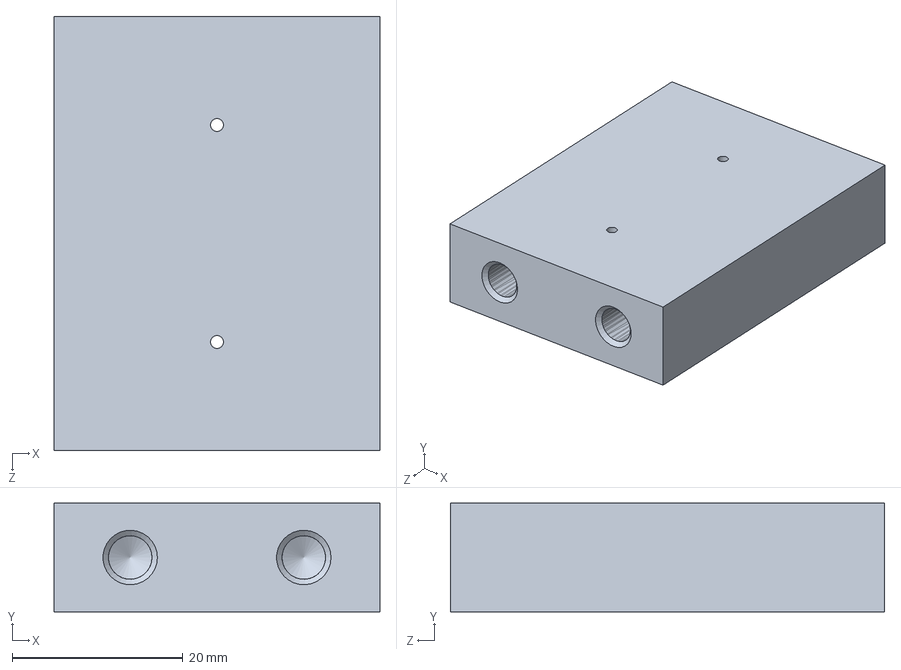
[picture p102: CAD file, 2019-12-06]
Gravity Car/Front Axle/Connection Front Suspention.SLDPRT
38.1 x 12.7 x 50.8 mm
