flasch97/Mech-2220-Project-Gravity-Car/Gravity Car/Front Axle/muffle wheel right.SLDPRT

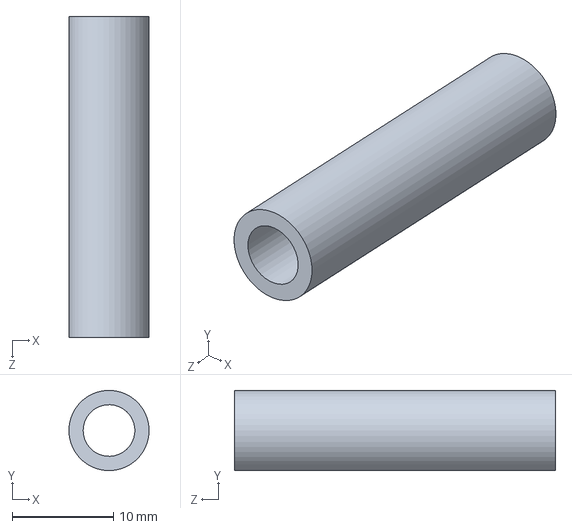
[picture p103: CAD file, 2019-12-06]
Gravity Car/Front Axle/muffle wheel right.SLDPRT
7.94 x 7.94 x 31.8 mm
