flasch97/Mech-2220-Project-Gravity-Car/Gravity Car/Front Axle/Threaded Axle Front Left.SLDPRT

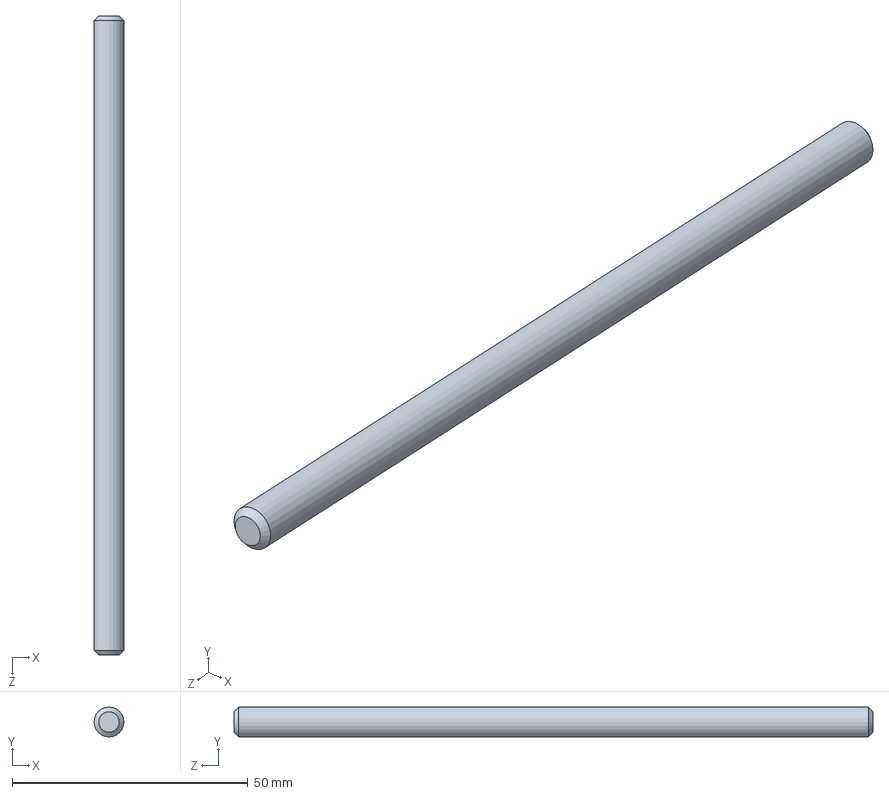
[picture p104: CAD file, 2019-12-06]
Gravity Car/Front Axle/Threaded Axle Front Left.SLDPRT
6.35 x 6.35 x 135.5 mm
