flasch97/Mech-2220-Project-Gravity-Car/Gravity Car/Front Axle/Adapter One-Way-Bearing.SLDPRT

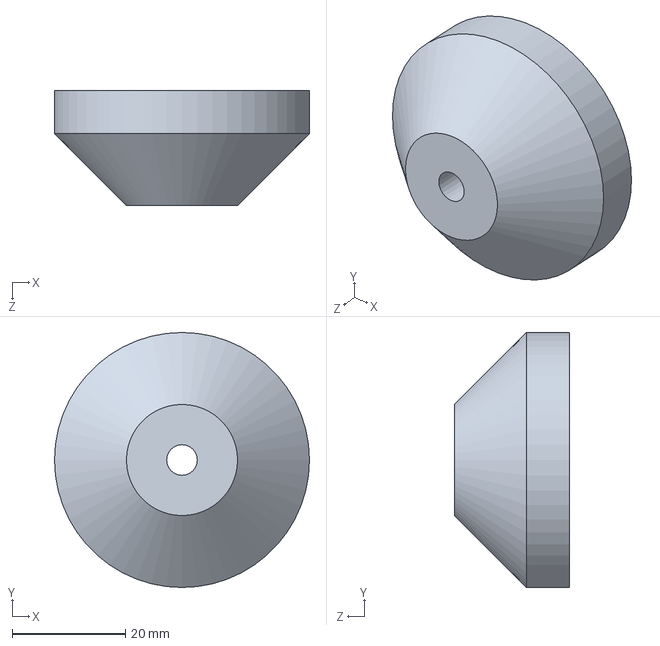
[picture p105: CAD file, 2019-12-06]
Gravity Car/Front Axle/Adapter One-Way-Bearing.SLDPRT
45.0 x 45.0 x 20.3 mm
