flasch97/Mech-2220-Project-Gravity-Car/Gravity Car/Front Axle/Muffle One-Way-Bearing.SLDPRT

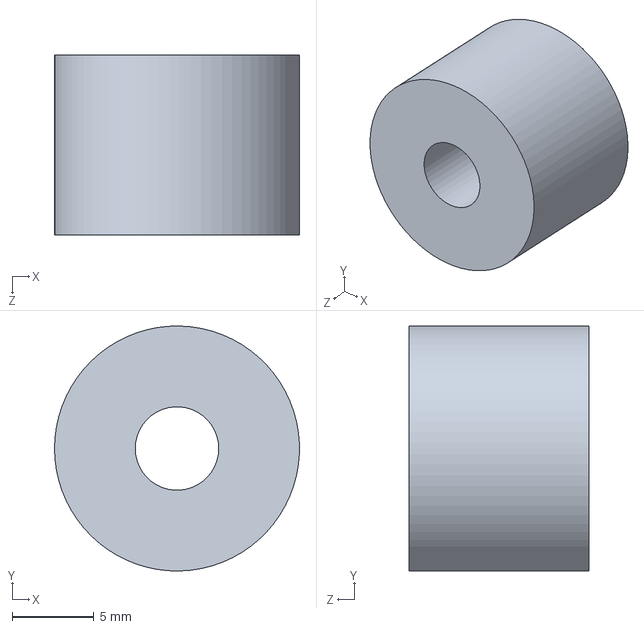
[picture p106: CAD file, 2019-12-06]
Gravity Car/Front Axle/Muffle One-Way-Bearing.SLDPRT
15.0 x 15.0 x 11.0 mm
