flasch97/Mech-2220-Project-Gravity-Car/(list of files, cad)

Other CAD files:
Gravity Car/Motion Analysis/calculation arc.SLDPRT
Gravity Car/Ramp/Ramp Left Side.SLDPRT
Gravity Car/Split frame/Frame 1 Front.SLDPRT
Gravity Car/Front Axle/suspension.SLDPRT
Gravity Car/Front Axle/Wheel.SLDPRT
Gravity Car/Front Axle/Front Wheel.SLDPRT
Gravity Car/Front Axle/One-Way-Bearing.SLDPRT
Gravity Car/Front Axle/muffle bearing left.SLDPRT
Gravity Car/Front Axle/608 Ball Bearing.SLDPRT
Gravity Car/Assembly car/Gravity car assembly (Split frame).SLDDRW
Gravity Car/Complete Assembly/Ramp and Car.SLDDRW
Gravity Car/Front Axle/316 Stainless Steel Washer.SLDPRT
Gravity Car/Front Axle/92771A521_BRASS WING NUT.SLDPRT
Gravity Car/Front Axle/Button Head Hex Drive Screw 1-4-28.SLDPRT
Gravity Car/Front Axle/Button Head Hex Drive Screw 1-64.SLDPRT
Gravity Car/Front Axle/Drawings/316 Stainless Steel Washer.SLDDRW
Gravity Car/Front Axle/Drawings/608 Ball Bearing.SLDDRW
Gravity Car/Front Axle/Drawings/Adapter One-Way-Bearing.SLDDRW
Gravity Car/Front Axle/Drawings/Button Head Hex Screw 1-4-20.SLDDRW
Gravity Car/Front Axle/Drawings/Compression Spring Break.SLDDRW
Gravity Car/Front Axle/Drawings/Connection Front Suspention.SLDDRW
Gravity Car/Front Axle/Drawings/Front Axle Assembly.SLDDRW
Gravity Car/Front Axle/Drawings/Muffle Bearing.SLDDRW
Gravity Car/Front Axle/Drawings/Muffle One-Way-Bearing.SLDDRW
Gravity Car/Front Axle/Drawings/Muffle Wheel Left.SLDDRW
Gravity Car/Front Axle/Drawings/Muffle Wheel Right.SLDDRW
Gravity Car/Front Axle/Drawings/One-Way-Bearing.SLDDRW
Gravity Car/Front Axle/Drawings/Slide Wing Nut 1.SLDDRW
Gravity Car/Front Axle/Drawings/Slide Wing Nut 2.SLDDRW
Gravity Car/Front Axle/Drawings/Stainless Steel Button Head Hex Drive Screw 1-64.SLDDRW
Gravity Car/Front Axle/Drawings/Stainless Steel Thin Hex Nut 1-4-28.SLDDRW
Gravity Car/Front Axle/Drawings/Suspension Front.SLDDRW
Gravity Car/Front Axle/Drawings/Threaded Axle Front Left.SLDDRW
Gravity Car/Front Axle/Drawings/Threaded Axle Front Right.SLDDRW
Gravity Car/Front Axle/Drawings/Wheel.SLDDRW
Gravity Car/Front Axle/Drawings/Wingnut.SLDDRW
Gravity Car/Front Axle/Drawings/Wooden Rod.SLDDRW
Gravity Car/Front Axle/Hardware Parts/9434K520_MUSIC-WIRE STEEL COMPRESSION SPRINGS.SLDPRT
Gravity Car/Front Axle/Hardware Parts/BUTTON HEAD HEX DRIVE SCREW 1-24-28.SLDPRT
Gravity Car/Front Axle/Hardware Parts/BUTTON HEAD HEX DRIVE SCREW 1-64.SLDPRT
Gravity Car/Front Axle/Hardware Parts/STAINLESS STEEL FLAT WASHER.SLDPRT
Gravity Car/Front Axle/Hardware Parts/STAINLESS STEEL THIN HEX NUT.SLDPRT
Gravity Car/Front Axle/Hardware Parts/WING NUT 0.25 - 28.SLDPRT
Gravity Car/Front Axle/Slide Wing Nut.SLDPRT
Gravity Car/Front Axle/Stainless Steel Thin Hex Nut 1-4-28.SLDPRT
Gravity Car/Front Axle/muffle one way bearing.SLDPRT
Gravity Car/Ramp System/Biggest Wood Screw.SLDDRW
Gravity Car/Ramp System/Biggest Wood Screw.SLDPRT
Gravity Car/Ramp System/Ramp System.SLDDRW
Gravity Car/Ramp/Left Ramp Side.SLDDRW
Gravity Car/Ramp/Position Marker.SLDDRW
Gravity Car/Ramp/Ramp Right Side.SLDDRW
Gravity Car/Ramp/Ramp.SLDDRW
Gravity Car/Ramp/Smaller Wood Screw.SLDDRW
Gravity Car/Ramp/Smaller Wood Screw.SLDPRT
Gravity Car/Ramp/base support.SLDDRW
Gravity Car/Ramp/ramp top.SLDDRW
Gravity Car/RampSight/screwangle.SLDPRT
Gravity Car/RampSight/sightscrew.SLDPRT
Gravity Car/Rear Axle/Drawings/Connection Rear Suspention.SLDDRW
Gravity Car/Rear Axle/Drawings/muffle rear wheels.SLDDRW
Gravity Car/Rear Axle/Drawings/rear axle assembly.SLDDRW
Gravity Car/Rear Axle/Drawings/suspension rear.SLDDRW
Gravity Car/Rear Axle/Drawings/threaded axle rear left.SLDDRW
Gravity Car/Rear Axle/Drawings/threaded axle rear right.SLDDRW
Gravity Car/Release Mechanism/Hook Dowel.SLDDRW
Gravity Car/Release Mechanism/RELEASE HOOK.SLDDRW
Gravity Car/Release Mechanism/Release Dowel.SLDDRW
Gravity Car/Release Mechanism/Release Lever.SLDDRW
Gravity Car/Release Mechanism/Release Mechanism.SLDDRW
Gravity Car/Release Mechanism/Release support.SLDDRW
Gravity Car/Split frame/Button Head Hex Drive Screw.SLDPRT
Gravity Car/Split frame/Drawings/Button Head Hex Drive Screw.SLDDRW
Gravity Car/Split frame/Drawings/Clevis Pin.SLDDRW
Gravity Car/Split frame/Drawings/Compression Spring.SLDDRW
Gravity Car/Split frame/Drawings/Dovel Pin.SLDDRW
Gravity Car/Split frame/Drawings/Frame 2.SLDDRW
Gravity Car/Split frame/Drawings/Frame 2_Unfolded.SLDDRW
Gravity Car/Split frame/Drawings/Frame1 Front.SLDDRW
Gravity Car/Split frame/Drawings/Frame1 Rear.SLDDRW
Gravity Car/Split frame/Drawings/Frame1_Unfolded Front.SLDDRW
Gravity Car/Split frame/Drawings/Frame1_Unfolded Rear.SLDDRW
Gravity Car/Split frame/Drawings/micrometer.SLDDRW
Gravity Car/Split frame/Hardware/2022N161_MIL. SPEC. COMPRESSION SPRING.SLDPRT
Gravity Car/Split frame/Hardware/92949A537_18-8 SS BUTTON HEAD HEX DRIVE SCREW.SLDPRT
Gravity Car/Split frame/Hardware/98306A158_STEEL CLEVIS PIN.SLDPRT
Gravity Car/Split frame/Hardware/98381A470_ALLOY STEEL DOWEL PIN.SLDPRT
