flasch97/Mech-2220-Project-Gravity-Car/Gravity Car/Drawing PDF files/A2 rear axle assembly.PDF

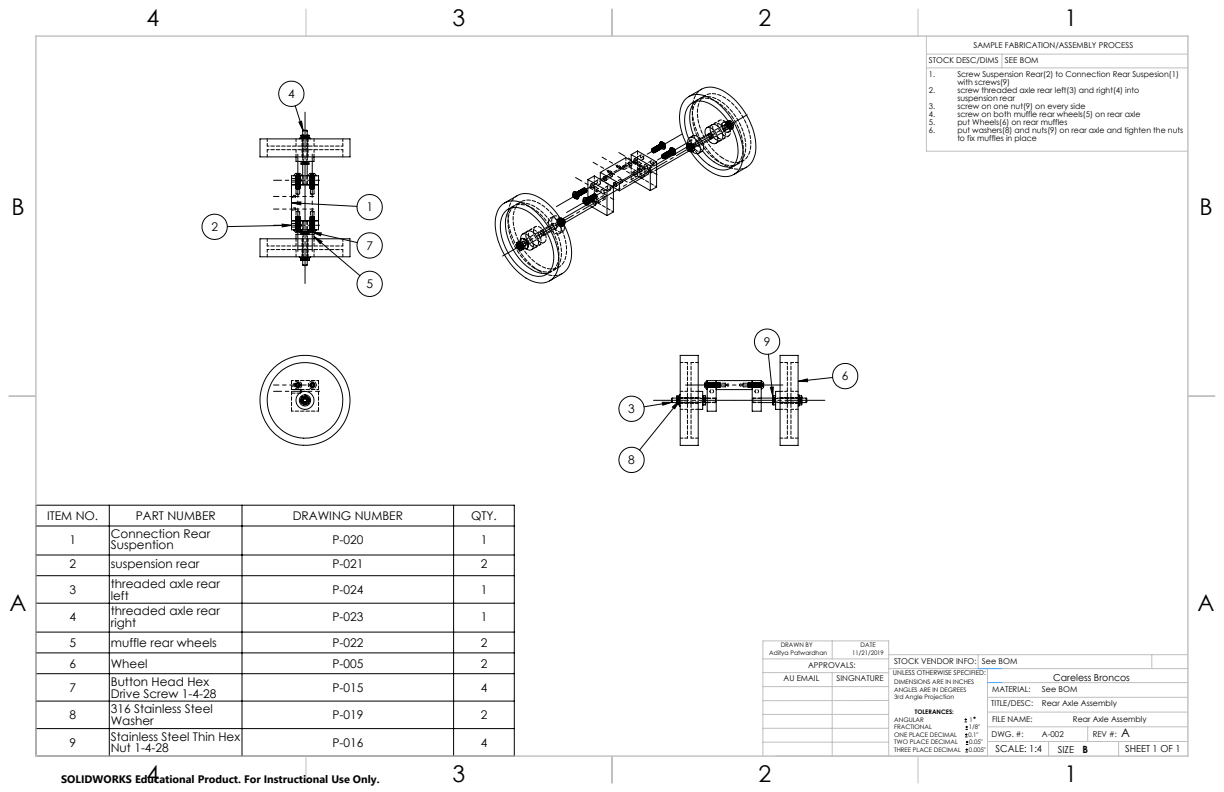
[picture p108: page 1]
Button Head Hex; Drive Screw 1-4-28; 316 Stainless Steel; Stainless Steel Thin Hex; Nut 1-4-28; See BOM; Aditya Patwardhan; FILE NAME:; ONE PLACE DECIMAL; TWO PLACE DECIMAL; DRAWN BY; DATE; DWG. #:; SCALE: 1:4; SHEET 1 OF 1; AU EMAIL; SINGNATURE

SAMPLE FABRICATION/ASSEMBLY PROCESS

STOCK DESC/DIMS | SEE BOM

1. Screw Suspension Rear(2) to Connection Rear Suspesion(1)
with screws(9)
2. screw threaded axle rear left(3) and right(4) into
suspension rear
3. screw on one nut(9) on every side
4. screw on both muffle rear wheels(5) on rear axle
5. put Wheels(6) on rear muffles
6. put washers(8) and nuts(9) on rear axle and tighten the nuts
to fix muffles in place

ITEM NO. | PART NUMBER | DRAWING NUMBER | QTY.
1 | Connection Rear Suspention | P-020 | 1
2 | suspension rear | P-021 | 2
3 | threaded axle rear left | P-024 | 1
4 | threaded axle rear right | P-023 | 1

5 | muffle rear wheels | P-022 | 2

STOCK VENDOR INFO:
UNLESS OTHERWISE SPECIFIED:
DIMENSIONS ARE IN INCHES
ANGLES ARE IN DEGREES
3rd Angle Projection
TOLERANCES:
THREE PLACE DECIMAL 0.005"

Careless Broncos
See BOM
Rear Axle Assembly
REV #: A
SIZE B

SOLIDWORKS Educational Product. For Instructional Use Only.
