flasch97/Mech-2220-Project-Gravity-Car/Gravity Car/Drawing PDF files/A4 Ramp.PDF

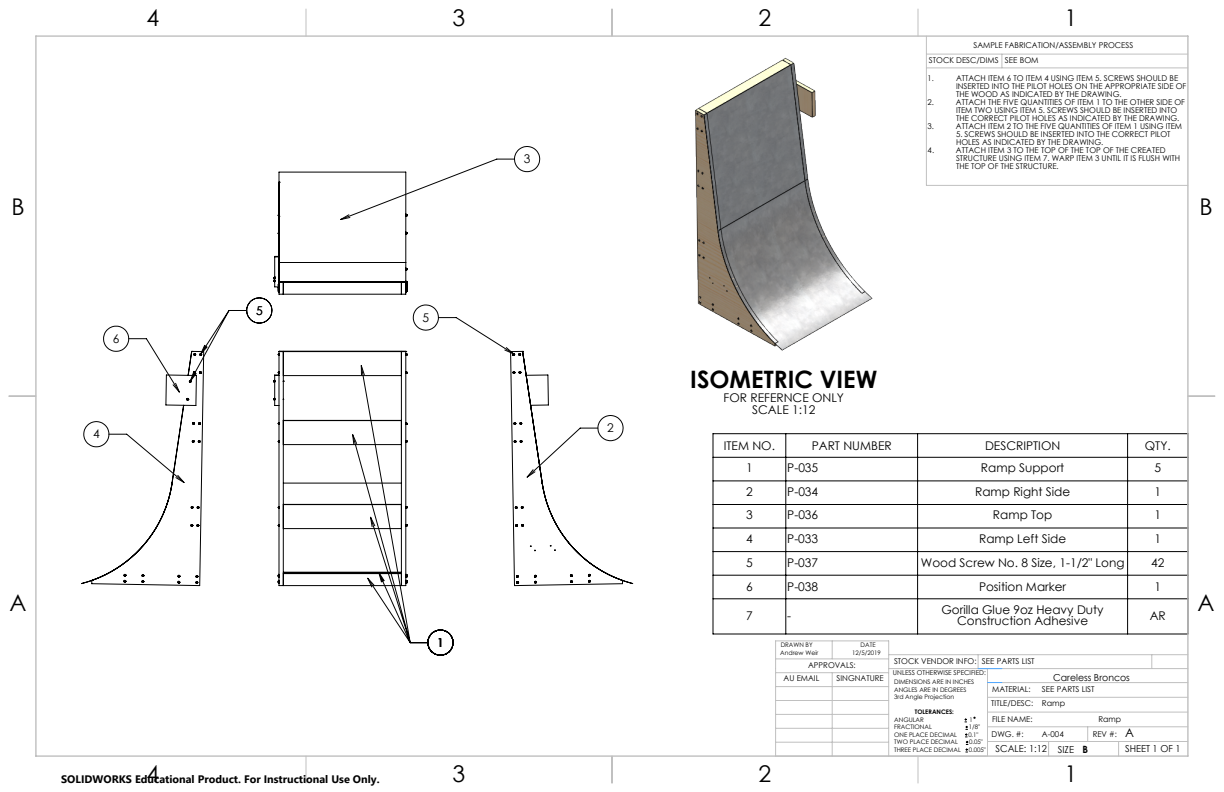
[picture p110: page 1]
Andrew Weir; FILE NAME:; DRAWN BY; DATE; AU EMAIL; SINGNATURE

SAMPLE FABRICATION/ASSEMBLY PROCESS

STOCK DESC/DIMS | SEE BOM

1. ATTACH ITEM 6 TO ITEM 4 USING ITEM 5. SCREWS SHOULD BE
INSERTED INTO THE PILOT HOLES ON THE APPROPRIATE SIDE OF
THE WOOD AS INDICATED BY THE DRAWING.
2. ATTACH THE FIVE QUANTITIES OF ITEM 1 TO THE OTHER SIDE OF
ITEM TWO USING ITEM 5. SCREWS SHOULD BE INSERTED INTO
THE CORRECT PILOT HOLES AS INDICATED BY THE DRAWING.
3. ATTACH ITEM 2 TO THE FIVE QUANTITIES OF ITEM 1 USING ITEM
5. SCREWS SHOULD BE INSERTED INTO THE CORRECT PILOT
HOLES AS INDICATED BY THE DRAWING.
4. ATTACH ITEM 3 TO THE TOP OF THE TOP OF THE CREATED
STRUCTURE USING ITEM 7. WARP ITEM 3 UNTIL IT IS FLUSH WITH
THE TOP OF THE STRUCTURE.

ISOMETRIC VIEW
FOR REFERNCE ONLY
SCALE 1:12

ITEM NO. | PART NUMBER | DESCRIPTION | QTY.
1 | P-035 | Ramp Support | 5
2 | P-034 | Ramp Right Side | 1
3 | P-036 | Ramp Top | 1
4 | P-033 | Ramp Left Side | 1
5 | P-037 | Wood Screw No. 8 Size, 1-1/2" Long | 42
6 | P-038 | Position Marker | 1
7 | - | Gorilla Glue 9oz Heavy Duty Construction Adhesive

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

DIMENSIONS ARE IN INCHES

SEE PARTS LIST
Ramp

DWG. #: A-004 | REV #: A
SCALE: 1:12 | SIZE B | SHEET 1 OF 1

SOLIDWORKS Educational Product. For Instructional Use Only.
