flasch97/Mech-2220-Project-Gravity-Car/Gravity Car/Drawing PDF files/A6 Assemsight.PDF

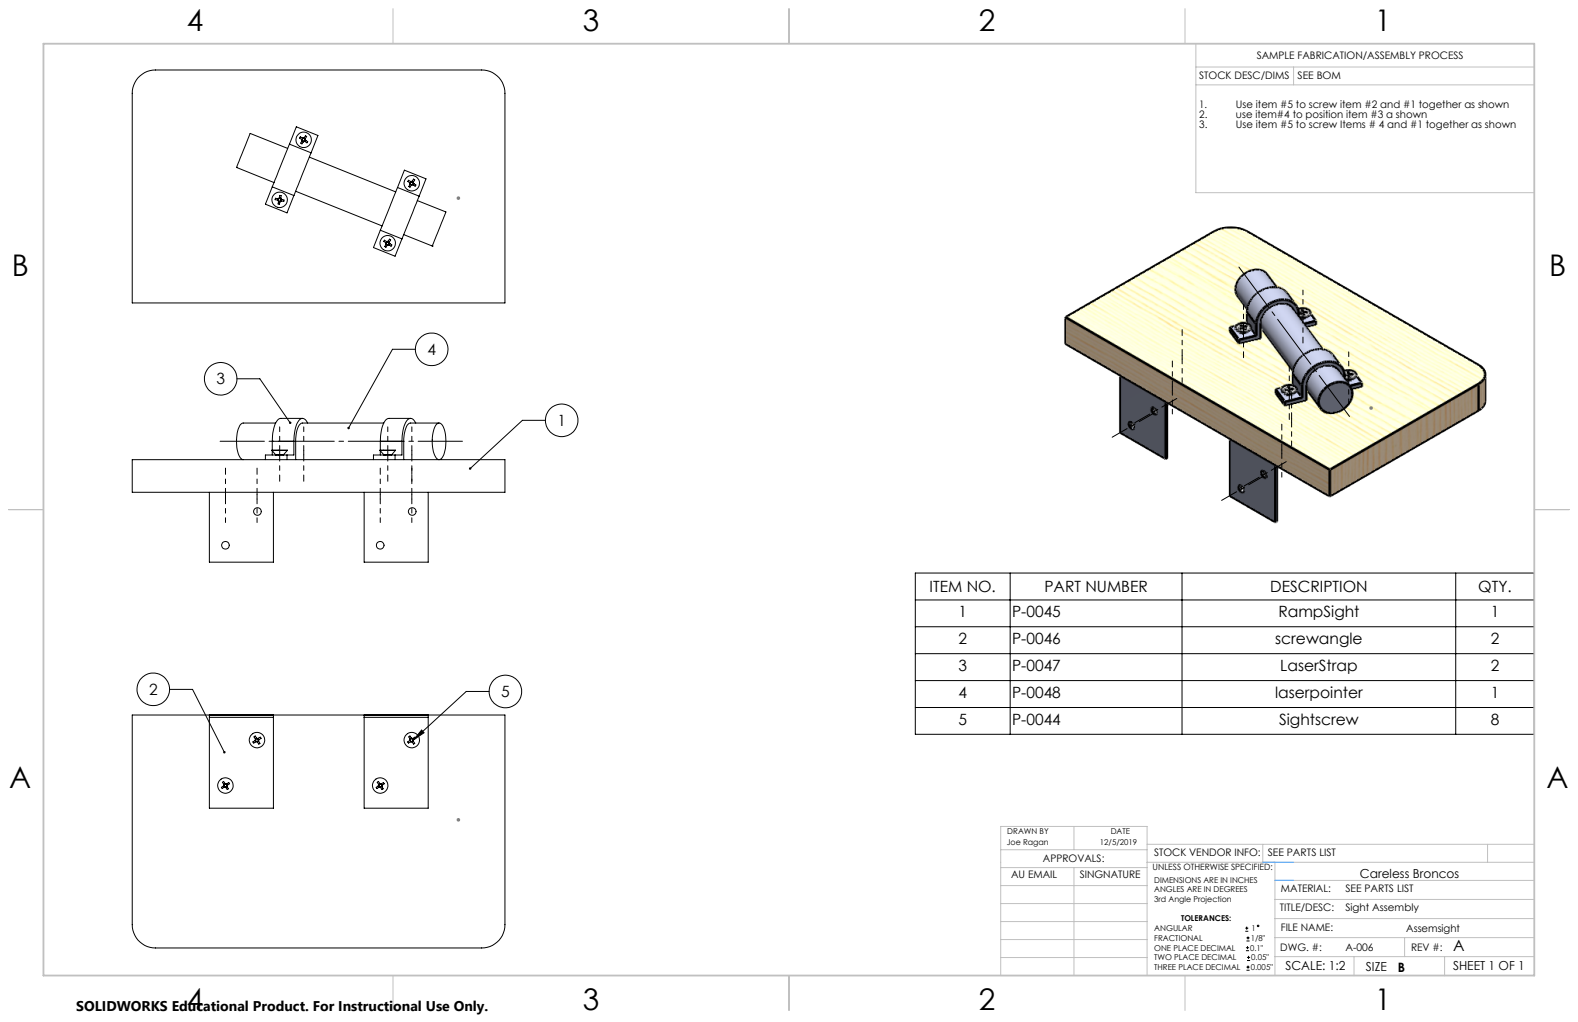
[picture p112: page 1]
Joe Ragan; FILE NAME:; DRAWN BY; DATE; AU EMAIL; SINGNATURE

SAMPLE FABRICATION/ASSEMBLY PROCESS

STOCK DESC/DIMS | SEE BOM

1. Use item #5 to screw item #2 and #1 together as shown
2. use item#4 to position item #3 a shown
3. Use item #5 to screw Items # 4 and #1 together as shown

ITEM NO. | PART NUMBER | DESCRIPTION | QTY.
1 | P-0045 | RampSight | 1
2 | P-0046 | screwangle | 2
3 | P-0047 | LaserStrap | 2
4 | P-0048 | laserpointer | 1
5 | P-0044 | Sightscrew | 8

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

DIMENSIONS ARE IN INCHES

SEE PARTS LIST
Sight Assembly

DWG. #: A-006 | REV #: A
SCALE: 1:2 | SIZE B | SHEET 1 OF 1

SOLIDWORKS Educational Product. For Instructional Use Only.
