flasch97/Mech-2220-Project-Gravity-Car/Gravity Car/Drawing PDF files/P18 One-Way-Bearing.PDF

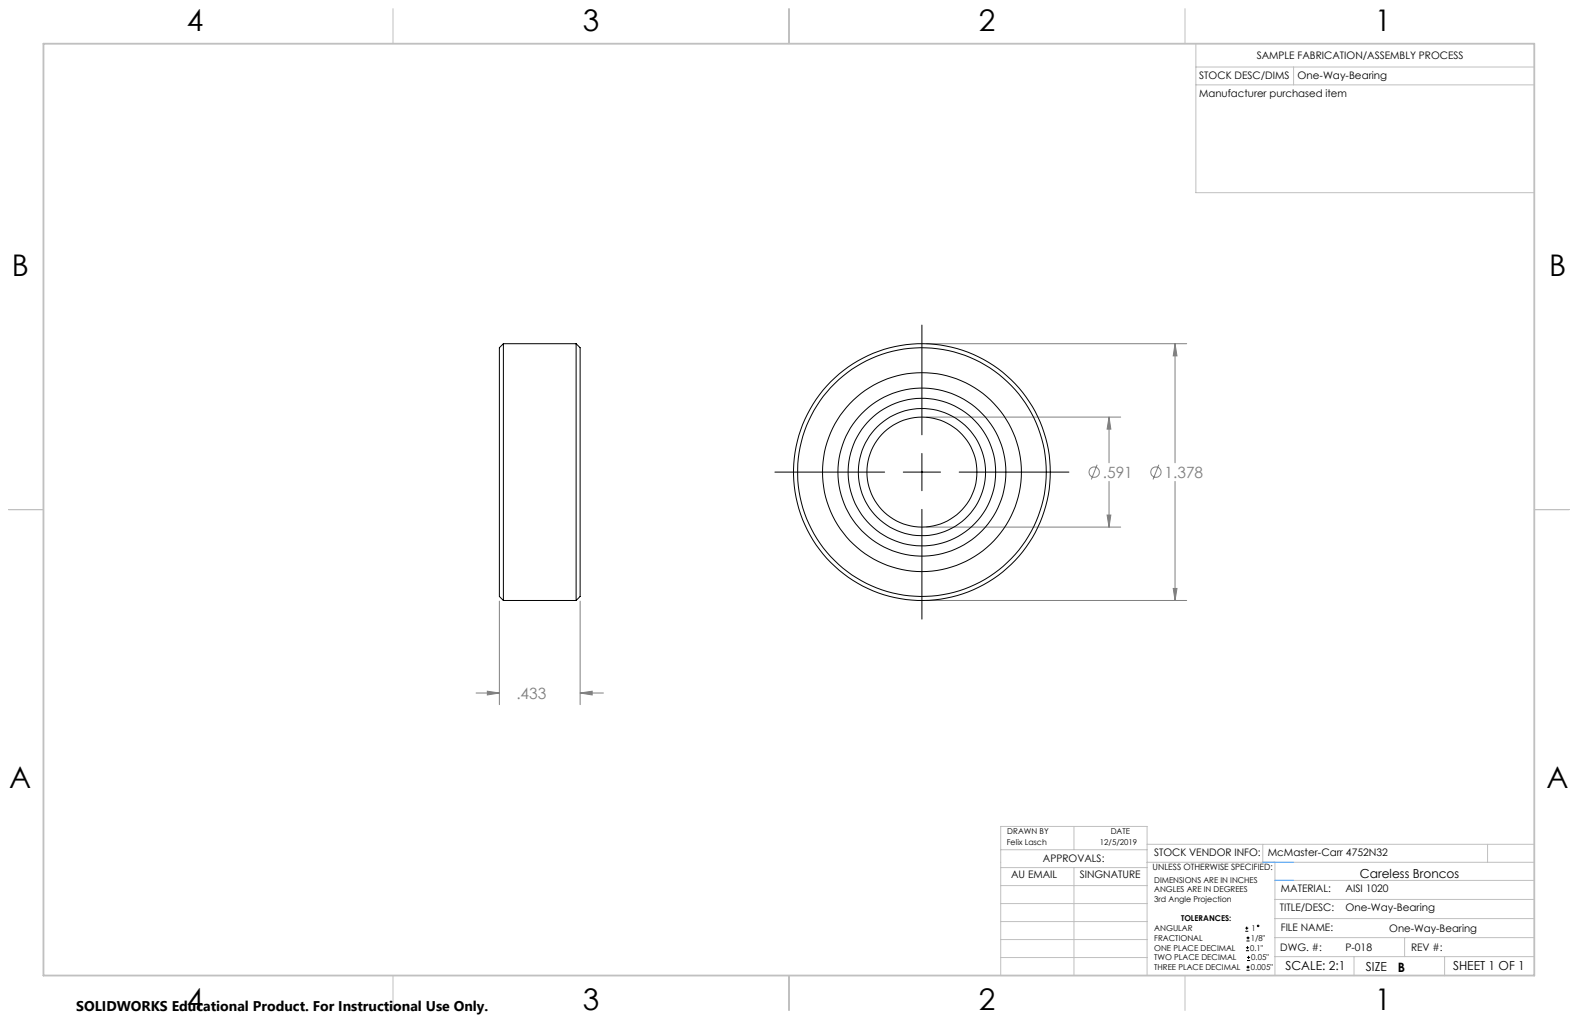
[picture p123: page 1]
Felix Lasch; FILE NAME:; DRAWN BY; DATE; AU EMAIL; SINGNATURE

SAMPLE FABRICATION/ASSEMBLY PROCESS

STOCK DESC/DIMS | One-Way-Bearing

Manufacturer purchased item

STOCK VENDOR INFO: | McMaster-Carr 4752N32
UNLESS OTHERWISE SPECIFIED: ANGLES ARE IN DEGREES 3rd Angle Projection TOLERANCES: ANGULAR 1 FRACTIONAL 1/8" ONE PLACE DECIMAL 0.1" TWO PLACE DECIMAL 0.05" THREE PLACE DECIMAL 0.005" | | Careless Broncos

DIMENSIONS ARE IN INCHES

AISI 1020
One-Way-Bearing

DWG. #: P-018 | REV #:
SCALE: 2:1 | SIZE B | SHEET 1 OF 1

SOLIDWORKS Educational Product. For Instructional Use Only.
