flasch97/Mech-2220-Project-Gravity-Car/Gravity Car/Drawing PDF files/P20 - 24 Rear Axle Drawings Compiled.pdf

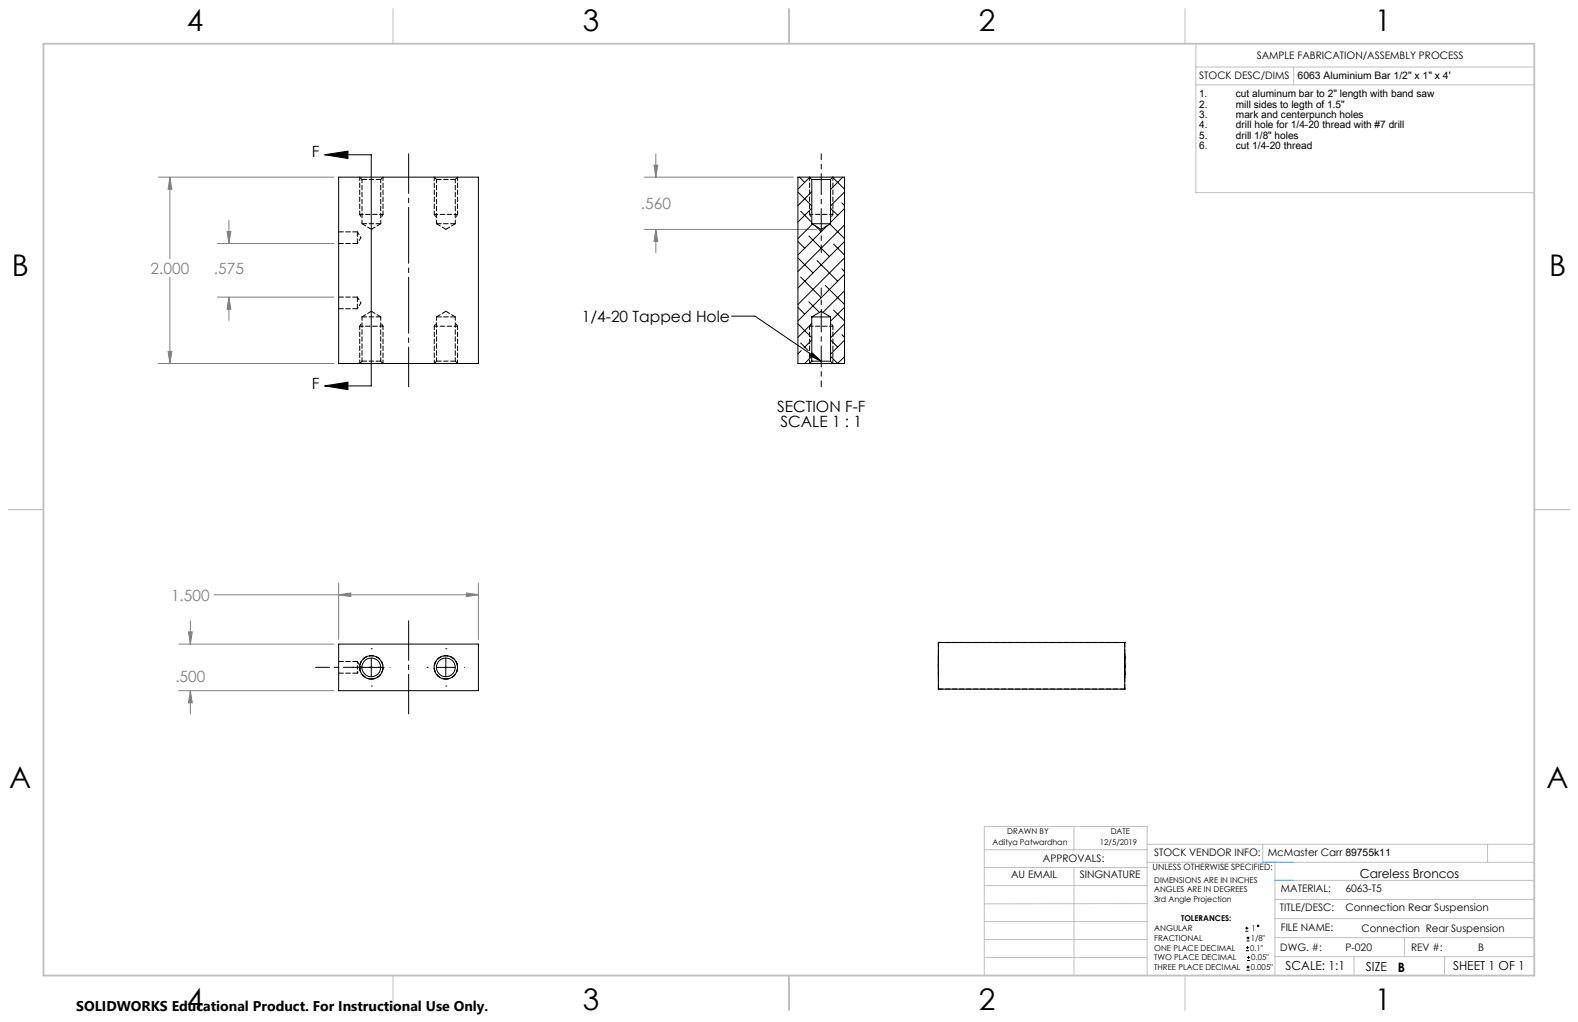
[picture p124: page 1]
1/4-20 Tapped Hole; SECTION F-F SCALE 1 : 1; Aditya Patwardhan; FILE NAME:; DRAWN BY; DATE; AU EMAIL; SINGNATURE

SAMPLE FABRICATION/ASSEMBLY PROCESS

STOCK DESC/DIMS | 6063 Aluminium Bar 1/2" x 1" x 4'

1. cut aluminum bar to 2" length with band saw
2. mill sides to legth of 1.5"
3. mark and centerpunch holes
4. drill hole for 1/4-20 thread with #7 drill
5. drill 1/8" holes
6. cut 1/4-20 thread

STOCK VENDOR INFO: | McMaster Carr 89755k11
UNLESS OTHERWISE SPECIFIED: ANGLES ARE IN DEGREES 3rd Angle Projection TOLERANCES: ANGULAR 1 FRACTIONAL 1/8" ONE PLACE DECIMAL 0.1" TWO PLACE DECIMAL 0.05" THREE PLACE DECIMAL 0.005" | | Careless Broncos

DIMENSIONS ARE IN INCHES

Connection Rear Suspension

DWG. #: P-020 | REV #: B
SCALE: 1:1 | SIZE B | SHEET 1 OF 1

SOLIDWORKS Educational Product. For Instructional Use Only.

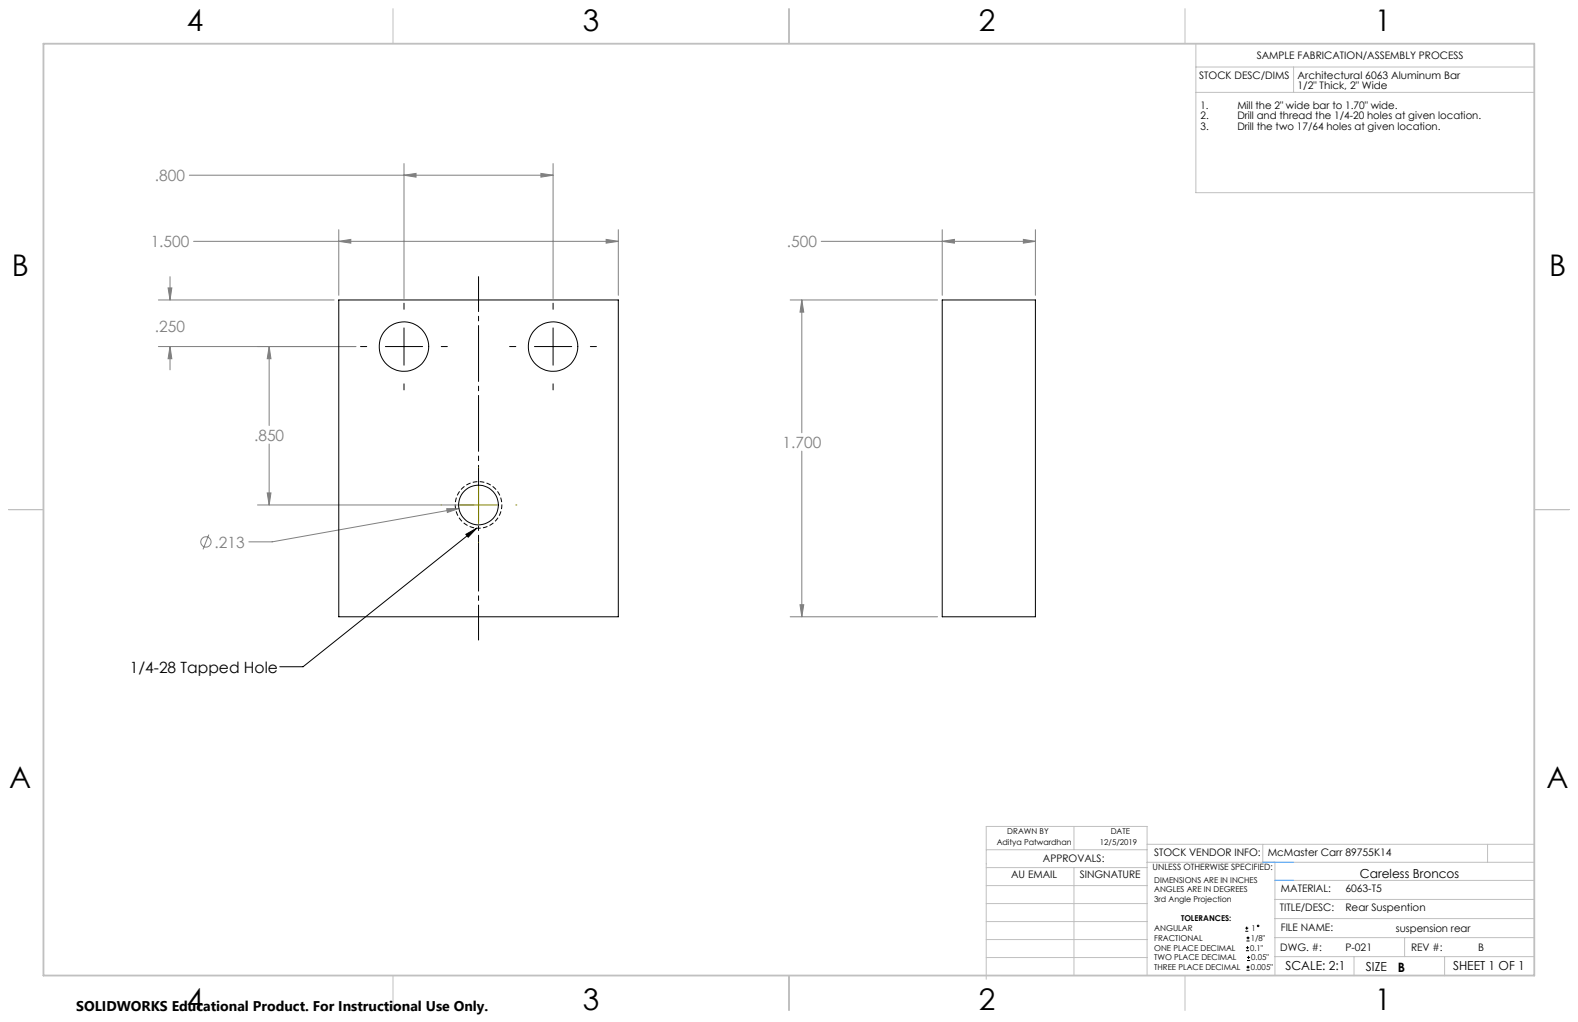
[picture p125: page 2]
1/4-28 Tapped Hole; Rear Suspention; Aditya Patwardhan; FILE NAME:; DRAWN BY; DATE; suspension rear; AU EMAIL; SINGNATURE

Architectural 6063 Aluminum Bar
1/2" Thick, 2" Wide

1. Mill the 2" wide bar to 1.70" wide.
2. Drill and thread the 1/4-20 holes at given location.
3. Drill the two 17/64 holes at given location.

STOCK VENDOR INFO: | McMaster Carr 89755K14
UNLESS OTHERWISE SPECIFIED: ANGLES ARE IN DEGREES 3rd Angle Projection TOLERANCES: ANGULAR 1 | | Careless Broncos

DIMENSIONS ARE IN INCHES

SCALE: 2:1 | | SHEET 1 OF 1

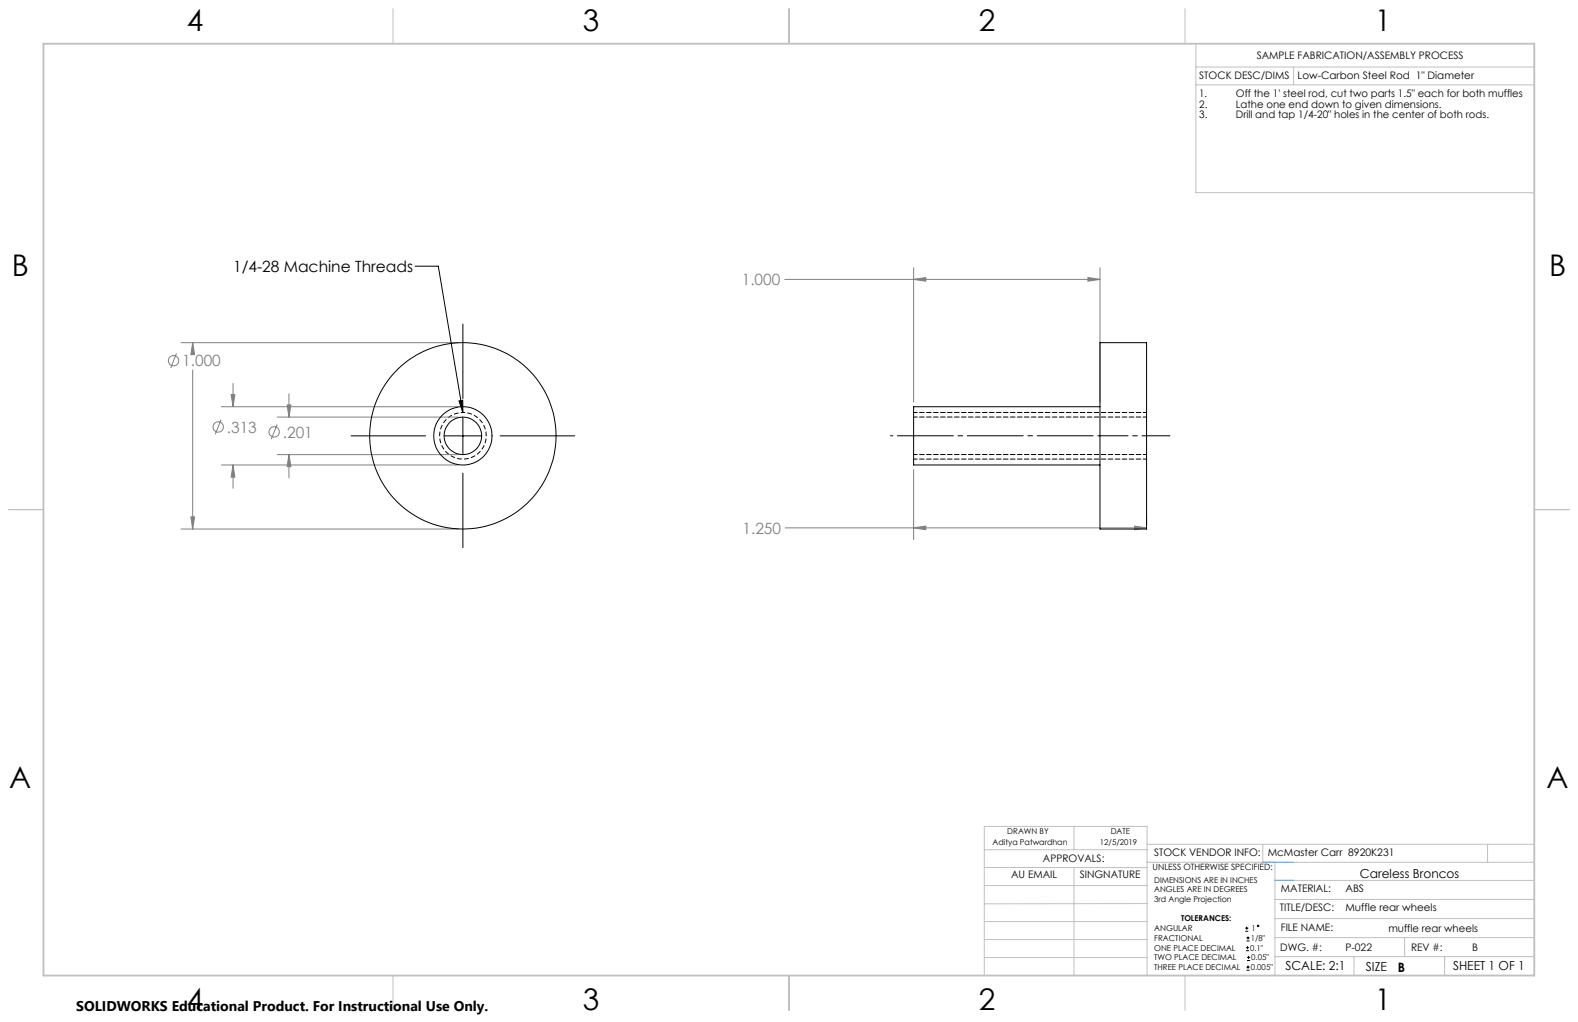
[picture p126: page 3]
1/4-28 Machine Threads; Aditya Patwardhan; FILE NAME:; DRAWN BY; DATE; AU EMAIL; SINGNATURE

Low-Carbon Steel Rod 1" Diameter

1. Off the 1' steel rod, cut two parts 1.5" each for both muffles
2. Lathe one end down to given dimensions.
3. Drill and tap 1/4-20" holes in the center of both rods.

STOCK VENDOR INFO: | McMaster Carr 8920K231
UNLESS OTHERWISE SPECIFIED: ANGLES ARE IN DEGREES 3rd Angle Projection TOLERANCES: ANGULAR 1 | | Careless Broncos

DIMENSIONS ARE IN INCHES

ABS
Muffle rear wheels

muffle rear wheels

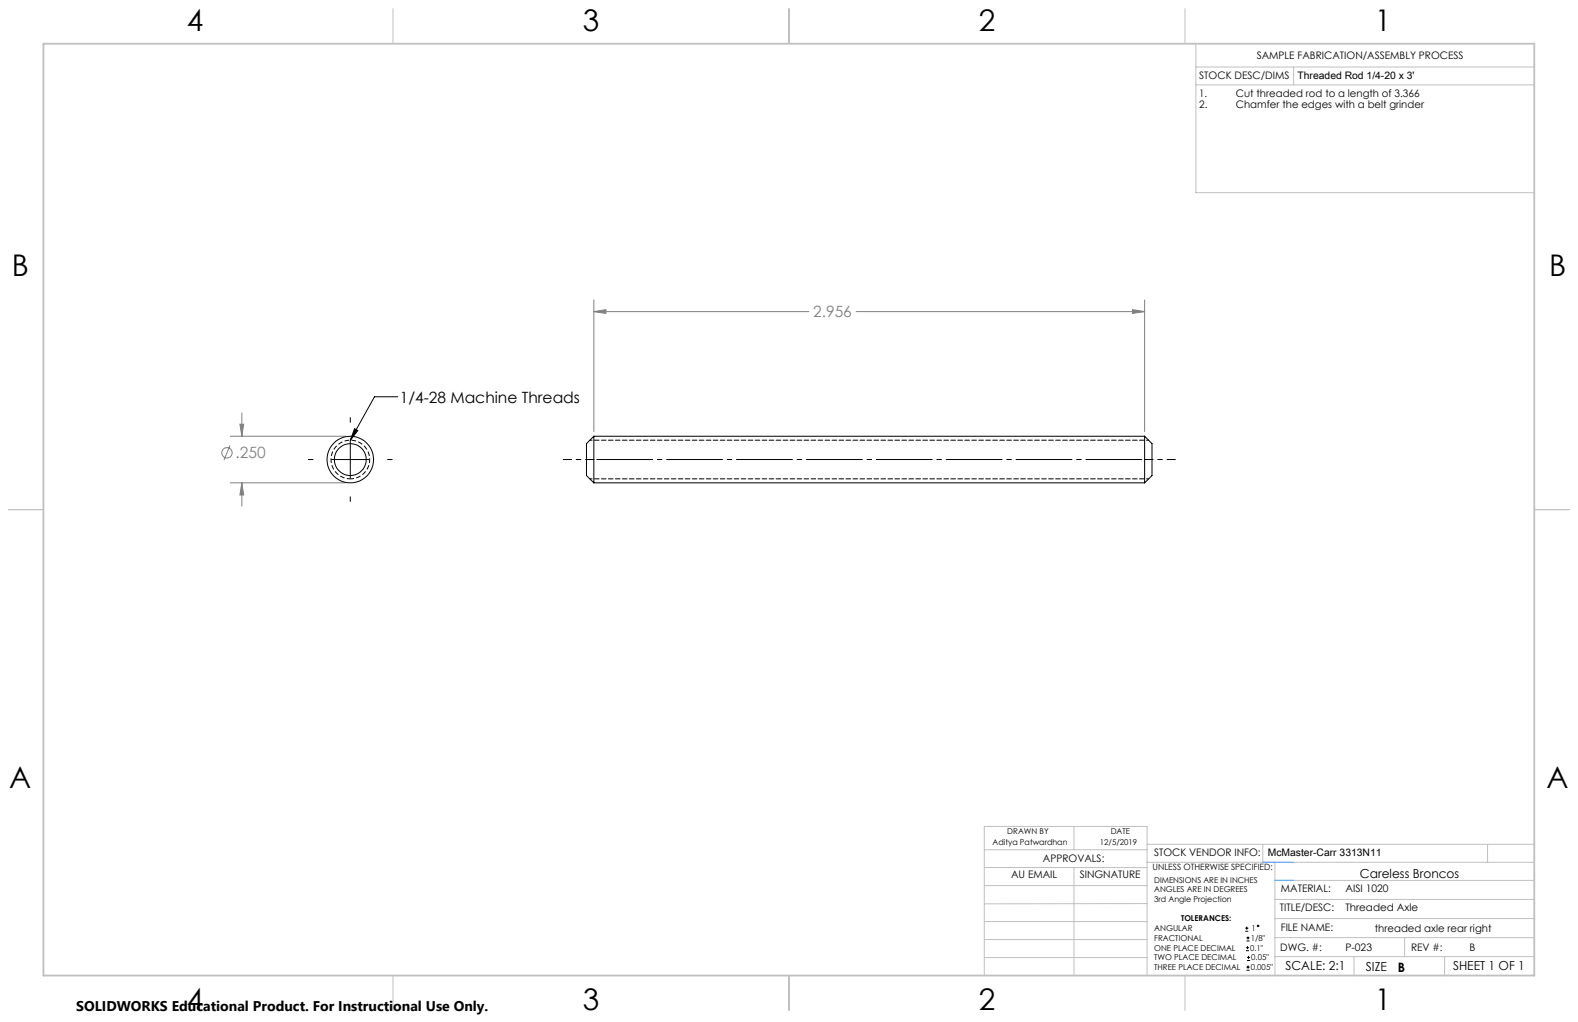
[picture p127: page 4]
1/4-28 Machine Threads; Threaded Rod 1/4-20 x 3'; Aditya Patwardhan; FILE NAME:; DRAWN BY; DATE; AU EMAIL; SINGNATURE

1. Cut threaded rod to a length of 3.366
2. Chamfer the edges with a belt grinder

STOCK VENDOR INFO: | McMaster-Carr 3313N11
UNLESS OTHERWISE SPECIFIED: ANGLES ARE IN DEGREES 3rd Angle Projection TOLERANCES: ANGULAR 1 | | Careless Broncos

DIMENSIONS ARE IN INCHES

AISI 1020
Threaded Axle
threaded axle rear right

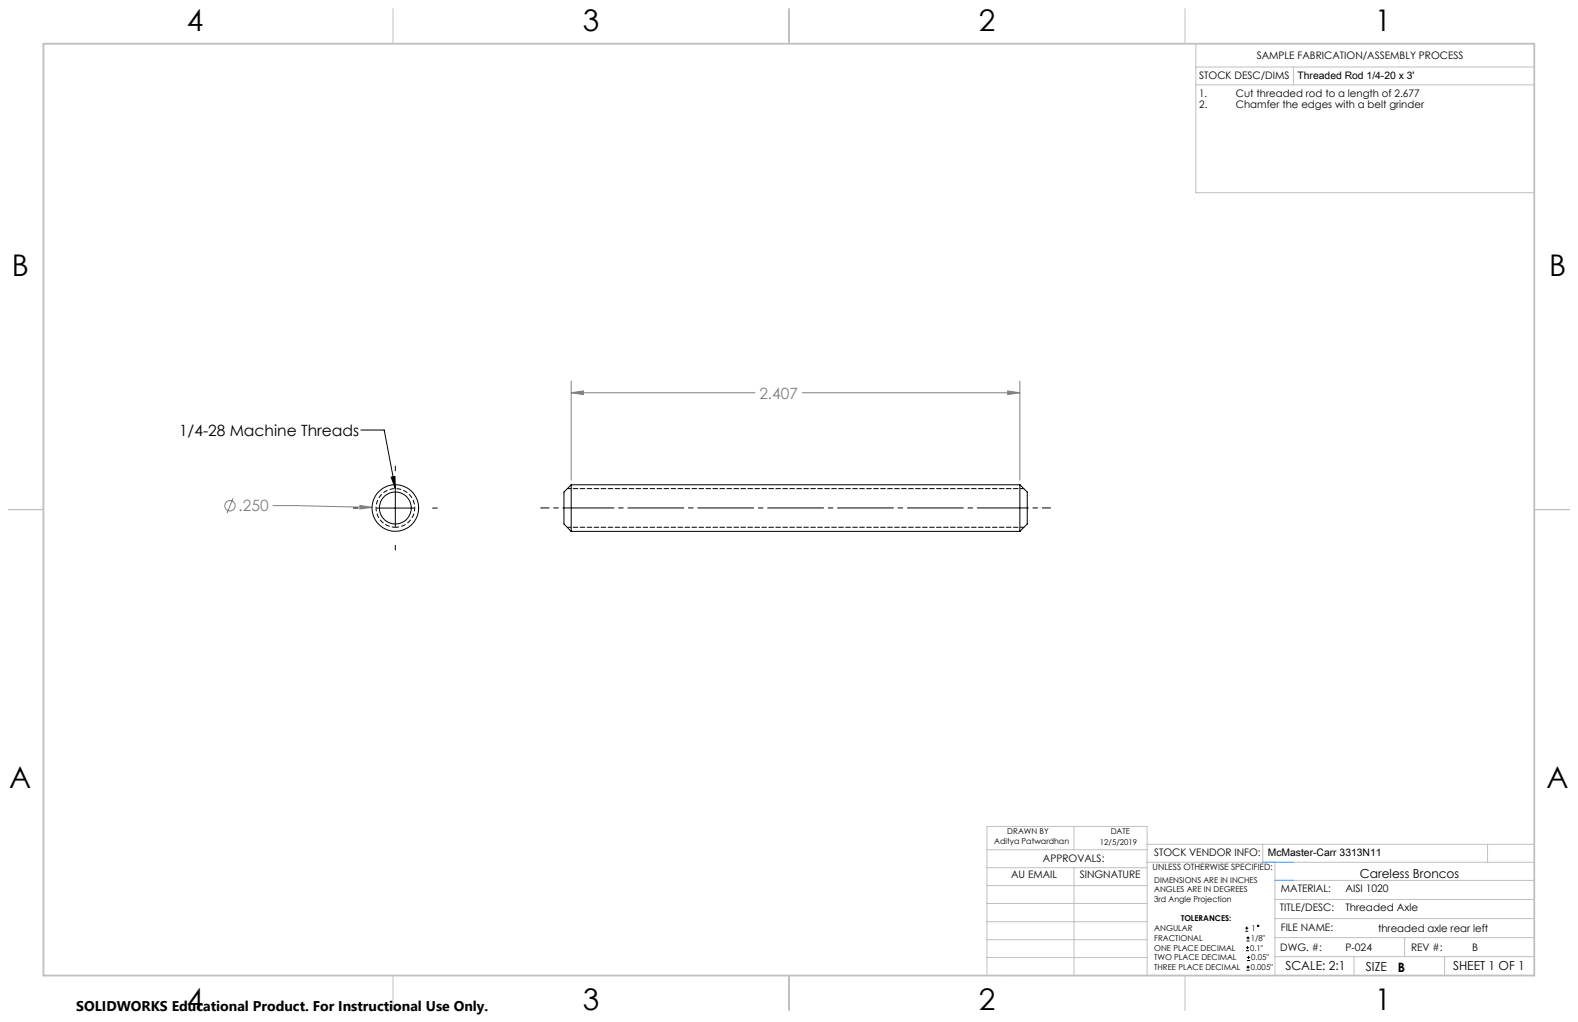
[picture p128: page 5]
1/4-28 Machine Threads; Threaded Rod 1/4-20 x 3'; FILE NAME:; DRAWN BY; DATE; AU EMAIL; SINGNATURE; Aditya Patwardhan

1. Cut threaded rod to a length of 2.677
2. Chamfer the edges with a belt grinder

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

DIMENSIONS ARE IN INCHES

AISI 1020
Threaded Axle
threaded axle rear left
