flasch97/Mech-2220-Project-Gravity-Car/Gravity Car/Drawing PDF files/P24 threaded axle rear left.PDF

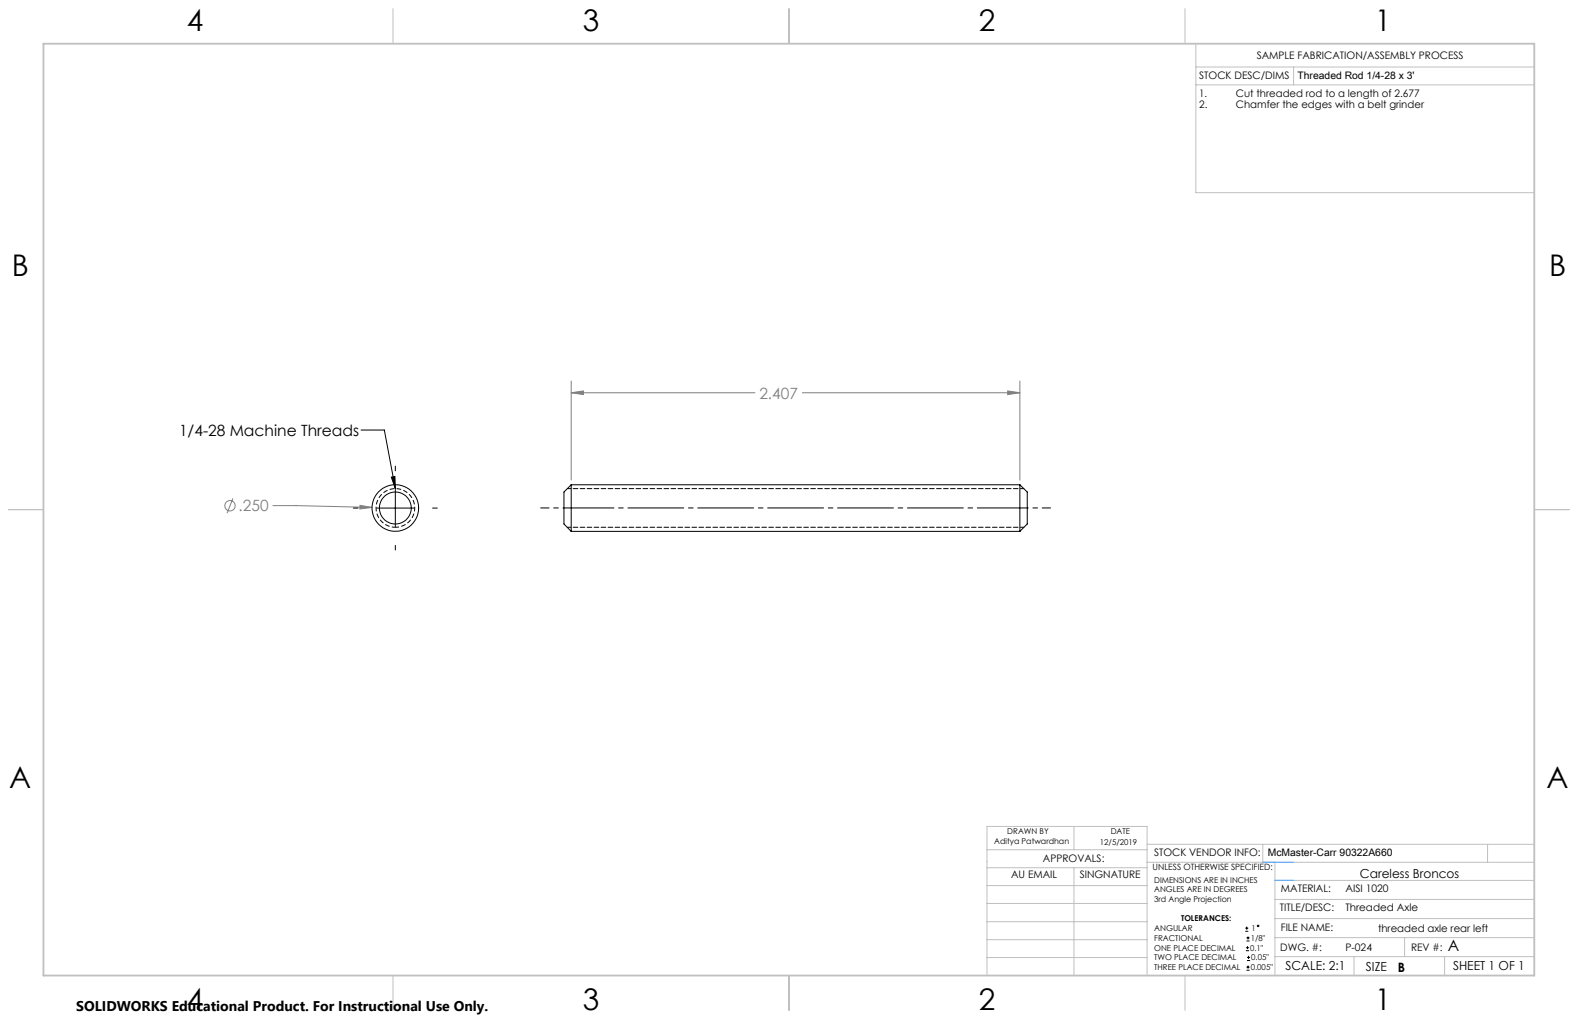
[picture p129: page 1]
1/4-28 Machine Threads; FILE NAME:; DRAWN BY; DATE; AU EMAIL; SINGNATURE; Aditya Patwardhan

SAMPLE FABRICATION/ASSEMBLY PROCESS

STOCK DESC/DIMS | Threaded Rod 1/4-28 x 3'

1. Cut threaded rod to a length of 2.677
2. Chamfer the edges with a belt grinder

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

DIMENSIONS ARE IN INCHES

AISI 1020
Threaded Axle
threaded axle rear left

DWG. #: P-024 | A REV #:
SCALE: 2:1 | SIZE B | SHEET 1 OF 1

SOLIDWORKS Educational Product. For Instructional Use Only.
