flasch97/Mech-2220-Project-Gravity-Car/Gravity Car/Drawing PDF files/P26 Clevis Pin.PDF

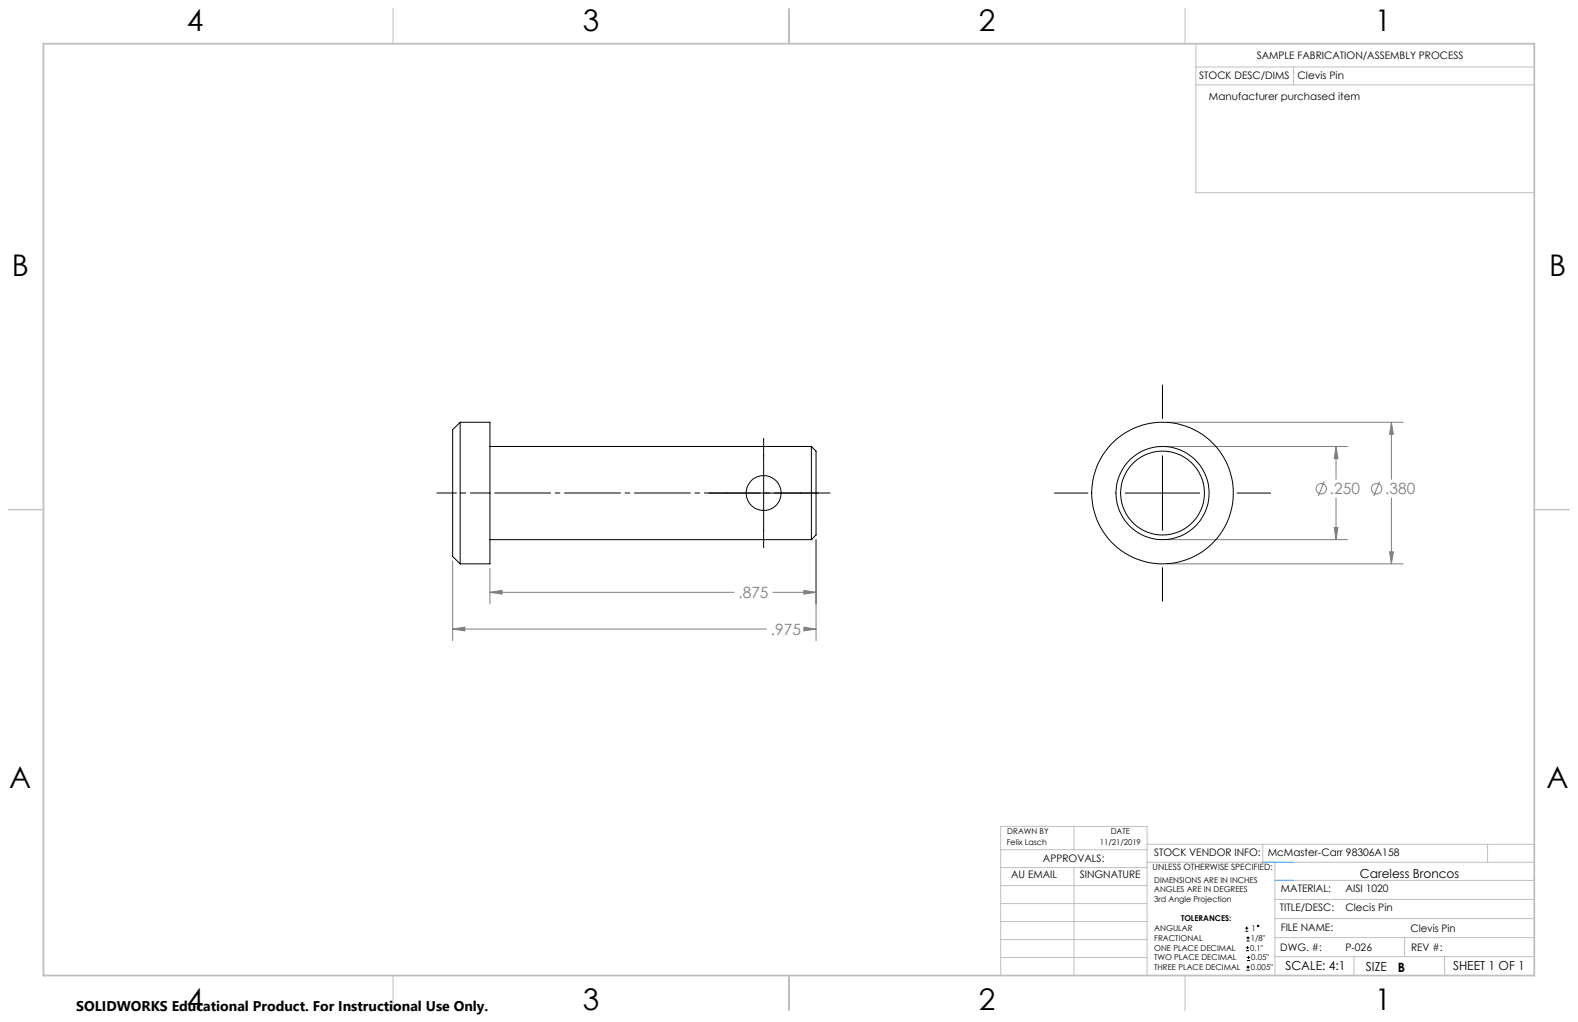
[picture p130: page 1]
Clecis Pin; AISI 1020; Felix Lasch; FILE NAME:; DRAWN BY; DATE; Clevis Pin; AU EMAIL; SINGNATURE

SAMPLE FABRICATION/ASSEMBLY PROCESS

STOCK DESC/DIMS | Clevis Pin

Manufacturer purchased item

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

DIMENSIONS ARE IN INCHES

DWG. #: P-026 | REV #:
SCALE: 4:1 | SIZE B | SHEET 1 OF 1

SOLIDWORKS Educational Product. For Instructional Use Only.
