flasch97/Mech-2220-Project-Gravity-Car/Gravity Car/Drawing PDF files/P31 micrometer.PDF

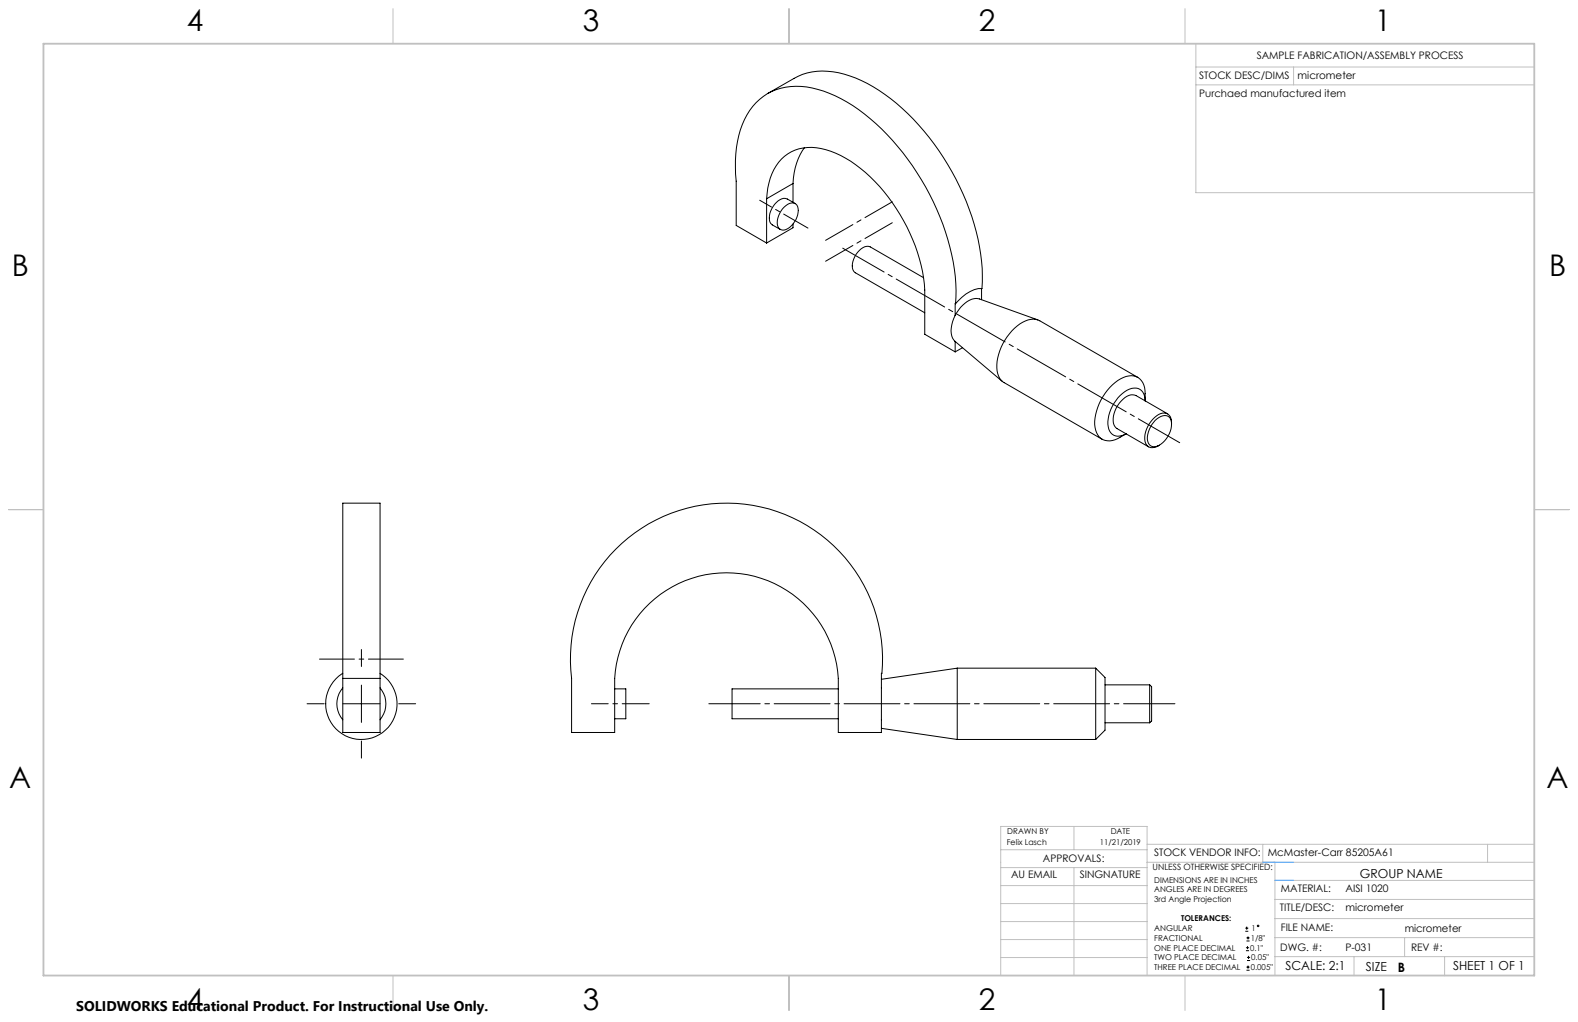
[picture p132: page 1]
AISI 1020; Felix Lasch; FILE NAME:; DRAWN BY; DATE; AU EMAIL; SINGNATURE

SAMPLE FABRICATION/ASSEMBLY PROCESS

STOCK DESC/DIMS | micrometer

Purchaed manufactured item

STOCK VENDOR INFO: | McMaster-Carr 85205A61
UNLESS OTHERWISE SPECIFIED: ANGLES ARE IN DEGREES 3rd Angle Projection TOLERANCES: ANGULAR 1 FRACTIONAL 1/8" ONE PLACE DECIMAL 0.1" TWO PLACE DECIMAL 0.05" THREE PLACE DECIMAL 0.005" | | GROUP NAME

DIMENSIONS ARE IN INCHES

DWG. #: P-031 | REV #:
SCALE: 2:1 | SIZE B | SHEET 1 OF 1

SOLIDWORKS Educational Product. For Instructional Use Only.
