flasch97/Mech-2220-Project-Gravity-Car/Gravity Car/Drawing PDF files/P36 ramp top.PDF

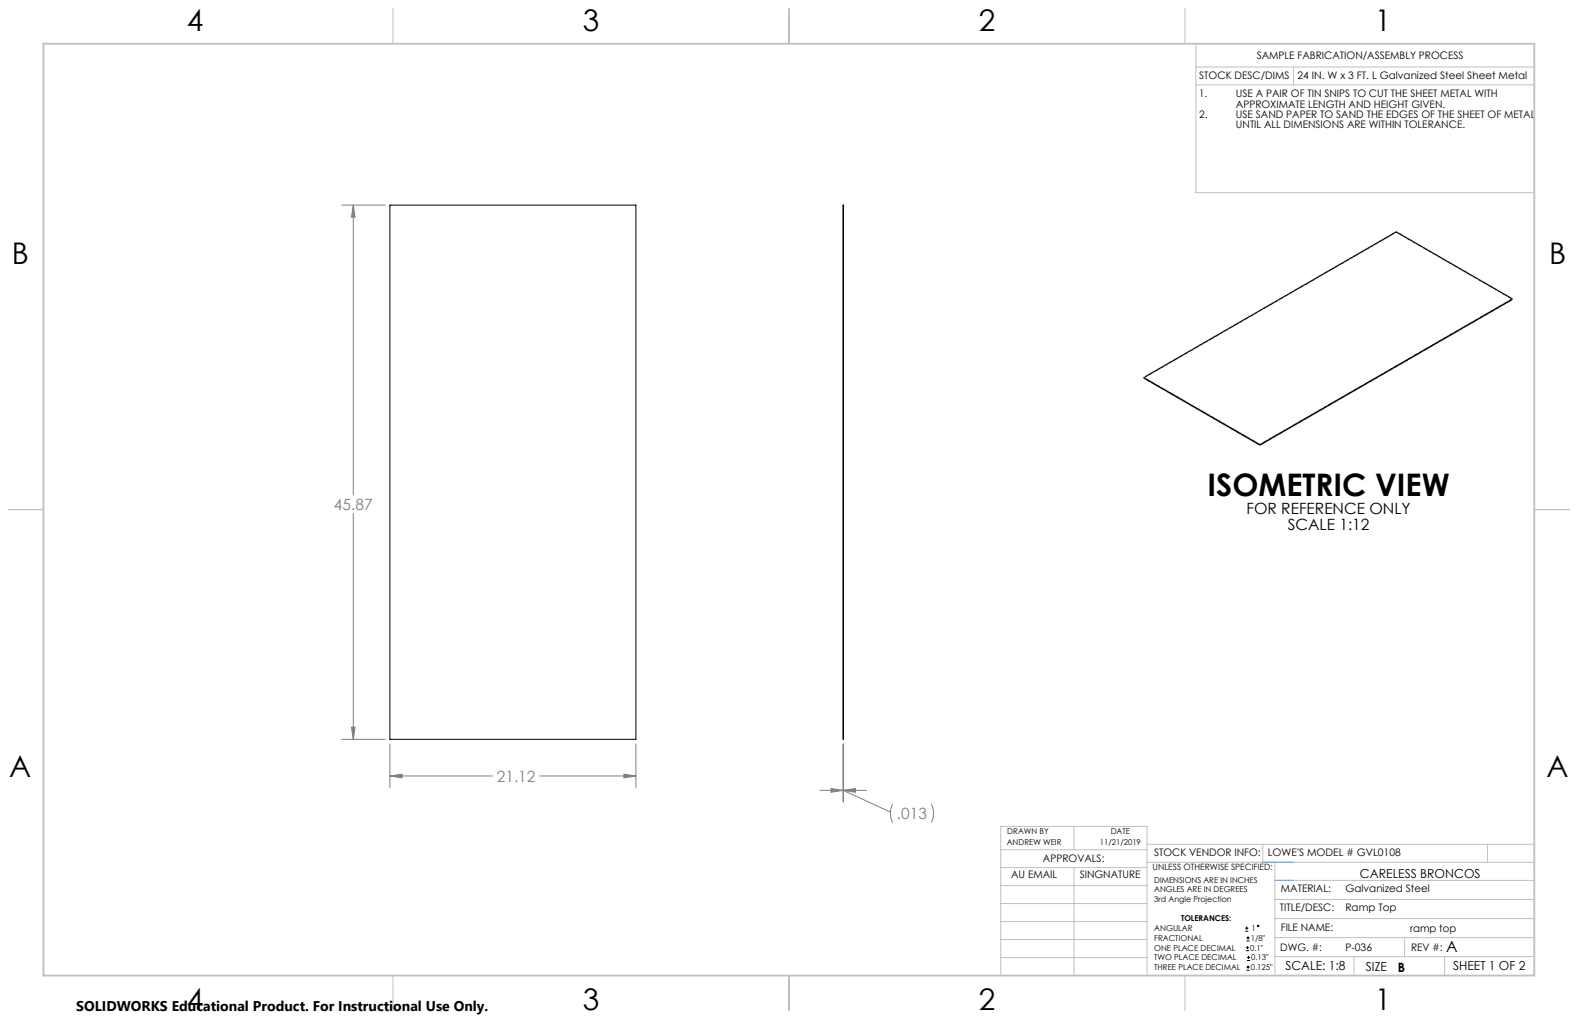
[picture p133: page 1]
Ramp Top; Galvanized Steel; ANDREW WEIR; FILE NAME:; DRAWN BY; DATE; ramp top; AU EMAIL; SINGNATURE

SAMPLE FABRICATION/ASSEMBLY PROCESS

STOCK DESC/DIMS | 24 IN. W x 3 FT. L Galvanized Steel Sheet Metal

1. USE A PAIR OF TIN SNIPS TO CUT THE SHEET METAL WITH
APPROXIMATE LENGTH AND HEIGHT GIVEN.
2. USE SAND PAPER TO SAND THE EDGES OF THE SHEET OF METAL
UNTIL ALL DIMENSIONS ARE WITHIN TOLERANCE.

ISOMETRIC VIEW
FOR REFERENCE ONLY
SCALE 1:12

STOCK VENDOR INFO: | LOWE'S MODEL # GVL0108
UNLESS OTHERWISE SPECIFIED: ANGLES ARE IN DEGREES 3rd Angle Projection TOLERANCES: ANGULAR 1 FRACTIONAL 1/8" ONE PLACE DECIMAL 0.1" TWO PLACE DECIMAL 0.13" THREE PLACE DECIMAL 0.125" | | CARELESS BRONCOS

DIMENSIONS ARE IN INCHES

DWG. #: P-036 | A REV #:
SCALE: 1:8 | SIZE B | SHEET 1 OF 2

SOLIDWORKS Educational Product. For Instructional Use Only.

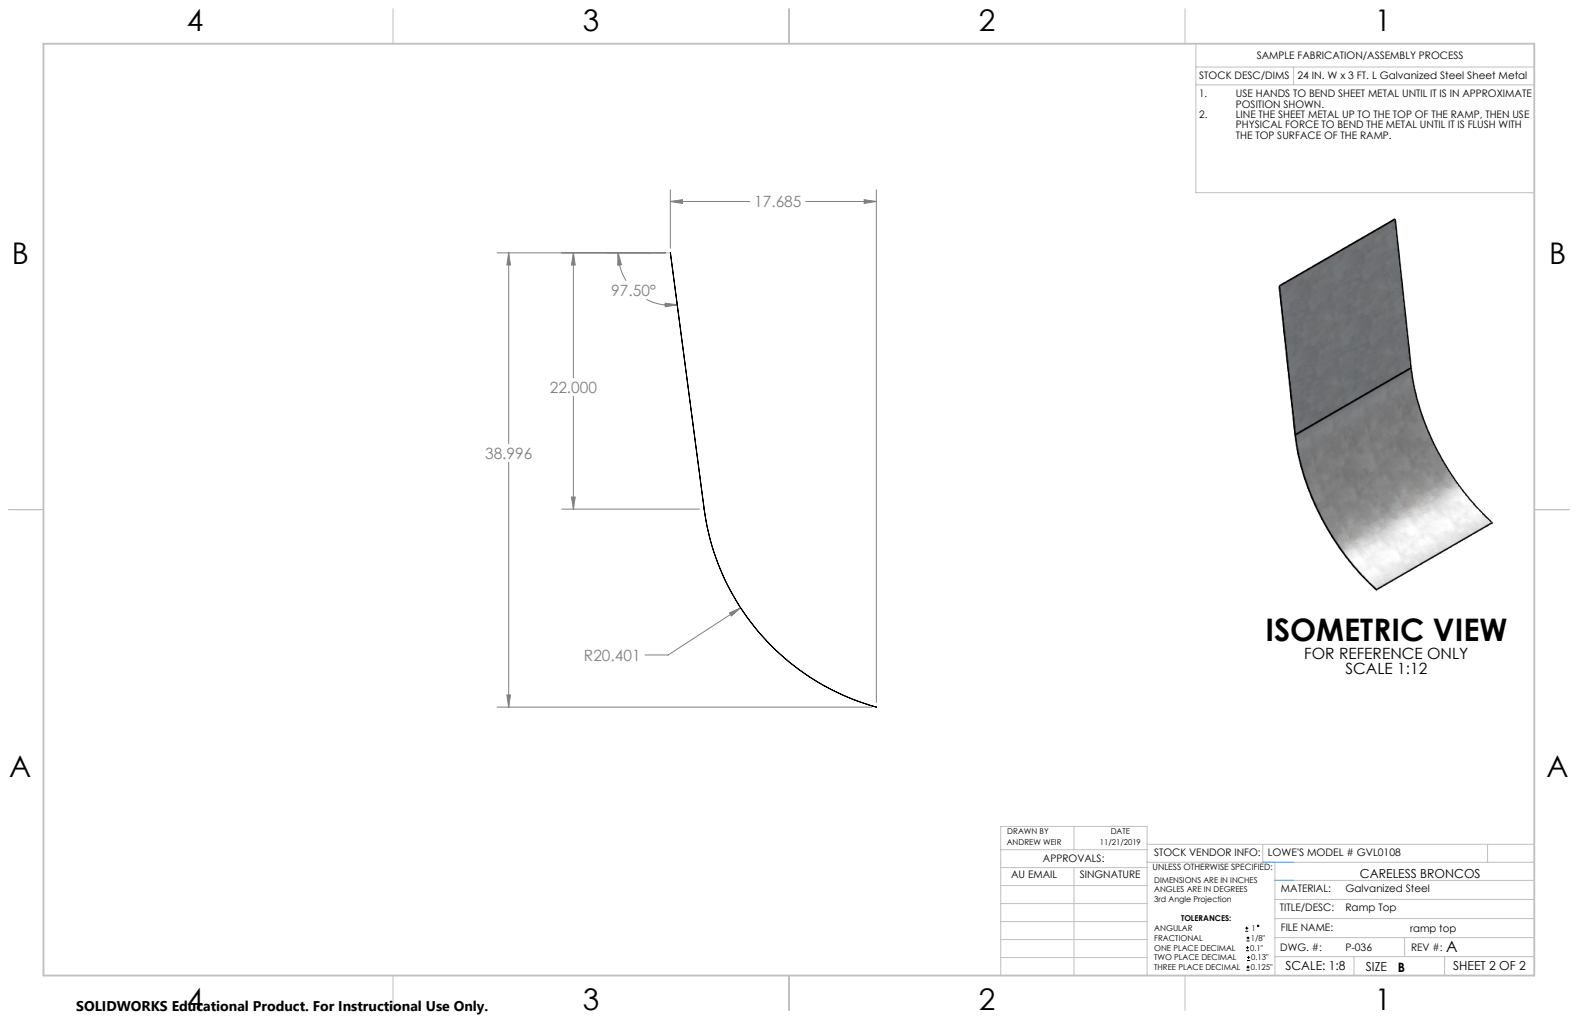
[picture p134: page 2]
Ramp Top; Galvanized Steel; ANDREW WEIR; FILE NAME:; DRAWN BY; DATE; ramp top; AU EMAIL; SINGNATURE

SAMPLE FABRICATION/ASSEMBLY PROCESS

STOCK DESC/DIMS | 24 IN. W x 3 FT. L Galvanized Steel Sheet Metal

1. USE HANDS TO BEND SHEET METAL UNTIL IT IS IN APPROXIMATE
POSITION SHOWN.
2. LINE THE SHEET METAL UP TO THE TOP OF THE RAMP, THEN USE
PHYSICAL FORCE TO BEND THE METAL UNTIL IT IS FLUSH WITH
THE TOP SURFACE OF THE RAMP.

ISOMETRIC VIEW
FOR REFERENCE ONLY
SCALE 1:12

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

DIMENSIONS ARE IN INCHES

DWG. #: P-036 | A REV #:
SCALE: 1:8 | SIZE B | SHEET 2 OF 2

SOLIDWORKS Educational Product. For Instructional Use Only.
